basvandorst/cryptography-archive/brown-steg-stools-2/README.TXT

Extracting the S-Tools archive
------------------------------
S-Tools version 2.00 is supplied in the archive file S-TOOLS.ZIP. The file
S-TOOLS.SIG is a PGP signature of this file that you can use to check its
integrity if you so wish. To do this requires my public key which you can
get by either contacting me personally or fingering <asb@cs.nott.ac.uk>

As an added bonus, creating an uncompressed zip and then compressing it as
one file allows PKZIP to take advantage of redundancies in all the archive
files and hence you get a smaller overall distribution zip size.

Everyone wins :-)

Regards,

+---------------------------+----------------------------------------------+
| Andy <asb@cs.nott.ac.uk>  | PGP key fingerprint: EC 80 9C 96 54 63 CC 97 |
|    finger for PGP key     |                    : FF 7D C5 69 0B 55 23 63 |
+---------------------------+----------------------------------------------+
