basvandorst/cryptography-archive/escrow3/readme.txt

The TIS Software Key Esrow paper is distributed as a set of postscript
files.  The text of the paper is distribited as escrow?.ps.  The figures,
fig*.xi, are distributed as separate (xidraw) postscript files.

Contact ske@tis.com if you hae any trouble printing the text or figures.

Thanks.
