basvandorst/cryptography-archive/ipexamp/readme

This file, ipexamp.zip, contains three simple programs
to demonstrate socket programming:

-- telnntp, a simple "telnet"-like program which communicates
with a remote program via TCP.

-- readsock and sendsock, two simple programs which communicate
via UDP packets.

Mark Riordan  29 Dec 1993
