basvandorst/cryptography-archive/big_brother_inside_picts_info/big_brother_inside_picts_info.txt

From: Matt Thomlinson <phantom@u.washington.edu>
Date: Tue, 15 Feb 1994 17:20:14 -0800 (PST)

big_brother_inside_sticker.ps is a generic postscript file, created in
CorelDraw. The postscript image lies landscape on the page, and consists
of the intel-logo's ``swoosh'' and crayon-like lettering on the inside.

This design was originally created for the sticker project: the image was
screened onto transparent stickers 1" square for the purpose of applying
them to future clipper-chip products. (cdodhner@indirect.com was in charge
of that project; as far as I know he's still distributing them for a small
donation to cover printing & mailing costs).
