basvandorst/cryptography-archive/misc/wired-clipper-index.txt

From infobot-owner@wired.com Mon Feb 21 20:31:58 1994
Received: from gw.wired.com by scss3.cl.msu.edu (4.1/4.7)  id AA27175; Mon, 21 Feb 94 20:31:51 EST
Received: by gw.wired.com (5.67/wps.com-hackery)
	id AA23629; Mon, 21 Feb 94 17:31:50 -0800
Date: Mon, 21 Feb 94 17:31:50 -0800
Message-Id: <9402220131.AA23629@wired.com>
To: mrr@scss3.cl.msu.edu
From: infobot@wired.com
Subject: Majordomo file: file 'clipper.index'
Reply-To: infobot@wired.com
Status: OR

--

-=-=-=-=-=-=-=-=-=-=-=-=-=-=-=-=-=-=-=-=-=-=-=-=-=-=-=-=-=-=-=-=-=-=-=-=-=-
=-=-=-=-=-=-Copyright 1993,4 Wired USA Ltd.  All Rights Reserved=-=-=-=-=-=
-=-=For complete copyright information, please see the end of this file=-=-
=-=-=-=-=-=-=-=-=-=-=-=-=-=-=-=-=-=-=-=-=-=-=-=-=-=-=-=-=-=-=-=-=-=-=-=-=-=

WIRED Online
Clipper Archive
***************

Filename          Description                             Contributor
^^^^^^^^          ^^^^^^^^^^^                             ^^^^^^^^^^^
wired.letter       Letter from WIRED Online to the public 
                   regarding the Clipper debate

                  WIRED Exclusive Essays
                  =-=-=-=-=-=-=-=-=-=-=-
privacy.barlow     Jackboots on the Infobahn              John Perry Barlow

privacy.meeks      The End of Privacy                     Brock N. Meeks

                  Dispatches from the CyberFront           
                  =-=-=-=-=-=-=-=-=-=-=-=-=-=-=-
dispatch.1         Jacking in from a Non-Government       Brock N. Meeks
                   Approved Encryption Port

dispatch.2         Jacking in from the Congressional      Brock N. Meeks
                   Port

dispatch.3         Jacking in from the Financial Port     Brock N. Meeks

                  WIRED Featured Responses
                  =-=-=-=-=-=-=-=-=-=-=-=-
eff.letter         Letter of concern from the Executive 
                   Director of the Electronic Frontier 
                   Foundation (EFF), Monday, February 
                   7th, 1994

effector_7.2       EFFector 7.2 - The official EFF 
                   newsletter

clipper.petition   Anti-Clipper petition being            Mark Banisar
                   coordinated by Computer Professionals 
                   for Social Responsibility (CPSR) 

denning            Pro-Clipper response to the CPSR       Dorothy Denning
                   anti-Clipper petition     

                                   * * *

=-=-=-=-=-=-=-=-=-=-=-=WIRED Online Copyright Notice=-=-=-=-=-=-=-=-=-=-=-=

           Copyright 1993,4 Wired USA Ltd.  All rights reserved.

  This article may be redistributed provided that the article and this 
  notice remain intact. This article may not under any circumstances
  be resold or redistributed for compensation of any kind without prior 
  written permission from Wired Ventures, Ltd.

  If you have any questions about these terms, or would like information
  about licensing materials from WIRED Online, please contact us via
  telephone (+1 (415) 904 0660) or email (info@wired.com).

       WIRED and WIRED Online are trademarks of Wired Ventures, Ltd.

=-=-=-=-=-=-=-=-=-=-=-=-=-=-=-=-=-=-=-=-=-=-=-=-=-=-=-=-=-=-=-=-=-=-=-=-=-=
