basvandorst/cryptography-archive/pi26b/RMINFO.TXT

12/18/95
$remailer{"extropia"} = "<remail@extropia.wimsey.com> cpunk pgp special";
$remailer{"portal"} = "<hfinney@shell.portal.com> cpunk pgp hash";
$remailer{"alumni"} = "<hal@alumni.caltech.edu> cpunk pgp hash";
$remailer{"bsu-cs"} = "<nowhere@bsu-cs.bsu.edu> cpunk hash ksub";
$remailer{"c2"} = "<remail@c2.org> eric pgp hash reord";
$remailer{"penet"} = "<anon@anon.penet.fi> penet post";
$remailer{"ideath"} = "<remailer@ideath.goldenbear.com> cpunk hash ksub reord";
$remailer{"hacktic"} = "<remailer@utopia.hacktic.nl> cpunk mix pgp hash latent cut post ek";
$remailer{"flame"} = "<remailer@flame.alias.net> cpunk mix pgp. hash latent cut post ek reord";
$remailer{"rahul"} = "<homer@rahul.net> cpunk pgp hash filter";
$remailer{"mix"} = "<mixmaster@remail.obscura.com> cpunk mix pgp hash latent cut ek ksub reord ?";
$remailer{"syrinx"} = "<syrinx@c2.org> cpunk pgp hash cut reord mix post";
$remailer{"ford"} = "<remailer@bi-node.zerberus.de> cpunk pgp hash ksub";
$remailer{"hroller"} = "<hroller@c2.org> cpunk pgp hash latent ek";
$remailer{"vishnu"} = "<mixmaster@vishnu.alias.net> cpunk mix pgp. hash latent cut ek ksub reord";
$remailer{"robo"} = "<robo@c2.org> cpunk hash mix";
$remailer{"replay"} = "<remailer@replay.com> cpunk mix pgp hash latent cut post ek";
$remailer{"spook"} = "<remailer@valhalla.phoenix.net> cpunk mix pgp hash latent cut ek reord";
$remailer{"rmadillo"} = "<remailer@armadillo.com> mix cpunk pgp hash latent cut";
$remailer{"ecafe"} = "<cpunk@remail.ecafe.org> cpunk mix";
$remailer{"wmono"} = "<wmono@valhalla.phoenix.net> cpunk mix pgp. hash latent cut ek";
$remailer{"shinobi"} = "<remailer@shinobi.alias.net> cpunk mix hash latent cut ek reorder";
$remailer{"amnesia"} = "<amnesia@chardos.connix.com> cpunk mix pgp hash latent cut ek ksub";
$remailer{"gondolin"} = "<mix@remail.gondolin.org> cpunk mix pgp hash latent cut ek reord";
$remailer{'alpha'} = '<alias@alpha.c2.org> alpha pgp';
$remailer{'gondonym'} = '<alias@nym.gondolin.org> alpha pgp';
