basvandorst/cryptography-archive/pidaho21/RMINFO.TXT

5/22/95
$remailer{"vox"} = "<remail@vox.xs4all.nl> cpunk pgp. post";
$remailer{"avox"} = "<anon@vox.hacktic.nl> cpunk pgp post";
$remailer{"extropia"} = "<remail@extropia.wimsey.com> cpunk pgp special";
$remailer{"portal"} = "<hfinney@shell.portal.com> cpunk pgp hash";
$remailer{"alumni"} = "<hal@alumni.caltech.edu> cpunk pgp hash";
$remailer{"bsu-cs"} = "<nowhere@bsu-cs.bsu.edu> cpunk hash ksub";
$remailer{"rebma"} = "<remailer@rebma.mn.org> cpunk pgp. hash";
$remailer{"c2"} = "<remail@c2.org> eric pgp hash reord";
$remailer{"soda"} = "<remailer@csua.berkeley.edu> eric post reord";
$remailer{"penet"} = "<anon@anon.penet.fi> penet post";
$remailer{"ideath"} = "<remailer@ideath.goldenbear.com> cpunk hash ksub reord";
$remailer{"usura"} = "<usura@replay.com> cpunk pgp. hash latent cut post";
$remailer{"xs4all"} = "<remailer@xs4all.nl> cpunk pgp hash latent cut post ek";
$remailer{"rahul"} = "<homer@rahul.net> cpunk pgp hash filter";
$remailer{"mix"} = "<mixmaster@obscura.com> cpunk mix pgp hash latent cut ek ksub reord";
$remailer{"syrinx"} = "<syrinx@c2.org> cpunk pgp reord mix";
$remailer{"tower"} = "<remailer@tower.techwood.org> cpunk pgp post";
$remailer{"hroller"} = "<hroller@c2.org> cpunk hash reord mix";
$remailer{"kether"} = "<remailer@kether.alias.net> cpunk pgp hash latent cut ek";
$remailer{"vishnu"} = "<mixmaster@vishnu.alias.net> cpunk mix pgp hash latent cut ek ksub reord";
$remailer{"crown"} = "<mixmaster@kether.alias.net> cpunk pgp hash latent cut mix ek";
$remailer{"robo"} = "<robo@c2.org> cpunk pgp hash mix";
