basvandorst/cryptography-archive/sfs11tex/sfs1.tex

\documentstyle[a4]{article}

\begin{document}

\begin{titlepage}
\begin{center}

\vspace*{5cm}

\newfont{\HUGE}{cmr17 scaled 2074}

{\HUGE S F S}
\vspace*{2cm}

{\Large                  Secure FileSystem}

\vspace*{1cm} {\large      Version 1.10}
\vspace*{4cm}

                     \copyright{} Peter C. Gutmann  1993, 1994

\vspace*{4cm}
{\small \LaTeX-version by Peter Conrad}

\end{center}
\end{titlepage}

\parindent 0pt
\parskip 2mm

{\large      ``The right to privacy \dots\/ is the most comprehensive of rights and the
       right most valued by civilized man''

      \begin{flushright} -- Justice Louis Brandeis, US Supreme Court, 1928
      \end{flushright}}

\pagebreak

\tableofcontents

\section{Introduction}

Ever since Julius Caesar used the cipher which now bears his name to try to
hide his military dispatches from prying eyes, people have been working on
various means to keep their confidential information private.  Over the years,
the art of cryptography (that is, of scrambling information so only those in
possession of the correct password can unscramble it) has progressed from
simple pencil-and-paper systems to more sophisticated schemes involving complex
electromechanical devices and eventually computers.  The means of breaking
these schemes has progressed on a similar level.  Today, with the
ever-increasing amount of information stored on computers, good cryptography is
needed more than ever before.

There are two main areas in which privacy protection of data is required:

\begin{itemize}
  \item Protection of bulk data stored on disk or tape.
  \item Protection of messages sent to others.
\end{itemize}

SFS is intended to solve the problem of protecting bulk data stored on disk.
The protection of electronic messages is best solved by software packages such
as PGP (available on sites the world over) or various implementations of PEM
(currently available mainly in the US, although non-US versions are beginning
to appear).

SFS has the following features:

\begin{itemize}

\item The current implementation runs as a standard DOS device driver, and
    therefore works with both plain MSDOS or DRDOS as well as other
    software such as Windows, QEMM, Share, disk cacheing software, Stacker,
    JAM, and so on.

\item Up to five encrypted volumes can be accessed at any one time, chosen 
    from a selection of as many volumes as there is storage for.

\item Volumes can be quickly unmounted with a user-defined hotkey, or
    automatically unmounted after a certain amount of time.  They can also be
    converted back to unencrypted volumes or have their contents destroyed if
    required.

\item The software contains various stealth features to minimise the
    possibility of other programs monitoring or altering its operation.

\item The encryption algorithms used have been selected to be free from any
    patent restrictions, and the software itself is not covered by US export
    restrictions as it was developed entirely outside the US (although once a
    copy is sent into the US it can't be re-exported).

\item SFS complies with a number of national and international data
    encryption standards, among them ANSI X3.106, ANSI X9.30 Part 2,
    Federal Information Processing Standard (FIPS) 180, Australian
    Standard 2805.5.2, ISO 10116:1991 and ISO 10126-2:1991, and is on
    nodding terms with a several other relevant standards.

\item The documentation includes fairly in-depth analyses of various security
    aspects of the software, as well as complete design and programming details
    necessary to both create SFS-compatible software and to verify the
    algorithms used in SFS.

\item The encryption system provides reasonable performance.  One tester has
    reported a throughput of 250 K/s for the basic version of SFS, and 260 K/s
    for the 486+ version on his 486 system, when copying a file with the DOS
    copy command from one location on an SFS volume to another.  Throughput on
    a vanilla 386 system was reported at around 160 K/s.

\item Direct access to IDE and SCSI drives is available for better
    performance and for drives which aren't normally accessible to DOS (for
    example systems with more than 2 hard drives).

\end{itemize}

Although the use of DOS is described throughout this document, SFS is not
limited to any particular operating environment, and can be used to contain
virtually any type of filesystem.  In the future an SFS driver for OS/2 HPFS
filesystems may be developed, and there have been discussions on creating a
Linux SFS driver for Unix machines.  A 68000 version of SFS is also reported to
be under development.

\section{Overview}

This document is organised to give step-by-step instructions on setting up the
SFS driver, creating an encrypted volume, and using the encrypted volume to
store information securely.  The first three sections cover each of these
steps, with a special quick-start section preceding them giving a rapid
introduction to getting an encrypted disk volume up and running.  The next
sections provide extra details on topics such as password management,
incompatibility problems, other encryption software, and the politics of
cryptography and privacy.  The final sections provide an in-depth security
analysis, technical information on the SFS driver, and data formats for those
wishing to write SFS-compatible software or wanting to check the security of
the software for themselves.

The document is divided into sections as follows:

\begin{itemize}

\item Why Use SFS?

        Some reasons why use of security measures like SFS may be
        necessary for your data.

\item Terminology

        An explanation of some of the technical terms use in this
        document.  Experienced users can skip this section.

\item Quick Start

        A quick overview of the use of SFS which summarizes the
        next three sections for people in a hurry

\item Loading the SFS Driver

        How to set up the SFS driver needed to handle encrypted
        volumes.

\item Creating an SFS Volume

        How to prepare an SFS encrypted volume for use.

\item Mounting an SFS Volume

        How to mount a previously prepared SFS encrypted volume
        so the operating system can use it.

\item Advanced SFS Driver Options

        Various advanced options such as how to mount SFS volumes
        at system startup so that they are automatically available when
        the system is booted, and customizing the SFS driver operation
        and user interface.

\item Changing the Characteristics of an SFS Volume

        How to change various characteristics of an SFS volume such
        as the password, volume name, disk access method, and 
        auto-unmount timeout, and how to delete SFS volumes or convert 
        them back to normal DOS volumes.

\item Sharing SFS Volumes Between Multiple Users

        How to securely share a single encrypted SFS volume between
        multiple users.

\item Creating Compressed SFS Volumes

        How to create a compressed drive inside a normal SFS volume

\item WinSFS - Using SFS with Windows

        An overview of the Windows version of SFS.

\item Command Summary

        A summary of the commands available with the various SFS
        programs.

\item Incompatibilities

        Comments on unusual hardware and software combinations which
        may create problems for SFS.

\item Authentication of SFS Software

        How to verify that the SFS distribution you have is indeed the
        real thing.

\item Applications

        Various applications and uses for SFS.

\item The Care and Feeding of Passwords

        Details on how to chose and handle a password to protect
        an SFS volume.

\item Other Software

        An overview of other available security software and the
        weakness and problems present in it.

\item Data Security

        Various issues in data security which should be taken into
        consideration when using SFS and similar encryption software.

\item Politics

        A discussion on the politics of cryptography, the right to
        privacy, and some of the reasons why SFS was written.

\item An Introduction to Encryption Systems

        A brief introduction to encryption systems with an emphasis
        on the methods used in SFS.

\item Security Analysis

        An analysis of the level of security offered by SFS and
        some possible attacks on it.

\item Design Details

        Various in-depth design details not covered in the security
        analysis.

\item SFS Disk Volume Layout

        Details on the disk layout used by SFS.

\item Interfacing with SFS

        How to control the SFS driver through software.

\item Interfacing with mountsfs

        How to control the mountsfs program from external software such
        as graphical front-ends.

\item Selected Source Code

        A walkthrough of selected portions of the source code to allow
        verification and help implementors.

\item Future Work

        Various enhancements which may be incorporated into future
        versions of SFS.

\item Recommended Reading

        A short list of recommended reading material for those wishing
        to know more about the design of SFS and encryption in general.

\item Using SFS

        Conditions and terms for use of SFS.

\item Credits
\item Warranty

\end{itemize}

\section{Why Use SFS?}
Virtually all information stored on computer systems is sensitive to some
degree, and therefore worth protecting.  Exactly how sensitive a piece of data
is is unique to each environment.  In some cases the data may be much more
sensitive to errors or omissions, or to unavailability, or to fraudulent
manipulation, than to the problems SFS is designed to guard against.  SFS helps
guard against data being disclosed to the wrong people or organisations, and
against some types of fraudulent manipulation.  By making the data being
protected accessible only to those with authorized access, SFS helps protect
the confidentiality of the information, and the privacy of the individuals the
information pertains to.  Preventing access by unauthorized users also helps to
protect the integrity of the data\footnote{
%Footnote [1]: 
		Although inadvertent modification by authorized users is still
              	possible, the risk from deliberate compromise of the data is
              	greatly reduced.
}.

One way to determine whether the data is sensitive enough to require the use of
SFS is to consider the following:

\begin{itemize}
\item  What are the consequences of the data being made available to the wrong
  people or organisations?

\item  What are the consequences of the data being manipulated for fraudulent
  purposes?
\end{itemize}

An additional impetus for security comes from the legal requirement of many
countries for individuals and organisations to maintain the confidentiality of
the information they handle, or to control their assets (such as computer data)
properly.  For example, one of the ``OECD guidelines governing the protection of
privacy and transborder flows of computer data'' states that data should be
protected against ``loss or unauthorized access, destruction, use, modification,
or disclosure''\footnote{
%Footnote [2]: 
		These guidelines are discussed in more detail in ``Computer
              	Networks'', Volume 5, No.2 (April 1981).               
}.  An example of the requirements for the control of assets is
the US Foreign Corrupt Practices Act of 1977.

In summary, if the cost of damage or disclosure of the data is more than the
cost of using a security measure such as SFS (where cost is measured not only
in monetary terms but also in terms of damage to business and loss of privacy)
then the data should be regarded as being sensitive and should have adequate
security controls to prevent or lessen the potential loss.

%Footnote [1]: Although inadvertent modification by authorized users is still
%              possible, the risk from deliberate compromise of the data is
%              greatly reduced.

%Footnote [2]: These guidelines are discussed in more detail in "Computer
%              Networks", Volume 5, No.2 (April 1981).               

\section{Terminology}

Throughout this document a number of specialised terms are used to describe the
operation of the SFS encryption software.  This section provides a brief
explanation of the terms used.  Experienced users can skip this material and go
directly to the ``Loading the SFS Driver'' section below.

\begin{description}

\item[Disk volume]

    An individual logical disk drive, volume, partition, or filesystem.  A
    single physical hard disk can (and usually does) contain more than one
    volume on it.  Under DOS, each of these volumes is assigned its own drive
    letter and appears as a separate drive, even though they all reside on the
    same physical hard disk.  Thus a system might have a single 128MB hard disk
    which contains four 32MB volumes accessed by the drive letters C:, D:, E:,
    and F:.

    This system is rather confusing and dates back fifteen to twenty years. SFS
    refers to these volumes by name rather than an arbitrary letter, so that
    the volumes might be called ``Encrypted data'', ``Personal correspondence'', or
    ``Accounts receivable, March 1993''.  Unfortunately once SFS has set up the
    volume for DOS to access, it's back to the old F: to identify your data.

\item[Password, key]

    The password or encryption key is used to protect the data on an encrypted
    volume.  Despite its name, a password can (and should) be more than just a
    single word.  The SFS software will accept up to 100 characters of
    password, so that perhaps the term ``passphrase'' would be more appropriate.

    For maximum security, each volume should be protected by its own unique
    password.  The SFS software takes the password for a volume, adds extra
    keying information to it, and converts the result into an encryption key
    which is used to encrypt and decrypt data on a given volume.  Great care
    should be taken in the choice of passwords and in keeping them secret. More
    details on this are given in the section ``The Care and Feeding of
    Passwords'' below.

\item[Device driver]

    A device driver is a special piece of software which is used by the
    operating system to access hardware which it wasn't designed to.  Unless
    the device driver is loaded, the operating system generally won't recognise
    that a piece of hardware even exists.  Even the computer's monitor,
    keyboard, and disk drives are accessed through device drivers, although
    their presence is hidden by the operating system.

    An example of a visible device driver is the one used to handle a mouse.
    Networked disk drives may be accessed through a device driver\footnote{
%Footnote [1]: 
		Actually they use a specialised kind of driver called a network
              	redirector.
    }.  RAM disks
    are implemented as device drivers.  CDROM drives are handled via a device
    driver.  Finally, encrypted SFS volumes are accessed through a device
    driver.

\item[Mount point]

    The locations provided by the SFS driver for mounting encrypted volumes---in
    other words the number of encrypted volumes which can be accessed by the
    driver at any one time.  By default the driver provides one mount point,
    which means one encrypted volume can be accessed through it at any given
    time.  The exact number of mount points can be specified when the SFS
    driver is loaded.

\end{description}

\section{Quick Start}

This section contains a condensed version of the next three sections and allows
a quick start for SFS.  Although it is recommended that the full text be read,
it should be possible to install and use a minimal SFS setup using only the
quick-start information.

Initially, the SFS driver must be loaded by adding an entry for it to the
CONFIG.SYS file.  For example if the SFS.SYS driver was located in the DOS
directory on drive C: the following line should be added to the CONFIG.SYS
file:

{\tt \verb|  |DEVICE=C:$\backslash$DOS$\backslash$SFS.SYS}

Alternatively, the DEVICEHIGH option can be used to load the driver into high
memory under those versions of DOS which support it.  The system should now be
rebooted to make sure the driver is installed.

The use of the SFS driver is covered in more detail in the sections ``Loading
the SFS Driver'' and ``Advanced SFS Driver Options'' below.

The encrypted volume can be created with the {\tt mksfs}
program.  This is run with the letter of the drive to encrypt, and the name of
the encrypted volume preceded by the {\tt vol=} option as arguments.  For 
example to encrypt the
E: drive to create a volume with the name ``Encrypted disk'', the command would
be:

{\tt \verb|  |mksfs "vol=Encrypted volume" e:}

Note that that {\tt "vol=\dots"} option is quoted, as the volume name contains a space.
Volume names without a space don't need to be quoted.

mksfs will confirm that the given drive is indeed the one to be encrypted, and
then ask for an encryption password of between 10 and 100 characters.  After
asking for the password a second time to confirm it, it will encrypt the drive.
This will take a few minutes, and the program will display a progress bar as
the encryption takes place.

There are a great many options and special safety checks built into mksfs to
ensure no data is accidentally destroyed, and it is recommended that the
section ``Creating an SFS Volume'' be at least glanced through to provide an
overview of the functioning of mksfs before it is run.

Once the encrypted volume has been created and the SFS driver loaded, it can be 
mounted with the {\tt mountsfs} utility.  Mounting a volume makes it available 
to DOS as a normal
disk volume, with all encryption being done transparently by the SFS driver.
Like mksfs, mountsfs must be told the encrypted volume's name in order to
access it.  The full name doesn't need to be used, mountsfs will accept any
part of the name in upper or lower case.  Using the name from the previous
example, the command to mount the volume would be:

{\tt \verb|  |mountsfs vol=encrypt}

mountsfs will match the partial name ``encrypt'' with the full volume name
``Encrypted volume'', ask for the encryption password for the volume, and mount
it.  The volume will now be accessible as a normal DOS drive.

More details on the use of mountsfs are contained in the section ``Mounting an
SFS Volume'' below.  Other methods for mounting volumes are given in the section
``Advanced SFS Driver Options'' below.

\section{Loading the SFS Driver}

The SFS device driver {\tt SFS.SYS} or {\tt SFS486.SYS} can be loaded in the usual manner
by specifying it in the CONFIG.SYS file:

{\tt
\verb|  |DEVICE=[$drive$:][$path$]SFS.SYS [SILENT] [UNITS=$n$] [NOXMS]\\
\verb|                              |[PROMPT=$xxx$] [READONLY] [READWRITE]\\
\verb|                              |[FIXED] [REMOVABLE] [ECHO] [FAST=$n$]\\
\verb|                              |[HOTKEY=$xxx$] [TIMEOUT=$nn$] [MOUNT=$nnn$]}

It can also be loaded high under those versions of DOS which support this with:

{\tt
\verb|  |DEVICEHIGH=[$drive$:][$path$]SFS.SYS [SILENT] [UNITS=$n$] [NOXMS]\\
\verb|                                  |[PROMPT=$xxx$] [READONLY]\\
\verb|                                  |[READWRITE] [FIXED] [REMOVABLE]\\
\verb|                                  |[ECHO] [FAST=$n$] [HOTKEY=$xxx$]\\
\verb|                                  |[TIMEOUT=$nn$] [MOUNT=$nnn$]}

The SFS486.SYS driver is loaded the same way.  This driver contains code for
'486 and higher processors, and is slightly smaller and a few percent faster
than the equivalent '386 version.

The arguments to SFS are not case-sensitive, and can be given in upper or lower
case.  They may also be optionally preceded by a `/' for compatibilty with
older types of software.  For example if your copy of the SFS.SYS driver was 
located in the DOS directory on drive C: you would add the following line to 
your CONFIG.SYS file:

{\tt \verb|  |DEVICE=C:$\backslash$DOS$\backslash$SFS.SYS}

The driver will only work on systems with an 80386 or higher processor.  This
is because the en/decryption code (over 10,000 lines of assembly language) has
to have a 32-bit processor to run on.  Virtually all recent PC's fulfil these
requirements, and a 16-bit version would both be much slower and require about
three times as much code space to run in\footnote{
%Footnote [1]:
              There have been calls for 286 versions of SFS from countries in
              which 386+ machines are still difficult to obtain.  There may
              eventually be a 16-bit version, although at the current rate by
              the time it's written everyone will be using Pentiums anyway.
}.

If an attempt is made to load SFS.SYS on a machine which doesn't have a 32-bit
CPU, the message:

{\tt \verb|  |Error: Processor must be 386 or higher}

will be displayed and SFS will de-install itself.

The drive currently recognises thirteen options, {\tt ECHO}, {\tt FAST}, {\tt FIXED}, {\tt HOTKEY},
{\tt MOUNT}, {\tt NOXMS}, {\tt PROMPT}, {\tt READONLY}, {\tt READWRITE}, {\tt REMOVABLE}, {\tt SILENT}, {\tt TIMEOUT}, and 
{\tt UNITS}:

\begin{itemize}

\item The {\tt ECHO} option is used in conjunction with the {\tt MOUNT} option to echo the
  password to the screen when asking for the password for the SFS volume to be
  mounted, and is explained in more detail in the section ``Advanced SFS
  Driver Options'' below.

\item The {\tt FAST} option is used in conjunction with the {\tt MOUNT} option to enable
  various high-speed direct disk access modes in the SFS driver.  These can
  significantly affect the overall performance of the driver, and are discussed
  in more detail in the section ``Advanced SFS Driver Options'' below.

\item The {\tt FIXED} option is used in conjunction with the {\tt MOUNT} option to indicate
   that a volume mounted at system startup is to be kept mounted until the
   system is turned off or reset, as opposed to the normal behaviour of allowing
   it to be unmounted at any point.  This is discussed in more detail in the
   section ``Advanced SFS Driver Options'' below.

\item The {\tt HOTKEY} option is used to specify the quick-unmount hotkey which can be
  used to instantly unmount all currently mounted SFS volumes, and is explained
  in more detail in the sections ``Mounting an SFS Volume'' and ``Advanced SFS
  Driver Options'' below.

\item The {\tt MOUNT} option is used to mount SFS volumes at system startup, and is
  explained in more detail in the section ``Advanced SFS Driver Options'' below.
  The older {\tt AUTOMOUNT} form of this command is still supported by this version
  of SFS, but will be discontinued in future versions.

\item The {\tt NOXMS} option is used to disable SFS buffering data in extended memory.
  By default SFS will allocate a 64K write buffer to speed up disk writes.  If
  no extended memory is available or if the {\tt NOXMS} option is used, SFS will
  print:

  {\tt \verb|  |Warning: No XMS buffers available, slow writes will be used}

  The driver will then switch to using slow disk writes which are about half as
  fast as normal reads and writes.  These are necessary to fix buffering
  problems in MSDOS 6.x and some disk utilities.  If an extended memory buffer
  is used, the slow writes aren't necessary.

\item The {\tt PROMPT} option is used in conjunction with the {\tt MOUNT} option to display a
  user-defined prompt when asking for the password for the SFS volume to be 
  mounted, and is explained in more detail in the section ``Advanced SFS Driver
  Options'' below.

\item The {\tt READONLY} and {\tt READWRITE} options are used in conjunction with the {\tt MOUNT}
  option to disable write access to the volumes being mounted. The {\tt READONLY}
  option disables write access to all following mounted volumes; the {\tt READWRITE}
  option enables write access to all following mounted volumes.  The default
  setting is to allow read and write access to all volumes.
  More details on read-only access to SFS volumes is given in the section ``Mounting an SFS
  Volume'' below.

\item The {\tt REMOVABLE} option is used to undo the effects of the {\tt FIXED} option which is
  explained above.

\item The {\tt SILENT} option can be used to suppress the printing of the start-up
  message.

\item The {\tt TIMEOUT} option is used to specify the time in minutes after which SFS
  volumes are automatically unmounted if they haven't been accessed during that
  time, and is explained in more detail in the sections ``Mounting an SFS
  Volume'' and ``Advanced SFS Driver Options'' below.

\item The {\tt UNITS=$n$} option specifies the number of mount points (or number of disk
  volumes) the driver will provide, where $n$ is the number of units and can
  range from 1 to 5.  Each drive mount point requires 384 bytes of extra memory
  storage.  By default, the driver allocates storage for one mount point.

\end{itemize}

As an example, to suppress the printing of the start-up message and to specify
that the driver should handle up to three encrypted volumes, the previously
given example for loading the driver would be changed to:

{\tt \verb|  |DEVICE=C:$\backslash$DOS$\backslash$SFS.SYS SILENT UNITS=3}

The number of mount points can range from 1 to 5.  If a number outside this
range is specified, the message:

{\tt \verb|  |Error: Invalid number of units specified}

will be displayed and SFS will de-install itself.  Finally, if an invalid
option is given (such as a misspelled or badly-formatted parameter) SFS will
again de-install itself after displaying:

{\tt \verb|  |Error: Unknown parameter specified}

All the remaining driver options are covered in the section ``Advanced SFS
Driver Options'' below.

If the driver installs successfully and unless the {\tt SILENT} option is used it
will, after displaying a general message showing that it has been installed,
indicate which drive will be used as the encrypted one.  For example if
the encrypted drive is made available as E:, the message would be:

{\tt \verb|  |Encrypted volume will be mounted as drive E:}

This indicates that once an encrypted volume is mounted, DOS will access it as
drive E:  If more than one mount point is specified, the range of drives which
will be made available is shown, so that if the option {\tt UNITS=3} were used the
message would be:

{\tt \verb|  |Encrypted volumes will be mounted as drives E: - G:}

When installed SFS consumes around 7.5K of memory, most of which is encryption
code.

%Footnote [1]: There have been calls for 286 versions of SFS from countries in
%              which 386+ machines are still difficult to obtain.  There may
%              eventually be a 16-bit version, although at the current rate by
%              the time it's written everyone will be using Pentiums anyway.

\section{Creating an SFS Volume}

Before SFS can use an encrypted volume, it must be converted from a normal DOS
volume to an encrypted SFS one.  The program which performs this task is mksfs,
(Make Secure Filesystem) and is very loosely patterned after the Unix mkfs
utility.  mksfs takes a standard DOS volume (which may be either freshly
formatted or may already contain files) and turns in into an encrypted SFS
volume.  The encryption process is non-destructive, so in general no data will
be lost.  The only case in which a data loss could occur is if there is a power
cut while the volume is being encrypted (this means that power to the system is
removed as the disk is being written to, which would cause problems under
virtually any software).  If the data being encrypted is extremely valuable or
there is a risk of a power cut occurring, the volume should be backed up
completely before being encrypted.  This should only be necessary in
exceptional circumstances.

If used on a fixed disk, mksfs will encrypt an entire disk partition rather
than individual files.  This is necessary because an SFS partition may contain
a DOS filesystem, or an OS/2 one, or a HPFS one, or an NTFS one, or any one of
a dozen other possible filesystems.  However, many people have only a single
large partition on their hard drive which is used entirely for DOS, which would
require a complete backup of the partition before the FDISK utility can be used
to create two smaller partitions, followed by a restore of the backup to one of
the new partitions.  This problem can be avoided by using one of several
programs which will nondestructively split an existing partition into two 
smaller partitions, one of which can be used as an SFS volume\footnote{
%Footnote [1]: 
		One of these is FIPS, currently at version 1.1 and available as
             	fips11.zip from either sunsite.unc.edu in the directory
              	/pub/Linux/system/Install, tsx-11.mit.edu in the directory
              	/pub/linux/dos\_utils, garbo.uwasa.fi and all mirror sites in the
                directory /pc/diskutil, or oak.oakland.edu and all mirror sites
                in the directory simtel/msdos/diskutil.
}.

If the hardware or software setup you are using is somewhat unusual (for
example you have drives which are compressed with DoubleSpace, Stacker, or JAM,
or you have unusual drive hardware which needs special software like SpeedStor 
to manage it), you should read the section ``Incompatibilities'' below.  In
addition, mksfs may, during normal operation, trigger a number of virus
detectors which monitor access to certain critical disk and memory areas which
software would not normally access.  Finally, mksfs will check whether it is
being run under Quarterdeck's DesqView or Microsoft Windows, as it should in
general not be run while DesqView, Windows, or some other multitasking software
is running.  Since mksfs takes an entire disk volume and encrypts it sector by
sector, any other software which tries to simultaneously access the volume
while mksfs is running will come to grief.  If mksfs detects that it is being
run under either DesqView or Windows, it will display a warning message with an
option to quit and re-run it from DOS only.  Only if there is no chance that
any other program will access the disk volume being encrypted is it safe to run
mksfs under multitasking software.

The mksfs program is run in the following manner:

{\tt \verb|  |mksfs [-c] [-o] [-t] [-e] [serial={\em serial number}] [multiuser]\\
\verb|        |[fastaccess={\em mode}] [timeout={\em timeout}] [wipe]\\
\verb|        |[vol={\em volume name}] $drive$}

Since all arguments are named, they can be given in any order.  The order shown
here is merely an example.

The {\tt -c} and {\tt -t} options are present to allow integrity checks on the SFS
encryption code and the operation of mksfs itself, and are covered in more
detail in the sections ``Incompatibilities'' and ``Security Analysis''
respectively.

The $drive$ specifies the DOS drive letter for which the SFS volume will be
created.  For example to create an SFS volume on the disk currently in the A:
drive the command would be:

{\tt \verb|  |mksfs a:}

It is recommended that each SFS volume be given a unique name for
identification purposes.  Although it is possible to create an unnamed (or
anonymous) volume, this practice is strongly discouraged for fixed disks which
may contain multiple SFS volumes.  If the volumes are anonymous then the user
has no easy way of informing SFS which one it should be accessing apart from
using the mount option with the SFS driver, which is explained in more detail 
in the section ``Advanced SFS Driver Options'' below.  mksfs will check for the 
creation of anonymous volumes on fixed disks and display a warning if this 
occurs.

The volume name can be specified with the {\tt vol=} option.  For example if the
volume name ``Secure disk volume'' was to be created on drive D: then the 
command would be:

{\tt \verb|  |mksfs "vol=Secure disk volume" d:}

Note that the volume name, which in this case contains spaces, has been quoted.
This is necessary since DOS will break apart the name into separate words if it
contains spaces.  If the name is a single word, no quoting is necessary.

The volume serial number can be specified with the {\tt serial=} option.  If no
serial number is provided, mksfs will generate one itself.  In normal usage
there is no need for the user to specify a volume serial number, but the option
has been provided in case it is needed.  If a serial number is specified, it 
should be a unique value since SFS may use it to distinguish between different 
volumes. If mksfs is left to chose the serial number it will automagically use 
a unique value.  The serial number is independant of the volume mount 
identifier, which is explained in the section ``Advanced SFS Driver Options'' 
below.  This serial number is not the same as the serial number which some
operating systems may write to a disk for their own use, and is used only by
SFS to identify volumes.

A special option for removable disks only is the {\tt -o} option.  This is
necessary because some (mostly extinct) variants of DOS treat removable disks
in a peculiar manner.  If mksfs cannot determine the disk format due to the
disk having been created with a strange DOS version, it will exit with the
error message\footnote{
%Footnote [2]:
              Certain boot sector viruses also change the information needed by
              mksfs, so mksfs printing this message may be an indication of a
              viral infection.
}:

{\small
\begin{verbatim}
  Error: Disk information reports unusual disk format, won't process disk.
         Use `-o' option to override this check.
\end{verbatim}}

If mksfs is re-run, this time with the {\tt -o} option, it will perform a check on
secondary format information stored on the disk.  If the information checks
out, it will report (assuming the disk being checked is a 1.2 MB 5 1/4'' disk):

{\small
\begin{verbatim}
  Warning: Disk information reports unusual disk format, performing check on
           secondary information...

           Disk appears to be in 1.2 MB DSHD format
\end{verbatim}}

If mksfs still can't be sure of the disk format, it will exit with an error
message.  Otherwise it will ask:

\begin{verbatim}
  Are you sure you want to process the disk in this format [y/n]
\end{verbatim}

If the given disk format is correct then a response of `Y' will continue, while
a response of `N' will exit the program.

If multiple-user access to the volume is required, the {\tt multiuser} option
should be set to enable this.  This option records extra information which may
later be edited with the adminsfs program to allow other users access to the
volume.  More details on multiuser SFS volumes are given in the section
``Sharing SFS Volumes Between Multiple Users'' below.

If the {\tt multiuser} option is used, mksfs will warn:

{\small
\begin{verbatim}
  Warning: You have specified that access to the volume for multiple users
           be enabled.  Are you sure you want to do this [y/n]
\end{verbatim}}

At this point a response of `Y' will continue and a response of `N' will exit
the program.

The SFS driver can automatically unmount volumes if they have not been accessed
for a certain amount of time.  This option is useful if there is a chance that
an interruption may call you away from a system with mounted SFS volumes
allowing others access to the encrypted data, or can simply be used as a
general safety precaution to automatically unmount the volumes after a sizeable
period of inactivity (this option is unavailable under Windows - see the
section ``Incompatibilities'' below).  However, care should be taken to allow a
large enough safety margin for the timeout, as having a volume take itself
offline five seconds before work is saved to it can be annoying.

The easiest way to set an auto-unmount timeout is to associate a timeout value
with the volume when it is created with mksfs, although this setting can be
added or an existing setting modified at a later point with the chsfs program
(this is explained in more detail in the section ``Changing the Characteristics
of an SFS Volume'' below).  When the volume is mounted, the setting of the
timeout is automatically taken care of by the SFS software.

The timeout value in minutes is specified with the use of the {\tt timeout=}
option.  For example to create the volume used in the previous example with an
auto-unmount timeout of half an hour, the command would be:

\begin{verbatim}
  mksfs "vol=Secure disk volume" timeout=30 d:
\end{verbatim}

The drive on which the volume is being created may be able to handle a
different, faster access mode than the one normally used.  SFS supports a
number of these faster access modes, which can be tested for using the {\tt mksfs
-c} option which is explained in more detail in the section ``Incompatibilities''
below.  If the tests are successful, mksfs will report the fast access mode
which can be used to access the drive.  This mode can be specified with the
{\tt fastaccess=} option when a new volume is created, and all accesses to the
volume will then use the alternative, faster method instead of the default,
somewhat slower one.  Alternatively, use of the faster access mode can be
enabled at a later date with the {\tt chsfs newaccess=} command, which is explained
in more detail in the section ``Changing the Characteristics of an SFS Volume''
below.

For example if the {\tt mksfs -c} test reported that a fast access mode of 1 was
possible, then the previous volume creation example could be changed to:

\begin{verbatim}
  mksfs "vol=Secure disk volume" fastaccess=1
\end{verbatim}

When mounted, all accesses to this volume would then be made with the specified
faster access mode.

If the volume being converted already contains files, the encryption process
will overwrite the original files with their encrypted equivalent.  However
this may not be enough to safely wipe all traces of the original data.  In
order to provide a more thorough means of overwriting it, the {\tt wipe} option may
be used to force mksfs to perform multiple overwrite passes over the original
data.  The encrypted data will not be destroyed by performing these wipes, they
simply ensure that the original unencrypted data is removed with a high degree
of certainty.

In total, 30 separate overwrite passes, which have been selected to provide the
best possible chances of destroying data for various disk encoding schemes,
will be used.  The exact details of the overwrite process, and information on
data deletion in general, is given in the section ``Deletion of SFS Volumes''
below.  This process, while very thorough, is {\bf extremely slow}.  If mksfs is 
run on large volumes with the {\tt wipe} option enabled, the encryption with 
overwrite option may take hours to run to completion.  It is recommended that 
this option only be used if the data to be encrypted is of a highly sensitive 
nature.  Use of this option is unnecessary on an unused, freshly-formatted disk 
which has never contained any data.

The program will now check to see whether the chosen volume name and serial
number conflict with the name and serial number of an existing SFS volume.  If 
both the volume name and serial number conflict, this will make future 
manipulation of the volume difficult as there is no real way to uniquely identify 
it, and mksfs will exit with the error message:

{\small
\begin{verbatim}
  Error: An SFS volume with the given name and serial number already exists.
         Either a new name or serial number should be chosen, or no serial
         number at all specified, in which case mksfs will chose a unique
         serial number for the new volume.
\end{verbatim}}

An alternative possibility, if the conflicting volume is on removable media, is
to temporarily remove the disk from the drive until mksfs has been run.
However this still creates the problem of accessing the volume in the future.
A much easier solution is to either choose unique volume names or to let mksfs
choose the volume serial number - it will always chose a number which doesn't
conflict with an existing volume serial number.

If only the volume name clashes, mksfs will warn:
{\small

\begin{verbatim}
  Warning: An SFS volume with the given name already exists.  Are you sure
           you want to create a new volume with the same name [y/n]
\end{verbatim}

}
At this point a response of `Y' will continue and a response of `N' will exit
the program.

If an anonymous volume is to be created on a fixed disk, mksfs will warn:
{\small

\begin{verbatim}
  Warning: You have not specified a name for the volume to be created.
           This may make future manipulation of the volume difficult.  Are
           you sure you want to create an anonymous volume [y/n]
\end{verbatim}

}
At this point a response of `Y' will continue and a response of `N' will exit
the program.

If it's really necessary, these checks can be overridden by using chsfs to
change the volume's characteristics after it has been created.  Unlike mksfs,
chsfs is not particular about what the volume name is set to, as it makes the 
(possibly incorrect) assumption that the user knows what they are doing.

Once the preliminary processing has been done, mksfs will, in the case of a
fixed disk, scan it for the volume which is to be converted into an SFS one.
Along the way it will perform various checks on the volume to make sure the
volume is accessible, is a standard DOS volume, is not marked as being bootable
(booting off an encrypted volume is somewhat difficult), is not the one
currently in use, and can be converted.  Note that the bootability check may
not be completely foolproof, as some disk managers\footnote{
%Footnote [3]: 
		Among them the OS/2 and Windows NT boot managers.
} perform strange tricks with
bootable volumes to handle multiple operating systems on the same disk.

mksfs performs an additional check if the volume specified for encryption is
the C: drive, which is usually the primary DOS drive and which should under
normal circumstances never be encrypted.  If an attempt to encrypt the C: drive
is made, mksfs will prompt:
{\small

\begin{verbatim}
  Warning: You have chosen to encrypt the C: drive which is usually the
           primary DOS drive and shouldn't be encrypted.  Are you sure you 
           want to do this [y/n]
\end{verbatim}

}
At this point a response of `Y' will continue and a response of `N' will exit
the program.

If the various checks succeed, it will display an informational message giving
details on the volume to be created.  An example of the information displayed
for a fixed drive might be:

\begin{verbatim}
  Volume `Encrypted disk' will be created on fixed drive D:
  This drive has a capacity of 75.2 MB and is labelled `Accounting'
  Are you sure you want to encrypt this volume [y/n]
\end{verbatim}

If the volume is the one to be converted, a response of `Y' will proceed with
the creation of the SFS volume, and a response of `N' will abort the operation.

It is vitally important that the information printed by mksfs is checked before
a `yes' response is given.  Due to the vast array of unusual disk systems,
networked drives, compressed disks, device drivers, and other strangeness, it
could be that mksfs and DOS disagree on which volume is to be encrypted.  In
addition it is very easy to specify the wrong drive accidentally when running
mksfs.  Although this situation will hopefully never occur, it is nevertheless
a good idea to stop for a second and make absolutely certain that the volume
being encrypted is the one which should be encrypted.  Treat mksfs the same way
you would treat the DOS `format' command.

For a floppy drive the information is slightly different:

{\tt \verb|  |Volume `Secure backup' will be created on 1.44MB disk in drive B:}

No yes/no prompt is given for removable disks since they contain far less
information than fixed disk volumes, and will typically be freshly-formatted,
blank diskettes.  This allows the quick bulk encryption of quantities of
diskettes without having to answer the same question for each disk.  If
necessary the encryption operation can be aborted at the password-entry stage.

mksfs will now check the volume to be encrypted for bad sectors.  Most newer
fixed disks will automatically map out bad sectors (if there are any) and use
sectors from spare space on the disk instead (all this is invisible to the
system software and is done internally by the drive itself).  However older
drives may still explicitly report bad sectors.  The presence of bad sectors on
a disk may also indicate a virus infection, or may be used by certain kinds of
(hopefully extinct) copy-protection schemes.  If mksfs finds any of these, it
will print an advisory message:

{\small \tt \verb|  |Warning: This disk contains bad sectors which won't be encrypted by SFS.}

If the disk being encrypted is a floppy disk, mksfs will print a message
recommending that another disk be used instead.  If the data is valuable enough
to need encryption, then it should really be stored on an error-free medium
rather than its loss risked with defective floppy disks:
{\small

\begin{verbatim}
  Warning: This disk contains bad sectors.  Use of damaged disks is not
           recommended as recovery of encrypted data could be difficult if
           further bad sectors develop.  Are you sure you want to encrypt
           this disk [y/n]
\end{verbatim}

}
At this point a response of `Y' will continue and a response of `N' will exit
the program.  SFS will encrypt the disk, but will skip any sectors marked as
being defective.  A similar message will be printed if any bad sectors are
found during the encryption process.  Note that if further bad sectors develop
on the floppy disk, recovery of the data stored in the bad sectors will be
difficult.  It is strongly recommended that only error-free floppy disks be
used with SFS\footnote{
%Footnote [4]:
              Although SFS has been written so that if any data does become
              corrupted, only the corrupted sector and no others will be lost,
              if data which is important to the operating system (such as a
              directory or a file allocation table) is lost, the damage may
              (just as it would for a normal non-encrypted disk) be more
              significant.  In this case any standard disk-recovery program can
              be used to make repairs, just as with a normal DOS disk.
}.

Once the disk checks have been completed, mksfs will ask for a password to use
when encrypting the volume.  This password can range in length from 10 to 100
characters, and should be made up of a complete phrase or sentence rather than
just a single word (mksfs will complain if it thinks the password is of an
insecure form and request that another one be used).  More details on choosing
a password are given in the section ``The Care and Feeding of Passwords'' below.

When asking for the password, mksfs will prompt:

{\tt \verb|  |Please enter password (10...100 characters), [ESC] to quit:}

At this point a password in the given length range can be entered.  For
security reasons the password is not echoed to the screen.  Any typing errors
when entering the password can be corrected with the backspace key.  The Esc
key can be used to quit.  The software will check for a password longer than
the maximum of 100 characters or an attempt to backspace past the start of the
password, and beep a warning when either of these conditions occur.

Once the password has been entered, mksfs will again prompt:

{\tt \verb|  |Please reenter password to confirm, [ESC] to quit:}

This confirmation is necessary to eliminate any problems with hitting an
incorrect key when entering the password the first time.  Note that every
single letter, space, and punctuation mark in the password is critical.  Making
a single mistake (getting a letter mixed up, typing a letter in upper case
instead of lower case, or missing a punctuation mark) will completely change
the encryption key.  For this reason, mksfs performs a double-check on the
password to ensure it really is the correct one.

Once the password has been entered, there is a brief delay while mksfs performs
the complex processing needed to turn it into a key suitable for the encryption
system.  When this has been completed, mksfs will begin converting the disk.
As it processes the volume, it prints a progress bar going from 0\% complete to
100\% complete.  The conversion process will take a few minutes on most disks,
and is somewhat slower than a standard disk formatting procedure which only
writes a very small amount of data to the start of the disk and scans for bad
sectors, whereas mksfs has to read, encrypt, and write the entire disk volume.

As the conversion progresses, the progress bar will gradually fill up until it
shows that the conversion is complete.  Once this has finished, mksfs will exit
with the message:

{\small \tt \verb|  |Encrypted volume created.~You can now mount it with the `mountsfs' command}

If the volume is created on a removable disk, mksfs will ask:

{\tt \verb|  |Do you wish to encrypt another disk [y/n]}

At this point a response of `Y' will continue and a response of `N' will exit
the program.  If the `Y' response is chosen, mksfs will prompt:

{\tt \verb|  |Please insert a new disk in the drive and press a key when ready}

and then repeat the disk encryption cycle.

If the volume is created on a fixed disk, DOS will still think the volume it
was created on is a DOS one rather than an encrypted SFS one.  It is strongly
recommended that you reboot your machine at this point to clear any memories of
the old volume from the system, as any attempt by DOS to access the encrypted
volume as a normal DOS volume will cause it to become very confused.  As a
reminder, mksfs will display the message:
{\small
\begin{verbatim}
  Encrypted volume created. You can now mount it with the `mountsfs' command
  or mount it at system startup with the option `MOUNT=<mount id>' in the
  CONFIG.SYS entry for the SFS driver.

  You may wish to reboot your machine to update the status of the SFS volume
  which is now inaccessible from DOS.
\end{verbatim}
}
The {\tt <mount id>} will be the ID needed to mount the encrypted volume when the 
machine is booted.  More details on automounting volumes are given in the section 
``Advanced SFS Driver Options'' below.

\section{Mounting an SFS Volume}

When the operating system first starts, it finds all disk volumes it can
recognise and automatically makes them available as different logical drive
letters.  However it can't do anything with encrypted SFS volumes, and so they
are effectively invisible to it.  In order to make them visible, they must be
mounted using the mountsfs program.  Operating systems such as Unix mount
filesystems in this manner (in fact the general feel of mountsfs is vaguely
like the Unix filesystem mount utility).

When the operating system mounts a disk volume, it uses the rather primitive
mechanism of assigning a letter of the alphabet to it and referring to the
drive by that letter.  SFS, on the other hand, refers to the volume by the name
given when the volume is created with mksfs rather than some arbitrary letter
(although volumes in removable drives can optionally be referred to by the
driver letter).  Therefore if the encrypted volume was named ``Secure disk
volume'', mountsfs would mount ``Secure disk volume'' rather than, say, ``E:''.  A
fixed disk can contain multiple encrypted volumes, mountsfs will chose the
appropriate one based on the volume name.  When searching for volumes to mount,
all fixed disks are checked before any removable disks are checked, so that a
volume with a given name on a fixed disk would override a volume of the same
name on a floppy disk.

Once the volume is mounted, DOS will still refer to it by a drive letter as
usual (there's only so much the SFS software can do), so that ``Secure disk
volume'' will, after being mounted with SFS, appear as just another DOS drive, 
for example E:.  If necessary the drive letter which SFS uses can be swapped
through the use of the JSWAP utility which comes as part of the JAM disk
compression software.  The use of JSWAP rather than the DOS commands ASSIGN,
SUBST, and JOIN, or other third-party utilities such as the one provided with
Stacker are recommended, as JSWAP provides the safest means of swapping drive
letters.  The JAM disk compression software is discussed in more detail in the
section ``Creating Compressed SFS Volumes'' below.

With removable disks it may sometimes be desirable to refer to the volume by
the drive it is in rather than the volume name.  In this case the drive can be
specified by the usual letters A: or B:, and the actual volume name will be
ignored.  As before, once the disk is mounted with SFS, the volume will appear
as another DOS drive, for example E:.  If the disk is accessed as E:, the SFS
driver will encrypt and decrypt data being written and read.  If the disk is
accessed as A: or B:, DOS will either display garbage or report a general
failure error as it doesn't understand the encrypted disk. The A: or B: drive
letters can still be used to read normal DOS disks, however.  In order to
prevent accidental overwriting of disks, the SFS driver will automatically
unmount a volume if it detects that a disk change has occurred since the last
time it accessed the drive.

The mountsfs program is run in the following manner:

{\tt \verb|  |mountsfs [+r] [+rw] [status] [unmount] [info] [information]\\
\verb|           |[hotkey=$Ctrl$-$Alt$-$LeftShift$-$RightShift$-$letter$ {\em or none}]\\
\verb|           |[timeout=$timeout$] [user={\em user name}] [userfile=[{\em user file}]\\
\verb|           |[vol={\em volume name}] [$drive$]}

Since all arguments are named, they can be given in any order.  The order shown
here is merely an example.

When mountsfs starts, it first performs a number of checks on the internal
status of the SFS driver.  If it can't find the driver, it will exit with the
error message:

{\tt  \verb|  |Error: Cannot find SFS driver}

This is due to the driver not being loaded, either because it is not being
specified in the CONFIG.SYS file, or because there was some error when it was
loaded and it de-installed itself.  More information on this is given in the
section ``Loading the SFS Driver'' above.

If the driver reports a general internal consistency check failure or a
consistency check failure for a particular drive unit (in this case drive F:),
mountsfs will exit with the error message:

{\tt  \verb|  |Error: SFS driver internal consistency check failed}

or:

{\tt  \verb|  |Error: SFS driver consistency check failed for unit F:}

A driver check failure is generally due to some other program or system
software corrupting the driver's internal state.  Possible solutions to this
problem can be found in the section ``Incompatibilities'' below.

In general the volume name would be specified with the {\tt vol=} option.  For
example if the volume name was ``Secure disk volume'' then the mount command
would be:

{\tt \verb|  |mountsfs vol=secure}

The volume name can be in upper or lower case, and the full name need not be
given.  mountsfs will match whatever part of the name is given to any SFS
volume names found until it finds a match.  The SFS volumes are checked in the
same order as they are displayed with the {\tt info} or {\tt information} command.

Alternatively, if the SFS volume to be accessed is on a removable disk, the
drive letter can be specified instead of the volume name.  For example if the
disk drive was A: then the command to mount whatever volume it contained would
be:

{\tt \verb|  |mountsfs a:}

mountsfs will not mount volumes using the mount identifier, as this is reserved 
for use with volumes mounted when the SFS driver is loaded.  More information 
on this is given in the section ``Advanced SFS Driver Options'' below.

In order to find all available SFS volumes, the {\tt info} option can be used.
This will by default search the system for available SFS volumes and print a
list of the volume name, creation date, size, and whether the volume is
currently mounted. For example on a system with two SFS volumes the output from
{\tt mountsfs info} might be:

\begin{verbatim}
    Date     Size   Type Mount status  Volume Name
  -------- -------- ---- ------------- -----------------------------
  01/11/93  Floppy  DOS    Unmounted   Data backup
  06/09/93  10.0 MB DOS  Mounted as E: Personal financial records
  12/04/93  42.5 MB DOS    Unmounted   Encrypted data disk
\end{verbatim}

This shows three SFS volumes, an unmounted volume in a floppy drive containing
backup data, a smaller one on a fixed disk containing personal financial
records which is currently mounted as drive E:, and a larger one containing
general encrypted data which is currently unmounted.  Note that removable media
is treated in a special manner and the exact disk size is indeterminate as the
media may change at any time.  The volume creation date is formatted according
to the country setting on the machine being used, so that the datestamp is
day/month/year in Europe and related countries, month/day/year in the US and
related countries, and year/month/day in Japan.  Both volumes shown here are
DOS volumes, but future versions of SFS will support other volume types such as
OS/2 HPFS, Windows NTFS, and Linux Unix ones.

If more information is desired, the longer {\tt information} form of the command
can be used.  This will display extra information such as the volume serial
number, the mount identifier (see the section ``Advanced SFS Driver Options''
below for more information), the volume filesystem type, whether multiuser
volume access is possible, what type of disk access mode is used for the
volume, the volume name character set, and the default auto-unmount timeout
value (which can be overridden when the volume is mounted if required), as well
as the other information displayed by the usual {\tt mountsfs info} command.  If, 
in the previous example, we had used {\tt mountsfs information} instead of {\tt mountsfs info}
the output might have been:
{\small
\begin{verbatim}
  Volume name  : Data backup
  Volume date  : 01/11/93, 10:13:01  Volume serial number  : 1234
  Volume size  : Removable media     Volume filesystem type: DOS
  Mount status : Unmounted           No mount at system startup possible
  Multiuser access  : Disabled       Fast disk access mode : 0 (Default)
  Vol.name char.set : ISO 646/ASCII  Current access mode   : 0 (Default)
  Unmount timeout   : None set
\end{verbatim}
\begin{verbatim}
  Volume name  : Personal financial records
  Volume date  : 06/09/93, 11:22:19  Volume serial number  : 177545
  Volume size  : 10.0 MB             Volume filesystem type: DOS
  Mount status : Mounted as E:       Mount ID              : 03A12F7B
  Multiuser access  : Disabled       Fast disk access mode : 0 (Default)
  Vol.name char.set : ISO 646/ASCII  Current access mode   : 0 (Default)
  Unmount timeout   : 30 minutes

  Volume name  : Encrypted data disk
  Volume date  : 12/04/93, 22:17:00  Volume serial number  : 69231461
  Volume size  : 42.5 MB             Volume filesystem type: DOS
  Mount status : Unmounted           Mount ID              : 42DD2536
  Multiuser access  : Enabled        Fast disk access mode : 1 (IDE direct)
  Vol.name char.set : ISO 646/ASCII  Current access mode   : 1 (IDE direct)
  Unmount timeout   : 10 minutes
\end{verbatim}

}
By default these two commands will display information on all available 
volumes. If information on an individual volume is required, then the volumes' 
name or drive letter can be given in addition to the {\tt info} or {\tt information} 
option. To change the previous use of the {\tt info} command to apply only to the 
volume named ``Data backup'', the command might be:

{\tt \verb|  |mountsfs info vol=backup}

and the output would be as follows:

\begin{verbatim}
    Date     Size   Type Mount status  Volume Name
  -------- -------- ---- ------------- -----------------------------
  01/11/93  Floppy  DOS    Unmounted   Data backup
\end{verbatim}

The {\tt status} option can be used to check whether any volumes are currently
moun\-ted.  As with the {\tt info} and {\tt informaton} options, by default information
on all mounted SFS volumes is displayed.  If information on an individual
volume is required, then the volumes' name or drive letter can be given in
addition to the {\tt status} option.  Thus the command:

{\tt \verb|  |mountsfs status}

will return a list of the status of the volumes on all mount points, as well as
an indication of the current setting of the quick-unmount hotkey and the
auto-unmount time settings for any mounted volumes (the latter are explained in 
more detail below), whereas the command:

{\tt \verb|  |mountsfs status f:}

will return the above status information only on the volume currently mounted
as F:.  An example of the output of the {\tt status} command when run on the setup
shown in the {\tt info} command examples with a total of two mount points available
might be:

\begin{verbatim}
  SFS volume `Personal financial records' is mounted as drive E:,
          and will time out in 18 minutes.
  Drive F: has no volume mounted

  The quick-unmount hotkey is set to `LeftShift-RightShift'.
\end{verbatim}

The {\tt +r} and {\tt +rw} options specify read and write access to the encrypted
volume.  {\tt +r} allows read-only access and {\tt +rw} allows read and write access.
The default is to allow read/write access.  Note that although mounting an SFS
volume read-only will stop all standard software from writing to it, it may not
stop some malicious programs such as viruses which have been specially written
to attack the SFS driver itself, or which are created specifically to destroy
disk data by bypassing the operating system and accessing the disk hardware
or firmware directly\footnote{
% Footnote [1]:
               Viruses capable of doing this are generally called tunneling
               viruses.  Most of them only tunnel down to the the DOS int 21h
               level (which won't affect SFS), but several tunnel down to the
               BIOS int 13h level.  The DIR II virus tunnels down to the block
               device driver request level (which again won't affect SFS).  In
               addition there is a report of a virus which will access an IDE
               hard drive directly through the drive controller ports (which,
               has the side-effect of crashing Windows when using 32-bit disk
               access).  No viruses capable of accessing SCSI drives through the
               ASPI or CAM drivers are known.  In any case an SFS volume creates
               a rather bad target for DOS viruses since the DOS drive it
               corresponds to is only an illusion created by the SFS driver, and
               the underlying data on disk is invisible to DOS and most viruses.
}.  The read-only option is provided mainly to stop any
accidental overwriting of valuable data on encrypted volumes.

Read-only access can also be specified when an SFS volume is mounted at the.
time the SFS driver is loaded into memory.  More details on this and on 
mounting volumes at system startup are given in the section ``Advanced SFS 
Driver Options'' below.

The read/write status of a volume can be changed once it has been mounted by
running mountsfs with only the {\tt +r} or {\tt +rw} option.  This will change the
read/write status of the currently mounted volume as appropriate.  For example
to allow read/write access to the currently mounted SFS volume the command
would be:

{\tt \verb|  |mountsfs +rw}

If the volume allows multiuser access, only the volume administrator can
directly mount it in the manner described above.  Normal volume users must
specify their user name with the {\tt user=$username$} command in addition to the
usual mount parameters in order to mount the volume\footnote{
%Footnote [2]:
              Some versions of SFS will automatically know the user's name when
              a volume is mounted.  Unfortunately the DOS version isn't one of
              these.
}.  The user name is the
name under which access is granted by the system administrator.  Like the
volume name, any portion of the user name can be given and mountsfs will match
whatever part of the name is given to any user names until it finds a match.
Users can also specify the name of the file to search for user access
information using the {\tt userfile={\em user file}} command.

For example if the volume in the previous example allowed multiuser access and
one of the users granted access to the volume was ``Henry Akely'', he could mount
it with the command:

{\tt \verb|  |mountsfs vol=secure user=henry}

If an attempt to mount a volume with no multiuser access capabilities is made,
mountsfs will exit with the error message:

{\tt \verb|  |Error: This volume has multi-user access disabled}

If access information for the given user cannot be found in the user access
file or files, the program will exit with an error message:

{\tt \verb|  |Error: Cannot find access information for user `henry'}

An individual users access rights to the volume, as set by the volume
administrator, may override certain options specified in mountsfs.  More
details on this, and on the operation of shared SFS volumes as a whole, are
given in the section ``Sharing SFS Volumes Between Multiple Users'' below.

If mountsfs is asked to mount a volume, it will first check to see whether
there is room to mount it.  If all available mount points are already occupied,
the program will print:

{\small \tt \verb|  |Error:~All available drives are allocated-unmount an existing volume first}

and exit.  In this case either an existing volume must be unmounted to free up
a mount point and allow the new volume to be mounted, or the number of mount
points must be increased with the {\tt UNITS=$n$} command when the SFS driver is 
loaded. More details on this are given in the section ``Loading the SFS Driver'' 
above.

If mountsfs is asked to mount a volume, it will search all available disks for
the named volume (if the volume is accessed by name), or check the removable
disk for the volume (if the volume is accessed by disk drive letter).  If the
volume is already mounted, mountsfs will print:

{\tt \verb|  |Error: Encrypted volume is already mounted}

and exit.  Otherwise, it will print a summary of the volume giving the
read/write status, the drive type, and the volume name and date if one exists:

{\tt \verb|  |Volume will be mounted as fixed drive E:.\\
     \verb|  |Encrypted volume is `Personal correspondence', created 12/08/93}

Then it will prompt for the encryption password:

{\tt \verb|  |Please enter password (10...100 characters), [ESC] to quit:}

At this point a password in the given length range can be entered.  For
security reasons the password is not echoed to the screen.  Any typing errors
when entering the password can be corrected with the backspace key.  The Esc
key can be used to quit.  The software will check for a password longer than
the maximum of 100 characters or an attempt to backspace past the start of the
password, and beep a warning when either of these conditions occur.  Once the
password has been entered, mountsfs will process it and reprogram the SFS
device driver to reflect the change in status.

If the disk being mounted is a removable one, mountsfs will check that the
drive being used supports disk change checking.  This is necessary to ensure
that the wrong disk isn't accidentally accessed by the driver.  If the disk is
changed without first being unmounted, the SFS driver will automatically
unmount it the next time an attempt is made to access it\footnote{
%Footnote [3]:
              The driver checks for a disk change when a disk read or write
              attempt is made rather than whenever DOS performs a general disk
              check, as DOS may perform up to half a dozen consecutive disk
              checks before doing anything, which leads to a significant loss
              in performance.
}.  However if the
drive doesn't support the disk change check (generally only rather old drives
have this problem), this automatic unmount won't be possible, and mountsfs will
warn:
{\small

\begin{verbatim}
  Warning: The floppy drive this volume is mounted on does not support disk
           change checking.  This means that great care must be taken to
           ensure the existing volume is unmounted (using either the
           `mountsfs' utility or the quick-unmount hotkey) when a new disk
           is inserted.
\end{verbatim}

}
If the drive does not support the disk change check, it is essential that the
volume be unmounted when the disk is changed.  The easiest way to unmount a
volume is through the quick-unmount hotkey, which is explained in more detail
below.

The {\tt unmount} option is used to unmounts SFS volumes.  This is used to remove
any access to volumes after any work which requires them has been completed, or
to free up a mount point so a new volume can be mounted.  If a particular SFS
volume is contained on a removable disk, it is a good idea to unmount the
volume if the disk in the drive is changed, although mounting a new volume will
automatically unmount the old volume.  The unmount operation can also be
performed using a quick-unmount hotkey which the SFS driver checks for (see
below).  Like the {\tt status} and {\tt information} command, the {\tt unmount} command can
either apply to individual mounted volumes which are specified by their drive
letter, or to all volumes if no drive letter is given.

Unmounting a volume also signals the SFS driver software to write all data
still held in system buffers to disk and to erase any information it still
holds in memory.  It is therefore good practice to always unmount volumes as
soon as they are no longer in use in order to destroy any sensitive information
which may still be held by the SFS driver or in a system buffer.  For example
to unmount all currently mounted volumes the command would be:

{\tt \verb|  |mountsfs unmount}

To unmount the volume currently mounted as F: the command would be:

{\tt \verb|  |mountsfs unmount f:}

A faster way to unmount all volumes is to use the quick-unmount hotkey which
the SFS driver checks for and accepts in place of the standard unmount command.
This can be used both as a convenience to quickly and easily unmount all SFS
volumes, or as a safety feature to allow encrypted volumes to be instantly
unmounted if there is a danger of the data on them being compromised (this
option is generally unavailable under Windows - see the section
``Incompatibilities'' below).

If no hotkey is currently set (either from a previous use of the mountsfs
command or through the use of the {\tt HOTKEY=NONE} option when the SFS driver is
loaded), and the {\tt hotkey=none} option is not specified, mountsfs will install a 
default quick-unmount hotkey which is a combination of the left and right shift 
keys.  On most keyboards these keys are fairly large and easy to reach during 
normal typing.  When both shift keys are pressed and released, all mounted SFS 
volumes will be unmounted as if a normal unmount command had been issued via 
mountsfs, and a single beep will sound to indicate that the unmount was 
successful.

Occasionally this default hotkey combination may clash with other software, or
it may be desirable to use another hotkey combination.  This can be set with
the {\tt hotkey=} option, which may be used to specify any combination of the left
shift key, right shift key, control key, alt key, and a letter key\footnote{
%Footnote [4]:
              The letter key is based on the US keyboard since the SFS driver
              must check for keyboard scan codes rather than actual character
              codes, which can differ slightly for some keyboards.
}.  The
keys are specified in the following manner:

\begin{center}
\begin{tabular}{|l|l|}
\hline
    Key            & Specification\\
\hline
    Alt key        & `alt'\\
    Control key    & `ctrl'\\
    Left shift key & `leftShift'\\
    Right shift key& `rightShift'\\
    Letter key     & `a'...`z'\\
\hline
\end{tabular}
\end{center}

Key combinations should be separated by hyphens, `-'.  The key names are not
case sensitive and can be given in upper or lower case, or a mixture of both.
If an unknown key name is used or the key names are not separated with hyphens,
mountsfs will complain:

{\tt \verb|  |Error: Bad quick-unmount hotkey format}

For example, to specify the use of the left shift and right shift keys as the
quick-unmount hotkey (the usual default setting), the command used in the
previous example would be changed to:

{\tt \verb|  |mountsfs hotkey=LeftShift-RightShift vol=secure}

To use the Control, Alt, and Z keys as the quick-unmount hotkey the command
would be:

{\tt \verb|  |mountsfs hotkey=ctrl-alt-Z vol=secure}

The hotkey value can also be altered without mounting any volumes.  This will
merely update the current hotkey without making any other changes.  For example
to set the right Shift, Control, and I keys as the quick-unmount hotkey (a
rather unwieldy combination), the command would be:

{\tt \verb|  |mountsfs hotkey=rightshift-CTRL-I}

The hotkey unmount can be disabled by specifying {\tt hotkey=none} when mountsfs is
run, either as part of a normal mount operation or by simply running mountsfs
with only the hotkey option, which will clear the unmount hotkey without making
any other changes.

Finally, the hotkey can also be specified when the SFS driver is loaded.  More
details on this are given in the section ``Advanced SFS Driver Options'' below.

If the hotkey unmount is performed while the driver is accessing a volume, the
disk access will complete before the volume is unmounted.

The SFS driver can also automatically unmount volumes if they have not been
accessed for a certain amount of time.  This option is useful if there is a
chance that an interruption may call you away from a system with mounted SFS
volumes, which would allow others access to the encrypted data, or can simply 
be used as a general safety precaution to automatically unmount the volumes 
after a sizeable period of inactivity (this option is unavailable under Windows
--- see the section ``Incompatibilities'' below).  However, care should be taken to 
allow a large enough safety margin for the timeout, as having a volume take 
itself offline five seconds before work is saved to it can be annoying.

The easiest way to set a timeout is to associate a timeout value with the
volume, either when it is created with {\tt mksfs} or at a later point with {\tt chsfs}.
If the volume is mounted, the setting of the timeout is automatically taken
care of by the SFS software.  The current timeout setting for a volume or
volumes may be displayed using the {\tt mountsfs information} command.

However it may be desirable to override this setting using the {\tt timeout=} 
option, which is used to specify the delay in minutes until the unmount takes 
place.  If the volume has no timeout associated with it then by default
mountsfs will not set an auto-unmount timer.  For example, using the previous
mount command but to have the volume automatically unmounted after 15 minutes 
of inactivity the command would be:

{\tt \verb|  |mountsfs timeout=15 vol=secure}

The timeout period must be between 1 and 30,000 minutes (this means that the 
upper timeout limit is around three weeks).  If a timeout value of less than 1 
minute or greater than three weeks is given, mountsfs will exit with the error
message:

{\tt \verb|  |Error: Timeout value must be between 1 and 30,000 minutes}

If no accesses are made to the volume within the given time period, it will be
automatically unmounted.  Like the case when a hotkey unmount is made, a single
beep will sound to indicate that the unmount has taken place.  Each volume has
its own timer, so that different volumes can be given different lengths of time
before they unmount, or no auto-unmount time at all.  This is useful when, for
example, one volume containing highly sensitive information needs to have a
very short timeout, while another volume containing less secret information can
have a much longer timeout.  An example might be a series of three SFS volumes:

\begin{verbatim}
  mountsfs timeout=10 vol=Topsecret
  mountsfs timeout=30 vol=Secret
  mountsfs timeout=60 vol=Confidential
\end{verbatim}

in which the ``Topsecret'' volume is given the shortest timeout of only 10
minutes, the ``Secret'' volume is given a timeout of 30 minutes, and the
``Confidential'' volume is given the longest timeout of a full hour.

The timed unmount can be disabled by specifying {\tt timeout=none} when mountsfs is
run, either as part of a normal mount operation which will affect only the
current volume, or by running mountsfs with only the timeout option, which will
clear the timer for all volumes without making any other changes.

If the timed unmount is performed while the driver is accessing a volume, the
disk access will complete before the volume is unmounted.

Finally, if all is OK, mountsfs will print a short summary message for the
action taken.  For example if the command given was one to unmount all volumes,
with two volumes F: and G: of which only F: was currently mounted, the summary
would be:

{\tt \verb|  |Volume F: has been unmounted\\
     \verb|  |Volume G: is already unmounted}

\section{Advanced SFS Driver Options}

The SFS driver supports several advanced options which can be used to customize
the operation of SFS.  These include the ability to mount SFS volumes
automatically when the driver is loaded, the ability to turn echoing of
passwords on, and the ability to change the read/write status, disk access
mode, and auto-unmount timeout of mounted volumes, the quick-unmount hotkey, 
and the password prompt used when automounting volumes.

\subsection{Mounting SFS Volumes at System Startup}

SFS volumes can be automatically mounted when the system is started up rather
than having to be mounted through the mountsfs program.  This can be specified
using the {\tt MOUNT={\em identification number}} option when the SFS driver is loaded, 
in conjunction with the 8- or 14-digit volume identification number displayed 
by mksfs when the encrypted volume is created or by using the {\tt mountsfs 
information} command.  The volume identifier is used to tell the SFS driver 
which volume to load.   In most cases the shorter 8-digit identifier is used, 
but the longer 12-digit form may be necessary for volumes with more complex 
access procedures such as ones on SCSI drives.  mksfs and mountsfs will always 
print the correct type of identifier for the volume in question.

If the volume allows multiuser access, only the volume administrator can mount 
it.  Normal volume users must follow the standard volume mount procedure using 
mountsfs.  The operation of shared SFS volumes is explained in more detail in 
the section ``Sharing SFS Volumes Between Multiple Users'' below.

For example if mksfs displays the 8-digit volume identifier `530A17FD' for a 
particular volume then the command to mount this volume would be:

{\tt \verb|  |DEVICE=SFS.SYS MOUNT=530A17FD}

If it displays a 14-digit volume identifier `C02100142DE0FC' then the command
to mount the volume would be:

{\tt \verb|  |DEVICE=SFS.SYS MOUNT=C02100142DE0FC}

If an incorrect volume identifier is given, the driver will display

{\tt \verb|  |Error: Invalid mount ID, skipping mount}

and skip the mount procedure.  If the volume identifier is correct, the driver 
will locate the required volume on the disk and try to read in the information 
needed to process it.  If this information cannot be read or is incorrect, the 
driver will display:

{\tt \verb|  |Error: Invalid SFS volume information, skipping mount}

and skip the mount procedure.  If the volume is located on a SCSI drive and the 
SCSI manager software needed to access the drive is not present, the driver
will display:

{\tt \verb|  |Error: SCSI manager not found, cannot mount SCSI drive}

and skip the mount procedure.  If all is correct the driver will ask for the 
password exactly as mountsfs would:

{\tt \verb|  |Please enter password (10...100 characters), [ESC] to quit:}

At this point a password in the given length range can be entered.  For
security reasons the password is not echoed to the screen.  Any typing errors
when entering the password can be corrected with the backspace key.  The Esc
key can be used to quit.  The software will check for a password longer than
the maximum of 100 characters or an attempt to backspace past the start of the
password, and beep a warning when either of these conditions occur.  Up to
three attempts at entering a correct password are allowed before the mount is 
skipped.  If the Esc key is pressed the SFS driver will print:

{\tt \verb|  |Mount operation skipped at user request}

and skip the mount procedure.  Otherwise, once the password has been entered, 
the SFS driver will process it and, if an incorrect password is detected, will 
print:

{\tt \verb|  |Error: Incorrect password, skipping mount}

The driver will then perform a quick disk read test to make sure everything is
working correctly.  If this fails, the driver will display:

{\tt \verb|  |Error: Disk read test failed, skipping mount}

and skip the mount procedure.  Otherwise the encrypted volume will be mounted 
ready for use, with the drive letter being the next available DOS drive.  In 
general the mount procedure is the same as the one which mountsfs uses, except 
that the full functionality of mountsfs is not available during the mount.  In 
all cases if the automount procedure is skipped the driver will still be loaded, so 
that volumes can be mounted at a later time if required.

The mount procedure has a built-in timer which expires if no key is hit for
more than 1 minute.  This is to allow unattended machines to automatically
reboot in case of a power failure without waiting forever for a mount
password.  If no key is pressed for more than 1 minute, the SFS driver will
print:

{\tt \verb|  |Password entry timed out, skipping mount}

and skip the mount procedure.  Again, the driver will still be loaded to allow 
volumes to be mounted at a later time.

Once the volume has been mounted and after the usual SFS installation message
has been displayed, the driver will display the DOS drive on which the
encrypted volume is mounted.  For example if the volume was available as drive
G: the message would be:

{\tt \verb|  |Encrypted volume is now mounted as drive G:}

If necessary the drive letter which SFS uses can be swapped through the use of
the JSWAP utility which comes as part of the JAM disk compression software.
The use of JSWAP rather than the DOS commands ASSIGN, SUBST, and JOIN, or other
third-party utilities such as the one provided with Stacker are recommended, as
JSWAP provides the safest means of swapping drive letters.  In particular,
JSWAP won't swap any non-physical drives, it won't reassign physical drives to
leave a hole in series of block devices (as opposed to the way DoubleSpace does
things), and it can fix things so that various badly-designed programs which
don't normally handle drive swapping too well should still work.
 
If multiple volumes are to be mounted then the mount identifiers should be
given in the order in which the mounts are to take place.  For example if a
second SFS volume with the volume identifier `4850414B' were to be mounted then 
the previous example would change to:

{\tt \verb|  |DEVICE=SFS.SYS MOUNT=530A17FD MOUNT=4850414B}

As more volumes are mounted, the driver will automatically increase the mount
point allocation until the maximum number of 5 mount points has been reached,
making use of the {\tt UNITS=$n$} option unnecessary.  If an attempt is made to 
mount more than 5 volumes, the driver will print:

{\tt \verb|  |Error: No more disk units available for mount}

and skip the mount procedure.

\subsection{Setting the Quick-Unmount Hotkey Value}

When a volume is mounted, the quick-unmount hotkey is by default set to a
combination of the left and right shift keys.  However, like the mountsfs
{\tt hotkey=} option, the SFS driver supports user-defined hotkeys with the
{\tt HOTKEY={\em quick-unmount hotkey}} command, as well as allowing the hotkey unmount
option to be disabled with the {\tt HOTKEY=NONE} command.

The {\tt HOTKEY={\em quick-unmount hotkey}} form of the command may be used to specify
any combination of the left shift key, right shift key, control key, alt key,
and a letter key, in the following manner:

\begin{center}
\begin{tabular}{|l|l|}
\hline
    Key            & Specification\\
\hline
    Alt key        & `alt'\\
    Control key    & `ctrl'\\
    Left shift key & `leftShift'\\
    Right shift key& `rightShift'\\
    Letter key     & `a'...`z'\\
\hline
\end{tabular}
\end{center}
%    Alt key        = `alt'          Control key     = `ctrl'
%    Left shift key = `leftShift'    Right shift key = `rightShift'
%    Letter key     = `a'...`z'

Key combinations should be separated by hyphens, `-'.  The key names are not
case sensitive and can be given in upper or lower case, or a mixture of both.
If an unknown key name is used or the key names are not separated with hyphens,
the SFS driver will complain:

{\tt \verb|  |Error: Bad quick-unmount hotkey format}

For example, to specify the use of the left shift and right shift keys as the
quick-unmount hotkey (the usual default setting), the command used in the
previous example would be changed to:

{\tt \verb|  |DEVICE=SFS.SYS MOUNT=530A17FD HOTKEY=LEFTSHIFT-RIGHTSHIFT}

To use the Control, Alt, and Z keys as the quick-unmount hotkey without
mounting any volumes the command would be:

{\tt \verb|  |DEVICE=SFS.SYS HOTKEY=CTRL-ALT-Z}

To disable hotkey unmounting altogether, and without mounting any volumes, the 
command would be:

{\tt \verb|  |DEVICE=SFS.SYS HOTKEY=NONE}

\subsection{Echoing the Mount Password to the Screen}

Normally when the mount password is entered, nothing will be echoed to the
screen.  However it may be desirable to echo the password to the screen as it
is typed in.  The {\tt ECHO} option can be used to turn on the echoing of
passwords. Note that use of this option makes it much easier to eavesdrop on
the password as it is entered, by simply glancing over the shoulder of the
person entering the password, by making use of monitoring facilities installed
for general security purposes, or by using more sophisticated techniques such
as TEMPEST monitoring (these are covered in more detail in the section ``Data
Security'' below).  For these reasons, use of the {\tt ECHO} option is not
recommended.

\subsection{Changing the Mount Password Prompt}

In some environments it may be undesirable to alert others to the fact that
disk encryption is being used.  Using the {\tt SILENT} option with the driver
removes most indications of the presence of SFS, but if volumes are mounted the 
appearance of the password prompt may still give things away.  To correct this 
problem, the SFS driver supports user-definable prompts with the
{\tt PROMPT={\em user-prompt}} command.  This may be used to specify any single-word
prompt, or, if the prompt is surrounded by quotation marks `{\tt "}', any combination
of characters until another `{\tt "}' is encountered.  For example to make the SFS
mount procedure appear like a network login, the previous mount example might 
be changed to:

{\tt \verb|  |DEVICE=SFS.SYS SILENT PROMPT=Login: MOUNT=530A17FD}

Instead of the usual password prompt, the driver would now display:

{\tt \verb|  |Login:}

when the password was required.

If a prompt containing multiple words is required, the prompt itself would be
surrounded with quotation marks:

{\tt \verb|  |DEVICE=SFS.SYS SILENT PROMPT="Please log on:" MOUNT=530A17FD}

Unfortunately some versions of DOS convert all characters to uppercase before
passing them to SFS.SYS.  In order to allow lowercase characters to be used in
prompts, the {\tt PROMPT=} option recognises the escape sequence {\tt $\backslash$s} to mean
``shift to lowercase'', so that all subsequent characters will be converted to
lowercase before being displayed.  Subsequent uses of {\tt $\backslash$s} will toggle the
current shift state, shifting characters back to uppercase or to lowercase
depending on the current shift state.  For example to have the previous
mount example display the prompt ``Enter Code:'', the command would be:

{\tt \verb|  |DEVICE=SFS.SYS SILENT PROMPT="E$\backslash$sNTER $\backslash$sC$\backslash$sODE:" MOUNT=530A17FD}

The initial ``E'' is displayed in uppercase, then the first {\tt $\backslash$s} shifts the
``NTER'' to lowercase, the second {\tt $\backslash$s} shifts the ``C'' back to uppercase, and the
final {\tt $\backslash$s} shifts the remaining ``ODE:'' to lowercase.

The {\tt PROMPT=} option also recognises a number of other escape codes which may
be used to specify characters which cannot be directly entered into the
CONFIG.SYS file such as quote marks, tabs, and line breaks.  These are based on
the ones used in the C programming language, and are as follows:

%    Newline     = \n        Quote mark  = \"        Bell    = \a
%    Tab         = \t        Backspace   = \b        Escape  = \e
\begin{center}
\begin{tabular}{|l|l|}
\hline
	Character  & Escape code \\
\hline
	Newline    & $\backslash${\tt n}\\
	Quote mark & $\backslash${\tt "}\\
	Bell       & $\backslash${\tt a}\\
	Tab        & $\backslash${\tt t}\\
	Backspace  & $\backslash${\tt b}\\
	Escape     & $\backslash${\tt e}\\
\hline
\end{tabular}
\end{center}

For example to print a line break as part of a prompt, the escape code $\backslash${\tt n} may
be used, allowing prompts to be split over multiple lines, or simply to have
blank lines as part of the prompt.  An extended form of the above prompt, split
over two lines, could be given as:

{\tt \verb|  |DEVICE=SFS.SYS SILENT PROMPT="Network logon$\backslash$nPlease enter password\\
     \verb|  |:" MOUNT=530A17FD}

which would be printed as:

{\tt \verb|  |Network logon\\
     \verb|  |Please enter password:}

The $\backslash${\tt e} escape code can be used in combination with an ANSI driver to allow
special actions such as cursor positioning and colour and text attribute
control.  Most of the useful escape sequences begin with $\backslash${\tt e[}, corresponding
to the ``ESC ['' combination.  These codes only work if an ANSI driver is loaded
by specifying

\verb|  |{\tt DEVICE=ANSI.SYS}

or some other ANSI-compatible driver in CONFIG.SYS.  Some of the possible codes
are:

\begin{center}
\begin{tabular}{|l|p{215.4pt}|l|}
\hline
  ANSI sequence   & Action                                    & Default\\
\hline
  $\backslash${\tt e[$row$;$column$H} & Move the cursor to $(row, column)$        & $(1,1)$\\
  $\backslash${\tt e[$row$;$column$f} & Move the cursor to $(row, column)$        & $(1,1)$\\
  $\backslash${\tt e[$row$d}          & Move the cursor to $row$                  & 1\\
  $\backslash${\tt e[$column$G}       & Move the cursor to $column$               & 1\\
  $\backslash${\tt e[$count$A}        & Moves the cursor up $count$ rows          & 1\\
  $\backslash${\tt e[$count$B}        & Moves the cursor down $count$ rows        & 1\\
  $\backslash${\tt e[$count$C}        & Moves the cursor right $count$ columns    & 1\\
  $\backslash${\tt e[$count$D}        & Moves the cursor left $count$ columns     & 1\\
  $\backslash${\tt e[2J}           & Clears the screen and homes the cursor & \\
  $\backslash${\tt e[K}            & Clears from the cursor position to the
                                     end of the current line & \\
  $\backslash${\tt e[M}            & Clears the entire line & \\
  $\backslash${\tt e[s}            & Saves the current cursor position & \\
  $\backslash${\tt e[u}            & Restores the previously saved cursor
                                     position & \\
  $\backslash${\tt e[$count$b}     & Repeat following character $count$ times  & 1\\
  $\backslash${\tt e[$attr;\dots;attr$m} & Set screen attributes based on $attr$.
                    Possible values for the $attr$ settings
                    are:

	{\small \hyphenation{ fore-ground back-ground }
	\begin{tabular}{|r|p{73.5pt}|r|p{75.5pt}|}
	\hline 
                    30 & Black foreground   & 40 & Black background\\
                    31 & Red foreground     & 41 & Red background\\
                    32 & Green foreground   & 42 & Green background\\
                    33 & Yellow foreground  & 43 & Yellow background\\
                    34 & Blue foreground    & 44 & Blue background\\
                    35 & Magenta foregr.    & 45 & Magenta backgr.\\
                    36 & Cyan foreground    & 46 & Cyan background\\
                    37 & White foreground   & 47 & White background\\
	\hline
	\end{tabular} } & \\
\hline
\end{tabular}
\end{center}

For example to clear the screen and home the cursor before printing the
``Login:'' prompt given previously, the command would be:

\begin{verbatim}
  DEVICE=SFS.SYS SILENT PROMPT=\e[2JLogin: MOUNT=530A17FD
\end{verbatim}

To print the prompt in black on a blue background, the command would be:

\begin{verbatim}
  DEVICE=SFS.SYS SILENT PROMPT=\e[30;44mLogin:\e[37;40
  MOUNT=530A17FD
\end{verbatim}

The order in which these arguments are given is important, since an option only
affects the other options following it.  If the {\tt PROMPT=} option is given after 
the {\tt MOUNT=} option instead of before it, the driver won't use the new prompt 
until after the automount has taken place.  This can be used to allow multiple 
independant prompts when several volumes are mounted, so that in the following 
example:

{\tt \verb|  |DEVICE=SFS.SYS SILENT PROMPT="Local server logon:\ " MOUNT=C0EDBABE\\
     \verb|  |PROMPT="Printer server logon:\ " MOUNT=2A1102D3}

the prompt {\tt "Local server logon:\ "} would be used for the first volume to be
mounted and the prompt {\tt "Printer server logon:\ "} would be used for the second 
volume to be mounted.  The {\tt PROMPT=} setting applies for all further mounts 
until another {\tt PROMPT=} option is given.

\subsection{Changing the Mount Read/Write Access Status}

Write access to a mounted volume can be enabled or disabled in the same manner 
as using the {\tt mountsfs +r} and {\tt mountsfs +rw} options would using the
{\tt READONLY} and {\tt READWRITE} options (more information on read-only access to SFS 
volume is given in the section ``Mounting an SFS Volume'' above).  For example to 
mount the volume used in the previous example read-only the command would be:

{\tt \verb|  |DEVICE=SFS.SYS READONLY MOUNT=530A17FD}

Like the other options which affect the mounting of volumes, the {\tt READONLY} or 
{\tt READWRITE} option must be given before the {\tt MOUNT=} which they are to affect.  
These options apply for all further automounts until another {\tt READONLY} or 
{\tt READWRITE} option is given.  For example to mount the first volume in the 
previous example read-only and the second one with normal write access the 
command would be:

{\tt \verb|  |DEVICE=SFS.SYS READONLY MOUNT=530A17FD READWRITE MOUNT=4850414B}

\subsection{Mounting Volumes as Non-Removable}
 
Since SFS volumes may be unmounted at any point through a hotkey unmount, an
auto-unmount timeout, or through use of the mountsfs program, the driver
reports them to the operating system as being removable volumes.  This means
that the system won't become confused when disk volumes suddenly cease to exist
after an unmount.

Unfortunately some software, while handling removable volumes perfectly well,
prefers to work with non-removable or fixed volumes.  An example of this is
Windows, which won't display volume labels for removable volumes.  Disk
buffering and cacheing for fixed volumes is also somewhat better since the
operating system doesn't have to worry about the volume being unmounted
suddenly, leaving it with nothing to write buffered data to.

The SFS driver allows volumes to be mounted as fixed volumes through the use of
the {\tt FIXED} keyword.  By default, or if the {\tt REMOVABLE} keyword is used, they are
mounted as removable volumes.  Volumes mounted as fixed volumes must be mounted
at system startup and will remain mounted until the system is either restarted
or powered down.  Hotkey, timed, and mountsfs unmounts will {\bf not} affect volumes
mounted in this manner --- they will remain mounted at all times.  For example to
mount the volume used in the previous example as a fixed, non-removable volume
the command would be:

{\tt \verb|  |DEVICE=SFS.SYS FIXED MOUNT=530A17FD}

Like the other options which affect the mounting of volumes, the {\tt FIXED} or
\linebreak 
{\tt REMOVABLE} options must be given before the {\tt MOUNT=} which they are to affect.
These options apply for all further mounts until another {\tt FIXED} or {\tt REMOVABLE}
option is given.  For example to mount the first volume in the previous example
as a fixed volume and the second one as a standard removable one the command
would be:

{\tt \verb|  |DEVICE=SFS.SYS FIXED MOUNT=530A17FD REMOVABLE MOUNT=4850414B}

\subsection{Setting the Auto-unmount Timeout value}

The auto-unmount timeout value functions just like the mountsfs {\tt timeout=}
option, and is used to tell the SFS driver to unmount a volume automatically if
it has not been accessed for a certain amount of time.  The time until the
volume is automatically unmounted can be set with the {\tt TIMEOUT=} option, which 
is used to specify the delay in minutes until the unmount takes place.  This 
option can only be used in conjunction with the {\tt MOUNT=} option, and by default 
no auto-unmount timer is set.

The use of this option is only necessary if the volumes to be mounted have no 
timeout values associated with them, either by mksfs when the volume is created 
or by chsfs at a later point in time.  However, if required, the {\tt TIMEOUT=} 
option can also be used to override any existing timeout settings for the 
volume.  In order to return to the default timeout settings, the
{\tt TIMEOUT=DEFAULT} option may be used.  This sets the timeout of any volumes
mounted after this point to either the value associated with the volume, or
none at all if the volume has no timeout setting.  To force the timeout setting
to be disabled, the {\tt TIMEOUT=NONE} option may be used, which ensures no timeout 
is set for any volumes automounted after this point.  As before, this option holds 
until another {\tt TIMEOUT=} setting is used.

The timeout value currently set for a volume can be displayed with the
{\tt mountsfs information} command.

Like the other options which affect the mounting of volumes, the {\tt TIMEOUT=} 
option must be given before the {\tt MOUNT=} which it is to affect.  The {\tt TIMEOUT=} 
option applies for all further mounts until another {\tt TIMEOUT=} option is given.

Using the previous mount example, but to have a volume automatically unmounted 
after 15 minutes of inactivity, the command would be:

{\tt \verb|  |DEVICE=SFS.SYS TIMEOUT=15 MOUNT=530A17FD}

The timeout period must be between 1 and 30,000 minutes (this means the upper
timeout limit is around three weeks).  If a timeout value of less than 1 minute
or greater than three weeks is given, mountsfs will exit with the error
message:

{\tt \verb|  |Error: Timeout value must be between 1 and 30,000 minutes}

If no accesses are made to a volume within the given time period, it will be 
automatically unmounted.  Like the case when a hotkey unmount is made, a single 
beep will sound to indicate that the unmount has taken place.  Each volume has
its own timer, so that different volumes can be given different lengths of time
before they unmount, or no auto-unmount time at all.  This is useful when, for
example, one volume containing highly sensitive information needs to have a
very short timeout, while another volume containing less secret information can
have a much longer timeout.  For example the two volumes used in the previous
example might be mounted as follows:

{\tt \verb|  |DEVICE=SFS.SYS TIMEOUT=10 MOUNT=530A17FD TIMEOUT=30 MOUNT=4850414B}

in which the first volume is given a short timeout of only 10 minutes while the
second volume, which presumably holds less critical information, is given a
longer timeout of half an hour.  If the volumes already have a timeout setting
and the {\tt TIMEOUT=} option is being used to override it, the default behaviour
of using the setting associated with the volume may be restored with the
{\tt TIMEOUT=DEFAULT} option.  For example if, in the previous example, the default 
timeout setting for the second volume were to be used instead of overriding it 
with a 30-minute timeout, the volumes would be mounted as follows:

{\tt \verb|  |DEVICE=SFS.SYS TIMEOUT=10 MOUNT=530A17FD TIMEOUT=DEFAULT\\
     \verb|  |MOUNT=4850414B}

This would mount the first volume as before, and the second volume with
whatever timeout was set for it by mksfs or chsfs.  If no timeout at all is
required for the second volume, the volumes would be mounted as follows:

{\tt \verb|  |DEVICE=SFS.SYS TIMEOUT=10 MOUNT=530A17FD TIMEOUT=NONE\\
     \verb|  |MOUNT=4850414B}

\subsection{Enabling Fast Direct Disk Access Modes}

SFS supports a number of faster disk access modes, which would normally be
specified when the volume is created with mksfs, or set at a later date with
the {\tt chsfs newaccess=} command.  However it may be desirable to override these
settings when volumes are mounted.  This can be done with the {\tt FAST=} option, 
which takes as an argument the fast access mode given by the {\tt mksfs -c}
command, or 0 to specify the normal, somewhat slower access mode.  The access
mode currently set for a volume can be displayed with the {\tt mountsfs
information} command.

For example if the volume in the previous example was created with no fast
access mode set, but it was later discovered that it could be accessed with
fast access mode\ 1, the mount command would be:

\verb|  |{\tt DEVICE=SFS.SYS FAST=1 MOUNT=530A17FD}

The use of this option is only necessary if the volumes to be mounted have no 
fast access mode associated with them, either by mksfs when the volume is
created or by chsfs at a later point in time.  However, if required, the
{\tt FAST=} option can also be used to override any existing fast access mode
settings for the volume.  In order to return to the default access mode
settings, the {\tt FAST=DEFAULT} option may be used.  This sets the access mode of
any volumes mounted after this point to the mode normally associated with the 
volume.  For example if, in the previous two-volume mount example, the default 
access mode setting for the second volume were to be used instead of overriding 
it with an access mode of 1, the volumes would be automounted as follows:

\begin{verbatim}
  DEVICE=SFS.SYS FAST=1 MOUNT=530A17FD FAST=DEFAULT MOUNT=4850414B
\end{verbatim}

This would mount the first volume as before, and the second volume with
whatever access mode was set for it by mksfs or chsfs.

If a certain access mode is required in order to access a volume (for example
some volumes on SCSI drives can only be accessed via SCSI access methods) then
SFS will always use the appropriate access mode and ignore the current setting
of the {\tt FAST=} option.

Like the other options which affect the mounting of volumes, the {\tt FAST=} option 
must be given before the {\tt MOUNT=} which it is to affect.  The {\tt FAST=} option 
applies for all further mounts until another {\tt FAST=} option is given.

\section{Changing the Characteristics of an SFS Volume}

Once an SFS volume has been created, various characteristics of the volume and
the entire volume itself can be altered using the chsfs program.  This allows
the SFS volume password, volume name, disk access mode, and auto-unmount 
timeout to be changed, allows SFS volumes to be quickly deleted, and allows the 
reversion of SFS volumes to their original unencrypted form.

The chsfs program is run in the following manner:

{\tt \verb|  |chsfs [newpass] [newvol={\em new volume name}] [newtimeout=$timeout$]\\
\verb|        |[newaccess={\em new access mode}] [delete] [convert]\\
\verb|        |[vol={\em volume name}] [$drive$]}

Since all arguments are named, they can be given in any order.  The order shown
here is merely an example.

In general the volume name would be specified with the {\tt vol=} option.  For
example if the volume name was ``Secure disk volume'' then the command would be:

{\tt \verb|  |chsfs $command$ vol=secure}

The volume name can be in upper or lower case, and the full name need not be
given.  chsfs will match whatever part of the name is given to any SFS
volume names found until it finds a match.

Alternatively, if the SFS volume to be accessed is on a removable disk, the
drive letter can be specified instead of the volume name.  For example if the
disk drive was A: then the command would be:

{\tt \verb|  |chsfs $command$ a:}

In order to find all available SFS volumes on all disks, the {\tt mountsfs info}
option can be used as outlined in the section ``Mounting an SFS Volume'' above.

The basic characteristics of the SFS volume can be changed with the {\tt newpass},
{\tt newvol}, {\tt newaccess}, and {\tt newtimeout} commands, which set a new password, 
new volume name, new disk access mode, and new auto-unmount timeout respectively.  
These commands can each be used individually, or two, three, or even all four 
may be used together (although they can't be used in conjunction with the 
{\tt delete} or {\tt convert} options).  Their usage is in general similar to their use 
with mksfs.  

\begin{itemize}

\item {\tt newpass} takes no arguments and will prompt for the original password and 
    then the new password, after which it will change the volume password from the 
    original to the new one. 

\item {\tt newvol} takes as an argument the new volume name. 

\item {\tt newaccess} takes as an argument the fast disk access mode obtained by
    running the mksfs program with the {\tt -c} option, with mode 0 being the
    default, slower access mode. 

\item {\tt newtimeout} takes as an argument the auto-unmount timeout setting in
    minutes, or `none' to clear the auto-unmount timer setting for this volume.

\end{itemize}

Since chsfs makes changes to the header record of an encrypted volume, some
anti-virus programs may print a warning about the boot sector of the volume
being changed (despite the fact that the volume is quite clearly not an MSDOS
filesystem).  This warning can be ignored.

As an example, to change the name of the SFS volume ``Personal data'' to 
``Letters'' and the auto-unmount timer setting to 30 minutes, the command would
be:

{\tt \verb|  |chsfs vol=personal newvol=Letters newtimeout=30}

If the newpass option is used, chsfs will first ask for the old poassword:

{\tt \verb|  |Please enter old password (10...100 characters), [ESC] to quit:}

After verifying that the password is correct, chsfs will ask for the new
password:

{\tt \verb|  |Please enter new password (10...100 characters), [ESC] to quit:}

Like mksfs, chsfs will then ask for this password a second time for safety.
Before updating the volume information, chsfs will perform the same
multiple-overwrite operation used by the {\tt delete} option of chsfs (see below)
to erase the original volume header, which is based on the old password.  This
ensures that no trace of the original disk access information remains before it
is replaced by the new access information.

Once the details for the new volume name, auto-unmount timeout, access mode, or 
password have been obtained and the changes made to the volume, chsfs will 
display a message indicating the changes made.  For the above example the 
message would be:

{\tt \verb|  |Volume characteristics successfully updated.

     \verb|  |The new volume name is `Letters'.\\
     \verb|  |The new auto-unmount timeout is set to 30 minutes.}

Note that chsfs doesn't perform the checking for duplicate or nonexistant
volume names and the checking for correct functioning of different disk access 
modes which mksfs does.  This is to allow the safe choices forced by mksfs to 
be subsequently overridden using chsfs if required\footnote{
%Footnote [1]:
              This makes the (possibly incorrect) assumption that the chsfs
              user knows what they are doing.
}.

Changes to the SFS volume itself are made using the {\tt convert} and {\tt delete}
commands.  {\tt convert} converts a volume back to its original unencrypted form,
and {\tt delete} deletes it entirely, leaving behind what appears to the operating
system as an unformatted disk filled with random noise.

Since converting or deleting a volume while it is mounted is rather dangerous,
chsfs checks whether the volume to be converted or deleted is currently
mounted.  If it is mounted and removable, it will prompt:
{\small
\begin{verbatim}
  Warning: This volume is currently mounted. Do you wish to unmount it
           and continue [y/n]
\end{verbatim}
}
At this point a response of `Y' will continue and a response of `N' will exit
the program.  If a `N' response is entered, the volume can be unmounted using
mountsfs or the quick-unmount hotkey before chsfs is re-run.  If the volume has
been mounted as a fixed, non-removable volume, chsfs will exit with the error
message:
{\small
\begin{verbatim}
  Error: This volume has been mounted as a non-removable volume and cannot
         be unmounted. In order for chsfs to be able to work with it, change
         the CONFIG.SYS entry for the SFS driver and reboot the machine.
\end{verbatim}
}
The delete option will first print the name and creation date of the SFS volume
to be deleted.  At this point the exact name and date of the volume should be
checked to ensure that this is indeed the one to be deleted.  In this example
the volume information will be displayed as:

{\tt \verb|  |Encrypted volume is `Incriminating evidence', created 04/11/93}

chsfs will now prompt for the password in the usual manner.  It uses this to
check that access to the volume is legitimate, and is needed for chsfs to
acquire various pieces of information it needs to perform the deletion.  The
program will then prompt:
{\small

\begin{verbatim}
  Warning: The deletion operation will permanently destroy all data on this
           volume. Are you sure you want to continue with the deletion [y/n]
\end{verbatim}

}
At this point a response of `Y' will continue and a response of `N' will exit
the program.

If chsfs is told to continue, it will perform multiple overwrite passes over
the SFS volume header (which contains all the information needed to access the
volume), printing a progress report as it performs the overwriting:

{\tt \verb|  |Overwriting: Pass 1}

In total chsfs will perform 30 separate overwrite passes which have been
selected to provide the best possible chances of destroying data for various
disk encoding schemes (the exact details are given in the section ``Deletion of
SFS Volumes'' below).  Once the multiple overwrites have completed, chsfs will
print an informational message about the deletion operation:

{\tt \verb|  |Encrypted volume `Incriminating evidence' has been destroyed}

If the volume is on a fixed disk, you may wish to reboot your machine to make
the newly-deleted volume visible to DOS.  Volumes on floppy disks will
automatically be visible.  Since the disk volume is now filled with random
garbage, it will need to be formatted in the same way an unformatted disk would
be before it can be used by DOS.

The convert option will, like the delete option, first print the name and
creation date of the SFS volume to be converted.  At this point the exact name
and date of the volume should be checked to ensure that this is indeed the one
to be converted.  In this example the volume information will be displayed as:

{\tt \verb|  |Encrypted volume is `Disk data', created 07/12/93}

chsfs will prompt for the encryption password exactly as mksfs did when it
originally created the SFS volume, and will then prompt:
{\small

\begin{verbatim}
  Warning: You are about to convert this volume from an encrypted SFS one to
           a normal DOS one.  Are you sure you want to continue with the
           conversion [y/n]
\end{verbatim}

}
At this point a response of `Y' will continue and a response of `N' will exit
the program.

Like mksfs, chsfs will then begin converting the disk.  As it processes the
volume, it prints a progress bar going from 0\% complete to 100\% complete.  The
conversion process will take a few minutes on most disks, and is somewhat
slower than a standard disk formatting procedure which only writes a very small
amount of data to the start of the disk and scans for bad sectors, whereas 
chsfs has to read, decrypt, and write the entire disk volume.

As the conversion progresses, the progress bar will gradually fill up until it
shows that the conversion is complete.  Once this has finished, chsfs will
display the message:

{\small \tt \verb|  |Encrypted volume `Disk data' has been converted to a normal DOS volume.}

The converted volume is now ready to be used as a normal DOS disk again. If the
volume is on a fixed disk, DOS will still think it is an encrypted SFS one
rather than a normal DOS one.  It is recommended that you reboot your machine
at this point to clear any memories of the old volume from the system, as DOS
will not be able to see the converted volume until the reboot takes place.  As
a reminder, chsfs will display:

{\tt \verb|  |You may wish to reboot your machine to update the status of the\\
     \verb|  |volume, which will become available as a standard DOS disk.}

before exiting.  If the volume is on a removable disk, no reboot is necessary
and chsfs will simply print:

{\tt \verb|  |The volume is now available as a standard DOS disk.}

%Footnote [1]: This makes the (possibly incorrect) assumption that the chsfs
%              user knows what they are doing.

\section{Sharing SFS Volumes Between Multiple Users}

At times it may be necessary to share a single encrypted SFS volume between
multiple users.  For instance several individuals may require access to a
volume containing confidential business correspondence as part of their
day-to-day duties.  Usually this would require using a common password which is
known to every member of the group of people who require access.  The need to
share passwords is a serious weakness, as the inability to choose individual,
unique passwords increases the chances that a simple, easy-to-remember (and
easy-to-guess) password is chosen, or that at least one person writes it down
if it is too hard to remember.

SFS solves this problem by allowing each member of the group access to an
encryped volume under their own individual password.  The allocation of access
rights to a volume is controlled by an administrator who can grant or revoke
access as required.  The administration process is handled by the adminsfs
program, which is run in the following manner:

{\tt \verb|  |adminsfs [adduser={\em user name}] [deluser={\em user name}] [chuser={\em user name}]\\
\verb|           |[showuser={\em user name}] [showall] [validfrom={\em DDMMYY}]\\
\verb|           |[validto={\em DDMMYY}] [userfile={\em user file}]}

Since all arguments are named, they can be given in any order.  The order shown
here is merely an example.

[!!!! That's all there is at the moment.  adminsfs is still being checked
      out by beta-testers and parts of it are still under review.  If anyone
      has any suggestions for it, let me know !!!!]

\section{Creating Compressed SFS Volumes}

Creating a compressed drive inside an SFS volume provides, apart from the usual
benefit of increasing the apparent disk space, some additional security against
an attack by breaking up the very regular standard filesystem structure
containing large quantities of known data at known locations into a compressed
filesystem whose structure and contents are much harder to ascertain.
This section contains information on using SFS with Stac Electronic's ``Stacker''
and JAM Software's ``JAM''.

\subsection{SFS and Stacker}

The instructions given here are for Stac Electronics ``Stacker'', although it
should be possible to do the same thing with other reasonably advanced disk
compressors.  Stacker allows the compression of an entire DOS drive, or
compression of any remaining free space on the drive.  Creation of a compressed
Stacker volume involves first mounting the SFS volume on which Stacker is to be
installed, either with the system-startup mount option of the SFS driver or 
with the mountsfs utility.  Stacker should then be installed in the usual 
manner onto the mounted volume.  Under Windows, this involves choosing the 
{\tt Compress} option from the ``Stacker Toolbox'', and under DOS it involves running 
the {\tt stac.exe} program and picking the appropriate option, or using the 
{\tt create.com} program on the drive to be compressed.  Stacker will then 
defragment the drive, ask a few questions, and create the Stacker volume.  When 
the Stacker drive has been created, the appropriate mounting parameters for the 
drive will be added to the STACKER.INI file.

Once the installation has completed, the SFS volume will contain the STACKVOL
file in which Stacker stores the compressed disk data.

The Stacker drive can then be mounted in two ways, either from CONFIG.SYS onto
an SFS volume mounted at system startup, or at a later point (which, however, 
means that it loads an extra copy of the environment variables).  It is also 
possible to load the driver without activating a compressed drive by removing 
the specification for the drive to be mounted from the STACKER.INI file (this 
is normally used for floppies, but works for SFS as well since Stacker treats 
SFS volumes as a removable drive).  The drive can then be mounted at a later 
time with the {\tt stacker {\em drive letter}} command.  This avoids the need to mount 
an SFS volume at startup.  Under DOS 6, Stacker 4.0 loads using a device 
driver, but hooks into DOS like DoubleSpace does (or at least did when it was 
available).  The rest of Stacker is then loaded with the STACHIGH.SYS driver.

As SFS uses whatever drive letters DOS allocates to it, the stacked drive will
take over the drive letter used by the SFS volume rather than swapping drive
letters for the stacked and normal drive as it usually does.  This shouldn't
provide any problems with accessing the drive, as the compressed and encrypted
drive will simply replace the encrypted drive.  However, it will provide
problems at a later point because Stacker uses the ``Mount replaced'' option, in
which Stacker manipulates internal DOS data structures to completely replace
the original SFS drive.  This means that mountsfs can no longer find the
mounted SFS drive for the {\tt status}, {\tt info}, {\tt information}, and {\tt unmount}
commands, although timed unmounts and hotkey unmounts performed by the SFS
driver itself will still work.

\subsection{SFS and JAM}

Using JAM Software's ``JAM'' compressor with SFS is somewhat simpler than using
Stacker, and provides an additional benefit of speeding up effective disk
access times since the high-speed JAM software reduces the amount of data which
must be subsequently encrypted.  Creation of a compressed JAM volume involves
first mounting the SFS volume on which the JAM volume is to be installed,
either with the system-startup mount option of the SFS driver or with the
mountsfs utility.  The compressed volume can then be created as described in
the JAM documentation with the JCREATE utility.

Once the creation of the compressed disk volume has completed, it can be
mounted by loading the JAM.SYS driver via the CONFIG.SYS file, and mounting the
JAM volume using the JMOUNT utility, either onto an SFS volume mounted at
system startup by running JMOUNT from the CONFIG.SYS file, or at a later point
by running JMOUNT from the command line.  This avoids the need to mount an SFS
volume at startup.

Unlike Stacker, JAM does not mess with DOS drive letters, allowing both the SFS
volume and the JAM volume it contains to be accessed as normal.  JAM is
available for FTP from garbo.uwasa.fi and all garbo mirrors as
/pc/arcers/jam119sw.zip.

\section{WinSFS - Using SFS with Windows}

WinSFS is a prototype of the Windows version of SFS, and currently runs as a
front-end for mountsfs, which means that the mountsfs program must be either in
the DOS path or in the Windows directory for WinSFS to work.  WinSFS also needs
the Visual Basic library VBRUN200.DLL in order to run.  This file is publicly
available from a number of sources.

When run, WinSFS will display a window containing a list of SFS volumes
available to be mounted, a list of currently mounted volumes, and an icon bar
which is used to control WinSFS.  These icons perform the following functions:

\begin{center}
\begin{tabular}{|l|l|}
\hline
  Icon              & Function\\
\hline
  Cross icon        & Exit WinSFS\\
  Disk icon         & Mount an SFS volume\\
  Crossed disk icon & Unmount an SFS volume\\
  Information icon  & Display detailed information on an SFS volume\\
  Write icon        & Enable read/write access on an SFS volume\\
  Crossed write icon& Enable read-only access on an SFS volume\\
\hline
\end{tabular}
\end{center}

\subsection{Mounting a Volume with WinSFS}

To mount an SFS volume, click on the volume name in the ``Available volumes''
window, and then click on either the ``Mount volume'' icon or the ``Mount'' button
(eventually this function will also be available by dragging the volume name
and dropping it into the ``Mounted'' list).  WinSFS will ask for the volume
password, and then mount the volume.  Once the volume is mounted, its name will
disappear from the ``Available volumes'' list and appear in the ``Mounted'' list.

\subsection{Unmounting a Volume with WinSFS}

To unmount an SFS volume, click on the volume name in the ``Mounted'' window, and
then click on either the ``Unmount volume'' icon or the ``Unmount'' button
(eventually this function will also be available by dragging the volume name
and dropping it into the ``Available volumes'' list).  WinSFS will unmount the
volume, and its name will disappear from the ``Mounted'' list and appear in the
``Available volumes'' list.

\subsection{Getting Information on a Volume with WinSFS}

To get detailed information on a volume, click on its name, and then either
click the right mouse button, or select the ``Information'' icon.  This will
bring up a window giving extra information on the volume such as the creation
time, serial number, size, and mount identifier.

\subsection{Setting a Volume's Read/Write Access with WinSFS}

To change the read/write status of an SFS volume, click on its name in the
``Moun\-ted'' window, and then click on either the ``Read-only'' or ``Read/write'' icon
in the icon bar to change its access status.

\section{Command Summary}

This section serves as a quick-reference for the options available with the
various SFS programs.  The available options for mksfs, mountsfs, chsfs, and
adminsfs are:

\begin{itemize}

\item MakeSFS - Make Secure Filesystem

  \begin{tabular}{l p{222.4pt} }

  -c                         & Perform a confidence test on the volume to be
                               encrypted without actually encrypting it\\

  -o                         & Override the disk boot record sanity check. This may be
                               necessary for some unusual disk formats\\

  -t                         & Test the integrity of the MDC/SHS encryption code
                               used in SFS\\

  -e                         & Display an extended error code if an error occurs.  This provides
                               extra information on the nature of some errors\\

  multiuser                  & Allow multiuser access on the volume to be created\\

  fastaccess=$mode$   & Specify the fast disk access mode (as given by the
                        output of the {\tt -c} option) to use for this volume\\
  timeout=$timeout$   & Specify the auto-unmount timeout for this volume\\
  wipe                & Wipe the original data before overwriting it with
                        encrypted data (this option is very slow)\\

  vol={\em volume name}      & Specify the name of the volume to be created\\

  serial={\em serial number} & Specify the serial number of the volume to be created\\

  {\em drive letter}         & Specify the letter of the drive to create the
                               encrypted volume on\\
  \end{tabular}

\item MountSFS - Mount Secure Filesystem
\nopagebreak

  \begin{tabular}{p{87pt} p{225pt} }

  +r                    & Mount the encrypted volume with read-only access\\

  +rw                   & Mount the encrypted volume with read/write access (default)\\

  info                  & Show brief information on all available SFS volumes\\

  information           & Show detailed information on all available SFS volumes\\

  status                & Show information on mounted volumes only\\

  unmount               & Unmount the volume\\

  hotkey=$hotkeys$      & Set the quick-unmount hotkey combination\\

  timeout=$timeout$     & Set the auto-unmount timer value in minutes\\

  user=$username$       & Specify the user name for a volume with multiuser access\\

  userfile=$filename$   & Specify the path to the information file associated with
                          a volume which allows multiuser access\\

  vol={\em volume name} & Specify the name of encrypted volume to mount\\

  {\em drive letter}    & Specify the drive letter of the volume to mount\\
                        & (For volumes on floppy disks only)\\
  \end{tabular}

\item ChangeSFS - Change Secure Filesystem

  \begin{tabular}{l p{209.2pt} }

  newpass                   & Set a new volume password\\

  newvol={\em volume name}  & Specify the new volume name\\

  newaccess={\em access mode} & Specify the new fast disk access mode\\

  newtimeout=$timeout$        & Specify the new auto-unmount timeout\\

  delete                    & Delete SFS volume\\

  convert                   & Convert volume back to unencrypted form\\

  vol={\em volume name}     & Specify the name of the encrypted volume to change\\

  {\em drive letter}        & Specify the drive letter of the volume to change\\
                            & (For volumes on floppy disks only)\\
  \end{tabular}

\item AdminSFS - Administrate SFS User Database

  \begin{tabular}{l p{208.6pt} }

  adduser={\em user name} & Add a new user with the given name to the database\\

  deluser={\em user name} & Remove user with the given name from the database\\

  chuser={\em user name}  & Change user database entry for the named user\\

  showuser={\em user name}& Show access information for a given user\\

  showall                 & Show access information for all users\\

  validfrom=$DDMMYY$      & Set date after which access for a user is allowed\\

  validto=$DDMMYY$        & Set date at which a users access expires\\

  userfile=$filename$     & Specify the path to the user information file\\

  \end{tabular}

\end{itemize}

\section{Incompatibilities}

Over the years a variety of strange hardware and software setups have been
created in order to get around some of the shortcomings of the PC hardware and
DOS (and occasionally other operating systems) software.  Since SFS accesses
the disk at a level below that normally used by the operating system, it will
bypass special options like compressed volumes and non-local networked drives,
and won't recognise nonstandard hardware like drives with more than 1024
cylinders which require special software patches in order to work with DOS.  For 
example, SFS will recognise the uncompressed volumes used by Stacker and
DoubleSpace, and JAM, but won't see the compressed volumes as these are an 
illusion created in software and visible only to DOS.  It is therefore not 
possible to encrypt compressed volumes (there would be very little point, as 
encryption would render the data completely uncompressible), although it is 
possible to create a compressed volume inside an encrypted volume (this is 
covered in the section ``Creating Compressed SFS Volumes'' above).

\subsection{Checking for Problems with mksfs}

If your system has an unusual setup, or if you're worried about what SFS may
do, you can use a special option with the mksfs command to perform a check on
the drive which is to be encrypted.  This option also bypasses a number of the
usual checks SFS performs relating to duplicate volume names, anonymous
volumes, and so on, to allow all types of volume arrangements to be checked.

If the {\tt -c} option is specified along with the drive letter, mksfs will (if the
volume in question is a fixed disk) first display technical information on all
available fixed disk volumes, so that the command:

{\tt  \verb|  |mksfs -c e:}

would produce the following output:
{\small

\begin{verbatim}
  Drive partition information follows:

  Ph Bt Dr Cyl. Head Sec. Cyl. Head Sec.  Size  ID Type
  -- -- -- ---- ---- ---- ---- ---- ---- ------ -- ----
   0  N  C    0    1    0  379   15   39 121600 06 DOS (16-bit FAT, >= 32M)
   0  Y  -  380    0    0  383   15   39   1280 0A OS/2 boot manager
   0  N  D  384    1    0  594   15   39  67200 06 DOS (16-bit FAT, >= 32M)
   0  N  E  595    1    0 1022   15   39 136640 06 DOS (16-bit FAT, >= 32M)
                                                  This would be the SFS disk
  06  N  -    0    1    0  442   63   31 452608 07 OS/2 HPFS
  06  N  F  443    0    0  571   63   31 131072 06 DOS (16-bit FAT, >= 32M)
  06  N  G  572    0    0  872   63   31 307200 06 DOS (16-bit FAT, >= 32M)
\end{verbatim}

}
This is only displayed for fixed disks, as floppy disks don't contain this 
information.  The values in the various columns are Ph = physical drive number, 
Bt = bootable flag, Dr = DOS drive letter, Cyl,Head,Sec = partition start, 
Cyl,Head,Sec = partition end, Size = size in kbytes, ID = partition ID byte, 
and Type = partition type.  The proposed SFS partition will be marked as such.  
The drive with an apparent \hbox{2-digit} physical drive number is a SCSI drive which
isn't accessible through the BIOS; the first digit is the SCSI target ID, the
second digit is the logical unit number.  If you don't know what these values 
mean, don't worry---this option is mainly useful in providing technical 
information for those who want it.

Once all drives have been checked, more specific information on the actual
volume in question is displayed:

\begin{verbatim}
  Volume will be checked on fixed drive E:
  This drive has a capacity of 136.6 MB and is labelled `Data disk'
  Are you sure you want to check this volume [y/n]
\end{verbatim}

As with the usual mksfs process, typing `Y' will continue with the volume check
and typing `N' will exit.  If you choose to continue, mksfs will first perform
an initial disk confidence test which consists of some general checks on the
volume layout to make sure its format is valid, and will then perform a read
confidence test in which it reads random disk blocks and compares them with the
data reported by the operating system.  If any errors are encountered, it will
print a diagnostic message before continuing.  If all is OK, the sequence of
messages will be:

{\tt
\verb|  |Performing disk confidence test\dots \\
\verb|  |Performing read confidence test\dots \\
\verb|  |{\em various test-in-progress messages} \\
\verb|  |Confidence test successfully concluded
}

If there are problems, the diagnostic message will give more information on the
nature of the problem.  After the basic tests have completed, mksfs may display
specific information about the particular drive on which the SFS volume is to
be created, and ask whether additional tests should be made to determine
whether use of the fast access modes supported by the SFS driver is possible.
A typical message would be:
{\small
\begin{verbatim}
  This drive is a WDC AC2420 with a multi-sector 256K buffer, and appears
  to support the high-speed direct access mode which SFS is capable of.
  mksfs will now test whether this is indeed true.  Are you sure you want to 
  perform the test [y/n]
\end{verbatim}
}
with the exact text depending on the drive type.  At this point a response of
`Y' will run the extended tests, and a response of `N' will exit the program.
The extended tests are similar to the previous tests, and display the same
messages if problems are found.

If problems are detected, mksfs will display:
{\small
\begin{verbatim}
  This drive does not appear to support the high-speed direct-access mode
  used by SFS.  The default slower access mode will be used.
\end{verbatim}
}
Otherwise, the message:
{\small
\begin{verbatim}
  This drive supports the high-speed direct-access mode used by SFS.
  You can enable use of this mode by specifying the `fastaccess=1' option
  when mksfs is run, or enable it at a later date using the `newaccess=1'
  option in chsfs.
\end{verbatim}
}
will be displayed.  If using Windows 3.1 with 32-bit disk access, this access
mode should not be used, as Windows uses the same mode and will detect SFS disk
accesses and block them.

If the drive is a SCSI device which needs a device driver to work with DOS, SFS
will access it directly as a SCSI device rather than simply a standard disk
drive.  SFS will work with drives accessed through ASPI (Adaptec SCSI
Programming Interface) and CAM (Common Access Method) drivers.  ASPI drivers
come with most SCSI drive controllers or can be purchased seperately.  The CAM
driver ASPICAM.SYS is available from NCR\footnote{
%Footnote [1]:
	       \hspace*{5pt} It is also available from the NCR FTP site ftp.ncr.com as part of
               the archive /pub/ncrchips/scsi/drivers/dos\_win/dos\_drv.zip.
}.

If direct SCSI access is possible, mksfs will display additional information on the drive,
typically:
{\small
\begin{verbatim}
  This drive is a MAXTOR XT-8760S SCSI drive attached to an ADAPTEC AHA-1x4x
  host with host ID 0,target ID 2, logical unit number 0. SFS will access it
  as a SCSI device rather than a normal hard drive.
\end{verbatim}
}
If mksfs is used to create an encrypted volume on this drive, it will
automatically access it with a SCSI access mode (equivalent to {\tt fastaccess=2})
without having to be told about it.

Once all tests have finished, mksfs will display the message:

\verb|  |{\tt Confidence test successfully concluded}

or an error count if errors occurred.  In either case, mksfs will exit after 
the tests have concluded without creating the encrypted volume.  If used with 
the {\tt -c} option, mksfs will never modify any information on disk, whether the 
tests are successful or not.  This is important, as it allows a confidence test 
to be performed before an encrypted volume is created.

\subsection{Problems with Windows}

The timed auto-unmount option and quick-unmount hotkey option are generally
unavailable under Windows as Windows disables the standard keyboard and timer
handling when it runs\footnote{
%Footnote [2]:
              Windows virtualizes the keyboard and timer interrupts and locks
              out SFS.  Although it is possible to bypass this, it must be done
              from within Windows itself, which is not possible for a device
              driver like SFS.
}.  In order to unmount a volume from within Windows,
the mountsfs program must be run explicitly.  The one exception to this rule is
that if a quick-unmount hotkey is set from within a DOS session then it will
remain available (but only within the DOS session) while that particular DOS
session is active.

\subsection{Problems with Other Software}

The Mitsumi CDROM device driver, if installed before another block driver like
SFS, will mistakenly try to use the drive letter allocated to the other driver
as its own one.  There have been reports of other CDROM drivers (in particular
the Sony one) which display similar traits (CDROM drivers are strange beasts
which have rather special requirements).  The DTC SCSI driver has a similar
problem in that it grabs more drive letters than DOS allocates to it, which
means that any block drivers loaded after it will be allocated drive letters by
DOS which are already being used by the SCSI driver.  The solution to this
problem is to make sure that the SFS driver is loaded before any problematic
CDROM or SCSI drivers by placing the {\tt DEVICE=SFS.SYS} line before the one which
loads the CDROM or SCSI driver in the CONFIG.SYS file.

The KEYB driver incorrectly handles the keyboard interrupt, which locks out the
SFS driver's quick-unmount hotkey handling if the {\tt HOTKEY={\em quick-unmount hotkey}} 
option is used at the time the driver is loaded.  If the {\tt HOTKEY=NONE} option
is specified when the SFS driver is installed, and the hotkey is set using
mountsfs after the KEYB driver has been loaded, everything works fine\footnote{
%Footnote [3]: 
		The KEYB driver provides a complete replacement for the BIOS int
              	9h keyboard driver.  KEYB is somewhat peculiar in its keyboard
             	handling, and doesn't coexist well with other keyboard handlers.
             	It also disables interrupts for lengthy periods of time while
              	processing keyboard scan codes.
}.  In
addition, SFS always acts as though the keyboard being used has the default
US-style layout, since the SFS software communicates directly with the keyboard
rather then working through driver software (which hasn't been loaded yet when
SFS is activated).  However since all SFS software performs the same keyboard
handling, this will only be noticed by SFS and should be transparent to the end
user.

Some (now very rare) device drivers and TSR's will destroy the contents of
32-bit registers when they are activated, which means that the data in the SFS
driver will become invalid from one machine instruction to the next.  There
have been reports of older versions of the PC-Kwik cache and Novell's
non-dedicated file server version 2.2 doing this.  A program to detect and
possibly fix this problem is available from garbo.uwasa.fi as
/pc/turbopas/trash.zip.

The Lantastic server software, version 6.0, can cause problems with mksfs.  If
running {\tt mksfs -c} reports errors then the {\tt server.exe} program should be
unloaded before mksfs is used to encrypt a DOS volume, and also before chsfs is
used with the {\tt convert} option.

Some of the Borland software development tools don't handle DOS critical errors
very well (they hang either when the error occurs or soon afterwards).  Since
trying to access a non-mounted volume is treated by DOS as an error, it may
cause programs like the IDE and the debugger to hang\footnote{
%Footnote [4]:
               This is the famous recursive footnote \thefootnote.
}.  Trying to read a 
floppy drive without a disk in the drive, and any other action which causes a 
DOS critical error, can have the same effect.

The Always Technology SCSI manager has a bug which makes use of SCSI devices
with logical unit numbers (LUN's) other than the default value of 0 impossible.
The SFS programs will detect this SCSI manager and avoid using devices with
LUN's other than 0.  In practice this will not be a problem since SCSI devices
normally have the LUN set to 0.

SFS will not work with S\&H Computer Systems' TSX multi-tasking operating
system, which doesn't support some disk utilities, DOS device drivers, and
programs which directly access hardware devices (which pretty well covers all
of what SFS does).

\subsection{Problems with hardware}

Some floppy drive and system BIOS combinations aren't terribly reliable.  It
has been reported that a laptop using the Phoenix 1.01 BIOS gives a multitude
of disk errors when encrypting a disk using mksfs.  The exact error type is
uncertain since the error code returned when the disk access fails is an
undefined value.  The Award 3.03 BIOS when used with some floppy drives also
causes problems, especially with newer versions of DOS (version 6.0 and up),
which may have great trouble reliably writing disks.  Microsoft's suggested
solution to the problem is a BIOS upgrade.

\section{Authentication of SFS Software}

There have been several occasions in the past when fake versions of software
have been distributed.  Sometimes these fake release are even wrapped up in a
nice-looking ``security envelope'' guaranteeing their authenticity.  With
encryption software like SFS it is all too tempting for an opponent to simply
create and distribute a compromised version of SFS rather than try to break the
SFS encryption itself.  In order to avoid any problems in this respect, the
distributed SFS driver and executables are accompanied by a digital signature
which can be used to verify that it is indeed an official version.

In order to check the authenticity of the particular version of SFS, you will
need the PGP encryption package, and my public key, which is included in the
standard PGP distribution.  My key is signed by Philip Zimmermann, the original
author of PGP, and several members of the PGP development team.  First, my key
should be checked for authenticity with the command:

{\tt \verb|  |pgp -kc "Peter Gutmann"}

When it performs the key check, PGP should display the following signatures:
{\small

\begin{verbatim}
 Type bits/keyID     Date    User ID
 pub  1024/997D47 1992/08/02 Peter Gutmann <pgut1@cs.aukuni.ac.nz>
 sig!      E722D9 1992/11/26   Branko Lankester <lankeste@fwi.uva.nl>
 sig!      997D47 1992/10/11   Peter Gutmann <pgut1@cs.aukuni.ac.nz>
 sig!      7C02F9 1992/09/07   Felipe Rodriquez <nonsenso@utopia.hacktic.nl>
 sig!      1336F5 1992/09/05   Harry Bush <Harry@castle.riga.lv>
 sig!      67F70B 1992/09/02   Philip R. Zimmermann <prz@sage.cgd.ucar.edu>
\end{verbatim}

}
There may be other signatures on there, but these are the ones from the PGP
development team and are the most important ones.  Version 2.1 and up of PGP
can, in addition, generate a key fingerprint for a key.  This can be calculated
with the command:

{\tt \verb|  |pgp -kvc "Peter Gutmann"}

PGP should display the following:
{\small

\begin{verbatim}
  pub  1024/997D47 1992/08/02 Peter Gutmann <pgut1@cs.aukuni.ac.nz>
         Key fingerprint = 7C 6D 81 DF F2 62 0F 4A  67 0E 86 50 99 7E A6 B1
\end{verbatim}

}
If the keyID or key fingerprint for my key differs from the one shown above or
the signatures don't check out, then the key is a probably a fake and shouldn't
be trusted.  Assuming the key is in order, the authenticity of the device
driver and the support software can be checked with:

{\tt \verb|  |pgp sfs.sig sfs.sys\\
     \verb|  |pgp $program$.sig $program$.exe}

where sfs.sig and $program$.sig are the digital signatures included with SFS as
distributed.  For example to check the authenticity of the mksfs program type:

{\tt \verb|  |pgp mksfs.sig mksfs.exe}

When it performs the check, PGP should display:

{\tt
\verb|  |Good signature from user Peter Gutmann $<$pgut1@cs.aukuni.ac.nz$>$ .\\
\verb|  |Signature made {\em date of signature}}

If PGP reports a bad signature then the executable shouldn't be trusted.  A
new, hopefully untouched, version can be obtained from any archive site, BBS,
or system which carries the standard SFS distribution, or it can be obtained
directly from the author.

\section{Applications}

Apart from the simple use of SFS for personal and business data privacy, there
are a number of other possible applications for which it can be used.  Some of
these are listed below.

\subsection{Secure Information Exchange}

If a communications channel is available between two systems which use SFS,
confidential data can be transferred from one encrypted SFS volume to the other
by using encryption on the communications channel.  For example a businessman
whose work involves a lot of travel could read data off the SFS volume on his
portable computer and encrypt it as it is sent via modem to his place of work.
At work the data could be decrypted and written to another SFS volume.  The
only time the data is available in unencrypted form is while it is being read
off the SFS volume and re-encrypted for transmission, which represents a
minimal risk as interrupting the transmission will involve stopping the program
which will (presumably) contain error handlers which erase any sensitive
information from memory.

Using a package like PGP (Pretty Good Privacy) or a PEM (Privacy-Enhanced Mail)
implementation in conjunction with SFS allows the secure distribution of 
information through an online service like a computer bulletin board.  The 
online system can retrieve the public key of the person requesting the 
information, read the required data off the SFS volume into the encryption 
program where it is encrypted with the recipients public key, and transmit it.  
At the other end the recipient will decrypt the data with their private key and 
write it straight onto their own SFS volume.  Again, the amount of time in 
which unencrypted data is available is minimal, and properly implemented 
software will destroy any sensitive information if interrupted in any way.

\subsection{Defence in Depth}

With the increasing strength of cryptographic software which is becoming
available to the public, means of compromising encryption security which don't
involve breaking the encryption itself are becoming more and more desirable.
This may involve things like creating fake versions of the encryption software
which have trapdoors in them and planting them in a victim's system, planting
versions which save the entered password somewhere and then restore the
original unaltered copies, or similar tricks.  This means that for maximum
security it is necessary to not only protect the password, but also to protect
the encryption software itself, and any software which interacts with it, and
anything which interacts with that, ad nauseum.  If several encryption and
security packages are used, every one of these must be protected separately.

By using SFS, some degree of protection is offered against malicious
manipulation, since an attacker must first get to the software stored on an SFS
volume in order to compromise it.  Storing other security-related software on
an encryption volume takes it out of the reach of any attack, but makes the SFS
software itself more of a target for an attack.  Eventually this problem can be
reduced somewhat through the use of SFS encryption hardware, which is currently
under (very gradual) development.  Another possibility is to store duplicate
copies of the SFS software on an encrypted volume which is initially mounted
read-only.  The versions on the SFS volume can be compared (using software also
stored on the SFS volume) with the unencrypted versions, and if they are
identical to the reference versions, write access to the volume can be enabled
and the volume used as normal.  Another possibility is to simply store
checksums or digital signatures for the SFS programs on the encrypted volume,
and only write-enable it if the checksums or signatures check out.

\subsection{Using SFS for Virus Protection}

SFS can be used as a form of virus protection for large collections of
computers by using it to create a centralised entry point for all data to the
system.  Consider a company operating 1,000 separate machines.  Normally this
would require 1,000 copies of a virus scanner to be installed and updated every
few months as new viruses appear.  In addition, use of the scanner on every one
of the 1,000 machines would have to be enforced rigorously.

An alternative is to install SFS on each of the machines, and make a policy
that only SFS-encrypted disks will be used within the company.  Then a single
scanner can be installed on a single machine, and all disks brought in from the
outside scanned and encrypted on that machine.

If every computer is initially virus-free, and all disks are SFS-encrypted,
then there are two possible means of attack for a virus.  The first is to
infect a file or disk when it is outside the company.  However as disks
originating from within the company are encrypted, no files (or, indeed,
anything) are visible on them, so there is nothing for a virus to infect (in
fact, DOS won't even recognise the disks as being formatted).  All disks
originating from outside the company have to be processed by the single
controlled computer before they can be used (or SFS will refuse to mount them), 
meaning that any known virus on a non-company disk should be picked up before 
the disk is encrypted.

Alternatively, a boot sector virus could infect an SFS-encrypted disk.
However, if an attempt is made to use the infected disk (which involves
mounting it), the mount will fail as the boot sector will contain the virus
rather than the SFS volume header.  The person who tried to mount the volume
will assume the disk has not been ``converted'' yet, and will bring it to the
machine used for processing the disks.  At this point the virus can be found by
the scanner.

This procedure isn't totally error free.  It won't work if there may already be
viruses present on one or more of the machines before SFS is installed.  In
addition, an SFS disk whose volume header is overwritten by a virus is probably
damaged beyond repair.  However it does provide a reasonable amount of
protection, and has the pleasant side effect of keeping all the company records
secure against unauthorized access attempts.

\input{sfs2.tex}
\input{sfs3.tex}
\end{document}
