basvandorst/cryptography-archive/secude-pem-4/secude/doc/overview.rtf

marginparsep5mmdefparnameparbox[t]3.3cm
