basvandorst/cryptography-archive/winvn-sep-91/WVHLPWIN.RTF

# $ K Posting Window

The posting window allows you to compose and then post an article to the network. See Posting an Article.

Posting Menu Commands
Edit Menu Commands

# $ K Posting Menu Commands

Post completed article
Sends your completed article in this Posting Window to the news server for propagation throughout the network.

Cancel
Closes this window. If you haven't already posted this article, its contents are lost.

# $ K Edit Menu Commands

Undo
Reverses the effects of the most recent change to this window.

Cut
Deletes the selected text and saves it in the clipboard.

Copy
Copies the selected text into the clipboard.

Paste
Retrieves the text most recently copied or cut to the clipboard into the current window. The text is inserted at the current cursor position.

Clear
Deselects all text in the current window.

Select All
Selects all text in the current window. Generally used just prior to a Copy operation to save the contents of the window to the clipboard.

# $ K Mail Window

The mail window allows to you compose and then send an electronic mail message. See Mailing a Message.

Mail Menu Commands
Edit Menu Commands

# $ K Mail Menu Commands

Mail completed message
Sends your completed electronic mail message to its recipient(s).

Cancel
Closes this Mail Window. If you have not already sent the message you were composing, it is lost.
