basvandorst/cryptography-archive/rsa99_cfp1/rsa99_cfp1.pdf

### Join us in San Jose in 1999!

### Silicon Valley. Where it all began:

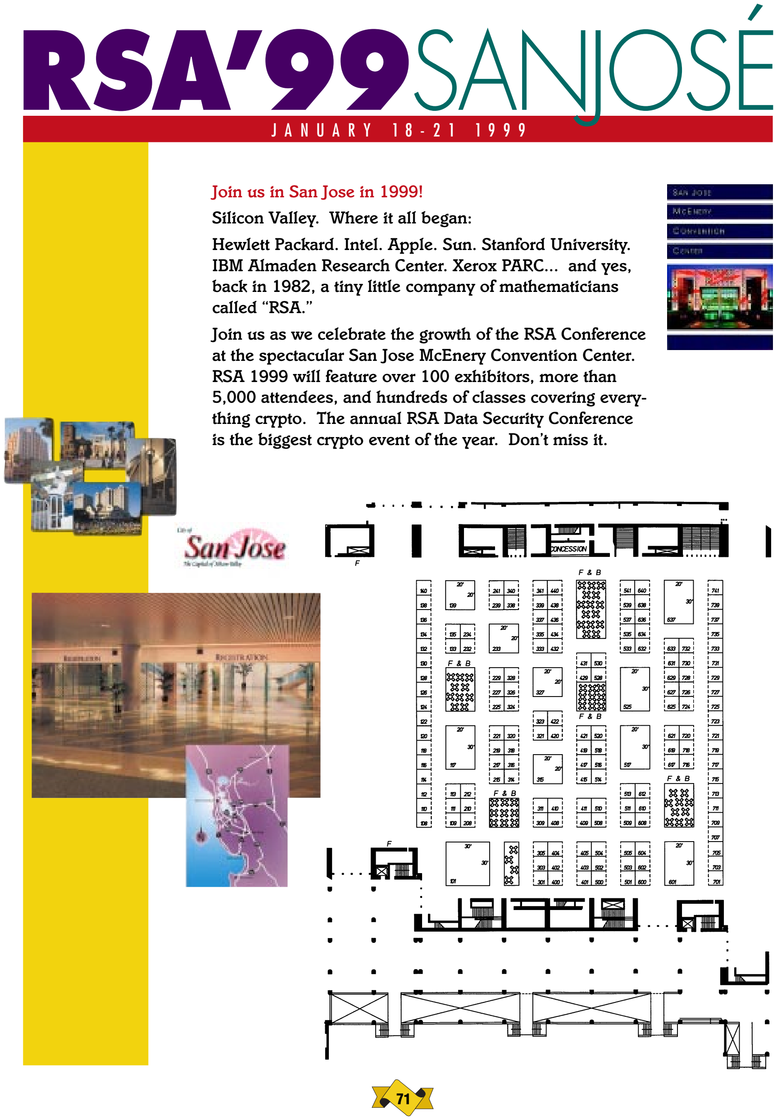
[picture p3: page 1]

71

Hewlett Packard. Intel. Apple. Sun. Stanford University. IBM Almaden Research Center. Xerox PARC... and yes,

### back in 1982, a tiny little company of mathematicians called “RSA.”

### Join us as we celebrate the growth of the RSA Conference

at the spectacular San Jose McEnery Convention Center.

### RSA 1999 will feature over 100 exhibitors, more than 5,000 attendees, and hundreds of classes covering every-thing crypto. The annual RSA Data Security Conference

is the biggest crypto event of the year. Don’t miss it.

# RSA’99SANJOSÉ

## JANUARY 18-21 1999

72

Please attach to this form:

- 100 word abstract of your presentation
- 50 word personal biography
- 50 word brief distillation of your talk (for the brochures)
- 50 word organization/company profile

INCOMPLETE SUBMISSIONS WILL NOT BE CONSIDERED.

Send, fax, or e-mail all documents by June 1, 1998 to:

1999 RSA Data Security Conference
c/o LKE Productions
1620 Montgomery Street, Suite 120
San Francisco, CA 94111
(415)544-9300 phone, (415)544-9306 fax info@lke.com

You will be notified by Friday, July 31, 1998 if your talk is selected. Please be prepared to submit a hard copy or diskette of your slides by Monday, November 23, 1998. Speakers that miss this deadline will forfeit their speaking slot. Each speaking slot is 45 minutes long; please plan for a 40 minute presentation and a 5 minute Q & A. Thank you for your submission!

The 1999 RSA Data Security Conference will be held January 18-21, 1999, at San Jose McEnery Convention Center, San Jose, California. Selected cryptographers, analysts, developers, and partners will be given the opportunity to give presentations on their applications or research. You are encouraged to suggest/submit multiple talks. Please photocopy this form as necessary. Alternatively, you can fill out this form electronically at RSA Data Security’s web site: www.rsa.com/conf99.

Proposed Title of Talk:

Is it an Individual or Panel Presentation? (Please Circle One) | ❏ Individual | ❏ Panel
If you’re submitting a proposal for an individual talk, would you be willing to deliver this as a member of a panel instead? | ❏ Yes | ❏ No

Please Suggest a Track for Your Presentation:

❏ Analysts Track | ❏ Cryptographers Track
❏ Developers Track | ❏ Standards Track | ❏ Products Track

Speaker’s or Moderator’s Name:

Title:

Organization:

Address:

E-mail:
Phone: | (REQUIRED)
Fax: | Web Site:

Panel Member’s Name:

Title:

Organization:

Address:

E-mail:
Phone: | (REQUIRED)
Fax: | Web Site:

Panel Member’s Name:

Title:

Organization:

Address:

E-mail:
Phone: | (REQUIRED)
Fax: | Web Site:

Panel Member’s Name:

Title:

Organization:

Address:

E-mail:
Phone: | (REQUIRED)
Fax: | Web Site:

Technical Level of your presentation? (Please circle one)

NOT TECHNICAL | | | | VERY TECHNICAL
1 | 2 | 3 | 4 | 5

# RSA’99

## CALL FOR PAPERS & DEMONSTRATIONS

# SANJOSÉ
