basvandorst/cryptography-archive/g4p20/Liesmich.txt

Diesem Archiv ist eine Unterschrift (Gui4PGP.sig) von "Gui4PGP.exe" beigelegt.
Prüfen Sie vor der Nutzung die Echtheit der Unterschrift !

Meinen PGP-public Key bekommen Sie auf meiner Homepage.
http://www.lanobis.de/~sascha/gui4pgp.html

Sascha Ott
Email:sascha@lanobis.de
