basvandorst/cryptography-archive/g4p20/Readme.txt

This archive is published with a signature of "Gui4PGP.exe".
Check the signature (Gui4PGP.sig) before you use this program !

You can download my PGP public-key from my homepage at:
http://www.lanobis.de/~sascha/gui4pgp.html

Sascha Ott
Email:sascha@lanobis.de
