basvandorst/cryptography-archive/pgp26dc-brazilian/LEIAME.TXT

Conteudo do pacote PGP26_BR.ZIP
-------------------------------

        - Traducao para o Portugues dos Guias do Usuario do PGP -
        by Roberta Paiva Bortolotti <roberta@nimitz.ibilce.unesp.br>

DOC1SIG  ASC    Assinatura para o arquivo PGPDOC1.BR
DOC2SIG  ASC    Assinatura para o arquivo PGPDOC2.BR
LEIAME   TXT    Este arquivo que voce esta' lendo :-)
PGPDOC1  BR     Traducao do PGP User's Guide Vol.I
PGPDOC2  BR     Traducao do PGP User's Guide Vol.II
TRADSIGS ASC    Chaves publicas dos responsaveis pela traducao

Observacoes:

. Os traducoes dos manuais Vol. I e Vol. II foram assinadas pelos
  responsaveis pela traducao, para que a validade possa ser 
  verificada.

. Para verificar esta validade e' preciso da chave publica de
  Adriano Mauro Cansian que e' fornecida no arquivo TRADSIGS.ASC

. Consulte os proprios arquivos DOC1SIG.ASC e DOC2SIG.ASC. Eles
  contem instrucoes basicas sobre como proceder a verificacao de
  validade.

. Por favor comunique qualquer problema a Adriano M. Cansian
  <adriano@nimitz.ibilce.unesp.br>

-----------<end>------------------------------------------------
