basvandorst/cryptography-archive/piw131/READ-ME

  PiW - Compute Pi to a million or so decimal places in Windows
  Version 1.31, last revised: 1994-07-29, 0600 hours
  Copyright (c) 1981-1994 by author: Harry J. Smith,
  19628 Via Monte Dr., Saratoga, CA 95070.  All rights reserved.

	If you have a copy of this diskette and
	  1) it has been damaged
	  2) you have sent me $5.00 for it
	  3) you have not asked me to send a new copy
	then
	  ask me to send you a new one.
	
	If you have a copy of this diskette and
	  1) you plan to keep it
	  2) you have not sent me $5.00 for it
	then
	  send me $5.00 to be a registered owner.

Anyone may freely copy and distribute this diskette as long as they
include this READ-ME file.
                                  Harry Smith
