basvandorst/cryptography-archive/abstract80/abstract80.tex

%& latex
\documentstyle{article}
\voffset = -1cm \hoffset = -2cm	 \vsize = 22cm \textwidth 160mm \textheight 220mm
\font\BBb=msbm10

%
% generate the index, comment out if not required
%
%\makeindex

%
% Mathematical functions and symbols
%
\def\deg{\mathop{\rm deg}\nolimits}	\def\min{\mathop{\rm min}\nolimits}
\def\max{\mathop{\rm max}\nolimits}	\def\mod{\mathop{\rm mod}\nolimits}
\def\Z{\mbox{\BBb Z}}	\def\N{\mbox{\BBb N}}	\def\R{\mbox{\BBb R}}
\def\F{\mbox{\BBb F}}	\def\st{:}		\def\BB{\mbox{$\bullet$}}

%
% Abstracting abbreviations
%
\def\T#1{{\par\subsection*{#1}}}
\def\A#1{{{\em #1\index{#1}.\ }}}
\def\E#1{{{\em #1\index{#1} (ed.).\ }}}
\def\J#1{{\par\vspace {0.2cm}\noindent{#1}}}
\def\D#1{({#1})}
\def\X#1{{\par\vspace {0.2cm}\noindent #1}}

\title{Abstracts in Cryptology: 1980s}
\author{Sean A. Irvine}
\date{\today}

\begin{document}
\small
\maketitle

\begin{abstract}
The purpose of this document is to make it easier to locate relevant cryptologic literature. The present document has extensive coverage of the cryptographic literature for the 1980s. Documents covering other decades may be forth-coming in the future.
\end{abstract}

\subsection*{Introduction}

This document contains over eight hundred abstracts for papers, technical reports and books on subjects in cryptology, or otherwise relevant to cryptology. As well as papers dealing with secrecy, authentication, cryptanalysis, protocols and so on, some papers from other relevant subjects such as random number generation, factoring, primality testing, data compression, and complexity theory have been included. This is the first release of this document and it is hoped that the cryptologic community will see fit to help me expand this document so that it becomes a useful reference for those working in the field.

Some journals are not covered very well in this release, simply because I do not have access to them here. Notable omissions are {\em Cryptologia\/} and the {\em Journal of Cryptology.} If somebody with access to these journals can send me abstracts for papers in them I will include them in the document for the next release. Some other journals carrying papers on cryptography appear below.

If you know of any paper from the 1980s not listed here please send me the abstract. If you do not have an abstract the title, author, and journal could still be included. Of course, all papers should be publicly available. Also please send any corrections.

NOTE: DO NOT ASK ME WHERE TO GET A COPY OF ANY OF THESE PAPERS. Most likely I do not know. Instead make use of the interloan services of your local library.

I can be contacted through electronic mail as {\tt sirvine@waikato.ac.nz} and through the normal post as:

\begin{verbatim}
Sean Irvine (G3.02)
Dept. of Maths and Stats
University of Waikato
Private Bag 3105
Hamilton
New Zealand.
\end{verbatim}

I am also preparing abstracts for other decades, but so far none of those are anywhere as near complete as this one. If you have abstracts for papers before 1980 please forward them as well. If you are the {\em author\/} of a paper after 1989 please send me an abstract (you can send the entire paper if you like).

This document is designed to be printed using the \LaTeX\ typesetting system.

The following publications are devoted to cryptology:
Advances in Cryptology---CRYPTO 'xx. Advances in Cryptology---EUROCRYPT 'xx. (There are no proceedings for EUROCRYPT'86). Journal of Cryptology. Cryptosystems Journal. Cryptologia. Computer and Communications Security Reviews. Forbidden Knowledge. The Cryptogram. The Cryptogram Computer Supplement. The Public Key.

The following publications often carry material of relevance and cryptographic papers: Proceedings of the --- Annual ACM Symposium on Theory of Computing. IEEE Transactions on Information Theory. The Transactions of the Institute of Electronics, Information and Communication Engineers (IEICE). Infosecurity News. Information Systems Security Products and Services Catalogue.

\T {$2n$-Bit Hash-Functions Using $n$-Bit Symmetric Block Cipher Algorithms}
\A {Jean-Jacques Quisquater}
\A {Marc Girault}
\J {Advances in Cryptology---EUROCRYPT '89, Proceedings, Lecture Notes in Computer Science (434), Springer-Verlag}
\D {1989}
\X {We present a new hash-function, which provides $2n$-bit has-results, using any $n$-bit symmetric block cipher algorithm. This hash-function can be considered as a extension of an already known one, which only provided $n$-bit hash results. The difference is crucial, because a lot of symmetric block cipher algorithms use 64-bit blocks and recent works have shown that a 64-bit hash-result is greatly insufficient.}

\T {An Abstract Theory of Computer Viruses}
\A {Leonard M. Adleman}
\J {Advances in Cryptology---CRYPTO '88, Proceedings, Lecture Notes in Computer Science (403), Springer-Verlag}
\D {1988}

\T {Abuses in Cryptography and How to Fight Them}
\A {Yvo Desmedt}
\J {Advances in Cryptology---CRYPTO '88, Proceedings, Lecture Notes in Computer Science (403), Springer-Verlag}
\D {1988}
\X {The following seems quite familiar: ``Alice and Bob want to flip a coin by telephone. (They have just divorced, live in different {\em countries,} want to decide who will have the children during the next holiday.)...'' So they use a protocol. {\em However,} Alice and Bob's {\em divorce has been set up to cover up their spying activities.} When the use a protocol, they don't care if the ``coin-flip'' is random, but they want to {\em abuse the protocol\/} to send secret information to each other. The counter-espionage service, however, doesn't know that the divorce and the use of the protocol are just cover-ups. In this paper, we demonstrate how several modern crypto-systems can be abused. We generalize the subliminal channel and abuse of identification systems and demonstrate how one {\em can prevent abuses\/} of crypto-systems.}

\T {Access Control at the Netherlands Postal and Telecommunications Services}
\A {Willem Haemers}
\J {Advances in Cryptology---CRYPTO '85, Proceedings, Lecture Notes in Computer Science (218), Springer-Verlag}
\D {1985}
\X {The Netherlands Postal and Telecommunications Services (PTT) have developed a system that controls the entrance to their buildings by use of magnetic stripe cards. In this note some cryptographic aspects of the system are explained.}

\T {Accuracy, Integrity and Security in Computerized Vote-Tallying}
\A {Roy G. Saltman}
\J {CACM {\bf 31,} 10}
\D {1988}
\X {Excerpts from an in-depth research report depict potential difficulties in the use of computerized vote-tallying. Recent legal cases point to claims of inaccuracies and fraud.}

\T {Addition Chain Heuristics}
\A {Jurjen Bos}
\A {Matthijs Coster}
\J {Advances in Cryptology---CRYPTO '89, Proceedings, Lecture Notes in Computer Science (435), Springer-Verlag}
\D {1989}

\T {Algebraical Structures of Cryptographic Transformations}
\A {J\'osef P. Pieprzyk}
\J {Advances in Cryptology---EUROCRYPT '84, Proceedings, Lecture Notes in Computer Science (209), Springer-Verlag}
\D {1984}
\X {In the paper, application of idempotent elements to construction of cryptographic systems has been presented. The public key cryptosystem based on idempotent elements and the cryptographic transformation that preserves elementary arithmetic operations have been described.}

\T {Algebraic Coding Theory}
\A {E. R. Berlekamp}
\J {Aegean Park Press, Leguna Hills, CA}
\D {1984---previous edition 1968}

\T {Algorithmics: Theory and Practice}
\A {Gilles Brassard}
\A {Paul Bratley}
\J {Prentice-Hall International}
\D {1988}
\X {Algorithms, efficiency of algorithms, elementary operations, data structures, asymptotic notation, order notation, solving recurrences, greedy algorithms and heuristics, divide and conquer techniques, dynamic programming, exploring graphs, depth-first search, breadth-first search, preconditioning and precomputation, probabilistic algorithms, Monte Carlo algorithms, Sherwood algorithms, Las Vegas algorithms, complexity, discrete Fourier transform, NP-completeness.}

\T {Algorithms and Complexity}
\A {Herbert S. Wilf}
\J {Prentice-Hall}
\D {1986}
\X {Hard and easy problems, orders of magnitudes, positional number systems, series, recurrence relations, counting, graphs, recursive algorithms, quicksort, fast Fourier transform (FFT), network flow problem, Ford-Fulkerson algorithm, MPM algorithm, greatest common divisor, number theory, primality testing, pseudoprimality tests, factoring and cryptology, factoring large integers, NP-completeness, Cook's theorem, Turing machines, backtracking.}

\T {Algorithms for Public Key Cryptosystems: Theory and Practice}
\A {S. Lakshmivarahan}
\J {Advances in Computers, {\bf 22}}
\D {1983}
\X {Cryptography: nature and scope, cryptanalysis, classical cryptosystems,
public key encryption systems, divisibility, congruences, primitive roots and
discrete logarithms, quadratic residues, prime factorization and primality
testing, finite fields, examples of public key cryptosystem, authentication,
digital signatures, read-only secure communications, conference key
distribution systems, data-base security.}

\T {All-or-Nothing Disclosure of Secrets}
\A {Gilles Brassard}
\A {Claude Cr\'epeau}
\A {Jean-Marc Robert}
\J {Advances in Cryptology---CRYPTO '86, Proceedings, Lecture Notes in Computer Science (263), Springer-Verlag}
\D {1987}

\T {Almost All Primes Can be Quickly Certified}
\A {Shafi Goldwasser}
\A {Joe Kilian}
\J {Proc. of the 18th Annual ACM Symp. of Theory of Computing}
\D {1986}
\X {This paper presents a new probabilistic primality test. Upon termination the test outputs ``composite'' or ``prime'', along with a short proof of correctness, which can be verified in deterministic polynomial time. The test is different from the tests of Miller, Solovay-Strassen, and Rabin in that its assertions of primality are certain, rather than being correct with high probability or dependent on an unproven assumtpion. The test terminates in expected polynomial time on all but at most an exponentially vanishing fraction of the inputs of length $k,$ for every $k.$ This result implies: (1) There exist an infinite set of primes which can be recognized in expected polynomial time. (2) Large certified primes can be generated in expected polynomial time. Under a very plausible condition on the distribution of primes in ``small'' intervals, the proposed algorithm can be shown to run in expected polynomial time on {\bf every input.} This condition is implied by Cramer's conjecture. The methods employed are from the theory of elliptic curves over finite fields.}

\T {Alternating Step Generators Controlled By de Bruijn Sequences}
\A {C. G. G\"unther}
\J {Advances in Cryptology---EUROCRYPT '87, Proceedings, Lecture Notes in Computer Science (304), Springer-Verlag}
\D {1987}
\X {The alternating step generator (ASG) is a new generator of pseudorandom sequences which is closely related to the stop-and-go generator. It shares all the good properties of this latter generator without possessing its weakness. The ASG consists of three subgenerators $K, M,$ and $\overline{M}.$ The main characteristic of its structure is that the output of one of the subgenerators, $K,$ controls the clock of the two others, $M$ and $\overline{M}.$ In the present contribution, we determine the period, the distribution of short patterns and a lower bound for the linear complexity of the sequences generated by an ASG. The proof of the lower bound is greatly simplified by assuming that $K$ generates a de Bruijn sequence. Under this and other not very restrictive assumptions the period and the linear complexity are found to be proportional to the period of the de Bruijn sequence. Furthermore the frequency of all short patterns as well as the autocorrelation turn out to be ideal. This means that the sequences generated by the ASG are provably secure against the standard attacks.}

\T {An Alternative to the Fiat-Shamir Protocol}
\A {Jacques Stern}
\J {Advances in Cryptology---EUROCRYPT '89, Proceedings, Lecture Notes in Computer Science (434), Springer-Verlag}
\D {1989}
\X {In 1986, Fiat and Shamir exhibited zero-knowledge based identification and digital signature schemes. In these schemes, as well as in subsequent variants, both the prover and the verifier have to perform modular multiplications. This paper is an attempt to build identification protocols that ise only very basic operations such as multiplication by a fixed matrix over the two-element field. Such a matrix can be viewed as the parity-check matrix of a linear binary error-correcting code. The idea of using error-correcting codes in this area is due to Harari but the method that is described here is both simpler and more secure than his original design.}

\T {Analog Scrambling by the General Fast Fourier Transform}
\A {Franz Pichler}
\J {Cryptography, Proceedings, Burg Feuerstein 1982, Lecture Notes in Computer Science (149), Springer-Verlag}
\D {1983}

\T {Analogue Speech Security Systems}
\A {H. J. Beker}
\J {Cryptography, Proceedings, Burg Feuerstein 1982, Lecture Notes in Computer Science (149), Springer-Verlag}
\D {1983}

\T {Analysis of a Nonlinear Feedforward Logic For Binary Sequence Generators}
\A {J. Bernasconi}
\A {C. G. G\"unther}
\J {Advances in Cryptology---EUROCRYPT '85, Proceedings, Lecture Notes in Computer Science (219), Springer-Verlag}
\D {1985}
\X {A new type of nonlinear feedforward logic for binary sequence generators is proposed, i.e. a logic that combines the stages of a linear feedback shift register (LFSR) in a nonlinear way. The sequences generated are analyzed with respect to their transient and ultimately periodic behaviour. They are shown to have a balanced zero-one distribution, and a lower bound on their linear complexity is derived which grows exponentially with the length of their LFSR.}

\T {Analysis of a Public Key Approach Based on Polynomial Substitution}
\A {Harriet Fell}
\A {Whitfield Diffie}
\J {Advances in Cryptology---CRYPTO '85, Proceedings, Lecture Notes in Computer Science (218), Springer-Verlag}
\D {1985}

\T {Analysis of Certain Aspects of Output Feedback Mode}
\A {R. R. Jueneman}
\J {Advances in Cryptology---CRYPTO '82, Plenum Press, pp. 99-127}
\D {1983}

\T {Analysis of Multiple Access Channel Using Multiple Level FSK}
\A {L\'aszl\'o Gy\H{o}rfi}
\A {Istv\'an Kerekes}
\J {Cryptography, Proceedings, Burg Feuerstein 1982, Lecture Notes in Computer Science (149), Springer-Verlag}
\D {1983}
\X {For multiple level FSK systems of multiple user communication a model is considered containing independent parallel noisy OR channels. The error probability is calculated if a random block code and a majority type decoding rule is applied.}

\T {Analysis of the Security and New Algorithms for Modern Industrial Cryptography}
\A {Y. Desmedt}
\J {Ph.D. Thesis, Katholieke Universiteit Leuven, Belgium}
\D {1984}

\T {Analytical Characteristics of the DES}
\A {M. Davio}
\A {Y. Desmedt}
\A {M. Fosseprez}
\A {R. Govaerts}
\A {J. Hulsbosch}
\A {P. Neutjens}
\A {P. Piret}
\A {J.-J. Quisquater}
\A {J. Vandewalle}
\J {Advances in Cryptology---CRYPTO `83, Proceedings, Plenum Press, pp. 171-202}
\D {1984}

\T {Analyzing Encryption Protocols Using Formal Verification Techniques}
\A {Richard A. Kemmerer}
\J {Advances in Cryptology---CRYPTO '87, Proceedings, Lecture Notes in Computer Science (293), Springer-Verlag}
\D {1987}

\T {Anonymous and Verifiable Registration in Databases}
\A {J\o rgen Brandt}
\A {Ivan Bjerre Damg{\aa}rd}
\A {Peter Landrock}
\J {Advances in Cryptology---EUROCRYPT '88, Proceedings, Lecture Notes in Computer Science (330), Springer-Verlag}
\D {1988}
\X {Methods are given by which personal data about a large number of individuals can be registered in a large central database without having to trust this register not to give away information linked to a given individual. Personal information arriving from many different sources can be placed correctly in the register. The registration is done in a verifiable way: Each individual can be given access to the register to check that his information is correct, and can even, if he chooses to do so, prove to anyone that he is or is not identical to a given person in the register. This can all be done without compromising the anonymity of any other individual.}

\T {Another Birthday Attack}
\A {Don Coppersmith}
\J {Advances in Cryptology---CRYPTO '85, Proceedings, Lecture Notes in Computer Science (218), Springer-Verlag}
\D {1985}
\X {We show that a meet-in-the-middle attack can successfully defraud the Davies-Price message authentication scheme. Their scheme used message blocks in an iterated encipherment of an initial block, and it went through the message block twice, in order to prevent just such a ``birthday'' attack.}

\T {Aperiodic Linear Complexities of de~Bruijn Sequences}
\A {Richard T. C. Kwok}
\A {Maurice Beale}
\J {Advances in Cryptology---CRYPTO '88, Proceedings, Lecture Notes in Computer Science (403), Springer-Verlag}
\D {1988}

\T {An Application of a Fast Data Encryption Standard Implementation}
\A {Matt Bishop}
\J {Dartmouth College Computer Science Technical Report PCS-TR88-138}
\D {1988}
\X {The Data Encryption Standard is used as the basis for the UNIX password encryption scheme.  Some of the security of that scheme depends on the speed of the implementation.  This paper presents a mathematical formulation 
of a fast implementation of the DES in software, discusses how the mathematics can be translated into code, and then analyzes the UNIX password scheme to show how these results can be used to implement it.  Experimental results are 
provided for several computers to show that the given method speeds up the computation of a password by roughly 20 times (depending on the specific computer).}

\T {The Application of Claw Free Functions in Cryptography: Unconditional Protection in Cryptographic Protocols}
\A {I. B. Damg{\aa}rd}
\J {Ph.D. Thesis, Mathematical Institute, Aarhus University, Aarhus, Denmark}
\D {1988}

\T {The Application of Smart Cards for RSA Digital Signatures in a Network Comprising Both Interactive and Store-And-Forward Facilities}
\A {J. R. Sherwood}
\A {V. A. Gallo}
\J {Advances in Cryptology---CRYPTO '88, Proceedings, Lecture Notes in Computer Science (403), Springer-Verlag}
\D {1988}
\X {Smart card technology is relatively new but offers an economic and convenient solution to the problems of user-authentication. This paper discusses the requirements for user authentication and digital signature in complex networks and examines the problems of integrating a smart-card sub-system. It proposes some design approaches for providing a useful lifetime for a smart card and for handling the computations required for 512-bit RSA digital signatures.}

\T {Approaches to Handling ``Trojan Horse'' Threats}
\A {Yeheskel Lapid}
\A {Niv Ahituv}
\A {Seev Neumann}
\J {Computers \& Security, {\bf 5,} 3}
\D {1986}
\X {This paper examines the exposure of an information system to an attack by a ``Trojan Horse'' and trapdoors. It outlines some new encryption-based mechanisms that can reduce risks and losses caused by such attacks. It proposes moddels exhibit the direction and nature of the solutions for the threats.}

\T {Arbitration in Tamper Proof Systems}
\A {George I. Davida}
\A {Brian J. Matt}
\J {Advances in Cryptology---CRYPTO '87, Proceedings, Lecture Notes in Computer Science (293), Springer-Verlag}
\D {1987}
\X {Given that tamperfree devices exist it is possible to construct true signature schemes that have the advantages of arbitrated signature schemes, protection against disavowing or forging messages, and lacking certain short comings. Other cryptographic protocols can also be improved. The contents of tamperfree devices cannot be examined as well as not modified.}

\T {Architectures for Exponentiation in $GF(2^n)$}
\A {T. Beth}
\A {B. M. Cook}
\A {D. Gollmann}
\J {Advances in Cryptology---CRYPTO '86, Proceedings, Lecture Notes in Computer Science (263), Springer-Verlag}
\D {1987}
\X {We investigate different data structures in $GF(2^n)$ and their correspondence to silicon architectures to examine possible hardware implementations of the Diffie-Hellman key exchange system.}

\T {Are All Injective Knapsacks Partly Solvable After Multiplication Modulo $Q?$}
\A {Ingemar Ingemarsson}
\J {SIGACT News, {\bf 15,} 1}
\D {1983}
\X {Extended abstract of Crypto'81 presentation.}

\T {Are Big S-Boxes Best?}
\A {J. A. Gordon}
\A {H. Retkin}
\J {Cryptography, Proceedings, Burg Feuerstein 1982, Lecture Notes in Computer Science (149), Springer-Verlag}
\D {1983}
\X {Various probabilities of accidental linearaties occurring in a random, reversible substitution lookup table (S-box) with $m$ address and $m$ contents bits are calculated. These probabilities decrease very dramatically with increasing $m.$ It is conjectured that good S-boxes may be built by choosing a random, reversible table of sufficient size.}

\T {The Art of Computer Programming (2nd ed.)}
\A {D. E. Knuth}
\J {Addison-Wesley}
\D {1981}

\T {Aspects and Importance of Secure Implementations of Identification Systems}
\A {S. Bengio}
\A {G. Brassard}
\A {Y. Desmedt}
\A {C. Goutier}
\A {J.-J. Quisquater}
\J {Manuscript M209, Philips Research Lab., Bruxelles, Belgium}
\D {1987}

\T {Atkin's Test: News From the Front}
\A {Fran\c cois Morain}
\J {Advances in Cryptology---EUROCRYPT '89, Proceedings, Lecture Notes in Computer Science (434), Springer-Verlag}
\D {1989}
\X {We make an attempt to compare the speed of some primality testing algorithms certifying 100-digit prime numbers.}

\T {An Attack on a Signature Scheme Proposed by Okamoto and Shiraishi}
\A {Ernest F. Brickell}
\A {John M. DeLaurentis}
\J {Advances in Cryptology---CRYPTO '85, Proceedings, Lecture Notes in Computer Science (218), Springer-Verlag}
\D {1985}
\X {Recently Okamoto and Shiraishi proposed a public key authentication system. The security of the scheme is based on the difficulty of solving quadratic inequalities. This new system is interesting since the amount of computing needed for the proposed scheme is significantly less than that need for an RSA encryption. This report is an investigation into the security of the proposed digital signature scheme. We demonstrate that if the system is used as it is presented, an opponent could sign messages without factoring the modulus. Further, we suggest a modification which may not have the same flaw as the proposed scheme.}

\T {Attack on the Koyama-Ohta Identity Based Key Distribution Scheme}
\A {Yacov Yacobi}
\J {Advances in Cryptology---CRYPTO '87, Proceedings, Lecture Notes in Computer Science (293), Springer-Verlag}
\D {1987}
\X {Koyama and Ohta proposed an identity based key distribution scheme. They considered three configurations: ring, complete graph, and star. The most practical configuration is the star which is used in teleconferencing. We show the Koyama-Ohta star scheme to be insecure. Specifically, we show that an active eavesdropper may cut one of the lines, and perform a bidirectional impersonation, thus establishing two separate keys. One with each side.}

\T {Attacks On Some RSA Signatures}
\A {Wiebren {de Jonge}}
\A {David Chaum}
\J {Advances in Cryptology---CRYPTO '85, Proceedings, Lecture Notes in Computer Science (218), Springer-Verlag}
\D {1985}
\X {Two simple redundancy schemes are shown to be inadequate in securing RSA signatures against attacks based on multiplicative properties. The schemes generalize the requirement that each valid message starts or ends with a fixed number of zero bits. Even though only messages with proper redundancy are signed, forgers are able to construct signatures on messages of their choice.}

\T {Audit and Security Implications of Electronic Funds Transfer}
\A {A. Kinnon}
\A {R. H. Davis}
\X {The problems created by the facilities of Electronic Funds Transfer are considered in relation to the role of auditors seeking to ensure that correct and secure operations occur when a computer takes over major record processing activities within an organization.}

\T {Authentication: A Concise Survey}
\A {G. M. J. Pluimakers}
\A {J. van Leeuwen}
\J {Computers \& Security, {\bf 5,} 3}
\D {1986}
\X {This article considers the problem of authenticating messages in applications in which senders and receivers communicate over unprotected channels. New techniques, e.g. from the area of public-key cryptography, have been devised to determine that messages indeed originate at the claimed source and have not been tampered with on the way. Included is an estimate of current developments in the theory of design and analysis of these techniques.}

\T {Authentication Codes with Multiple Arbiters}
\A {Ernest F. Brickell}
\A {Doug R. Stinson}
\J {Advances in Cryptology---EUROCRYPT '88, Proceedings, Lecture Notes in Computer Science (330), Springer-Verlag}
\D {1988}
\X {An authentication system provides a means for a transmitter to send a message to a receiver so that the receiver is convinced that the message was sent by the transmitter and not by an opponent. Authentication codes provide a design for authentication systems which are unconditionally secure. Specifically, the codes provide a provable level of security which depends on the parameters of the code but which does not depend on any assumptions (for instance assumptions about the computational complexity of some problem). In 1987, Simmons introduced authentication codes that permit arbitration. These codes allow for an arbiter who can settle disputes between the transmitter and receiver. The disputes that an arbiter can resolve are that the receiver might claim to have received a certain message when in fact he didn't, or the transmitter might try to disavow a message that he actually sent. The arbiter cannot resolve a dispute in which the transmitter claims to have sent a message and the receiver claims that he did not receive a message. These systems are also unconditionally secure. One drawback to the system is that the transmitter and receiver must have complete trust in the arbiter, because an arbiter has the potential to cheat in many ways. In this paper, we show that by having multiple arbiters, the probability that a
ny individual arbiter can successfully cheat is greatly reduced.}

\T {Authentication of Signatures Using Public Key Encryption}
\A {Kellogg S. Booth}
\J {C ACM {\bf 24,} 11}
\D {1981}
\X {One of Needham and Schroeder's proposed signature authentication protocols
is shown to fail when there is a possibility of compromised keys: this
invalidates one of the applications of their technique. A more elaborate
mechanism is proposed which does not require a network clock, but does require
a third party to the transaction. The latter approach is shown to be relaible
in a fairly strong sense.}

\T {Authentication Procedures}
\A {M. Davio}
\A {J.-M. Goethals}
\A {J.-J. Quisquater}
\J {Cryptography, Proceedings, Burg Feuerstein 1982, Lecture Notes in Computer Science (149), Springer-Verlag}
\D {1983}
\X {The purpose of this paper is to illustrate the use of one-way functions and public-key algorithms in some authentication procedures. Special emphasis is given to the problem of mutual authentication of a card and a point-of-sale terminal in an off-line situation.}

\T {Authentication Theory/Coding Theory}
\A {Gustavus J. Simmons}
\J {Advances in Cryptology---CRYPTO '84, Proceedings, Lecture Notes in Computer Science (196), Springer-Verlag}
\D {1984}
\X {We consider a communications scenario in which a transmitter attempts to inform a remote receiver of the state of a source by sending messages through an imperfect communications channel. There are two fundamentally different ways in which the receiver can end up being misinformed. The channel may be noisy so that symbols in the transmitted message can be received in error, or the channel may be under the control of an opponent who can either deliberately modify legitimate messages or else introduce fraudulent ones to deceive the receiver, i.e., what Wyner has called an ``active wiretapper''. The device by which the receiver improves his chances of detecting error (deception) is the same in either case: the deliberate introduction of redundant information into the transmitted message. The way in which this redundant information is introduced and used, though, is diametrically opposite in the two cases.
For a statistically described noisy channel, coding theory is concerned with schemes (codes) that introduce redundancy in such a way that the most likely alterations to the encoded messages are in some sense close to the code they derive from. The receiver can then use a maximum likelihood detector to decide which (acceptable) message he should infer as having been transmitted from the (possibly altered) code that was received. In other words,the object in coding theory is to cluster the most likely alterations of an acceptable code as closely as possible (in an appropriate metric) to the code itself, and disjoint from the corresponding clusters about other acceptable codes. The present author showed that the problem of detecting either the deliberate modification of legitimate messages or the introduction of fraudulent messages; i.e.,
 of transmitter and digital message authentication, could be modeled in complete generality by replacing the classical noisy communications channel of coding theory with a game-theoretic noiseless channel in which an intelligent opponent, who knows the system can observe the channel, plays so as to optimize his chances of deceiving the receiver. To provide some degree of immunity to deception (of the receiver), the transmitter also introduces redundancy in this case, but does so in such a way that, for any message the transmitter may send, the altered messages that the opponent would introduce using his optimal strategy are spread randomly, i.e.m as uniformly as possible (again with respect to an appropriate metric) over the set of possible messages, $M.$ 
Authentication theory is concerned with devising and analyzing schemes (codes) to achieve this ``spreading.'' It is in this sense that coding theory and authentication theory are dual theories: one is concerned with clustering the most likely alterations so closely about the original code as possible and the other with spreading the optimal (to the opponent) alterations as uniformly as possible over $M.$ The probability that the receiver will be deceived by the opponent, $P_d$, can be bounded below by any of several expressions involving the entropy of the source $H(S),$ of the channel $H(M),$ of the encoding rules used by the transmitter to assign messages to states of the source $H(E),$ etc. For example: $$(1)\qquad\qquad\qquad\qquad\log P_d\ge H(MES) - H(E) - H(M)$$ The authentication system is said to be perfect if equality holds in (1), since in this case all of the information capacity of a transmitted message is used to either inform the receiver as to the state of the source or else to confound the opponent. In a sense, inequality (1) defines an authentication channel bound similar to the communication channel bounds of coding theory.
Constructions for perfect authentication systems are consequently of great interest since they fully realize the capacity of the authentication channel. In the paper given at Crypto 84 we analyzed several infinite families of perfect systems and also extended the channel bounds to include cases in which the opponent knew the state of the source. Here we have the more modest goal of rigorously deriving the channel bound (1) and then using this result to derive a family or related bounds.}

\T {Authorized Writing For ``Write-Once'' Memories}
\A {Philippe Godlewski}
\A {G\'erard D. Cohen}
\J {Advances in Cryptology---EUROCRYPT '85, Proceedings, Lecture Notes in Computer Science (219), Springer-Verlag}
\D {1985}
\X {We describe a method for storing information on a ``write-once'' memory with the following feature: reading is easy, whereas writing is difficult, except for the designer.}

\T {The Average Cycle Size of the Key Stream in Output Feedback Encipherment}
\A {D. W. Davies}
\A {G. I. P. Parkin}
\J {Cryptography, Proceedings, Burg Feuerstein 1982, Lecture Notes in Computer Science (149), Springer-Verlag}
\D {1983}
\J {Advances in Cryptology: Proc. of CRYPTO~'82, Plenum Press, pp. 97--98}
\D {1983}

\T {A Basic Theory of Public and Private Cryptosystems}
\A {Charles Rackoff}
\J {Advances in Cryptology---CRYPTO '88, Proceedings, Lecture Notes in Computer Science (403), Springer-Verlag}
\D {1988}

\T {Batch RSA}
\A {Amos Fiat}
\J {Advances in Cryptology---CRYPTO '89, Proceedings, Lecture Notes in Computer Science (435), Springer-Verlag}
\D {1989}
\X {Number theoretic cryptographic algorithms are all based upon modular multiplication modulo some composite or prime. Some security parameter $n$ is set (the length of the composite or prime). Cryptographic functions such as digital signature or key exchange require $O(n)$ or $O(\sqrt{n})$ modular multiplications. This paper proposes a variant of the RSA scheme which requires only polylog$(n)$ $(O(\log^2 n))$ modular multiplications per RSA operation. Inherent to the scheme is the idea of batching, i.e, performing several encryption or signature operations simultaneously. In practice, the new variant effectively performs several modular exponentiations at the cost of a single modular exponentiation. This leads to a very fast RSA-like scheme whenever RSA is to be performed at some central site or when pure-RSA encryption ({\em vs.} hybrid encryption) is to be performed. An important feature of the new scheme is a practical scheme that isolates the private key from the system, irrespective of the size of the system, the number of sites, or the number of private operations that need be performed.}

\T {Bit Commitment Using Pseudo-Randomness}
\A {Moni Naor}
\J {Advances in Cryptology---CRYPTO '89, Proceedings, Lecture Notes in Computer Science (435), Springer-Verlag}
\D {1989}
\X {We show how a pseudo-random generator can provide a bit commitment protocol. We also analyze the number of bits communicated when parties commit to many bits simultaneously, and show that the assumption of the existence of pseudo-random generators suffices to assure amortized $O(1)$ bits of communication per bit commitment.}

\T {The Bit Extraction Problem or $t$-Resilient Functions}
\A {B.-Z. Chor}
\A {O. Goldreich}
\A {J. Hastad}
\A {J. Friedmann}
\A {S. Rudich}
\A {R. Smolensky}
\J {Proc. of the 26th IEEE Symp. on Foundations of Computer Sc., pp. 396--407}
\D {1985}

\T {The Bit Security of Modular Squaring Given Partial Factorization of the Modulos}
\A {Benny Chor}
\A {Oded Goldreich}
\A {Shafi Goldwasser}
\J {Advances in Cryptology---CRYPTO '85, Proceedings, Lecture Notes in Computer Science (218), Springer-Verlag}
\D {1985}
\X {It is known that given a composite integer $N=p_1p_2$ (such that $p_1\equiv p_2\equiv3(\mod4)),$ and $q$ is a quadratic residue modulo $N,$ guessing the least significant bit of a square root of $q$ with any non-negligible advantage is as hard as factoring $N.$ In this paper we extend the above result to multi-prime numbers $N=p_1p_2\cdots p_l$ (such that $p_1\equiv p_2\equiv\cdots\equiv p_l\equiv3(\mod 4)).$ We show that given $N$ and $q,$ a quadratic residue mod $N,$ guessing the least significant bit of a square root of $q$ is as hard as completely factoring $N.$ Furthermore, the difficulty of guessing the least significant bit of the square root of $q$ remains unchanged even when all but two of the prime factors of $N,$ $p_3,\ldots,p_l,$ are known. The result is useful in designing multi-party cryptographic protocols.}

\T {Blinding for Unanticipated Signatures}
\A {David Chaum}
\J {Advances in Cryptology---EUROCRYPT '87, Proceedings, Lecture Notes in Computer Science (304), Springer-Verlag}
\D {1987}
\X {Previously known blind signature systems require an amount of computation at least proportional to the number of signature types, and also the number of such types to be fixed in advance. These requirements are not practical in some applications. Here, a new blind signature technique is introduced that allows an unlimited number of signature types with only a (modest) constant amount of computation.}

\T {Bounds and Constructions for Authentication - Secrecy Codes with Splitting}
\A {Marijke {De Soete}}
\J {Advances in Cryptology---CRYPTO '88, Proceedings, Lecture Notes in Computer Science (403), Springer-Verlag}
\D {1988}

\T {Breaking Iterated Knapsacks}
\A {Ernest F. Brickell}
\J {Advances in Cryptology---CRYPTO '84, Proceedings, Lecture Notes in Computer Science (196), Springer-Verlag}
\D {1984}
\X {This paper presents an outline of an attack that we have used successfully to break iterated knapsacks. Although we do not provide a proof that the attack almost always works, we do provide some heuristic arguments. We also give a detailed description of the examples we have broken.}

\T {Breaking the Cade Cipher}
\A {N. S. James}
\A {R. Lidl}
\A {H. Niederreiter}
\J {Advances in Cryptology---CRYPTO '86, Proceedings, Lecture Notes in Computer Science (263), Springer-Verlag}
\D {1987}
\X {A cryptanalysis is given of a cryptosystem introduced by J.~J.~Cade, which is based on solving equations over finite fields.}

\T {Breaking the Enemy's Code}
\A {Glenn Zorpette}
\J {IEEE Spectrum, Sept.}
\D {1987}
\X {British intelligence and the Colossus computer.}

\T {Breaking the Ong-Schnorr-Shamir Signature Scheme for Quadratic Number Fields}
\A {Dennis Estes}
\A {Leonard M. Adleman}
\A {Kireeti Kompella}
\A {Kevin S. McCurley}
\A {Gary L. Miller}
\J {Advances in Cryptology---CRYPTO '85, Proceedings, Lecture Notes in Computer Science (218), Springer-Verlag}
\D {1985}

\T {Bull CP8 Smart Card in Cryptology}
\A {Yves Girardot}
\J {Advances in Cryptology---EUROCRYPT '84, Proceedings, Lecture Notes in Computer Science (209), Springer-Verlag}
\D {1984}
\X {The CP8 smart card has memory and intelligence. These two characteristics joined to its technology, make of it an unfraudable and unduplicable portable strong box. Thus CP8 is a very secure and convenient device to transport, generate or transmit cryptologic keys or data.}

\T {Can Software Do Encryption Job?}
\A {D. Williams}
\A {H. J. Hindin}
\J {Electronics, July~3, pp. 102--103}
\D {1980}

\T {Cartesian Authentication Schemes}
\A {M. {De Soete}}
\A {K. Vedder}
\A {M. Walker}
\J {Advances in Cryptology---EUROCRYPT '89, Proceedings, Lecture Notes in Computer Science (434), Springer-Verlag}
\D {1989}
\X {This paper gives a characterisation of perfect Cartesian authentication schemes. It is shown that their existence is equivalent to the existence of nets. Futhermore the paper presents constructions of new authentication schemes derived from generalised $n$-gons which take on the lowest combinatorical bound for the impersonation attack. They include, as special cases, those based on projective planes and generalised quadrangles. It investigates the properties of the encoding rules and contains a brief discussion of questions in connection with key management.}

\T {A Certified Digital Signature}
\A {Ralph C. Merkle}
\J {Advances in Cryptology---CRYPTO '89, Proceedings, Lecture Notes in Computer Science (435), Springer-Verlag}
\D {1989}
\X {A practical digital signature system based on a conventional encryption function which is as secure as the conventional encryption function is described. Since certified conventional systems are available it can be implemented quickly without the several years delay required for certification of an untested system.}

\T {Cheating At Mental Poker}
\A {Don Coppersmith}
\J {Advances in Cryptology---CRYPTO '85, Proceedings, Lecture Notes in Computer Science (218), Springer-Verlag}
\D {1985}
\X {We review the ``mental poker'' scheme described by Shamir, Rivest and Adleman. We present two possible means of cheating, depending on careless implementation of the SRA scheme. One will work if the prime $p$ is such that $p-1$ has a small prime divisor. In the other scheme, the names of the cards ``TWO OF CLUBS'' have been extended by random-looking bits, chosen by the cheater.}

\T {The Chipcard---An Identification Card With Cryptographic Protection}
\A {Thomas Krivachy}
\J {Advances in Cryptology---EUROCRYPT '85, Proceedings, Lecture Notes in Computer Science (219), Springer-Verlag}
\D {1985}

\T {A Chosen-Plaintext Attack on the Microsoft BASIC Protection}
\A {R. {van den Assem}}
\A {W. J. {van Elk}}
\J {Computers \& Security, {\bf 5,} 1}
\D {1986}
\X {The Microsoft BASIC (MBASIC) interpreter provides a command which protects the program currently in memory by saving it, on disk, in an encrypted format. A user can RUN such a protected program, but cannot access the source program. A chosen-plaintext attack was used to break the encoding; the encryption method could be derived easily from the enciphering of carefully chosen plaintext programs. As a result a pair of MBASIC programs able to decrypt a protected program for any interpreter was developed. Further, it is shown that a secure system can never be realized, whichever encryption method is used.}

\T {Chosen Signature Cryptanalysis of the RSA (MIT) Public Key Cryptosystem}
\A {G. Davida}
\J {Technical Report TR-CS-82-2, Dept. of EECS, University of Wisconsin, Milwaukee, WI}
\D {1982}

\T {A Chosen Text Attack on the Modified Cryptographic Checksum Algorithm of Cohen and Huang}
\A {Bart Preneel}
\A {Antoon Bosselaers}
\A {Ren\'e Govaerts}
\A {Joos Vandewalle}
\J {Advances in Cryptology---CRYPTO '89, Proceedings, Lecture Notes in Computer Science (435), Springer-Verlag}
\D {1989}
\X {A critical analysis of the modified cryptographic checksum algorithm of Cohen and Huang points out some weaknesses in the scheme. We show how to exploit these weaknesses with a chosen text attack to derive the first bits of the key. This information suffices to manipulate blocks with a negligible chance of detection.}

\T {Chosen Text Attack on the RSA Cryptosystem and Some Discrete Logarithm Schemes}
\A {Y. Desmedt}
\A {A. M. Odlyzko}
\J {Advances in Cryptology---CRYPTO '85, Proceedings, Lecture Notes in Computer Science (218), Springer-Verlag}
\D {1985}
\X {A new attack on the RSA cryptosystem is presented. This attack assumes less than previous chosen ciphertext attacks, since the cryptanalyst has to obtain the plaintext versions of some carefully chosen ciphertexts only once, and can then proceed to decrypt further ciphertexts without further recourse to the authorized user's decrypting facility. This attack is considerably more efficient than the best algorithm that are known for factoring the public modulus. The same idea can also be used to develop an attack on the three-pass system of transmitting information using exponentiation in a finite field.}

\T {Cipher Systems, The Protection of Communications}
\A {Henry Beker}
\A {Fred Piper}
\J {John Wiley \& Sons}
\D {1982}
\X {Monoalphabetic ciphers, polyalphabetic ciphers, M-209, theortical
cyptography, practical security, perfect secrecy, random ciphers, Shannon,
randomness, linear shift registers, NP-completeness, block ciphers, speech
security, public key cryptography, authentication, RSA, electronic funds
transfer.}

\T {Coin Flipping By Telephone: A Protocol For Solving Impossible Problems}
\A {Manuel Blum}
\J {SIGACT News, {\bf 15,} 1}
\D {1983}
\X {Alice and Bob want to flip a coin by telephone (They have just divorced, live in different cities, want to decide who gets the car.) Bob would not like to tell Alice HEADS and hear Alice (at the other end of the line) say ``Here goes... I'm flipping the coin.... You lost!'' Coin-flipping in the SPECIAL way done here has a serious purpose. Indeed, it should prove an INDISPENSABLE TOOL of the protocol designer. Whenever a protocol requires one of two adversaries, say Alice, to pick a sequence of bits at random, and whenever it serves Alice's interests best NOT to pick her sequence of bits at random, then coin-flipping (Bob flipping coins to Alice) as defined here achieves the desired goal: 1. If GUARANTEES to Bob that Alice will pick her sequence of bits at random. Her bit is 1 if Bob flips heads to her, 0 otherwise. 2. It GUARANTEES to Alice that Bob will not know WHAT sequence of bits he flipped to her. Coin-flipping has already proved useful in solving a number of problems once thought impossible: mental poker, certified mail, and exchange of secrets. It will certainly prove a useful tool in solving other problems as well.}

\T {Collective Coin Flipping, Robust Voting Schemes and Minima of Banzhaf Values}
\A {M. Ben-Or}
\A {N. Linial}
\J {Proc. of the 26th IEEE Symp. on Foundations of Comp. Sc.}
\D {1988}

\T {Collision Free Hash Functions and Public Key Signature Schemes}
\A {Ivan Bjerre Damg{\aa}rd}
\J {Advances in Cryptology---EUROCRYPT '87, Proceedings, Lecture Notes in Computer Science (304), Springer-Verlag}
\D {1987}
\X {In this paper, we present a construction of hash functions. These functions are collision free in the sense that under some cryptographic assumption, it is provably hard for an enemy to find collisions. Assumptions that would be sufficient are the hardness of factoring, of discrete log, or the (possibly) more general assumption about the existence of claw free sets of permutations. The ability of a hash function to improve security and speed of a signature scheme is discussed: for example, we can combine the RSA-system with a collision free hash function based on factoring to get a scheme which is more efficient and much more secure. Also, the effect of combining the Goldwasser-Micali-Rivest signature scheme with one of our functions is studied. In the facotring based implementations of the scheme using a $k$-bit modulus, the signing process can be speeded up by a factor roughly equal to $kO(\log_2(k)),$ while the signature checking process will be faster by a factor of $O(\log_2(k)).$}

\T {The COLOSSUS}
\A {B. Randell}
\J {A History of Computing in the Twentieth Century, N.~Metropolis, J.~Howlett, and G.-C.~Rota (eds.), Academic Press, NY, pp. 47--92}
\D {1980}

\T {A Combinatorial Approach to Threshold Schemes}
\A {D. R. Stinson}
\A {S. A. Vanstone}
\J {Advances in Cryptology---CRYPTO '87, Proceedings, Lecture Notes in Computer Science (293), Springer-Verlag}
\D {1987}
\X {We investigate the combinatorial properties of threshold schemes. Informally, a $(t,w)$-threshold scheme is a way of distributing partial information (shadows) to $w$ participants, so that any $t$ of them can easily calculate a key, but no subset of fewer than $t$ participants can determine the key. Our interest is in {\em perfect\/} threshold schemes: no subset of fewer than $t$ participants can determine any partial information regarding the key. We give a combinatorial characterization of a certain type of perfect threshold scheme. We also investigate the maximum number of keys which a perfect $(t,w)$-threshold scheme can incorporate, as a function of $t,$ $w,$ and the total number of possible shadows, $v.$ This maximum can be attained when there is a Steiner system $S(t,w,v)$ which can be partitioned into Steiner systems $S(t-1,w,v).$ Using known constructions for such Steiner systems, we presemt two new classes of perfect thresholds schemes, and discuss their implementation.}

\T {Combinatorics, Complexity, and Randomness}
\A {Richard M. Karp}
\J {C ACM {\bf 29,} 2}
\D {1986}
\X {Combing through his 25 years of research in the field of combinatorics and
computational complexity, Karp pinpoints the conceptual milestones of his work
and credits the colleagues who have both inspired and influenced him.}

\T {A Comment on Niederreiter's Public Key Cryptosystem}
\A {Bernard Smeets}
\J {Advances in Cryptology---EUROCRYPT '85, Proceedings, Lecture Notes in Computer Science (219), Springer-Verlag}
\D {1985}
\X {In this comment we show that a recently proposed public key cryptosystem is not safe for most of the practical cases. Furthermore, it is shown that the security of this system is closely connected with the problem of computing logarithms over a finite field.}

\T {Communication Security in Remote Controlled Computer Systems}
\A {M. R. Oberman}
\J {Cryptography, Proceedings, Burg Feuerstein 1982, Lecture Notes in Computer Science (149), Springer-Verlag}
\D {1983}
\X {Nowadays remote controlled computer systems are in widespread use. Several systems use the communication facilities offered by the public switched telephone network. In view of the public aspects of the network it is necessary that dial-up systems should have sufficient access security and communication security. In this paper it is proposed that this security be provided by use of cryptography.}

\T {Communication with Secrecy Constraints}
\A {Alon Orlitsky}
\A {Abbas El Gamal}
\J {Proceedings of the 16th Annual ACM Symposium on Theory of Computing}
\D {1984}
\X {Let $x,y,z$ be finite sets, $X,Y$ random variables uniformly distributed over $x\times y,$ $f$ a function from $x\times y$ to $z$ and $0\le\epsilon\le1.$ A person $P_X$ knows $X$ and a person $P_Y$ knows $Y$ and they want to exchange $X$ and $Y.$ An eavesdropper who knows their protocol listens to their communication in order to obtain information about $f(X,Y).$ $P_X$ and $P_Y$ want to ensure that for every value $(x,y)$ of $(X,Y)$ the eavesdropper's a priori and a posteriori probabilities of $\{f(X,Y)=j\}$ are $\epsilon$-close for all $j.$ Therefore, they encrypt some of the transmitted bits. The problem is to find a protocol that minimizes the numbers of bits encrypted in the worst case. Two kinds of protocols are considered: {\em determinisic\/} and {\em randomized.} For deterministic protocols it is shown that for all $x,y,$ Boolean $f(|z|=2)$ and $\epsilon>0,$ there exists a protocol that requires no more than $2\log(1/\epsilon)+16$ bits. An example where $\log(1/\epsilon)-1$ bits must be encrypted is given. For $K$ valued functions $(|z|=K)$ it is shown that at most $C_K(\epsilon)$ bits must be encrypted (independent of $x,y$ and $f$). The results are extended to $N$ persons communicating over a broadcast channel. The proof rely on results concerning partitions of $K$ valued matrices. For randomized Protocols it is shown that for all $x,y$ Boolean $f,$ and all possible joint distributions of $X,Y$ (not only uniform), {\em total secrecy\/} ($\epsilon=0$) can be achieved using only two secret bits.}

\T {Compact Knapsacks Are Polynomial Solvable}
\A {Hamid R. Amirazizi}
\A {Ehud D. Karnin}
\A {Justion M. Reyneri}
\J {SIGACT News, {\bf 15,} 1}
\D {1983}
\X {Extended abstract of Crypto'81 presentation.}

\T {A Compact Linear Prime Number Sieve (Among Others)}
\A {P. Pritchard}
\J {Technical Report: TR81--473, Cornell University}
\D {1981}

\T {Completeness Theorems for Non-Cryptographic Fault-Tolerant Distributed Computing}
\A {Michael Ben-Or}
\A {Shafi Goldwasser}
\A {Avi Wigderson}
\J {Proceedings of the 20th Annual ACM Symposium on Theory of Computing}
\D {1988}
\X {Every function of $n$ inputs can be efficiently computed by a complete network of $n$ processors in such a way that: 1. If no fault occurs, no set of size $t<n/2$ of players gets any additional information (other than the function value), 2. Even if Byzantine faults are allowed, no set of size $t<n/3$ can either disrupt the computation or get additional information. Furthermore, the above bounds on $t$ are tight!}

\T {Complexity Measure for Public-Key Cryptosystems}
\A {Joachim Grollmann}
\A {Alan L. Selman}
\J {SIAM J. on Computing, {\bf 17-2.}}
\D {1988}
\X {A general theory of public-key cryptography is developed that is based on the mathematical framework of complexity theory. Two related approaches are taken to the development of this theory, and these approaches correspond to different but equivalent formulations of the problem of cracking a public-key cryptosystem (PKCS). The first approach is to model the cracking problem as a partial decision problem called a ``promise problem.'' Every $NP$-hard promise is shown to be uniformly $NP$-hard, and a number of results and a conjecture about promise problems are shown to be equivalent to separability assertions for sets in $NP$ that are the natural analogues of well-known results in classical recursion theory. The conjecture, if it is true, implies nonexistence of PCKS having $NP$-hard cracking problems. The second approach represents the cracking problem of a PKCS as a partial computational problem directly. Using this approach, it is shown that one-way functions exists if and only if $P\ne UP$ and that one-way functions with greater cryptographic significance exist if and only if $NP$ contains disjoint $P$-inseparable sets. The paper concludes with a discussion of almost-everywhere security measures for PKCS.}

\T {Complexity Measures for Public-Key Cryptosystems}
\A {J. Grollmann}
\A {A. L. Selman}
\J {Proc. of the 25th IEEE Symp. on Foundations of Comp. Sc., pp. 495-503}
\D {1984}

\T {The Complexity of Perfect Zero-Knowledge}
\A {Lance Fortnow}
\J {Proceedings of the 19th Annual ACM Symposium on Theory of Computing}
\D {1987}
\X {A {\em Perfect Zero-Knowledge\/} interactive proof system convinces a verifier that a string is in a language without revealing any additional knowledge in an information-theoretic sense. We show that for any language that has a perfect zero-knowledge proof system, its complement has a short interactive protocol. This result implies that there are not any perfect zero-knowledge protocols for NP-complete langyages unless the polynomial time hierarchy collapses. This paper demonstrates that knowledge complexity can be used to show that a language is easy to prove.}

\T {A Complexity Theoretic Approach to Randomness}
\A {Michael Sipser}
\J {Proceedings of the 15th Annual ACM Symposium on Theory of Computing}
\D {1983}
\X {We study a time bounded variant of Kolmogorov complexity. This notion, together with universal hashing, can be used to show that problems solvable probabilistically in polynomial time are all within the second level of the polynomial time hierarchy. We also discuss applications to the theory of probabilistic constructions.}

\T {Components and Cycles of a Random Function}
\A {J. M. DeLaurentis}
\J {Advances in Cryptology---CRYPTO '87, Proceedings, Lecture Notes in Computer Science (293), Springer-Verlag}
\D {1987}
\X {This investigation examines the average distribution of the components and cycles of a random function. Here we refer to the mappings from a finite set of, say, $n$ elements into itself; denoted by $\Gamma_n.$ Suppose the elements of $\Gamma_n$ are assigned equal probability, i.e. $P(\gamma)=n^{-n},$ $\gamma\in\Gamma_n.$ The directed graph that is naturally associated with $\gamma$ consists of several components, each with a unique cycle. Define $X_n(s,t)(\gamma)$ as the number of components in $\gamma$ containing at least the fraction $s$ of the total number of nodes, with the size of each component's cycle not exceeding $tn^{1/2}.$ We show that the required expected value of $X_n(s,t)$ can be approximated by the double integral $$EX_n(s,t) = \int_t^1\int_0^s {1\over\sqrt{2\pi}}{e^{-y^2/(2x)}\over\sqrt{x^3(1-x)}}{\rm d}y{\rm d}x.$$ The average number of components of a given size with cycles of a specified length approximately equals the volume under the graph of the integrand. This expression can be used to estimate the probability that a function has a component which contains a significant percentage of the total number of nodes and yet its cycle is relatively small.}

\T {Compression and Ranking}
\A {Andrew V. Goldberg}
\A {Michael Sipser}
\J {Proceedings of the 17th Annual ACM Symposium on Theory of Computing}
\D {1985}
\X {A complexity-theoretic approach to the classical data compression problem is to define a notion of language compression by a machine in a certain complexity class, and to study language classes compressibly under the above definition. Languages that can be compressed efficiently (e.g. by a probabilistic polynomial time machine) are of special interest. We define the notion of language compressibility, and show that sufficiently sparse ``easy'' languages (e.g. polynomial time) can be compressed efficiently. We also define a notion of ranking (which is an optimal compression) and show that some ``very easy'' languages (e.g. unambiguous context-free languages) can be ranked efficiently. We exhibit languages which cannot be compressed or ranked efficiently. The notion of compressibility is closely related to Kolmogorov complexity and randomness. We discuss this relationship and the complexity-theoretic implications of our results.}

\T {Computation of Approximate L-th Roots Modulo $n$ and Application to Cryptography}
\A {Marc Girault}
\A {Philippe Toffin}
\A {Brigitte Vall\'ee}
\J {Advances in Cryptology---CRYPTO '88, Proceedings, Lecture Notes in Computer Science (403), Springer-Verlag}
\D {1988}
\X {The goal of this paper is to give a unified view of various known results (apparently unrealted) about numbers arising in crypto schemes as RSA, by considering them as variants of the computation of approximate L-th roots modulo $n.$ Here one may be interested in a number whose L-th power is ``close'' to a given number, or in finding a number that is ``close'' to its exact L-th root. The paper collectes numerous algorithms which solve problems of this type.}

\T {Computer Crime}
\A {Donn B. Parker}
\A {Susan H. Nycum}
\J {C ACM {\bf 27,} 4}
\D {1984}
\X {Industry experts provide a perspective on present and future dimensions of
the computer security and privacy issue.}

\T {Computer, Crime and Privacy---A National Dilemma, Congressional Testimony
from the Industry}
\J {C ACM {\bf 27,} 4}
\D {1984}
\X {Consists of: Computer Crime by Donn B. Parker and Susan H. Nycum, and
Information System Security and Privacy by Willis H. Ware}

\T {Computer Recreations, A Progress Report on the Fine Art of Turning Literature into Drivel}
\A {Brian Hayes}
\J {Scientific American, {\bf 249,} 5}
\D {1983}

\T {Computer Recreations, How to Handle Numbers with Thousands of Digits, and Why One Might Want To}
\A {Fred Gruenberger}
\J {Scientific American, {\bf 250,} 5}
\D {1984}

\T {Computer Recreations, On Making and Breaking Codes: Part 1}
\A {A. K. Dewdney}
\J {Scientific American, {\bf 259,} 4, pp. 120--123}
\D {1988}
\X {Is it true that one machine can decode what another machine can encode.}

\T {Computer Recreations, On Making and Breaking Codes: Part 2}
\A {A. K. Dewdney}
\J {Scientific American, {\bf 259,} 5, pp. 104--107}
\D {1988}
\X {Computers encode messages by embedding a private key in a public problem.}

\T {Computer Security: A Handbook for Management}
\A {Leonard H. Fine}
\J {Heinemann, London}
\D {1983}
\X {A new approach to computer security: the total security concept, defining a
computer security policy, organization and division of responsibility, physical
and fire security, personnel practices, insurance, systems security,
application security, systems programming and operating standards, the role of
internal and external auditors, disaster recovery planning and testing,
implementing effective computer security.}

\T {Computing Logarithms in Finite Fields of Characteristic Two}
\A {I. F. Blake}
\A {R. Fuji-Hara}
\A {R. C. Mullins}
\A {S. A. Vanstone}
\J {SIAM J. on Algebraic Discrete Methods, {\bf 5}}
\D {1984}

\T {Computing Logarithms in $GF(2^n)$}
\A {I. F. Blake}
\A {R. C. Mullin}
\A {S. A. Vanstone}
\J {Advances in Cryptology---CRYPTO '84, Proceedings, Lecture Notes in Computer Science (196), Springer-Verlag}
\D {1984}

\T {Conjugate Coding}
\A {Stephen Wiesner}
\J {SIGACT News, {\bf 15,} 1}
\D {1983}
\X {This paper treats a class of codes made possible by restrictions on measurement related to the uncertainty principal. Two concrete examples and some general results are given.}

\T {A Constraint Satisfaction Algorithm for the Automated Decryption of Simple Substitution Ciphers}
\A {Michael Lucks}
\J {Advances in Cryptology---CRYPTO '88, Proceedings, Lecture Notes in Computer Science (403), Springer-Verlag}
\D {1988}
\X {This paper describes a systematic procedure for decrypting simple substitution ciphers with word divisions. The algorithm employs an exhaustive search in a large on-line dictionary for words that satisfy constraints on word length, letter position and letter multiplicity. The method does not rely on statistical or semantical properties of English, nor does it use any language-specific heuristics. The system is, in fact, language independent in the sense that it would work equally well over any language for which a sufficiently large dictionary exists on-line. To reduce the potentially high cost of locating all words that contain specified patterns, the dictionary is complied into a database from which groups of words that satisfy simple constraints may be accessed simultaneously. The algorithm (using a relatively small dictionary of 19,000 entries) has been implemented in Franz~Lisp on a Vaz~11/780 computer running 4.3~BSD~Unix. The system is frequently successful in a completely automated mode -- preliminary testing indicates about a 60\% success rate, usually in less than three minutes of CPU time. If it fails, there exist interactive facilities, permitting the user to guide the search manually, that perform very well with minor human intervention.}

\T {A Construction for Authentication / Secrecy Codes from Certain Combinatorial Designs}
\A {D. R. Stinson}
\J {Advances in Cryptology---CRYPTO '87, Proceedings, Lecture Notes in Computer Science (293), Springer-Verlag}
\D {1987}
\X {If we agree to use one of $v$ possible messages to communicate one of $k$ possible states, then an opponent can successfully impersonate a transmitter with probability at least $k/v,$ and can successfully substitute a message with a fraudulent one with probability at least $(k-1)/(v-1).$ We wish to limit an opponent to these bounds. In addition, we desire that the observation of any two messages in the communication channel will give an opponent no clue as to the two source states. We describe a construction for a code which achieves these goals, and which does so with the minimum possible number of encoding rules (namely, $v(v-1)/2$). The construction uses a structure from combinatorial design theory known as a perpendicular array.}

\T {The Contribution of E. B. Fleissner and A.~Figl for Today's Cryptography}
\A {Otto J. Horak}
\J {Advances in Cryptology---EUROCRYPT '85, Proceedings, Lecture Notes in Computer Science (219), Springer-Verlag}
\D {1985}

\T {Controlled Gradual Disclosure Schemes for Random Bits and Their Applications}
\A {Richard Cleve}
\J {Advances in Cryptology---CRYPTO '89, Proceedings, Lecture Notes in Computer Science (435), Springer-Verlag}
\D {1989}
\X {We construct a protocol that enables a secret bit to be revealed gradually in a very controlled manner. In particular, if Alice possesses a bit $S$ that was generated randomly according to the uniform distribution and ${1\over2}<p_1<\cdots<p_m=1$ then, using our protocol with Bob, Alice can achieve the following. The protocol consists of $m$ stages, and after the $i$th stage, Bob's best prediction of $S,$ based on all his interactions with Alice, is correct with probability exactly $p_i$ (and a reasonable condition is satisfied in the case where $S$ is not initially uniform). Furthermore, under an intractability assumption, our protocol can be made ``oblivious'' to Alice and ``secure'' against an Alice or Bob that might try to cheat in various ways. Previously proposed gradual disclosure schemes for single bits release information in a less controlled manner: the probabilities that represent Bob's confidence of his knowledge of $S$ follow a random walk that eventually drifts towards 1, rather than a predetermined sequence of values. Using controlled gradual disclosure schemes, we show how to construct an improved version of the protocol proposed by Luby, Micali and Rackoff for two-party secret bit exchanging that is secure against additional kinds of attacks that the previous protocol is not secure against. Also, out protocol is more efficient in the number of rounds that it requires to attain a given level of security, and is proven to be asymptotically optimal in this respect. We also show how to use controlled gradual disclosure schemes to improve existing protocols for other cryptographic problems, such as multi-party function evaluation.}

\T {The Cornell Commission: On Morris and the Worm}
\A {Ted Eisenberg}
\A {David Gries}
\A {Juris Hartmanis}
\A {Don Holcomb}
\A {M. Stuart Lynn}
\A {Thomas Santoro}
\J {Communications of the ACM, {\bf 32,} 6, pp. 678++}
\D {1989}
\X {After careful examination of the evidence, the Cornell comission publishes its findings in a detailed report that sheds new light and dispels some myths about Robert~T.~Morris and the Internet worm.}

\T {Correcting Faults in Write-Once Memory}
\A {Danny Dolev}
\A {David Maier}
\A {Harry Mairson}
\A {Jeffrey Ullman}
\J {Proceedings of the 16th Annual ACM Symposium on Theory of Computing}
\D {1984}
\X {We consider codes for write-once memory in the presence of stuck-at-0 and stuck-at-1 faults. Such fault-tolerant codes generally require less redundancy than error-correcting codes, as faults detected during the writing process can affect subsequent behavior of that process. We present {\em pointer\/} codes, which use part of a codeword to point to faults in other parts of the codeword. A pointer code can encode $n$-bit messages in the presence of $f$ faults with only $f(\log_2 n +o(1))$ redundancy. We derive a lower bound on the redundancy of such a fault-tolerant code of slightly less than $f\log n.$ We also examine some models where all stuck-at informations is known in advance, and analyze the expected redundancy of pointer codes.}

\T {Correlation Immunity and the Summation Generator}
\A {Rainer A. Rueppel}
\J {Advances in Cryptology---CRYPTO '85, Proceedings, Lecture Notes in Computer Science (218), Springer-Verlag}
\D {1985}
\X {It is known that for a memoryless mapping from $GF(2)^N$ into $GF(2)$ the nonlinear order of the mapping and its correlation-immunity form a linear tradeoff. In this paper it is shown that the same tradeoff does no longer hold when the function is allowed to have memory. Moreover, it is shown that integer addition, when viewed over $GF(2),$ defines an inherently nonlinear function with memory whose correlation-immunity is maximum. The summation generator which sums $N$ binary sequences over the integers is shown as an application of integer addition in random sequence generation.}

\T {Correlation-Immunity of Nonlinear Combining Functions for Cryptographic Applications}
\A {T. Siegenthaler}
\J {IEEE Transactions on Information Theory, {\bf 30,} pp. 776--780}
\D {1984}

\T {Counting Functions Satisfying a Higher Order Strict Avalanche Criterion}
\A {Sheelagh Lloyd}
\J {Advances in Cryptology---EUROCRYPT '89, Proceedings, Lecture Notes in Computer Science (434), Springer-Verlag}
\D {1989}

\T {A Course in Number Theory and Cryptography}
\A {N. Koblitz}
\J {Springer-Verlag}
\D {1987}

\T {Covert Distributed Processing with Computer Viruses}
\A {Steve R. White}
\J {Advances in Cryptology---CRYPTO '89, Proceedings, Lecture Notes in Computer Science (435), Springer-Verlag}
\D {1989}
\X {Computer viruses can be used by their authors to harness the resources of infected machines for the author's computation. By doing so without the permission or knowledge of the machine owners, viruses can be used to perform covert distributed processing. We outline the class of problems for which covert distributed processing can be used. A brute-force attack on cryptosystems is one such problem, and we give estimates of the time required to complete such an attack covertly.}

\T {Critical Analysis of the Security of Knapsack Public Key Algorithms}
\A {Y. Desmedt}
\A {J. Vandewalle}
\A {R. Govaerts}
\J {Abstracts of Papers from IEEE Int. Symp. on Info. Theory, Les Arcs, France, pp. 115--116}
\D {1982}
\J {IEEE Trans. on Info. Theory {\bf IT-30,} pp. 601--611}
\D {1984}

\T {Cryptanalysis: A Survey of Recent Results}
\A {Ernest F. Brickell}
\A {Andrew M. Odlyzko}
\J {Proc. IEEE, {\bf 76,} 5}
\D {1988}
\X {In spite of the progress in computational complexity, it is still true that cryptosystems are tested by subjecting them to cryptanalytic attacks by experts. Most of the cryptosystems that have been publicly proposed in the last decade have been broken. This paper outlines a selection of the attacks that have been used and explains some of the basic tools available to the cryptanalyst. Attacks on knapsack cryptosystems, congruential generators, and a variety of two key secrecy and signature schemes are discussed. There is also a brief discussion of the status of the security of cryptosystems for which there is no known feasible attack, such as the RSA, discrete exponentiation, and DES cryptosystems.}

\T {Cryptanalysis of ADFGVX Encipherment Systems}
\A {Alan G. Konheim}
\J {Advances in Cryptology---CRYPTO '84, Proceedings, Lecture Notes in Computer Science (196), Springer-Verlag}
\D {1984}

\T {Cryptanalysis of a Kryha Machine}
\A {Alan G. Konheim}
\J {Cryptography, Proceedings, Burg Feuerstein 1982, Lecture Notes in Computer Science (149), Springer-Verlag}
\D {1983}

\T {Cryptanalysis of a Modified Rotor Machine}
\A {Peter Wichmann}
\J {Advances in Cryptology---EUROCRYPT '89, Proceedings, Lecture Notes in Computer Science (434), Springer-Verlag}
\D {1989}

\T {Cryptanalysis of DES with a Reduced Number of Rounds: Sequences of Linear Factors in Block Ciphers}
\A {David Chaum}
\A {Jan-Hendrik Evertse}
\J {Advances in Cryptology---CRYPTO '85, Proceedings, Lecture Notes in Computer Science (218), Springer-Verlag}
\D {1985}

\T {Cryptanalysis of F.E.A.L.}
\A {Bert Den Boer}
\J {Advances in Cryptology---EUROCRYPT '88, Proceedings, Lecture Notes in Computer Science (330), Springer-Verlag}
\D {1988}
\X {At Eurocrypt 87 the blockcipher F.E.A.L. was presented. Earlier algorithms called F.E.A.L-1 and F.E.A.L-2 had been submitted to standardization organizations but this was presumably the final version. It is a Feistel cipher, but in contrast to D.E.S., a software implementation does not require a table look-up. The intentions was a fast software implementation and also an avoidance of discussions about random tables. As Walter~Fumy indicated at Cryto~87 a certain transformation on 32 bits used by the cipher was not complete in constrast to a remark made during the presentation of F.E.A.L. at Eurocrypt~87. I am informed that after my informal expose at Crypto~87 about certain vulnerabilities of F.E.A.L., its designers have created F.E.A.L.-8 with twice as many rounds. Later on again versions were renamed. The (definite?) version in the abstracts without a serial number got version 1.00 and F.E.A.L.-8 got version number 2.00 in the proceedings of Eurocrypt~'87. In this paper we shall show that F.E.A.L. as presented at Eurocrypt~87 is vulnerable for a chosen plaintext attack which requires at most ten thousand plaintexts.}

\T {The Cryptanalysis of Knapsack Cryptosystems}
\A {E.F. Brickell}
\J {Proc. of the 3rd SIAM Discrete Mathematics Conf.}
\D {\BB}

\T {A Cryptanalysis of Step$_{k,m}$-Cascades}
\A {Dieter Gollmann}
\A {William G. Chambers}
\J {Advances in Cryptology---EUROCRYPT '89, Proceedings, Lecture Notes in Computer Science (434), Springer-Verlag}
\D {1989}
\X {We examine cascades of clock-controlled shift registers where registers are clocked by more general schemes than simply ``stop-and-go''. In particular, we consider the relation between the stepping function and the number of keys of such a cascade.}

\T {Cryptanalysis of the Data Encryption Standard by the Method of Formal Coding}
\A {Ingrid Schaum\"uller-Bichl}
\J {Cryptography, Proceedings, Burg Feuerstein 1982, Lecture Notes in Computer Science (149), Springer-Verlag}
\D {1983}
\X {The ``Method of Formal Coding'' consists in representing each bit of a DES ciphertext block as an XOR-sum-of-products of the plaintext bits and the key bits. Subsequent introduction of the ``MFC-complexity measure'' yields interesting results on the security of the DES and the influence of various parameters.}

\T {Cryptanalysis of the Dickson-scheme}
\A {Winfred B. M\"uller}
\A {Rupert N\"obauer}
\J {Advances in Cryptology---EUROCRYPT '85, Proceedings, Lecture Notes in Computer Science (219), Springer-Verlag}
\D {1985}

\T {Cryptanalysis of Video Encryption Based On Space-Filling Curves}
\A {Michael Bertilsson}
\A {Ernest F. Brickell}
\A {Ingemar Ingemarsson}
\J {Advances in Cryptology---EUROCRYPT '89, Proceedings, Lecture Notes in Computer Science (434), Springer-Verlag}
\D {1989}
\X {In this paper we cryptanalyze a method for enciphering images constructed by Adi~Shamir and Yossi~Matias. The enciphering is done using space-filling curves. We present an algorithm doing the cryptanalysis. We also present results achieved using the algorithm on a part of an image.}

\T {Cryptanalysts Representation of Nonlinearly Filtered ML-Sequences}
\A {T. Siegenthaler}
\J {Advances in Cryptology---EUROCRYPT '85, Proceedings, Lecture Notes in Computer Science (219), Springer-Verlag}
\D {1985}
\X {A running key generator consisting of a maximum-length (ML) linear feedback shift register (LFSR) and some nonlinear feedforward state filter function is investigated. It is shown how a cryptanalyst can find an equivalent system in a ciphertext-only attack. The analysis uses a Walsh orthogonal expansion of the state filter function and its relation to the crosscorrelation function (CCF) between the ML-sequences and the produced running key sequence.}

\T {A Cryptanalytic Time-Memory Trade Off}
\A {M. E. Hellman}
\J {IEEE Trans. on Information Theory, {\bf IT-26,} pp. 401--406}
\D {1980}

\T {Cryptel - The Practical Protection of an Existing Electronic Mail System}
\A {Hedwig Cnudde}
\J {Advances in Cryptology---EUROCRYPT '89, Proceedings, Lecture Notes in Computer Science (434), Springer-Verlag}
\D {1989}
\X {This paper describes the practical protection of an existing Electronic Mail System using the RSA-algorithm.}

\T {Cryptocomplexity and NP-Completeness}
\A {S. Even}
\A {Y. Yacobi}
\J {Automata, Languages and Programming, 7th Colloquium, Noordwijkerhout, Lecture Notes in Computer Science (85), Springer-Verlag}
\D {1980}
\X {In view of the known difficulty in solving NP-hard problems, a natural question is whether there exist cryptosyste,s which are NP-hard to crack. In Section~1 we display two such systems which are based on the knapsack problem. However, the first one, which is highly ``linear'' had been shown by Lempel to be almost always easy to crack. This shows that NP-hardness of a cryptosystem is not enough. Also, it provides the only natural problem we know of, which is NP-hard and yet almost always easy to solve. The second system is a form of a ``double knapsack'' and so far has resisted the cryptanalysis efforts. In Section~2 a  Public-Key Crypto-System (PKCS) is defined, and evidence is given that no such system can be NP-hard to break. This relates to the work of Brassard, et al., but the definition of PKCS leads us to a different cracking problem, to which Brassard's technique still applies, after proper modification.}

\T {A Crypto-Engine}
\A {George I. Davida}
\A {Frank B. Dancs}
\J {Advances in Cryptology---CRYPTO '87, Proceedings, Lecture Notes in Computer Science (293), Springer-Verlag}
\D {1987}
\X {In this paper we present a design for a crypto-engine. We shall discuss the design and show the instruction set of this coprocessor and then show how this could be used to implement most of the known encryption algorithms. We will discuss why a coprocessor approach may be a better solution than adoption of specific encryption algorithms which can be broken or decertified.}

\T {Cryptographers Gather to Discuss Research}
\A {G. B. Kolata}
\J {Science Magazine {\bf 214,} pp. 646--647}
\D {1981}

\T {Cryptographic Capsules: A Disjunctive Primitive for Interactive Protocols}
\A {Josh Cohen Benaloh}
\J {Advances in Cryptology---CRYPTO '86, Proceedings, Lecture Notes in Computer Science (263), Springer-Verlag}
\D {1987}

\T {Cryptographic Computation: Secure Fault-Tolerant Protocols and the Public-Key Model}
\A {Zvi Galil}
\A {Stuart Haber}
\A {Moti Yung}
\J {Advances in Cryptology---CRYPTO '87, Proceedings, Lecture Notes in Computer Science (293), Springer-Verlag}
\D {1987}
\X {We give a general procedure for designing correct, secure, and fault-tolerant cryptographic protocols for many parties, thus enlarging the domain of tasks that can be performed efficiently by cryptographic means. We model the most general sort of feasible adversarial behaviour, and secribe fault-recovery procedures that can tolerate it. Our constructions minimize the use of cryptographic resources. By applying the complexity-theoretic approach to knowledge, we are able to measure and control the computational knowledge released to the various users, as well as its temporal availability.}

\T {Cryptographic Limitations on Learning Boolean Formulae and Finite Automata}
\A {Michael Kearns}
\A {Leslie G. Valiant}
\J {Proc. of the 21st Annual ACM Symposium on Theory of Computing}
\D {1989}

\T {Cryptographic Sealing for Information Secrecy and Authentication}
\A {David K. Gifford}
\J {C ACM {\bf25,} 4}
\D {1982}
\X {A new protection mechanism is described that provides general primitives
for protection and authentication. The mechanism is based on the idea of
sealing an object with a key. Sealed objects are self-authenticating, and in
the absence of an appropriate set of keys, only provide information about the
size of their contents. New keys can be freely created at any time, and keys
can also be derived from existing keys with operators that include {\em
Key-And\/} and {\em Key-Or\/.} This flexibility allows the protection mechanism
to implement common protection mechanisms such as capabilities, access control
lists, and information flow control. The mechanism is enforced with a synthesis
of conventional cryptography, public-key cryptography, and a threshold scheme.}

\T {The Cryptographic Security of Truncated Linearly Related Variables}
\A {Johan Hastad}
\A {Adi Shamir}
\J {Proceedings of the 17th Annual ACM Symposium on Theory of Computing}
\D {1985}
\X {In this paper we describe a polynomial time algorithm for computing the values of variables $x_1,\ldots,x_k$ when some of their bits and some linear relationships between them are known. The algorithm is essentially optimal in its use of information in the sense that it can be applied as soon as the values of the $x_i$ become uniquely determined by the constraints. Its cryptanalytic significance is demonstrated by two applications: breaking linear congruential generators whose outputs are truncated, and breaking Blum's protocol for exchanging secrets.}

\T {Cryptography}
\A {D. Coppersmith}
\J {IBM J. of Research and Development {\bf 31,} pp. 244--248}
\D {1987}

\T {Cryptography and Data Security}
\A {Dorothy Elizabeth Robling Denning}
\J {Addison-Wesley Publishing Company}
\D {1982}
\X {1. Introduction, introduces the basic concepts of cryptography, data security, information theory, complexity theory, and number theory. 2. Encryption Algorithms, describes both classical and modern encryption algorithms, including the Data Encryption Standard (DES) and public-key algorithms. 3. Cryptographic Techniques, studies various techniques related to integrating cryptographic controls into computer systems, including key management. 4. Access Controls, describes the basic principles of mechanisms that control access by subjects (e.g., users or programs) to objects *e.g., files and records). These mechanisms regulate direct access to objects, but not what happens to the information contained in these objects. 5. Information Flow Controls, describes controls that regulate the dissemination of information. These controls are needed to prevent programs from leaking confidential data, or from disseminating classified date to users with lower security clearances. 6. Inference Controls, describes controls that protect confidential data released as statistics about subgroups of individuals.}

\T {Cryptography: A New Dimension in Computer Data Security}
\A {C. H. Meyer}
\A {S. M. Matyas}
\J {John Wiley \& Sons, New York, NY}
\D {1982}

\T {Cryptography: A Primer}
\A {A. G. Konheim}
\J {John Wiley \& Sones, New York, NY}
\D {1981}

\T {Cryptography in the Private Sector}
\A {D. B. {Newman Jr.}}
\A {R. L. Pickholtz}
\J {IEEE Communications Magazine {\bf 24,} pp. 7--10}
\D {1986}

\T {Cryptography with Cellular Automata}
\A {Stephen Wolfram}
\J {Advances in Cryptology---CRYPTO '85, Proceedings, Lecture Notes in Computer Science (218), Springer-Verlag}
\D {1985}

\T {Cryptology}
\A {G. Brassard}
\J {Encylcopaedia of Mathematics, {\bf 2,} D.~Reidel Publishing Company}
\D {1988}

\T {Cryptology and Complexity Theories}
\A {G. Ruggiu}
\J {Advances in Cryptology---EUROCRYPT '84, Proceedings, Lecture Notes in Computer Science (209), Springer-Verlag}
\D {1984}
\X {Complexity Theories have recently been proposed as a basis for evaluation of crypto machine performance. They are compared to Shannon's model. They shed a new highlight on randomness notion. But it is stressed that the statistical point of view remains the more secure.}

\T {Cryptology In Academia: A Ten Year Perspective}
\A {G. Brassard}
\J {Proc. of the 29th IEEE Computer Conference (CompCon), pp. 222--226}
\D {1987}

\T {Cryptology In Transistion}
\A {A. Lempel}
\J {ACM Computing Surveys {\bf 11,} pp. 285--303}
\D {1979}

\T {Cryptology --- Methods and Maxims}
\A {Friedrich L. Bauer}
\J {Cryptography, Proceedings, Burg Feuerstein 1982, Lecture Notes in Computer Science (149), Springer-Verlag}
\D {1983}
\X {This paper gives a survey of classical cryptographic methods and of the maxims to their proper use in order to resist illegitimate decryption, as a basis for an understanding of modern commercial, computer-based cryptographic systems and for a critical analysis of those.}

\T {Cryptoprotocols: Subscription to a Public Key, the Secret Blocking and the Multi-Player Mental-Poker Game}
\A {Mordechai Yung}
\J {Advances in Cryptology---CRYPTO '84, Proceedings, Lecture Notes in Computer Science (196), Springer-Verlag}
\D {1984}
\X {Investigating the capabilities of public key and related cryptographic techniques has recently become an important area of cryptographic research. In this paper we present some new algorithms and cryptographic protocols ({\em Cryptoprotocols\/}) which enlarge the range of applications of public key systems and enable us to perform certain transactions in cummunication networks. The basic cryptographic tools used are Rabin's {\em Oblivious Transfer Protocol\/} and an algorithm we developed for {\em Number Embedding\/} which is provably hard to invert. We introduce the protocol {\em Subscription to a Public Key,} which gives a way to transfer keys over insecure communication channels and has useful applications to cryptosystems. We develop the {\em Secret Blocking Protocol,} specified as follows: `A transfers a secret to B, B can block the message. If B does not block it, there is a probability $P$ that he might get it. ($1/2\le P<1,$ where we can control the size of $P$). A does not know if the message was blocked (but he can find out later)'. The classic cryptotransaction is the {\bf Mental Poker Game.} A cryptographically secure solution to the {\bf Multi Player\/} Mental Poker Game is given. The approach used in constructing the solution provides a general methodology of provable and modular {\bf Protocol Composition.}}

\T {Cryptosystem Based On an Analog of Heat Flow}
\A {G. R. Blakley}
\A {William Rundell}
\J {Advances in Cryptology---CRYPTO '87, Proceedings, Lecture Notes in Computer Science (293), Springer-Verlag}
\D {1987}

\T {The Cuckoo's Egg: Tracing a Spy Through the Maze of Computer Espionage}
\A {Cliff Stoll}
\J {Doubleday}
\D {1989}

\T {Cycle Structure of the DES with Weak and Semi-Weak Keys}
\A {Judy H. Moore}
\A {Gustavus J. Simmons}
\J {Advances in Cryptology---CRYPTO '86, Proceedings, Lecture Notes in Computer Science (263), Springer-Verlag}
\D {1987}

\T {A Database Encryption Scheme Which Allows the Computation of Statistics Using Encrypted Data}
\A {G. R. Blakley}
\A {C. Meadows}
\J {Proc. of IEEE Symp. on Comp. Security and Privacy}
\D {1985}

\T {Data Compression Using Dynamic Markov Modelling}
\A {G. V. Cormack}
\A {R. N. S. Horspool}
\J {The Computer Journal, {\bf 30,} 6}
\D {1987}
\X {A method of dynamically constructing Markov chain models that describe the characteristics of binary messages is developed. Such mpdels can be used to predict future message characters and can therefore be used as a basis for data compression. To this end, the Markov modelling technique is combined with Guazzo's arithmetic coding scheme to produce a powerful method of data compression. The method has the advantage of being adaptive: messages may be encoded or decoded with just a single pass through the data. Experimental results reported here indicate that the Markov modelling approach generally achieves much better data compression than that observed with competing methods on typical computer data.}

\T {The Data Encryption Standard: Past and Future}
\A {Miles E. Smid}
\A {Dennis K. Branstad}
\J {Proc. IEEE, {\bf 76,} 5}
\D {1988}
\X {The Data Encryption Standard (DES) is the first, and to the present date, only, publicly available cryptographic algorithm that has been endorsed by the U.S. Government. This paper deals with the past and future of the DES. It discusses the forces leading to the development of the standard during the early 1970s, the controversy regarding the proposed standard during the mid-1970s, the growing acceptance and use of the standard in the 1980s, and some recent developments that could affect the future of the standard.}

\T {Deciphering Bronze Age Scripts of Crete: The Case of Linear A}
\A {Yves Duhoux}
\J {Advances in Cryptology---EUROCRYPT '89, Proceedings, Lecture Notes in Computer Science (434), Springer-Verlag}
\D {1989}

\T {Decrypting a Class of Stream Ciphers Using Ciphertext Only}
\A {T. Siegenthaler}
\J {IEEE Trans. on Computers, {\bf 34,} pp. 81--84}
\D {1985}

\T {Demonstrating Possession of a Discrete Logarithm Without Revealing It}
\A {David Chaum}
\A {Jan-Hendrik Evertse}
\A {Jeroen {van de Graaf}}
\A {Ren\'e Peralta}
\J {Advances in Cryptology---CRYPTO '86, Proceedings, Lecture Notes in Computer Science (263), Springer-Verlag}
\D {1987}
\X {Techniques are presented that allow $A$ to convince $B$ that she knows a solution to the Discrete Log Problem---i.e. that she knows an $x$ such that $\alpha^x\equiv\beta(\mod N)$ holds---without revealing anything about $x$ to $B.$ Protocols are given both for $N$ prime and for $N$ composite. We prove these protocols secure under a formal model which is of interest in its own right. We also show how $A$ can convince $B$ that two elements $\alpha$ and $\beta$ generate the same subgroup in $Z_N^*,$ without revealing how to express either as a power of the other.}

\T {Demonstrating that a Public Predicate can be Satisfied Without Revealing Any Information About How}
\A {David Chaum}
\J {Advances in Cryptology---CRYPTO '86, Proceedings, Lecture Notes in Computer Science (263), Springer-Verlag}
\D {1987}

\T {Department of Defense ({DoD}) Password Management Guidelines}
\A {{Department of Defense}}
\J {Department of Defense, CSC-STD-002-85}
\D {1985}

\T {Design of Combiners to Prevent Divide and Conquer Attacks}
\A {T. Siegenthaler}
\J {Advances in Cryptology---CRYPTO '85, Proceedings, Lecture Notes in Computer Science (218), Springer-Verlag}
\D {1985}
\X {A finite state machine driven by $n$ independent sources each generating a $q$-ary sequence is investigated. The $q$-ary output sequence of that device is considered as the running-key sequence in a stream cipher. Possible definitions for Correlation-Immunity are discussed and a simple condition is given which ensures that divide-and-conquer attacks on such generators are prevented.}

\T {Dependence of Output on Input in DES: Small Avalanche Characteristics}
\A {Yvo Desmedt}
\A {Jean-Jacques Quisquater}
\A {Marc Davio}
\J {Advances in Cryptology---CRYPTO '84, Proceedings, Lecture Notes in Computer Science (196), Springer-Verlag}
\D {1984}
\X {New general properties in the $S$-boxes were found. Techniques and theorems are presented which allow to evaluate the non-substitution effect in $f$ and the key clustering in DES. Examples are given. Its importance related to the security of DES is discussed.}

\T {A Description of a Single-Chip Implementation of the RSA Cipher}
\A {R. L. Rivest}
\J {LAMBDA Magazine {\bf 1,} pp. 14--18}
\D {1980}

\T {DES Has No Per Round Linear Factors}
\A {J. A. Reeds}
\A {J. L. Manferdelli}
\J {Advances in Cryptology---CRYPTO '84, Proceedings, Lecture Notes in Computer Science (196), Springer-Verlag}
\D {1984}
\X {Interest in the cryptanalysis of the National Bureau of Standards' Data Encryption Standard (DES) has been strong since its announcement. Here we describe an attack on a class of ciphers like DES based on linear factors. If DES had any non trivial factors, these factors would provide an easier attack than one based on complete enumeration. Basically, a factor of order $n$ reduces the cost of a solution from $2^{56}$ to $2^n+2^{56-n}.$ At worst ($n=1$ or 55), this reduces the cost of a Diffie-Hellman search machine from 20 million dollars to 10 million dollars: a 10 million dollar savings. At best ($n=28$), even without iteration, the method could reduce the cost from $2^{56}$ to $2^{28}+2^{28}:$ a computation well within the reach of a personal computer. Alas, DES has no such linear factors.}

\T {A Design Principle for Hash Functions}
\A {Ivan Bjerre Damg{\aa}rd}
\J {Advances in Cryptology---CRYPTO '89, Proceedings, Lecture Notes in Computer Science (435), Springer-Verlag}
\D {1989}
\X {We show that if there exists a computationally collision free function $f$ from $m$ bits to $t$ bits where $m>t,$ then there exists a computationally collision free function $h$ mapping messages of {\em arbitrary\/} polynomial lengths to $t$-bit strings. Len $n$ be the length of the message. $h$ can be constructed wither such that it can be evaluated in time linear in $n$ using 1 processor, or such that it takes time $O(\log(n))$ using $O(n)$ processors, counting evaluations of $f$ as one step. Finally, for any constant $k$ and large $n,$ a speedup by a factor of $k$ over the first construction is available using $k$ processors. Apart from suggesting a generally sound design principle for hash functions, our results give a unified view of several apparently unrelated constructions of hash functions proposed earlier. It also suggests changes to other proposed constructions to make a proof of security potentially easier. We give three concrete examples of constructions, based on modular squaring, on Wolfram's pseudorandom bit generator, and on the knapsack problem.}

\T {DES Modes of Operation}
\A {NBS}
\J {Federal Information Processing Standard, U.S. Dept. of Commerce, FIPS PUB 81, Washington DC}
\D {1980}

\T {DES Will Be Totally Insecure Within Ten Years}
\A {Martin E. Hellman}
\J {IEEE Spectrum, July}
\D {1979}

\T {The Detection of Cheaters in Threshold Schemes}
\A {E. F. Brickell}
\A {D. R. Stinson}
\J {Advances in Cryptology---CRYPTO '88, Proceedings, Lecture Notes in Computer Science (403), Springer-Verlag}
\D {1988}
\X {Informally, a $(t,w)$-{\em threshold scheme\/} is a way of distributing partial information ({\em shadows\/}) to $w$ participants, so that any $t$ of them can easily calculate a {\em key\/} (or {\em secret\/}), but no subset of fewer than $t$ participants can determine the key. In this paper, we present an unconditionally secure threshold scheme in which any cheating participant can be detected and identified with high probability by any honest participant, even if the cheater is in coalition with other participants. We also give a construction that will detect with high probability a dealer who distributes inconsistent shadows (shares) to the honest participants. Our scheme is not perfect; a set of $t-1$ participants can rule out at most $\displaystyle 1+{w-t+1\choose t-1}$ possible keys, given the information they have. In our scheme, the key will be an element of $GF(q)$ for some prime power $q.$ Hence, $q$ can be chosen large enough so that the amount of information obtained by any $t-1$ participants is negligible.}

\T {Detection of Disrupters in the DC Protocol}
\A {Jurjen Bos}
\A {Bert den Boer}
\J {Advances in Cryptology---EUROCRYPT '89, Proceedings, Lecture Notes in Computer Science (434), Springer-Verlag}
\D {1989}

\T {Developing an RSA Chip}
\A {Martin Kochanski}
\J {Advances in Cryptology---CRYPTO '85, Proceedings, Lecture Notes in Computer Science (218), Springer-Verlag}
\D {1985}
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
