basvandorst/cryptography-archive/ACEAgentNS_aix/securid/acedocs/ace00007.gif

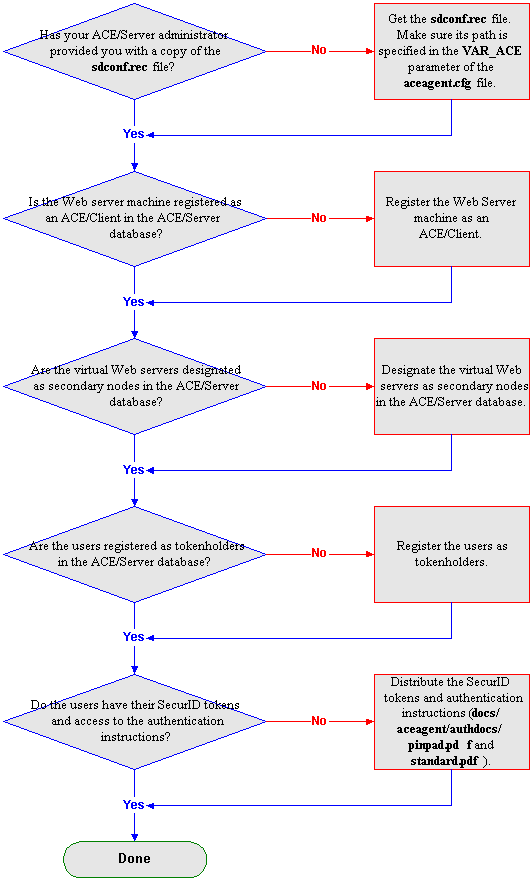
ACEAgentNS_aix/securid/acedocs/ace00007.gif
