basvandorst/cryptography-archive/ACEAgentNS_hpux/securid/acedocs/files.gif

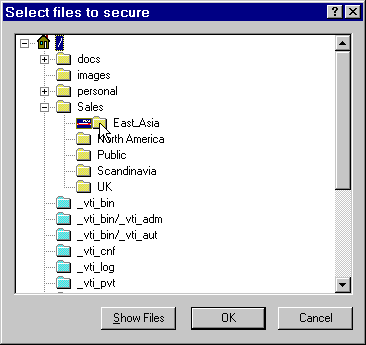
ACEAgentNS_hpux/securid/acedocs/files.gif
