basvandorst/cryptography-archive/ACEAgentNS_hpux/securid/acedocs/sd96large.gif

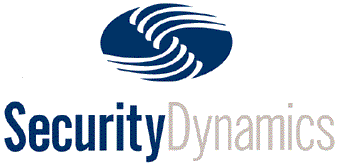
ACEAgentNS_hpux/securid/acedocs/sd96large.gif
