basvandorst/cryptography-archive/ACEAgentNS_hpux/securid/acedocs/snow.gif

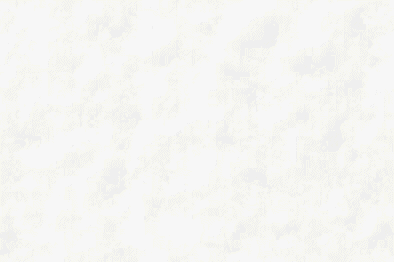
ACEAgentNS_hpux/securid/acedocs/snow.gif
