basvandorst/cryptography-archive/CAVE/tr453/tr242.jpg

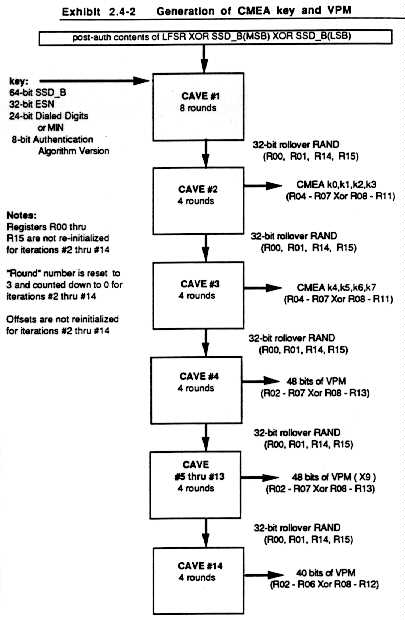
CAVE/tr453/tr242.jpg
