basvandorst/cryptography-archive/fn145os2/fn145os2/images/compare.gif

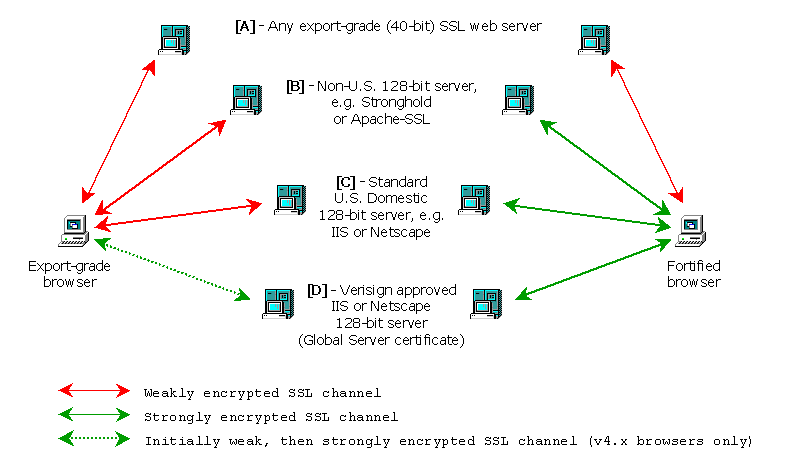
fn145os2/fn145os2/images/compare.gif
