basvandorst/cryptography-archive/fn145os2/fn145os2/images/prefs3e.gif

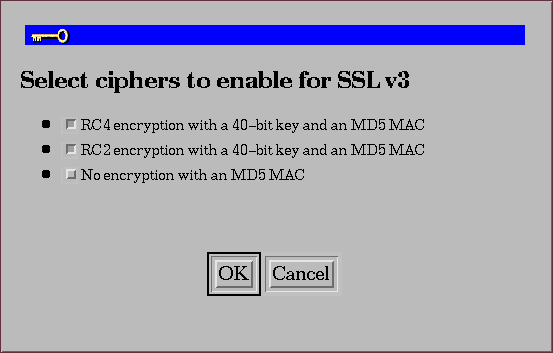
fn145os2/fn145os2/images/prefs3e.gif
