basvandorst/cryptography-archive/fn145os2/fn145os2/images/prefs4e.gif

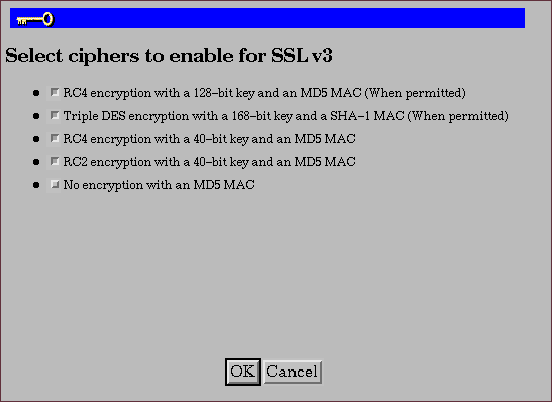
fn145os2/fn145os2/images/prefs4e.gif
