basvandorst/cryptography-archive/fn145os2/fn145os2/images/prefs4f.gif

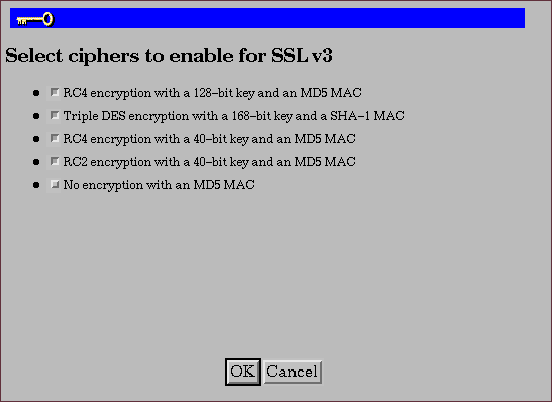
fn145os2/fn145os2/images/prefs4f.gif
