basvandorst/cryptography-archive/fn145os2/fn145os2/images/smime4f.gif

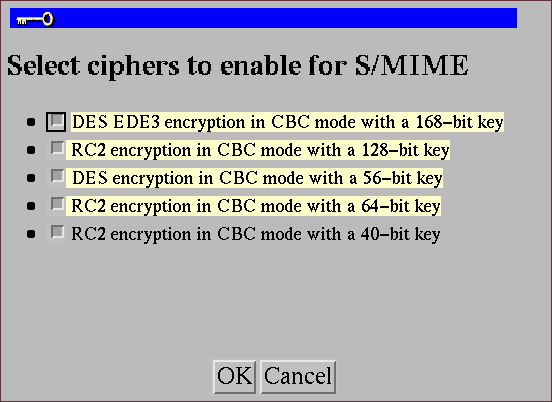
fn145os2/fn145os2/images/smime4f.gif
