basvandorst/cryptography-archive/hdsk41/ARDALABW.GIF

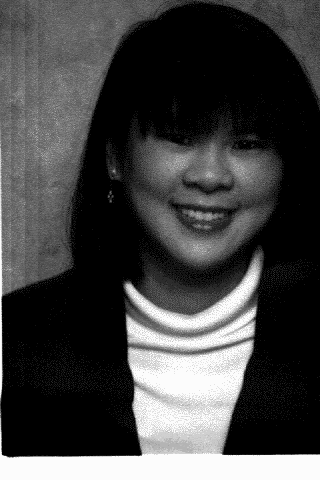
hdsk41/ARDALABW.GIF
