basvandorst/cryptography-archive/pgp50i-win95nt-src/pgp50i-src/win32/PGPkeys/Res/kgwiz1bit.bmp

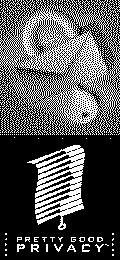
pgp50i-win95nt-src/pgp50i-src/win32/PGPkeys/Res/kgwiz1bit.bmp
