basvandorst/cryptography-archive/pgp55win95nt-src/pgp55/clients/pgp/win32/PGPcmdlg/Res/eval1bit.bmp

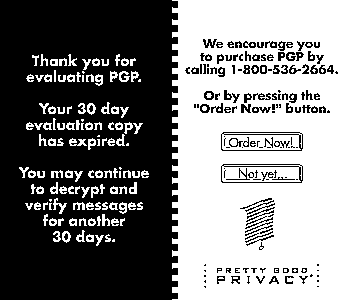
pgp55win95nt-src/pgp55/clients/pgp/win32/PGPcmdlg/Res/eval1bit.bmp
