basvandorst/cryptography-archive/PGP602_BR/key_sign_more.gif

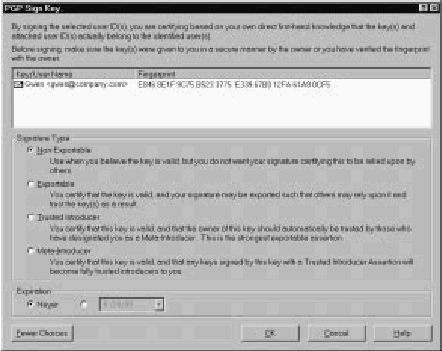
PGP602_BR/key_sign_more.gif
