basvandorst/cryptography-archive/PGP602_BR/passphrase_new.gif

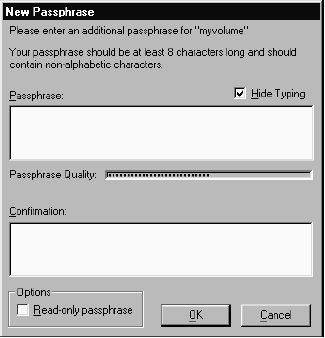
PGP602_BR/passphrase_new.gif
