basvandorst/cryptography-archive/PGP602_BR/pgpkeys_general.gif

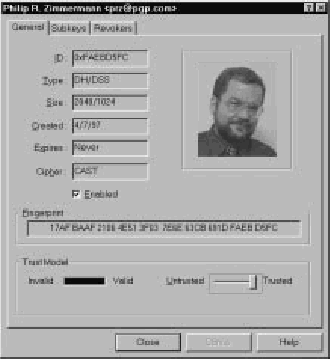
PGP602_BR/pgpkeys_general.gif
