basvandorst/cryptography-archive/PGP602_BR/preferences_servers.gif

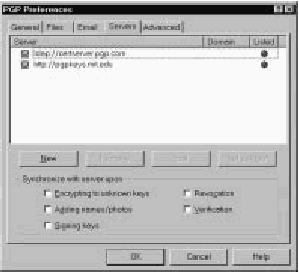
PGP602_BR/preferences_servers.gif
