basvandorst/cryptography-archive/PGP602_BR/remote_authentication.gif

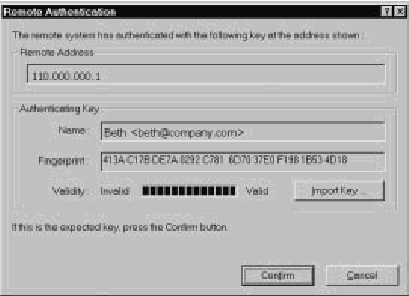
PGP602_BR/remote_authentication.gif
