basvandorst/cryptography-archive/PGP602_BR/share_collection.gif

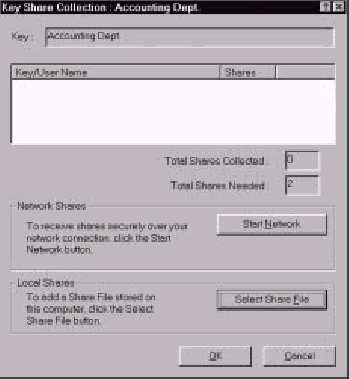
PGP602_BR/share_collection.gif
