basvandorst/cryptography-archive/pgp651i-win-src/pgp651i/clients/disk/win32/PGPdiskApp/Res/Sidebar1.bmp

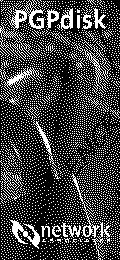
pgp651i-win-src/pgp651i/clients/disk/win32/PGPdiskApp/Res/Sidebar1.bmp
