basvandorst/cryptography-archive/pgp651i-win-src/pgp651i/clients/pgp/win32/PGPcl/Res/qmark.bmp

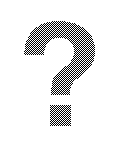
pgp651i-win-src/pgp651i/clients/pgp/win32/PGPcl/Res/qmark.bmp
