basvandorst/cryptography-archive/pgp651i-win-src/pgp651i/clients/pgp/win32/PGPcl/Res/rsacredits1bit.bmp

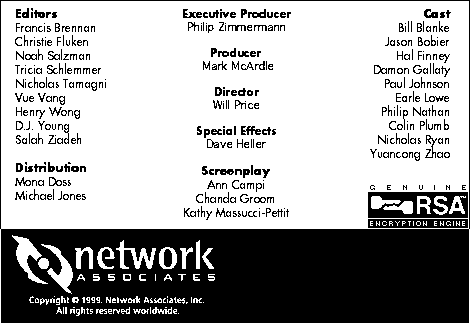
pgp651i-win-src/pgp651i/clients/pgp/win32/PGPcl/Res/rsacredits1bit.bmp
