basvandorst/cryptography-archive/pgp651i-win-src/pgp651i/clients/pgp/win32/PGPsc/res/md13x24.bmp

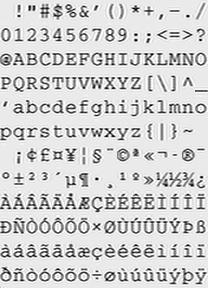
pgp651i-win-src/pgp651i/clients/pgp/win32/PGPsc/res/md13x24.bmp
