basvandorst/cryptography-archive/pgp651i-win-src/pgp651i/clients/pgp/win32/PGPsc/res/wipesidebar8.bmp

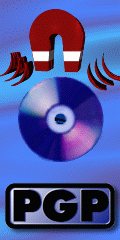
pgp651i-win-src/pgp651i/clients/pgp/win32/PGPsc/res/wipesidebar8.bmp
