basvandorst/cryptography-archive/PGPlib-1/PGPlib-1.1/applications/tromso.jpg

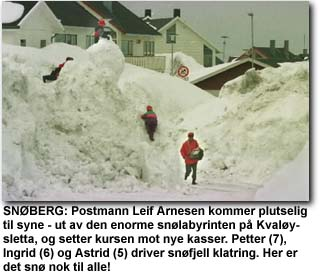
PGPlib-1/PGPlib-1.1/applications/tromso.jpg
