basvandorst/cryptography-archive/skipjack-spec/ske09.jpg

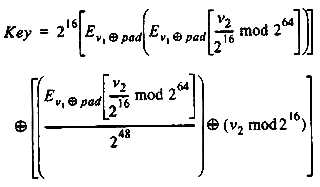
skipjack-spec/ske09.jpg
