basvandorst/cryptography-archive/skipjack-spec/ske10.jpg

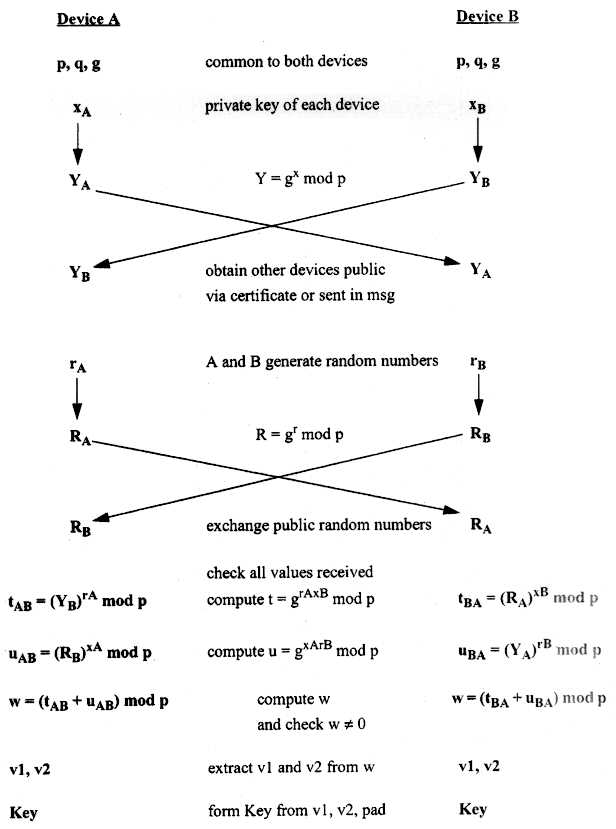
skipjack-spec/ske10.jpg
