basvandorst/cryptography-archive/skipjack-spec/ske22.jpg

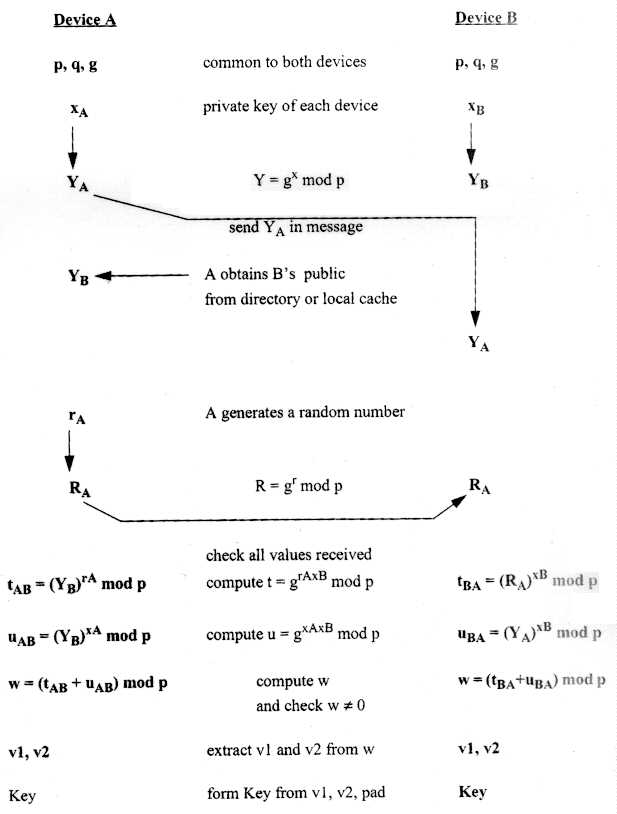
skipjack-spec/ske22.jpg
