basvandorst/cryptography-archive/skipjack-spec/skf01.jpg

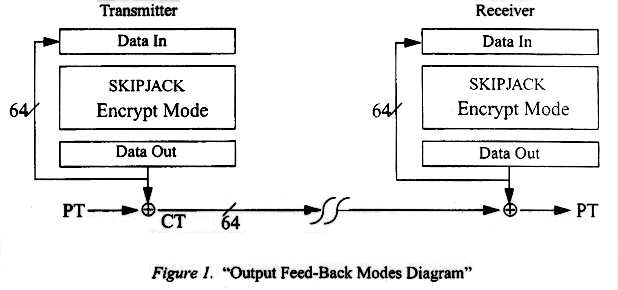
skipjack-spec/skf01.jpg
