basvandorst/cryptography-archive/skipjack-spec/skf05.jpg

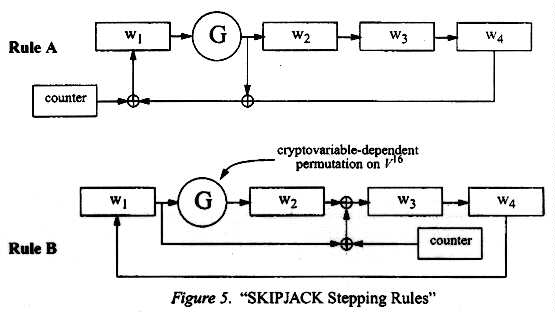
skipjack-spec/skf05.jpg
