basvandorst/cryptography-archive/skipjack-spec/skf06.jpg

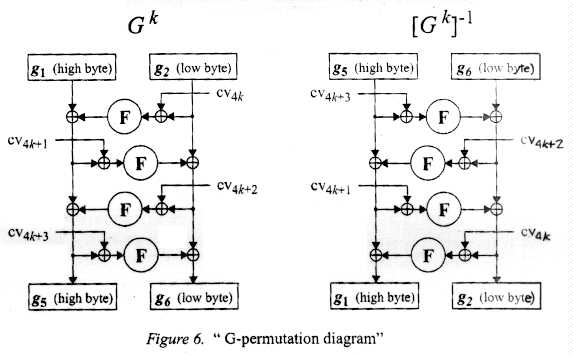
skipjack-spec/skf06.jpg
