basvandorst/cryptography-archive/skipjack-spec/skf07.jpg

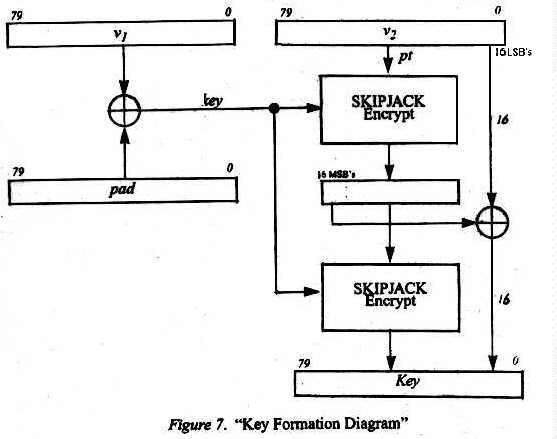
skipjack-spec/skf07.jpg
