basvandorst/cryptography-archive/skipjack-spec/skf08.jpg

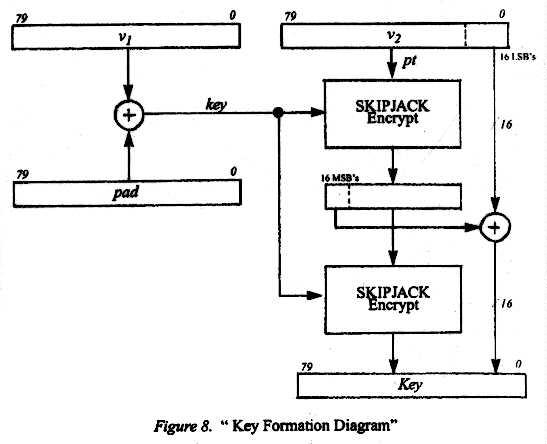
skipjack-spec/skf08.jpg
