basvandorst/cryptography-archive/skipjack-spec/skf0234.jpg

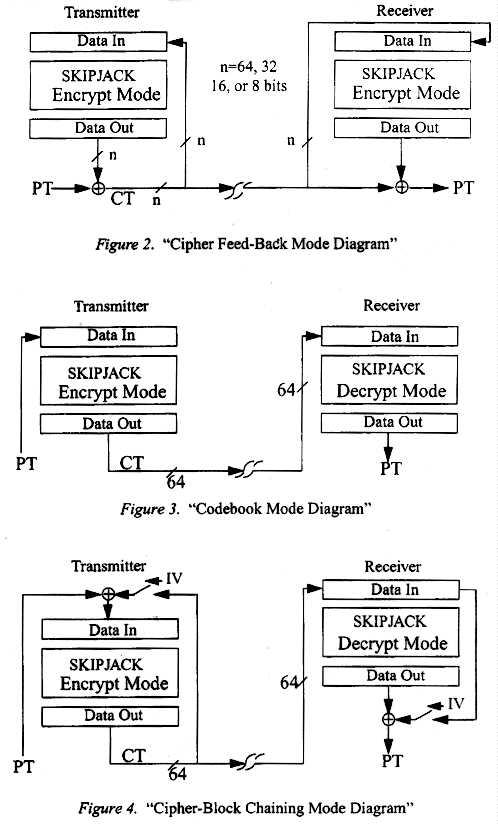
skipjack-spec/skf0234.jpg
