basvandorst/cryptography-archive/cipher2/ORDERFRM.TXT

  INSTANT REGISTRATION FORM
  Just copy this file to your printer, fold, tape, and mail.
  See CIPHER.TXT for program descriptions.

   Quantity  Description                   Price Total
  +--------+------------------------------+-----+-----+
  |        | "Deluxe" CIPHER              | $22 |     |
  +--------+------------------------------+-----+-----+   CIPHER v2.0 was
  |        | CIPHER                       | $15 |     |   acquired from:
  +--------+------------------------------+-----+-----+
  |        | CIPHER puzzle collection #1  | $5  |     |
  +--------+------------------------------+-----+-----+    [ ] friend
  |        | CIPHER puzzle collection #2  | $5  |     |    [ ] free BBS
  +--------+------------------------------+-----+-----+    [ ] pay BBS
  |        | "Deluxe" EGATrek             | $22 |     |    [ ] disk vendor
  +--------+------------------------------+-----+-----+    [ ] user group
  |        | EGATrek                      | $15 |     |    [ ] other
  +--------+------------------------------+-----+-----+
  |        | "Deluxe" Mah Jongg           | $22 |     |   Name of vendor,
  +--------+------------------------------+-----+-----+   BBS, etc.:
  |        | Mah Jongg                    | $15 |     |
  +--------+------------------------------+-----+-----+   __________________
  |        | Mah Jongg tile sets--4 avail.| $5  |     |
  +--------+------------------------------+-----+-----+   
  |        | "Deluxe" Shooting Gallery    | $22 |     |   SEND TO:
  +--------+------------------------------+-----+-----+    Nels Anderson
  |        | Shooting Gallery             | $15 |     |    92 Bishop Drive
  +--------+------------------------------+-----+-----+    Framingham, MA
  |        | "Deluxe" SuperFly            | $22 |     |    01701-6540
  +--------+------------------------------+-----+-----+
  |        | SuperFly                     | $15 |     |
  +--------+------------------------------+-----+-----+   SHIPPING:  $2 if
  |        | BassMap                      | $10 |     |   ordering only non-
  +--------+------------------------------+-----+-----+   deluxe programs.
  |        | Extra charge for 3.5" disks  | $2  |     |   $4 for deluxe ver-
  +--------+------------------------------+-----+-----+   sions and shipping
                        SHIPPING/HANDLING |$2/$4|     |   outside of North
                                          +-----+-----+   America.
  Minimum credit card order: $15          TOTAL |     |
  Make checks payable to: Nels Anderson         +-----+
  
  Disk Size:  ___ 5.25"  ___ 3.5" (add $2 extra for each 3.5" disk ordered)
  
  Payment:  _____ Check (U.S. funds only)   ______ VISA   ______ MasterCard
  
  Card Number:  _______ _______ _______ _______  Expiration Date:  ________
  
  Signature:  _________________________ (credit card orders must be signed)
  
  Name:  __________________________________________________________________
  
  Address:  _______________________________________________________________
  
  City/State/Zip:  ________________________________________________________

  Comments, suggestions:

  CIPHER V2.0
                                                                  +-----+
                                                                  |Place|
                                                                  |Stamp|
                                                                  |Here!|
                                                                  +-----+

                              Nels Anderson
                              92 Bishop Drive
                              Framingham, MA 01701-6540
