basvandorst/cryptography-archive/(list of files, cad)

Other CAD files:
bf-sdk11/BFENG386.OBJ
cryptl200/BNLIB/LBN8086.OBJ
hpwd/demo.obj
md5-karn/md5trans.obj
md5asm32/getcpu.obj
mfloat20/MFLOATA.OBJ
nsea/NSEA.OBJ
PGPlib-1/PGPlib-1.1/SSLeay/crypto/bn/asm/x86w32.obj
PGPlib/PGPlib-1.1/SSLeay/crypto/bn/asm/x86w32.obj
proctype/proctype.obj
ripem-1/ripem/main/proctype.obj
ripem-2/ripem/main/proctype.obj
ripem11a/ripem/main/proctype.obj
season13/SRC/ASYNC.OBJ
SSLeay-0/SSLeay-0.8.1b/crypto/bf/asm/b-win32.obj
SSLeay-0/SSLeay-0.8.1b/crypto/bn/asm/x86w16.obj
SSLeay-0/SSLeay-0.8.1b/crypto/des/asm/d-win32.obj
SSLeay-0/SSLeay-0.9.0b/crypto/bf/asm/b-win32.obj
SSLeay-0/SSLeay-0.9.0b/crypto/bn/asm/x86w32.obj
SSLeay-0/SSLeay-0.9.0b/crypto/cast/asm/c-win32.obj
SSLeay-0/SSLeay-0.9.0b/crypto/des/asm/d-win32.obj
SSLeay-0/SSLeay-0.9.0b/crypto/md5/asm/m5-win32.obj
SSLeay-0/SSLeay-0.9.0b/crypto/rc4/asm/r4-win32.obj
SSLeay-0/SSLeay-0.9.0b/crypto/rc5/asm/r5-win32.obj
SSLeay-0/SSLeay-0.9.0b/crypto/ripemd/asm/rm-win32.obj
SSLeay-0/SSLeay-0.9.0b/crypto/sha/asm/s1-win32.obj
videocrypt-season13/SRC/ASYNC.OBJ
wnstorm/WNSTORM.OBJ
crypl200/BNLIB/LBN8086.OBJ
hpwd/hpwd.obj
md5asm32/md5.obj
mfloat20/MFLOATB.OBJ
PGPlib-1/PGPlib-1.1/SSLeay/crypto/bn/asm/x86w16.obj
PGPlib/PGPlib-1.1/SSLeay/crypto/bn/asm/x86nt32.obj
SSLeay-0/SSLeay-0.8.1b/crypto/bn/asm/x86w32.obj
SSLeay-0/SSLeay-0.8.1b/crypto/des/asm/c-win32.obj
SSLeay-0/SSLeay-0.9.0b/crypto/bn/asm/bn-win32.obj
SSLeay-0/SSLeay-0.9.0b/crypto/des/asm/y-win32.obj
PGPlib-1/PGPlib-1.1/SSLeay/crypto/bn/asm/x86nt32.obj
PGPlib/PGPlib-1.1/SSLeay/crypto/bn/asm/x86w16.obj
SSLeay-0/SSLeay-0.8.1b/crypto/bn/asm/x86nt32.obj
crypl200/BNLIB/LBN80386.OBJ
cryptl200/BNLIB/LBN80386.OBJ
