basvandorst/cryptography-archive/enigma-wiring/enigma-wiring.txt

[Note: An implementation of the Enigma in BASIC can be found
on ripem.msu.edu in pub/crypt/other.]

From msuinfo!caen!spool.mu.edu!howland.reston.ans.net!zaphod.mps.ohio-state.edu!darwin.sura.net!newsserver.jvnc.net!yale.edu!ira.uka.de!scsing.switch.ch!dxcern!frode Tue Feb  9 22:17:25 1993
Newsgroups: sci.crypt
Path: msuinfo!caen!spool.mu.edu!howland.reston.ans.net!zaphod.mps.ohio-state.edu!darwin.sura.net!newsserver.jvnc.net!yale.edu!ira.uka.de!scsing.switch.ch!dxcern!frode
From: frode@dxcern.cern.ch (Frode Weierud)
Subject: Re: Enigma Machine
Message-ID: <1993Feb9.161155.16684@dxcern.cern.ch>
Reply-To: frode@dxcern.cern.ch
Organization: CERN European Lab for Particle Physics
References: <SR.93Feb7171045@zen.mp.co.umist.ac.uk> <1993Feb9.112216.11734@hsr.no>
Distribution: sci
Date: Tue, 9 Feb 1993 16:11:55 GMT
Lines: 73

In <1993Feb9.112216.11734@hsr.no> frank@hsr.no (Frank A Stevenson) writes:

>	For historical reasons the Enigma is a very interesting cipher, and one
>would expect that all details of its working should be widely known. I have tried
>to get information on the excact wiring an operation of the rotors in order to
>make a working software emulation of the famous Enigma. But I haven't found any
>information about this. If anyone could point me to sources describing the
>permutations, it would be most appreciated.

>		Frank 
>-- 

You will find the rotor wirings below.  If you need any other
information you can always contact me at the address below.

		Enigma rotor wirings as used by
		German Forces during World War II.
		**********************************

Rotor		Wiring			Notch	Window 		Remarks
 No.	ABCDEFGHIJKLMNOPQRSTUVWXYZ
***************************************************************************
 I	EKMFLGDQVZNTOWYHXUSPAIBRCJ	  Y	   Q
 II	AJDKSIRUXBLHWTMCQGZNPYFVOE	  M	   E
 III	BDFHJLCPRTXVZNYEIWGAKMUSQO	  D	   V
 IV	ESOVPZJAYQUIRHXLNFTGKDCMWB	  R	   J
 V	VZBRGITYUPSDNHLXAWMJQOFECK	  H	   Z
 VI	JPGVOUMFYQBENHZRDKASXLICTW	  H,U	   Z,M
 VII	NZJHGRCXMYSWBOUFAIVLPEKQDT	  H,U	   Z,M
 VIII	FKQHTLXOCBJSPDZRAMEWNIUYGV	  H,U	   Z,M
 Beta	LEYJVCNIXWPBQMDRTAKZGFUHOS				M-4 only
 Gamma	FSOKANUERHMBTIYCWLQPZXVGJD				M-4 only

Reflector B (Thick, normal):
 (AY),(BR),(CU),(DH),(EQ),(FS),(GL),(IP),(JX),(KN),(MO),(TZ),(VW)

Reflector C (Thick, normal):
 (AF),(BV),(CP),(DJ),(EI),(GO),(HY),(KR),(LZ),(MX),(NW),(QT),(SU)

Reflector B (Thin, M-4 only) :
 (AE),(BN),(CK),(DQ),(FU),(GY),(HW),(IJ),(LO),(MP),(RX),(SZ),(TV)

Reflector C (Thin, M-4 only) :
 (AR),(BD),(CO),(EJ),(FN),(GT),(HK),(IV),(LM),(PW),(QZ),(SX),(UY)

Notes:
	1) Notch column gives the position on the alphabet ring.
	2) Window column gives letter apparing in Enigma window when
	   the notch is in the engaged position.
	3) Alphabet on reflectors are going clockwise viewed from
	   the contact pad side.
	4) Standard alphabet is on the rotor's right-hand side,
	   permutation alphabet on the left-hand side.
	   Normal rotors have pins on R.H.S and pads on L.H.S.
	   Greek rotors (Beta,Gamma) have pins on both sides.

Regards,
	Frode

**************************************************************************
*	Frode Weierud		Phone	:	41 22 7674794		 *
*	CERN, SL		Fax	:	41 22 7823676		 *
*	CH-1211 Geneva 	23	E-mail	:	frode@dxcern.cern.ch	 *
*	Switzerland			   or	weierud@cernvm.cern.ch	 *
**************************************************************************

From msuinfo!uwm.edu!zaphod.mps.ohio-state.edu!howland.reston.ans.net!usenet.ins.cwru.edu!magnus.acs.ohio-state.edu!csn!ub!acsu.buffalo.edu!boyd Mon Mar 29 19:31:34 1993
Path: msuinfo!uwm.edu!zaphod.mps.ohio-state.edu!howland.reston.ans.net!usenet.ins.cwru.edu!magnus.acs.ohio-state.edu!csn!ub!acsu.buffalo.edu!boyd
From: boyd@acsu.buffalo.edu (Daniel F Boyd)
Newsgroups: sci.crypt
Subject: Re: Question about 'Crypt breakers workbench'
Message-ID: <C4K8tu.6C1@acsu.buffalo.edu>
Date: 27 Mar 93 18:32:18 GMT
References: <1993Mar27.013830.2634@bernina.ethz.ch>
Sender: nntp@acsu.buffalo.edu
Organization: UB
Lines: 43
Nntp-Posting-Host: autarch.acsu.buffalo.edu

In article <1993Mar27.013830.2634@bernina.ethz.ch>
gec@nice.usergroup.ethz.ch (Germano Caronni) writes:
> - Does anybody know what approach would be used today to break the
>   real Enigma (not just the 1.5-wheel Unix crypt(1)) that was used 
>   during WWII ? 

How much money do you want to spend?  ;-)

Let's pick the Army Enigma.

3 rotors picked from a set of 5, and stacked on the axle. 
[60 possibilities]

26 possible positions for each rotor
[26^3 = 17576 possibilities]

Five pairs of letters swapped by the plugboard: choose ten letters,
pick an ordering of them, plug cable 1 into the first two, cable 2
into the second two etc.  But I could plug the cables in in any
permutation so I'm 5! times too big.  But the cables are bidirectional
so I'm 2 times too big.
[(26 choose 10) times 10! divided by (2*5!)  = 15120 cable settings.]

265749120 possible keys.

That's only 2^27.

Direct search of the Enigma keyspace is apparently feasible on modern
parallel computers.  Assuming I got (a) the number of cables right and
(b) got the number of possible cable-swaps right

This assumes unknown-plaintext!  With a known-plaintext attack we are
much luckier, and can do a bombe-type attack before searching the
plugboard space; this puts the Enigma in reach of a PC-XT.

Which isn't surprising, since the Enigma was in reach of people in the
1940s who just had electric motors and metal relays.

-- 
Daniel F. Boyd -- boyd@cs.buffalo.edu 

"Here, a piece of the True Cross.  And in this case, we have the skull
of John the Baptist at the age of twelve."

From msuinfo!agate!spool.mu.edu!howland.reston.ans.net!cs.utexas.edu!convex!convex!not-for-mail Sat May 28 15:37:00 1994
Path: msuinfo!agate!spool.mu.edu!howland.reston.ans.net!cs.utexas.edu!convex!convex!not-for-mail
From: Mike Tighe <tighe@convex.COM>
Newsgroups: sci.crypt
Subject: Re: Examples of Enigma plaintext and ciphertext
Date: 25 May 1994 18:07:20 -0500
Organization: Engineering, Convex Computer Corporation, Richardson, Tx USA
Lines: 37
Sender: tighe@cxsoft.convex.com
Message-ID: <2s0ln8$n43@cxsoft.convex.com>
References: <2s0g3c$ai7@lyra.csx.cam.ac.uk>
Reply-To: tighe@convex.com
NNTP-Posting-Host: cxsoft.convex.com

mrr@cl.cam.ac.uk (Michael Roe) writes:

>I'm looking for some examples of paired plaintext/ciphertext/key for the
>Enigma machine. If any readers of this group have such examples, please
>could they let me know?

I made the following recording from a 3-rotor German Enigma.

			 plaintext: michael tighe
 		        ciphertext: djrxyxs qvail

Rotor setting was 01/01/01

left-to-right rotor ordering was 3/2/1.

The middle rotor had a notch on 5, and the right rotor had a notch on 17.

The plugboard was wired as: ABCDEFGHIJKLMNOPQRSTUVWXYZ
                            EYCFADHGOKJMLNIWQSRUTZPXBV

The Enigma is actually a complicated machine. I didn't really know exactly
how it worked until I had one in hand and could take it apart and see how
it worked mechanically. All of what I had read about it was either
incorrect or incomplete. Even some of the information the Smithsonian
Institute and the NSA states in their museums is incorrect. I can't imagine
how hard it was to break 50+ years ago. What an accomplishment that was.

It was a fun experience writing code that could 'talk' to it. I have been
meaning to getting around to writing a 'bombe' but haven't had the time.
Hopefully this summer.

Good luck,

-Mike
-- 
Mike Tighe, (214) 497-4206
tighe@convex.com

From msuinfo!agate!howland.reston.ans.net!gatech!news-feed-1.peachnet.edu!paperboy.wellfleet.com!noc.near.net!news.delphi.com!usenet Sat May 28 15:40:09 1994
Path: msuinfo!agate!howland.reston.ans.net!gatech!news-feed-1.peachnet.edu!paperboy.wellfleet.com!noc.near.net!news.delphi.com!usenet
From: lharnisch@delphi.com
Newsgroups: sci.crypt
Subject: Sample Enigma message
Date: Sat, 28 May 94 02:21:54 -0500
Organization: Delphi (info@delphi.com email, 800-695-4005 voice)
Lines: 59
Message-ID: <RI1u+Ay.lharnisch@delphi.com>
NNTP-Posting-Host: bos1g.delphi.com

The following is a sample Enigma message..... further info follows:
 
YJXSI DJWLS BWJOW VBDLY YNLHL SRZOD MHIXM GGGWE BLQPT RRMRJ
EQHZQ NADAD OQCLS MGOHS VMZKC LHMAK XYWXJ HRYCH FITRS LZJIN
LAHFN HGVMF QWHKO SBXLT XHSMM JLBXC GFQHZ GYMTB QPWVW VJICX
XMDTE HRWFJ BKCXI RJDHN WGIGH EVRWA OBDPG HSBGZ MLKHB KTGNC
FQANZ
 
=This sample is taken from Cryptologia, Oct. 1983...
Settings for Enigma follow below (in case you don't want to look first:)=
=
=
 = 29   Rotor Sequence: IV I II   Ring Settings: 12 15 21
Primary Settings: 03 18 05     Patch cord connections: TB GK LR HU DH YS CZ

Cheers and good solving....
 
Larry Harnisch
In preceding Enigma sample message the final group is wrong
It should be: FQANZ rpt FQANZ (sted RQANZ-----)
LH

From msuinfo!uwm.edu!cs.utexas.edu!utnut!torn!uunet.ca!uunet.ca!geac!herboid!cattnts!ncrcan!coutts!wwg Tue May 31 23:31:05 1994
Path: msuinfo!uwm.edu!cs.utexas.edu!utnut!torn!uunet.ca!uunet.ca!geac!herboid!cattnts!ncrcan!coutts!wwg
From: wwg@coutts.UUCP (Warren Gay)
Newsgroups: sci.crypt
Subject: Re: Security of Enigma
Message-ID: <120@coutts.UUCP>
Date: 30 May 94 14:17:37 GMT
References: <2rlqkh$4rg@bronze.coil.com> <EACHUS.94May24175616@spectre.mitre.org> <CqG7Jp.K9A@x.co.uk>
Organization: Coutts Library Services
Lines: 67

In article <CqG7Jp.K9A@x.co.uk> clive@sco.com (Clive D.W. Feather) writes:
>...Studying the Enigma, it seems to me that the reflector, and thus the
>property that the encipherment was reversable (and A never enciphers to
>A), was a weakness. Would the cipher have been stronger if the right
>hand rotor fed the lamps directly ? On the one hand, you've lost various
>properties you probably should want to lose; on the other, the signal
>only goes through each rotor once.
>Clive D.W. Feather     | Santa Cruz Operation    | If you lie to the compiler,

On the other hand, allow it to encrypt an A to an A might allow
portions of the message to "seep through". I suppose the chances
of a full word "seeping through" are probably low, but it would still
worry me.

It seems to me, that the only advantage to routing the current back through
the rotors, is to foil those who have no knowlege of the rotor wirings.
After the wiring is known, I cannot see any benefit.  Actually, I take
that back... it does one more thing- it puts the current through the
steckerboard twice.

I believe that the real reason it was fed in, and then back thru
the rotors was because of its economic design. The keys and the lamps were
all connected to the stecker/and same end of the rotors. This gave it its
capability to both encode and decode.  A one way route through the rotors
would (I think) create an encrypt/decrypt only mechanism.

The machine is amazingly simple... take the following circuit, and
then add a plug board and a few rotors to scramble the connections.

         *lit*             === KEY
 +-------LAMP-----<---O     |           
 |                   ---------------O--<---//-----STECKER+SCRAMBLER---+
 |                                                                    |
 |     BATTERY + -----O                                               |
GND                                                                   |
                                                                      |
                                                                      |
 +-------LAMP---------O    === PRESSED KEY                            |
 |                          |   /---O------//------->-----------------+
 |                   ---------/                  Current              
 |     BATTERY + -----O                                               
GND                                                                   
                                                                       
In the above diagram, you can see how a pressed key, can light any other
lamp (any but its own).  All that was needed was a scrambling apparatus
in between. This leads to a couple of other possible "abusive" situation
properties:

	1. If two keys are pressed at the same time, and they scramble
	   to different letters, then two lamps light.

	1. If two keys are pressed, and the scramble to each other, then
	   no lamps light (+ to +, thus no current flow).

I have got my PC full screen mockup of the ENIGMA going, but I am still in
search of the authentic rotor wirings. I am in the process of obtaining
books that might help.  If someone out there has the BASIC program that
was mentioned for the ENIGMA, please pass it along.  I'd like to see
what rotor wirings they used in it.

I am also led to assume, that the rotor advanced its position AFTER the
key was pressed (and subsequently released). Is this in fact the case?

--------------------
Warren W. Gay VE3WWG		John Coutts Library Services Limited		
wwg@coutts.UUCP			Niagara Falls, Ontario, Canada
(or wwg%coutts@uunet.ca, wwg%coutts@uunet.uu.net)

From msuinfo!agate!library.ucla.edu!psgrain!charnel.ecst.csuchico.edu!yeshua.marcam.com!MathWorks.Com!news.duke.edu!convex!convex!not-for-mail Thu Jun  2 22:46:33 1994
Path: msuinfo!agate!library.ucla.edu!psgrain!charnel.ecst.csuchico.edu!yeshua.marcam.com!MathWorks.Com!news.duke.edu!convex!convex!not-for-mail
From: Mike Tighe <tighe@convex.COM>
Newsgroups: sci.crypt
Subject: Re: ENIGMA - few last details for authenticity?
Date: 1 Jun 1994 09:39:29 -0500
Organization: Engineering, Convex Computer Corporation, Richardson, Tx USA
Lines: 34
Sender: tighe@cxsoft.convex.com
Message-ID: <2si6j1$eh7@cxsoft.convex.com>
References: <123@coutts.UUCP>
Reply-To: tighe@convex.com
NNTP-Posting-Host: cxsoft.convex.com

wwg@coutts.UUCP (Warren Gay) writes:
>I thought this was going to be enough info, until I started looking at
>it in more detail. Now I have a few more questions:

When I started, I found out that the more I learned, the more questions I
had. It really made me think how difficult the Poles work was.

>	1...	Viewing the "Standard alphabet" from the RHS of rotor, do
>		they appear in counter clockwise order (given the reflector
>		is clockwise viewed from LHS)???

Clockwise.

>	4...	The notch has to do with the mechanics of rollover?

Yes.

>	5...	Which way do the rotors actually rotate? When
>		viewed from the RHS of rotor I, my guess would
>		be clockwise (such that the "standard
>		alphabet on RHS goes A,B,C...Z). Is this
>		correct? (letters in window should appear to
>		go up).

Counter-clockwise. b follows a, c follows b, etc.

>	6...	Does the rotor advance during the INITIAL key
>		press, or AFTER key release?

Initial.
-- 
Mike Tighe, (214) 497-4206
tighe@convex.com

From msuinfo!agate!darkstar.UCSC.EDU!news.hal.COM!olivea!uunet!news.delphi.com!usenet Thu Jun  2 22:47:08 1994
Path: msuinfo!agate!darkstar.UCSC.EDU!news.hal.COM!olivea!uunet!news.delphi.com!usenet
From: lharnisch@delphi.com
Newsgroups: sci.crypt
Subject: Re: ENIGMA - few last details for authenticity?
Date: Thu, 2 Jun 94 02:24:48 -0500
Organization: Delphi (info@delphi.com email, 800-695-4005 voice)
Lines: 21
Message-ID: <pQxs+7g.lharnisch@delphi.com>
References: <123@coutts.UUCP> <2si6j1$eh7@cxsoft.convex.com>
NNTP-Posting-Host: bos1d.delphi.com
X-To: Mike Tighe <tighe@convex.COM>

According to Kahn's "Seizing the Enigma" the Germans set the rotors so
that they would kick the neighboring rotor at different points, not
necessarily when they had made a full rotation.
	The British devised a slogan for this: "Royal Flags Wave Kings
Above" as a mnenomic for when the rotors kicked their neighbors.
	"Rotor I, for example, kicked its neighbor when it (rotor
I) stepped to ring position R (from ring position Q) during the
course of encipherment. Rotor II gave its kick when moving to F, III
to W, IV to K and V to A. The Germans thought that this would create a
more irregular movement and in a way they were right. But the British
cryptanalysts soon saw that the discovery that a rotor had moved
could, if they knew the ring position of its neighr to the right,
identify that neighbor."
	Page 114.....
 
Cheers,
 
	Larry Harnisch
	BTW... what is the engima20.zip program that often turns
up through gopher? Is that the enigma emulation or something
totally different? It is a relatively large file.

From msuinfo!agate!howland.reston.ans.net!EU.net!CERN.ch!dxcern!frode Thu Jun  2 22:48:24 1994
Newsgroups: sci.crypt
Path: msuinfo!agate!howland.reston.ans.net!EU.net!CERN.ch!dxcern!frode
From: frode@dxcern.cern.ch (Frode Weierud)
Subject: Re: ENIGMA - few last details for authenticity?
Message-ID: <1994Jun2.092841.25661@dxcern.cern.ch>
Reply-To: frode@dxcern.cern.ch
Organization: CERN European Lab for Particle Physics
References: <123@coutts.UUCP>
Date: Thu, 2 Jun 1994 09:28:41 GMT
Lines: 111

In <123@coutts.UUCP> wwg@coutts.UUCP (Warren Gay) writes:

>I thought this was going to be enough info, until I started looking at
>it in more detail. Now I have a few more questions:

>>	4) Standard alphabet is on the rotor's right-hand side,
>>	   permutation alphabet on the left-hand side.

>	1...	Viewing the "Standard alphabet" from the RHS of rotor, do
>		they appear in counter clockwise order (given the reflector
>		is clockwise viewed from LHS)???

1. I selected the standard alphabet to be on the RHS of the rotors
as this is the side where the first (right most) rotor has its input
connections from the stator connected to the plugboard. Viewing
both the rotors and the reflector from the RHS, the alphabets are 
progressing clockwise. You are normally looking at the reflector
from the RHS as this is where it has its connection pins. The LHS
has no connections.

I should perhaps clarify one point in my note no. 3. It is only the
"thin reflectors", those used in the Naval Enigma M4, that has contact
pads, the normal (thick) reflectors have contact pins. The reason for
the pads on the thin reflectors is the need for having a very thin
construction to fit in the available space. However, this means that
the Greek rotors Beta and Gamma have contact pins on both sides.

>	3...	Looking at LHS of rotor I, the chart:

>>Rotor		Wiring			Notch	Window 		Remarks
>> No.	ABCDEFGHIJKLMNOPQRSTUVWXYZ
>>***************************************************************************
>> I	EKMFLGDQVZNTOWYHXUSPAIBRCJ	  Y	   Q

>		I assume that this chart means that "E" wires to
>		"E", because "E" is on a different place on
>		each side of the rotor (ie. pad "E" is directly
>		opposite (and left) of pin "A" on rotor I).

3. The wiring of the rotors was measured with a buzzer "ringing"
through the different connections. First the alphabet ring was
put in its neutral position, letter A opposite the neutral mark on
the rotor body. Next one pole of the buzzer was connected to the
RHS contact pin in the letter A position and the other pole touching
the contact pads on the LHS until one pad was found that made contact.
For rotor I this would be the contact pad in the letter E position.
I hope this clarifies the rotor wirings.

>	4...	The notch has to do with the mechanics of rollover?
>		The window character "Q" for notch "Y" (rotor I):
>		I assume this is the letter shown just prior to
>		the next rotor's rollover (notch Y is engaged for
>		rollover). This I determined by noting that notch
>		and window character are always 8 positions away.
>		(Interesting that rotors VI - VIII have two
>		rollover positions).

4. For rotor I, when Q appears in the window the notch Y (notch in
the letter Y position) is in the engaged position and the left hand
neighbouring rotor will step forward on the next key press.

>	5...	Which way do the rotors actually rotate? When
>		viewed from the RHS of rotor I, my guess would
>		be clockwise (such that the "standard
>		alphabet on RHS goes A,B,C...Z). Is this
>		correct? (letters in window should appear to
>		go up).

5. The rotors move towards the operator, which means counter clockwise
seen from the RHS of the machine. This counter clockwise movement will
show each letter on the rotor's alphabet ring in a normal progression
A,B,C, etc.

>	6...	Does the rotor advance during the INITIAL key
>		press, or AFTER key release?

6. The rotor will move towards the end of the excursion of a key.
During the first 1/3 of the displacement of a key no rotor movement
takes place. The rotor will move during the next 2/3 displacement
and the rotor has reached its new position at the end of the key
movement.

Concerning my earlier posting about the rotor turnover, somebody
remarked that I had forgot to deal with the Naval rotors VI, VII and
VIII, which have two notches in position H and U, diametrically
opposite. The Naval rotor do not in any way modify the double stepping
anomaly, only that double stepping can take place more frequently.
It also means that the rotor to the left of one of the 2-notch
rotors will move twice (every 13 steps) for each full revolution of
the 2-notch rotor.

The use of 2-notch rotors will unfortunately reduce the period of the
machine. If a 2-notch rotor is installed in the right most position 
the period will be reduced from 16900 characters to 8450. If it is
installed in the middle position it will give a period of 8112, while
if two of the 2-notch rotors are used we will end up with a period
of only 4056. A 2-notch rotor in the 3rd (left most) position will 
behave as a normal rotor as the Greek rotor does not have a stepping
lever that can engage the notches.

Frode

**************************************************************************
*	Frode Weierud		Phone	:	41 22 7674794		 *
*	CERN, SL		Fax	:	41 22 7679185		 *
*	CH-1211 Geneva 	23	E-mail	:	frode@dxcern.cern.ch	 *
*	Switzerland			   or	weierud@cernvm.cern.ch	 *
**************************************************************************

From msuinfo!agate!howland.reston.ans.net!EU.net!CERN.ch!dxcern!frode Sat Jun 11 23:38:06 1994
Newsgroups: sci.crypt
Path: msuinfo!agate!howland.reston.ans.net!EU.net!CERN.ch!dxcern!frode
From: frode@dxcern.cern.ch (Frode Weierud)
Subject: Re: ENIGMA - Middle rotor double advancement anomaly clarification?
Message-ID: <1994Jun10.073056.23712@dxcern.cern.ch>
Reply-To: frode@dxcern.cern.ch
Organization: CERN European Lab for Particle Physics
References: <135@coutts.UUCP>
Date: Fri, 10 Jun 1994 07:30:56 GMT
Lines: 87

In <135@coutts.UUCP> wwg@coutts.UUCP (Warren Gay) writes:

>Frode, thanks for the other information. It has solved many loose
>ends and its all making sense now. (I tried to send you email, but
>there are local UUCP problems preventing this right now).   :-(

>Now another point:

>I need further clarification on the "Double
>advancement anomoly" of the middle wheel (3 rotors). Reading
>[Frode's] description of this, I am led to believe that the middle rotor
>advances twice (under the right conditions of the middle+rightmost rotor)
>with a SINGLE keystroke.  Is this correct?  Frode?

>Or, does it instead, advance middle and rightmost rotor on the FIRST
>keystroke, then advance the middle rotor ONCE MORE on the FOLLOWING
>keystroke? (the rightmost rotor having notched itself for this for the
>middle rotor)  I hope I'm not to vague on this point.

>I can see this double advancement occuring in two stages
>being easier to implement with the mechanical arrangement that
>I am able to ferret out of the side view diagram in David Kahn's
>"Seizing the Enigma" (this book seems to have better pictures of the
>various parts of the unit).  However, I've been wrong on a lot of
>my guesses so far  :->

>------------------------------
>Warren W. Gay VE3WWG/XL3WWG	John Coutts Library Services Limited		
>wwg@coutts.UUCP			Niagara Falls, Ontario, Canada
>(or wwg%coutts@uunet.ca, wwg%coutts@uunet.uu.net)

I will send this reply as a follow-up article as I understand you
have some problems with UUCP, and a clarification of the Enigma
rotor turnover might have a general interest. 

I used the expression "double advancement anomoly" which perhaps is
not a very good description of what is actually happening. Using the
word "double" I ment to say that the middle rotor moves ONE step
forward together with the third rotor, the middle rotor will not step
twice, for a single key press. The key to the understanding of this
mechanism is that the middle rotor can step forward together with the
third rotor regardless of the position of the rightmost, fast rotor
which usually governs the stepping of the middle rotor.

To illustrate this let us look at a few examples. Let us use Rotor I
in the rightmost position (fast rotor) and Rotor II in the middle
position. We can place any other rotor in the third position. Rotor I
will allow stepping of its lefthand neighbour when Q appears in the
window and likewise for Rotor II when E appears in the window.

It is clear that if we have the following rotor positions:
			A E Q
all of the rotors will step forward on positon on the next key
press as both the notch on the rightmost rotor and the middle
rotor is in the engaged position. The result will be:
			B F R

If on the other hand we started with the situation:
			A D Q
a normal turnover of the middle rotor will take place as the
rightmost rotor has its notch in the engaged position. The
result will be:
			A E R
On the next key press the righthand rotor will step forward one
position as usual and the third rotor (leftmost rotor) will also
step forward one position as the middle rotor has its notch in 
the engaged position, but due to the anomoly the middle rotor
will step as well, even if it stepped forward on position on the
last key press. The end result will be:
			B F S

This is what I meant by the double stepping of the middle rotor.
It is clear that this will shorten the period of the machine as
the middle rotor will step forward twice without a complete 
revolution of the fast, rightmost rotor.

I hope the Enigma stepping mechanism now has become somewhat clearer.

Frode

**************************************************************************
*	Frode Weierud		Phone	:	41 22 7674794		 *
*	CERN, SL		Fax	:	41 22 7679185		 *
*	CH-1211 Geneva 	23	E-mail	:	frode@dxcern.cern.ch	 *
*	Switzerland			   or	weierud@cernvm.cern.ch	 *
**************************************************************************

From msuinfo!agate!darkstar.UCSC.EDU!news.hal.COM!decwrl!netcomsv!netcom.com!jktaber Tue Jun 28 13:11:19 1994
Newsgroups: sci.crypt
Path: msuinfo!agate!darkstar.UCSC.EDU!news.hal.COM!decwrl!netcomsv!netcom.com!jktaber
From: jktaber@netcom.com (John K. Taber)
Subject: Re: Rejewski's Enigma equations
Message-ID: <jktaberCruv92.3tH@netcom.com>
Organization: None
X-Newsreader: TIN [version 1.2 PL1]
References: <2u6tl0$8jh@catfish.valdosta.peachnet.edu>
Date: Thu, 23 Jun 1994 15:05:26 GMT
Lines: 9

Jon H. Hamlin (jhamlin@grits) wrote:
: I'm currently re-reading David Kahn's _Seizing the Enigma_ and was wonderng
: if anyone knows where I can get copies of Marian Rejewski's 6 equations which
: he derived to solve the Enigma.

Try Annals of the History of Computing, Vol 3, No 3, July 1981.
-- 
John K. Taber            finger for pgp key                jktaber@netcom.c
===========================================================================
How do we progress this disaster? -- Malaphors

From msuinfo!agate!library.ucla.edu!europa.eng.gtefsd.com!MathWorks.Com!zombie.ncsc.mil!admii!cmcl2!newsserv.cs.sunysb.edu!ysics.physics.sunysb.edu!pjhong Tue Jun 28 13:11:36 1994
Path: msuinfo!agate!library.ucla.edu!europa.eng.gtefsd.com!MathWorks.Com!zombie.ncsc.mil!admii!cmcl2!newsserv.cs.sunysb.edu!ysics.physics.sunysb.edu!pjhong
From: pjhong@cs.sunysb.edu (P. Joseph Hong)
Newsgroups: sci.crypt
Subject: Re: Rejewski's Enigma equations
Date: 24 Jun 1994 15:39:26 GMT
Organization: Institute For Theoretical Physics
Lines: 28
Message-ID: <2ueune$i0b@ysics.physics.sunysb.edu>
References: <2u6tl0$8jh@catfish.valdosta.peachnet.edu>
NNTP-Posting-Host: clio.rad.sunysb.edu
X-Newsreader: Tin 1.1 PL3

jhamlin@grits (Jon H. Hamlin) writes:
: I'm currently re-reading David Kahn's _Seizing the Enigma_ and was wonderng
: if anyone knows where I can get copies of Marian Rejewski's 6 equations which
: he derived to solve the Enigma.
: 
: ------------------------------------------------------------------------------
: Jon Hamlin                                jhamlin@grits.valdosta.peachnet.edu
: Math/CS Systems Operator
: Valdosta State University                 Voice: (912) 245-2496 

These three books have what you are looking for:

	CRYPTOLOGY: Machines, History, and Methods.
	Artech House, MA:1989

	CRYPTOLOGY: Yesterday, Today, and Tomorrow.
	Artech House, MA:1987

	The two above by Deavours, Kahn, Kruh, Mellen, & Winkel

	Machine Cryptography and Modern Cryptanalysis.
	Artech House, MA:1985
	This one by Deavours and Kruh

Or were you asking that someone write down the equations for you?

Venona Joe

From msuinfo!agate!howland.reston.ans.net!usc!elroy.jpl.nasa.gov!lll-winken.llnl.gov!noc.near.net!news.delphi.com!news.delphi.com!not-for-mail Tue Jun 28 13:11:58 1994
Path: msuinfo!agate!howland.reston.ans.net!usc!elroy.jpl.nasa.gov!lll-winken.llnl.gov!noc.near.net!news.delphi.com!news.delphi.com!not-for-mail
From: padrote@news.delphi.com (PADROTE@DELPHI.COM)
Newsgroups: sci.crypt
Subject: Re: Rejewski's Enigma equations
Date: 28 Jun 1994 01:26:41 -0000
Organization: Delphi Internet Services Corporation
Lines: 15
Message-ID: <2unu8h$mjf@news.delphi.com>
References: <2u6tl0$8jh@catfish.valdosta.peachnet.edu> <2ueune$i0b@ysics.physics.sunysb.edu>
NNTP-Posting-Host: news.delphi.com

I think a much better source is the following book:

   "The Enigma War", Jozef Garlinski, Scribner's Sons, NY, 1979.

I picked this book up years ago in a discount rack somewhere, and never 
see it mentioned in the literature on the Enigma. But the book lays out 
the operation of the machine quite clearly, and enabled me to write my 
own simulation several years ago. It is written in BASIC (sorry, those 
were the days when there were few choices in PC languages). I will be 
happy to post the program here if anyone is interested. All versions of 
MS-DOS still come with a BASICA  compiler.

John
