basvandorst/cryptography-archive/jvppgp116ge/install.txt

Installation von jvppgp / Installation of jvppgp
-----------------------

jvppgp kann nur installiert werden, wenn PGP 2.6.3i bereits installiert ist!
Achtung: jvppgp arbeitet mit nur mit PGP 2.6.3i zusammen, welches nicht für den
Gebrauch in den USA bestimmt ist!

1) Lesen der Dateien
   readme.1st, readme.usa und readmedll.1st
   unter Beachtung der dort enthaltenen Hinweise etc.

2) Entpacken der Dateien:
   - pgp263i.dll in ein Verzeichnis im Pfad
     (am besten ins PGP-Verzeichnis)
   
   bei Verwendung von Pegasus Mail:
   - jvppgp.exe und
   - jvppgp.dll ins Pegasus Verzeichnis
   - jvppgp.hlp und jvppgp.cnt  ins Pegasus Verzeichnis
   - jvppgp.bmp ins Pegasus Verzeichnis
   - jvppgppm.fff ins Pegasus Verzeichnis
     ( diese Datei muß in jvppgppm.fde umbenannt werden, wenn das deutsche
       Sprachmodul benützt wird! )

   Frontend:
   - jvppgp.exe und
   - jvppgp.dll und
   - jvppgp.hlp und jvppgp.cnt  
   in ein gemeinsames Verzeichnis, z.B. ins PGP-Verzeichnis

3) Bei Verwendung von Pegasus Mail:
   Über das fff-File (welches bei Verwendung des deutschen Sprachmoduls
   von Pegasus in "jvppgppm.fde" umbenannt werden muß) werden eigentlich
   bereits alle notwendigen Einstellungen getroffen.
   Zusätzlich können folgende Einstellungen in den Optionen von Pegasus
   Mail ergänzt werden (unter Tools/Options):
   - Advanced settings
     - # of lines to probe for enclosures: 200
     - Allow 8-bit MIME message encoding (sonst gibt's beim 
       Transport Armot von PGP Probleme!)
   - Message editor settings: 
     - default encryption method: jvppgp for Pegasus

4) Bitte lese die Online-Hilfe von jvppgp, besonders den Artikel
   "Über jvppgp" (einfach auf das Logo drücken!)

Installation of jvppgp
-----------------------

jvppgp requires a complete installation of pgp 2.6.3i!
Note: jvppgp uses pgp 2.6.3i which is not for use in the USA!

1) Read readme.1st, readme.usa, readmedll.1st

2) Unzip files:
   - pgp263i.dll in a directory found in the path
     (best: pgp-directory)
   
   if you'`re using pegasus mail:
   - jvppgp.exe and
   - jvppgp.dll to pegasus mail directory
   - jvppgp.hlp and jvppgp.cnt  to pegasus mail directory
   - jvppgp.bmp to pegasus mail directory
   - jvppgppm.fff to pegasus mail directory

   else:
   - jvppgp.exe and
   - jvppgp.dll and
   - jvppgp.hlp and jvppgp.cnt  
   in one directory, f.e. the pgp-directory

3) If you're using pegasus mail:
   Most inforamtions are already configured in the fff-file (which have to
   be renamed in "jvppgppm.fde" if you're using the german laguage modul od pmail).
   Here are some additional tips to chane in Pegasus Mail under Tools/Options:
   - Advanced settings
     - # of lines to probe for enclosures: 200
     - Allow 8-bit MIME message encoding 
   - Message editor settings: 
     - default encryption method: jvppgp for Pegasus

4) Please read the online-help of jvppgp, just cklick on the jvppgp-logo!
