basvandorst/cryptography-archive/jvppgp20beta/install.txt

Installation von jvppgp / Installation of jvppgp
-----------------------

1) Installation von PGP 2.6.3i oder PGP 5.0(i)
   (siehe dortige Hilfe-Dateien)

2) Entpacken der Dateien:
   - pgp263i.dll in ein Verzeichnis im Pfad, falls
     PGP 3.6.3i verwendet wird
     (am besten ins PGP-Verzeichnis oder in Windows/System)
   
   bei Verwendung von Pegasus Mail:
   - jvppgp.dll ins Pegasus Verzeichnis
   - jvppgp.hlp und jvppgp.cnt  ins Pegasus Verzeichnis
   - jvppgp.bmp ins Pegasus Verzeichnis
   - jvppgppm.fff ins Pegasus Verzeichnis

   sonst:
   - jvppgp.dll und
   - jvppgp.hlp und jvppgp.cnt  
   in ein gemeinsames Verzeichnis, z.B. ins PGP-Verzeichnis

3) Bei Verwendung von Pegasus Mail:
   Über das fff-File (welches bei Verwendung des deutschen Sprachmoduls
   von Pegasus in "jvppgppm.fde" umbenannt werden muß) werden eigentlich
   bereits alle notwendigen Einstellungen getroffen.
   Zusätzlich können folgende Einstellungen in den Optionen von Pegasus
   Mail ergänzt werden (unter Tools/Options):
   - Advanced settings
     - # of lines to probe for enclosures: 200
     - Allow 8-bit MIME message encoding (sonst gibt's beim 
       Transport Armot von PGP Probleme!)
   - Message editor settings: 
     - default encryption method: jvppgp for Pegasus

4) Bitte lese die Online-Hilfe von jvppgp, besonders den Artikel
   "Über jvppgp" (einfach auf das Logo drücken!)

Installation of jvppgp
-----------------------

1) Installation of PGP 2.6.3i or PGP 5.0(i)
   (please read the help-files of the pgp-package)

2) Unzip files:
   - pgp263i.dll in a directory found in the path if 
     using pgp 2.6.3i
     (best: pgp-directory or windows/system)
   
   if you'`re using pegasus mail:
   - jvppgp.dll to pegasus mail directory
   - jvppgp.hlp and jvppgp.cnt  to pegasus mail directory
   - jvppgp.bmp to pegasus mail directory
   - jvppgppm.fff to pegasus mail directory

   else:
   - jvppgp.dll and
   - jvppgp.hlp and jvppgp.cnt  
   in one directory, f.e. the pgp-directory

3) If you're using pegasus mail:
   Most inforamtions are already configured in the fff-file (which have to
   be renamed in "jvppgppm.fde" if you're using the german laguage modul od pmail).
   Here are some additional tips to chane in Pegasus Mail under Tools/Options:
   - Advanced settings
     - # of lines to probe for enclosures: 200
     - Allow 8-bit MIME message encoding 
   - Message editor settings: 
     - default encryption method: jvppgp for Pegasus

4) Please read the online-help of jvppgp, just cklick on the jvppgp-logo!
