basvandorst/cryptography-archive/pari-1/pari/doc/tutorial.tex

\chapter{A GP tutorial}

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

Try $27*37$. Wow! even multiplication works.

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

In fact it is known that {\tt exp(pi$*$sqrt(n))} not only is not an integer
or a rational number, but is even a transcendental number when $n$ is a positive
rational number.

So GP is just a fancy calculator, able to give me more decimals than I will ever
need? Not so, GP is incredibly more powerful than an ordinary calculator, even
independently of its arbitrary precision possibilities.
\medskip
{\bf Additional comments}
\medskip
You are supposed to skip this at first, and come back later.
\smallskip
1) It seems that the text implicitly says that as soon as an imprecise number
is entered, the result will be imprecise. Is this always true? There is a unique
exception: when you multiply an imprecise number by the exact number 0, you will
get the exact 0. Try: $0*1.4$, and compare with $0.*1.4$.
\smallskip
2) Not only can the number of decimal places of real numbers be large, but the
number of digits of integers also. Try $100!$. It is never necessary to tell
in advance to GP the size of the integers that it will encounter, since this is
adjusted automatically. On the other hand, for many computations with
real numbers, it is necessary to specify a default precision (initially 28 digits).
\smallskip
3) Come back to 28 digits of precision ({\tt \bs precision=28}), and type
{\tt exp(24$*$pi)}. As you can see the result is printed in exponential
format. This is because GP never wants you to believe that a result is correct when it is not.

We are working with 28 digits of precision, but the integer part of {\tt exp(24$*$pi)}
has 33 decimal digits. Hence if GP had dutifully printed out 33 digits, 
the last few digits would have been wrong. Hence GP wants to print only 28
significant digits, but to do so it has to print in exponential format.
\smallskip
4) To avoid this format there are two ways. One is of course to increase the precision
to more than 33 decimals. Let's try it. To give it a wide margin, we set the
precision to 40 decimals. Then we recall our last result ({\tt \%} or {\tt \%n}
where {\tt n} is the number of the result). What? We still have an
exponential format! Do you understand why?

Again let's try to see what's happening. The number you recalled had been computed only
to 28 decimals, and even if you set the precision to 1000 decimals, GP knows that
your number has only 28 digits of accuracy but an integral part with 33 digits. So
you haven't improved things by increasing the precision. Or have you? What if we
retype {\tt exp(24$*$pi)} now that we have 40 digits? Try it. Now we do not have
an exponential format, and we see that at 28 decimals the last 6 digits
would have been wrong if they had been printed in fixed-point format.
\smallskip
5) {\sl Warning\/}. Try the following: starting in precision 28, type 
successively {\tt \bs format=e0.50}, then {\tt exp(24$*$pi)}. Do you
understand why the result is so bad, and why there are lots of zeros at the end?
Convince yourself by typing {\tt log(exp(1))}. The moral is that the {\tt format}
command changes only the output format, but {\sl not\/} the default precision.
On the other hand, the {\tt precision} command changes both the precision and
the output format.
\medskip
\section{Warming up}
\medskip
Another thing you better get used to pretty fast is error messages. Try typing
$1/0$. Couldn't be clearer. Taking again our universal example in precision 28,
type {\tt floor(exp(24$*$pi))} ({\tt floor} is the mathematicians' integer part, not
to be confused with {\tt trunc}, which is the computer scientists': 
{\tt floor$(-3.4)$} is equal to $-4$ whereas {\tt trunc$(-3.4)$} is equal to $-3$).
You get a more cryptic error message, which you would immediately understand if you
had read the additional comments of the preceding section. Since I told you not
to read them, the explanation is simply that GP is unable to compute the integer
part of {\tt exp(24$*$pi)} given only 28 decimals of accuracy, since it has 33 digits.

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

You will thus automatically get the Taylor expansion of any function that can be expanded
around {\tt x=0}, and incidentally this explains
why we weren't able to do anything with {\tt log(x)} which is not defined at 0. But if we try
{\tt log(1$+$x)}, then it works. But what if we wanted the expansion around a point different
from 0? Well, you're able to change {\tt x} into {\tt x$-$a}, aren't you? So for instance
you can type {\tt log(x$+$2)} to have the expansion of {\tt log} around {\tt x=2}. 

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

Let's try something else: type {\tt (1$+$x)\^{}3}. No bigoh here, since the result is a polynomial.
Haha, but I have learnt that if you do not take exponents which are integers greater or equal
to 0, you obtain a power series with an infinite number of non-zero terms. Let's try.
Type {\tt (1$+$x)\^{}($-3$)} (the parentheses around $-3$ are not necessary but make things 
easier to read). Surprise! Contrary to what we expected, we don't get a power series but a
rational function. Again this is for the same reason that $1/7$ just gave you $1/7$: the result
being exact, PARI doesn't see any reason to make it non-exact.

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

Now try {\tt (1$+$x)\^{}(1/2)}. Now we obtain a power series, since the result is an object
which PARI does not know how to represent exactly (we could teach PARI about algebraic functions,
but then take {\tt (1$+$x)\^{}pi} as another example). This gives us still another solution to
our preceding exercise: we can type {\tt (1$+$x)\^{}($-3.$)}. Since $-3.$ is not an exact
quantity, PARI has no means to know that we are dealing with a rational function, and
will instead give you the power series, this time with real instead of
integer coefficients.

Finally, if you want to be really fancy, you can type {\tt taylor((1$+$x)\^{}($-3$),x)}
(look at the entry for {\tt taylor} for the description of the syntax), but this is in fact
almost never used.
\smallskip
To summarize, in this section we have seen that in addition to integers,
real numbers and rational numbers, PARI can handle complex numbers,
polynomials, power series, rational functions. A large number of functions 
exist which handle these types, but in this tutorial we will only look at
a few. \medskip
{\bf Additional comments}
\medskip
As before, you are supposed to skip this at first, and come back later.
\smallskip
1) Note: to be able to duplicate the following example, first type 
$\backslash$y to suppress automatic simplification.

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

If you want the final expression to be in the simplest form possible (for
example before applying an arithmetic function, or simply because things
will go faster afterwards), apply the function {\tt simplify} to the 
result. In fact, by default GP does this automatically, and this default
can be switched off and on by the command $\backslash$y. This is why I asked
you to type this before starting.

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

\centerline{{\tt matrix(5,5,j,k,1$/$(j$+$k$-$1))}}

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

\centerline{{\tt matrix(8,8,j,k,if((j$-$k)$\%$2,x,0))} }

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

\centerline{{\tt for(j=1,5,v[j]=1/j)}}

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

On the other hand, if you type {\tt wr=sqrt(w\^{}2)}, do not expect to get back
{\tt w}. Instead, you get the numerical value, the function {\tt sqrt} being
considered as a ``transcendental'' function, even though it is algebraic.
Type {\tt algdep(wr,2)}. This is one way to get {\tt w} back. Similarly,
type {\tt algdep(sqrt(3$*$w$+$5),4)}. See the user's manual for the function
{\tt algdep}.
\smallskip
The fourth number-theoretic type is the type ``polymod'', i.e. polynomial
modulo another polynomial. This type is used to work in algebraic extensions,
for example elements of number fields (if the base field is $\Bbb Q$), or
elements of finite fields (if the base field is $\Z/p\Z$ for a prime $p$,
defined by an integermod). In a sense it is a generalization of the type
quadratic number. The syntax used is the same as for integermods.
For example, instead of typing {\tt w=quadgen($-$163)}, you can type
{\tt w=mod(x,x\^{}2$-$x$+$41)}. Then exactly as in the quadratic case you can
type {\tt w\^{}10, norm(3$+$4$*$w), 1$/$(4$+$w), a=mod(1,23)$*$w, b=a\^{}264},
obtaining of course the same results (type {\tt lift(...)} if you don't want
to see the polynomial {\tt x\^{}2$-$x$+$41} repeated all the time). Of course,
the basic interest is that you can work in any degree, not only quadratic.

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

\centerline{\tt round(exp(divsum(n,d,log(d))))}

(there is a very simple formula for this product: find and prove it).

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

\centerline{\tt forprime(p=3,1000,if(primroot(p)$==$2,print(p),))}

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

Functions related to quadratic fields, binary quadratic forms and general
number fields will be seen in the next sections.
\medskip
\section{Working in Quadratic Number Fields}
\medskip
The simplest of all number fields outside $\Q$ are quadratic fields. Such 
fields are characterized by their discriminant, and even better, any non-square
integer $D$ congruent to 0 or 1 modulo 4 is the discriminant of a specific
order in a quadratic field. We can check whether this order is maximal by
using the command {\tt isfund(D)}.
Elements of a quadratic field are of the form $a+b\omega$, where $\omega$ is
chosen as $\sqrt{D}/2$ if $D$ is even and $(1+\sqrt{D})/2$ if $D$ is odd,
and are represented in PARI by quadratic numbers. To initialize working in
a quadratic order, one should start by the command 

\centerline{\tt w$=$quadgen(D)}

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

\centerline{\tt a=quadgen($-$23);b=quadgen($-$15);}

Then ask for the value of {\tt a} and {\tt b}, both will be equal to {\tt w},
but of course they are not equal. Hence beware when dealing with several 
quadratic orders at once. 
\smallskip
In addition to elements of a quadratic order, we also want to be able to handle
ideals of such orders. In the quadratic case, it is equivalent to handling
binary quadratic forms, and this has been chosen in PARI. For negative
discriminants, quadratic forms are triples $(a,b,c)$ representing the form
$ax^2+bxy+cy^2$. Such a form will be printed as (and can be created by)

\centerline{\tt qfi(a,b,c)}

({\tt i} stands for imaginary).

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

Let us see examples of all this at work.

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

\centerline{\tt prodeuler(p=2,500,1./(1$-$kro($-$10007,p)/p))$*$sqrt(10007)/pi}

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

Another way to check it is to use the {\tt buchimag} function by typing
for example

\centerline{\tt buchimag($-$3299,1,6)}

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

To create such a form we write

\centerline{\tt qfr(a,b,c,d)}

({\tt r} stands for real).

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

\centerline{\tt a=sqrt(8$*$exp(2$*$c))}

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

\centerline{\tt p=x\^{}2$-$round(a$-$sa)$*$x$-$8}

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

\centerline{\tt buchreal(10000001,0,1,6)}

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

\centerline{\tt u=redrealnod(qfr(1,1,(1$-$D)/4,0.),isqrt(D))}

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

In a similar way, we could obtain the so-called {\it compact representation}
of the fundamental unit itself, or $p$-adic regulators. I leave this as
exercises for the interested reader.
\medskip
\section{Working in General Number Fields}
\medskip
Note for the present release: although it still is correct, the present section
is rather obsolete since much more powerful functions are now avaliable for
working in general number fields, so this needs to be rewritten entirely.

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

\centerline{\tt T=x\^{}4$+$24$*$x\^{}2$+$585$*$x$+$1791;polred(T)}

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

\centerline{\tt mod(x,x\^{}4$+$24$*$x\^{}2$+$585$*$x$+$1791)}

while $\alpha$ is equal to the polymod

\centerline{\tt mod(x,x\^{}4$-$x\^{}3$-$21$*$x\^{}2$+$17$*$x$+$133)}

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

\centerline{\tt mod(x\^{}2$+$x$-$11,x\^{}4$-$x\^{}3$-$21$*$x\^{}2$+$17$*$x$+$133)}

meaning that $\theta=\alpha^2+\alpha-11$, and hence the conversion from a 
polynomial in $\theta$ to one in $\alpha$ is easy. If we want to do the
reverse, i.e. go back from a representation in $\alpha$ to a representation
in $\theta$, we use the function {\tt modreverse} on the polymod obtained
by {\tt initalg2}. Try it. The result has a big denominator (147), essentially
because our initial polynomial $T$ was too large.
\smallskip
From now on, we completely forget about our initial polynomial $T$, and use
only the polynomial $x^4-x^3-21x^2+17x+133$ defining $\alpha$, and
the components of the vector {\tt nf} which gives information on our number
field $K$. Note that even if the polynomial has small coefficients,
it is necessary to use the {\tt initalg} function before being able to do
{\bf ideal} operations in the number field or apply functions such as
{\tt galoisconj} below. Of course {\tt initalg} is not
really necessary if only {\bf element} operations are performed.
\smallskip
Let us first perform some operations on elements. Type {\tt A=nf[1]} to get
the new polynomial, and type 

\centerline{\tt u=mod(x\^{}3$-$5$*$x\^{}2$-$8$*$x$+$56,A)$/$7} 

We may for instance compute {\tt u\^{}3}. Try it. Or, we can type {\tt 1/u}.
Better yet, if we want to know the norm from $K$ to $\Q$ of {\tt u},
we type {\tt norm(u)} (what else?). Still better, if we want all the
symmetric functions of {\tt u} and not only the norm, we type
{\tt char(u,x)} (do not forget the {\tt x} variable which tells GP which
variable to use for the characteristic polynomial. Note that this gives
the characteristic polynomial of {\tt u}, and not in general the minimal
polynomial. Exercises: how does one (easily) find the minimal polynomial
from this? Find a simpler expression for {\tt u}.)
\smallskip
OK, now let's work on the field itself. The {\tt initalg} command already gave
us some information. The field is totally complex (signature $[0,2]$), its 
discriminant is $D=18981$ and 
$(1,\alpha,\alpha^2,(\alpha^3+2\alpha^2+6\alpha)/7)$ is an integral basis.
The Galois group of its Galois closure can be obtained by typing
{\tt galois(A)}. The answer ($[8,-1,1]$) shows that it is equal to $D_4$, the 
dihedral group with 8 elements, i.e. the group of symmetries of a square. 
\smallskip
This implies that the field is ``partially Galois'', i.e. that there exists at
least one non-trivial field isomorphism which fixes $K$. To find out which it
is, we use the function {\tt galoisconj}. This uses the LLL algorithm to find 
linear relations. So type {\tt galoisconj(nf)}. The result tells us that,
apart from the trivial automorphism, the map
$\alpha\mapsto(-\alpha^3+5\alpha^2+\alpha-49)/7$
is a field automorphism. Indeed, if we type

\centerline{\tt char(mod(($-$x\^{}3$+$5$*$x\^{}2$+$x$-$49)$/$7,A),x)}

we obtain the polynomial {\tt A} once again.
\smallskip
Before working with ideals, let us note one more thing. The main part of the
work of the {\tt polred} or {\tt initalg} function is to compute an integral 
basis, i.e. a $\Z$-basis of the maximal order $\Z_K$ of $K$. For a large
polynomial, this implies factoring the discriminant of the polynomial, which
is very often out of the question. There are two ways in which the situation 
may be improved. First, it is often the case that the polynomial that one 
considers is of quite a special type, giving some information on the
discriminant. For example, one may know in advance that the discriminant is a
square. Hence we can ``help'' PARI by giving it that information. More
precisely, using the extra information that we have we may be able to factor
the discriminant of the polynomial. We can then use the function 
{\tt factoredbase} or {\tt factoredpolred} (see Chapter 3)
to inform PARI of this factorization. The function {\tt factoredinitalg} 
has not been written, but it would of course be a trivial task. Note that
one can use the function {\tt addprimes} to simulate such a function.

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

\centerline{\tt factoredbase(T,[7,6;1537461,1])}

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

\centerline{\tt pd=primedec(nf,7)}

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

\centerline{\tt hp=idealmul(nf,idmat(4),pr1)}

or in fact simply 

\centerline{\tt hp=idealmul(nf,1,pr1)}

or even simpler yet

\centerline{\tt hp=idealhermite(nf,pr1)}

and we have the desired HNF. 

We can now perform ideal operations. For example type

\centerline{\tt hp3=idealmul(nf,hp,idealmul(nf,hp,hp))}

or more simply

\centerline{\tt hp3=idealpow(nf,hp,3)}

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

\centerline{\tt for(j=1,4,print(idealval(nf,hp3,pd[j])))}

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

\centerline{\tt hr=hr1;for(j=1,3,hr=ideallllred(nf,hr,[1,5]);print(hr))}

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

\centerline{\tt arch=hr[2]$-$hr1[2];l1=arch[1];l2=arch[2];}

From this, we obtain the logarithmic embedding of the unit by typing

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

{\tt v=exp(v1);au=gauss(m,v);}

{\tt vu=round(real(au))}

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

There is of course no reason for {\tt u} to be a fundamental unit.
Let us see if it is a square. Type {\tt f1=factor(subst(char(u,x),x,x\^{}2))}.
We see that the characteristic polynomial of {\tt u} where {\tt x}
is replaced by {\tt x\^{}2} is a product of 2 polynomials of degree 4, hence
{\tt u} is a square.

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

Have you solved the problem? Good for you! Yes, the problem occurs because
as mentioned before (but you may not have noticed since it is not stressed
in standard textbooks) although the number field $K$ is not Galois over
$\Q$, there does exist a non-trivial automorphism, and we have found it
above by using the function {\tt galoisconj}. Indeed, if we apply this
automorphism to {\tt up2} (by typing {\tt mod(subst(lift(up2),x,aut),A)}
where {\tt aut} is the non-trivial component of {\tt galoisconj(nf)}
computed above), we find the opposite of {\tt u2}, which is OK.
\smallskip
Still another method which avoids all sign ambiguities and automorphism
problems is as follows. Type {\tt r=f1[1,1]\%(x\^{}2$-$u)} to find the remainder
of the characteristic polynomial of {\tt u2} divided by {\tt x\^{}2$-$u}.
This will be a polynomial of degree 1 in {\tt x} (with polymod coefficients)
and we know that {\tt u2}, being a root of both polynomials will be the
root of {\tt r}, hence can be obtained by typing 
{\tt u2=$-$coeff(r,0)$/$coeff(r,1)}. Indeed, we immediately find the
correct result with no trial and error.
\smallskip
Still another method to find the square root of {\tt u} is to use
{\tt factornf(T,y\^{}2$+$u)}. I leave you to work out the details.
\smallskip
Now ideals can be used in a wide variety of formats. We have already seen
HNF-representations, ideles and prime ideals. We can also use algebraic
numbers. For example type {\tt al=mod(x\^{}2$-$9,A)}, then 
{\tt principalidele(nf,al)}. We obtain the idele corresponding to {\tt al}
(see the manual for the exact description). However it is usually not necessary
to compute this explicitly since this is done automatically inside PARI.
For example, you can type

\centerline{\tt for(j=1,4,print(j,": ",idealval(nf,al,pd[j])))}

We see that the valuation is non-zero (equal to 1) at the prime ideals 
{\tt pd[2]} and {\tt pd[3]}. In addition, typing {\tt norm(al)} shows that
{\tt al} is of norm $49=7^2$. Let's check this differently. Type 
{\tt pd23=idealmul(nf,pd[2],pd[3])} and then {\tt idealmul(nf,al,idmat(4))}.
We see that the results are the same, hence the product of the two prime
ideals {\tt pd[2]} and {\tt pd[3]} is equal to the principal ideal generated
by {\tt al}. There is still something to be done with this examples as we
shall see below with the function {\tt isprincipalgen}.
Essentially all functions that you would want on ideals are available.
We mention here the complete list, referring to Chapter 3 for detailed
explanations:

{\tt idealadd}, {\tt idealaddone}, {\tt idealaddmultone}, {\tt idealappr},
{\tt idealapprfact}, {\tt idealdiv}, {\tt idealdivexact}, 
{\tt idealfactor}, {\tt idealhermite}, {\tt idealhermite2},
{\tt idealintersect}, {\tt idealinv}, {\tt ideallllred}, {\tt idealmul},
{\tt idealmulred}, {\tt idealnorm}, {\tt idealpow}, {\tt idealpowred},
{\tt idealtwoelt}, {\tt idealtwoelt2}, {\tt idealval}, {\tt isideal},
{\tt minideal}, {\tt principalideal}, {\tt principalidele}.

We will also see {\tt isprincipal} and {\tt isprincipalgen} below (don't try
it now because you need a much larger {\tt initalg}).

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

Type for example {\tt m=buchgenfu(A)}, where {\tt A} is the same 
polynomial as before. After some work, we get a matrix with one column, which
we extract by typing {\tt v=m[,1];} Then $v$ is a vector with 10 components.
We immediately recognize the first component as being the polynomial {\tt A}
once again. The really new things start as the fifth component. We see that the
class number $v[5][1]$ is equal to 4, that the class group $v[5][2]$ is cyclic,
(and $v[5][3]$ gives us a generator in HNF), that the regulator $v[6]$ is 
equal to $3.794\dots$. Then $v[7]$ which is close to 1 tells us that the 
results should be correct under a lot of assumptions (i.e. the class group or
the regulator are not smaller). $v[8][1]=6$ tells us that the roots of unity in
the number field are exactly the sixth roots of 1 and $v[8][2]$ gives us a 
primitive sixth root of 1 as a polynomial in $\alpha$, and finally the 
component $v[9][1]$ gives us a fundamental unit as a polynomial in $\alpha$.
This unit must be linked to the unit {\tt u2} found above since the unit
rank is equal to 1. 

To find the relation (without trial and error, because in this case it is
quite easy to see it directly!), let us use the logarithmic embeddings. Type
{\tt uf=mod(v[9][1],A)}, {\tt uu=mod(v[8][2],A)} to get the generators of the 
unit group, then 

{\tt cu2=log(conjvec(u2));cuf=log(conjvec(uf));cuu=log(conjvec(uu));}

to get the (complex) logarithmic embeddings. Then type

{\tt lindep(real([cu2[1],cuf[1],cuu[1]]))} 

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

{\tt lindep([cu2[1],cuf[1],cuu[1],2$*$i$*$pi])} 

The result $[1,-1,-3,0]$ shows that {\tt u2} is probably equal to 
{\tt uf$*$uu$^3$}, which is clear since {\tt uu} is a sixth root of unity,
and which can be checked directly by typing {\tt uf$*$uu$^3$}.

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

You may ignore the last component of {\tt v}.

You will notice that the manual explains that the units are given as 
polynomials in $\alpha$. You may prefer them as vectors of coordinates on
the integral basis. You can go back and forth between those two representations
using the components {\tt nf[7]} and {\tt nf[8]} which were given by
{\tt initalg} above. For example, to obtain the representation on the integral
basis of the primitive sixth root of unity $v[8][2]$, type
{\tt ru=nf[8]$*$vvector(4,j,coeff(v[8][2],j$-$1))}. Conversely, to come back to
the initial representation type {\tt mod(nf[7]$*$ru,A)}.
\smallskip
The {\tt buchgenfu} program is in fact even more powerful. Instead of using
{\tt buchgenfu}, we are going to use a variant, which is going to give us
even more information. Type 

{\tt setrand(1);bnf=buchinitfu(A);}.

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

To initialize the number field, no need to use {\tt initalg}: simply type
{\tt nf=bnf[7]}. Of course in our case this had already been done.
We are now ready to perform more sophisticated operations in the class group.
For example, let us take again our prime ideal {\tt hp} above 7. Since we
know that the class group is of order 4, we deduce that {\tt hp} raised to
the fourth power must be principal. Type {\tt hp4=idealpow(nf,hp,4)} then
{\tt vis=isprincipalgen(bnf,hp4)}. The function {\tt isprincipalgen} now uses
all the information contained in {\tt buchinit} and tells us that indeed 
{\tt hp4} is principal. More precisely, the first component, $[0]$, gives us 
the position of the ideal in the class group. Here, $[0]$ means that it is up
to equivalence equal to the 0-th power of the generator given by 
{\tt buchinit} or {\tt buchgen}, in other words that it is a principal ideal.

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

Let us check that the result is correct: first, type {\tt norm(alpha)}.
It is indeed equal to $7^4=2401$, which is the norm of hp4 (it could also
have been equal to $-2401$). This is only a first check. The complete check
is obtained by computing the HNF of the principal ideal generated by 
{\tt alpha}. To do this, type {\tt idealmul(nf,idmat(4),mat(vis[2]))}
(or more simply {\tt idealhermite(nf,alpha)}).

Here, {\tt idmat(4)} represents the ideal $\Z_K$ itself, and we must convert
{\tt vis[2]} into a one-column matrix using the function {\tt mat}, otherwise
{\tt idealmul} may complain. The result that we obtain is identical to
{\tt hp4}, thus showing that {\tt alpha} is correct (not that there was any
doubt!). You may ignore the third component of {\tt vis} which just tells us
that the accuracy to which {\tt alpha} was computed was largely sufficient.

But {\tt isprincipalgen} also gives us information for non-principal ideals.
For example, type 

{\tt vit=isprincipalgen(bnf,hp)}.

The component {\tt vit[1]}
is now equal to $[3]$, and tells us that {\tt hp} is ideal-equivalent to
the cube of the generator {\tt g} given by {\tt buchinit} or 
{\tt buchgen}.
The second component {\tt vit[2]} gives us $\alpha$ on the integral basis
such that {\tt hp$=\alpha g^3$}. Note that if you {\it don't\/} want this
$\alpha$, which may be large and whose computation may take some time, you
can just use the function {\tt isprincipal} which only returns the first
component (i.e.~the position in the class group) of {\tt isprincipalgen}.
\smallskip
Let us now take the example of the principal ideal {\tt pd23} that we have 
seen above. We know that {\tt pd23} is principal, but of course we have
forgotten the generator that we had found, so we want one. For this,
we type {\tt pp=isprincipalgen(bnf,pd23)}. The first component of the result is
{\tt [0]}, telling us that the ideal is indeed principal, as we knew already. 
But the second component gives us the components of a generator of {\tt pd23}
on the integral basis. To get it on the power basis, type
{\tt al2=mod(nf[7]$*$pp[2],A)}. Now we remember suddenly that we already
had a generator {\tt al} for the same ideal. Hence type {\tt u3=al2/al}.
This must be a unit. To check this, computing its norm would not be
sufficient, we need the complete characteristic polynomial, so we type
{\tt char(u3,x)}, and indeed it has integral coefficients with constant term 1
so {\tt u3} is a unit. You can again find out what unit it is as we did above.
However, as we mentioned, this is not really the best method.

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

{\tt me=concat(bnf[3],[2,2]~)}.

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

{\tt cu3=principalidele(nf,u3)[2]} 

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

Then type {\tt xc=gauss(real(me),real(cu3))}

Whatever field we are in, if {\tt u3} is a unit this {\it must} end with
a 0 (approximate of course)
because of the ``spurious'' vector $[2,2]$, and the other components (here
only one) give the exponents on the fundamental units. Here the only other
component is the first, with a coefficient of $1$, so we know that {\tt u}
is equal to {\tt uf} multiplied by a root of unity.

To find this root of unity, we type {\tt xd=cu3$-$me$*$xc} then
{\tt xu=principalidele(nf,uu)[2]} and finally {\tt xd[1]/xu[1]}. We find
$3$ as a result, so finally our unit {\tt u3} must be equal to 
{\tt uu\^{}3$*$uf} itself, which is the case.

Although the above operations are easily performed, they are a little tedious,
hence PARI has incorporated the above in a function called {\tt isunit}.
So instead of doing the above, you simply type {\tt isunit(bnf,u3)}
and the result $[1,mod(3,6)]$ tells us that {\tt u3} is equal to
{\tt uu\^{}3$*$uf} as before.
\medskip
To be completed
\medskip
\section{Using Transcendental Functions}
\medskip
All the elementary transcendental functions and several higher transcendental
functions (gam\-ma function, incomplete gamma function, error function, 
exponential integral, K-bessel functions, confluent hypergeometric functions, 
Riemann zeta function, polylogarithms, Weber functions, theta functions) are 
provided. More could be written if the need arose.

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

Unfortunately, this philosophy cannot go too far. For example, when you
type {\tt cos(0)}, GP should give you exactly 1. Since it is reasonable for
a program to assume that a transcendental function never gives you an exact
result, GP gives you $1.000\dots$ to one more mantissa word than the current
precision.
\medskip
OK, now let's see some more transcendental functions at work. Type
{\tt gamma(10)}. No problem (type {\tt 9!} to check). Type {\tt gamma(100)}.
The number is now written in exponential format because the default
accuracy is too small to give the correct result (type {\tt 99!} to get the 
complete answer).
To get the complete value, there are two solutions. The first and most natural
one is to increase the precision. Since {\tt gamma(100)} has 156 decimal
digits, type {\tt\bs precision=170} (to be on the safe side), then
{\tt gamma(100)} once again. After some work, the printed result is this time
perfectly correct.

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

\centerline{\tt if(norm(z2)<norm(z1),t3=t1;t1=t2;t2=t3;z1=z2,);}

\centerline{\tt while(norm(z2)>10\^{}$-$50,t2=(t1$+$t2)/2.;z2=zeta(t2);\bs}

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

{\tt pi/2/intnum(t=0,pi/2,1/sqrt(1$+$sin(t)\^{}2))},

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

You of course know the formula $\pi=4(1-\dfrac13+\dfrac15-\dfrac17+\cdots)$
which is deduced from the power series expansion of {\tt atan(x)}. You also
know that $\pi$ cannot be computed from this formula, since the convergence
is so slow. Right? Wrong! Type {\tt\bs precision=100} (just to make it
more astonishing), then {\tt 4$*$sumalt(k=0,($-$1)\^{}k/(2$*$k$+$1))}. In a
few seconds (admittedly more than simply typing {\tt pi}), we get $\pi$ to
100 significant digits (type {\tt pi} to check). In version 1.38, the method
used was a combination of a method due to Euler for accelerating alternating 
sums, and a programming trick due to the Dutch mathematician van Wijngaarden
(see Numerical Recipes for an explanation). The method which we presently
use is considerably better, and is due to a combination of ideas of 
F.~Villegas, D.~Zagier and H.~Cohen.

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

Even better, {\tt sumalt} can be used to sum divergent series! Type

\centerline{\tt f(s)=sumalt(k=1,($-$1)\^{}(k$-$1)/k\^{}s)/(1$-$2\^{}(1$-$s))}

(this example has already been given in Chapter 3).

Then for positive values of {\tt s} different from 1, {\tt f(s)} is equal
to {\tt zeta(s)} and the series cvonverges, albeit slowly (sumalt doesn't
care however). For negative {\tt s}, the series diverges, but {\tt f(s)}
still gives the correct result! Try {\tt f($-$1)}, {\tt f($-$2)}, {\tt f($-$1.5)},
and compare with the corresponding values of {\tt zeta}.
You should not push the game too far: {\tt f($-$14.5)} gives a completely
wrong answer for example.

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

\centerline{\tt f(z,u)=u=exp(z);(u$-$1)/(u$-$z)}

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

\centerline{\tt s(x,u)=u=exp(x);u$*$cos(sqrt(u$*$u$-$x$*$x))$-$x}

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

\centerline{\tt x0=solve(x=0,1,s(x))}

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

{\tt solve(t=14,15,real(zeta(1/2$+$i$*$t)))},

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

{\tt solve(t=14,15,imag(zeta(1/2$+$i$*$t)))},

and this now works. We could also narrow the search interval and type for
instance 

{\tt solve(t=14,14.2,real(zeta(1/2$+$i$*$t)))} 

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

{\tt for(k=1,20,print(powell(e,q,k)))},

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

{\tt iv=indsort(hv)}, then {\tt hv=extract(hv,iv)} and {\tt v=extract(v,iv)}.

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

{\tt m=mathell(e,extract(v,[1,2,3,4]));det(m)}

Since the curve has no torsion, the determinant being close to zero
implies that the first four points are dependent. To find the dependency,
it is enough to find the kernel of the matrix {\tt m}. Since its determinant
is not exactly equal to zero, it will be empty. We need an approximate kernel
function, and this is the PARI function {\tt kerr}. So type {\tt kerr(m)}, 
and we indeed get a non-trivial kernel, and the coefficients are (close to)
integers as they should. Typing {\tt addell(e,v[1],v[3])} does indeed show
that it is equal to {\tt v[4]}.

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

Type {\tt f=x$*$series(anell(e,30),x)}. This gives a power series which,
is the Fourier expansion of a modular form of weight 2 on $\Gamma_0(5077)$
(this has been proved directly, but also follows from Wiles's result since
{\tt e} is semi-stable). In fact, to find the modular parametrization of
the curve, type {\tt modul=taniyama(e)}, then {\tt u=modul[1];v=modul[2];}.
Type {\tt (v\^{}2$+$v)$-$(u\^{}3$-$7$*$u$+$6)} to see that this parametrizes
the curve.

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

Now type {\tt ls=lseriesell(e,1,11,1)}, and just as a check
{\tt lseriesell(e,1,11,1.1)}. The values agree (approximately) as they should,
and give the value of the L-function of {\tt e} at 1. Now according to
the Birch and Swinnerton-Dyer conjecture (which is proved for this curve),
{\tt ls} is given by the following formula (in this case):
$$L(E,1)=\dfrac{\Omega\cdot c\cdot\text{Sha}}{|E_{\text{tors}}|^2}\enspace,$$
where $\Omega$ is the real period of $E$, $c$ is the global Tamagawa number,
product of the local $c_p$ for primes $p$ dividing the conductor, Sha is the
order of the Tate-Shafarevitch group, and $E_{\text{tors}}$ is the torsion
group of $E$.

Now we know many of these quantities: $\Omega$ is equal to {\tt e[15]}
(if there had been 3 real roots instead of 1 in {\tt e[14]}, $\Omega$ would
be equal to {\tt 2$*$e[15]}). The Tamagawa number $c$ is given as the last
component of {\tt globalred(e)}, and here is equal to 1. We already know
that the torsion subgroup of $E$ contains a point of order 5, and 
typing {\tt torsell(e)} shows that it is of order exactly 5. Hence type 
{\tt ls$*$25/e[15]}. We find $1.00000\dots$ as a result, which shows that 
Sha must be equal to 1.
\medskip
\section{Functions Related to Polynomials and Power Series}
\medskip
First a word of warning to the unwary: it is essential to understand the
crucial difference between exact and inexact objects (see Chapter 1). This
is especially important in the case of polynomials. Let's immediately take
a plunge into these problems. Type {\tt gcd$(\x^2-1,\x^2-3*\x+2)$}. No problem,
the result is {\tt x$-$1} as expected. But now type 
{\tt gcd$(\x^2-1.,\x^2-3.*\x+2.)$}. You are lucky, the result is almost
correct except from a bizzare factor of 3 which come from the way PARI does
the computation. In any case, it is still essentially a reasonable result.
But now type {\tt gcd(x$-$pi,x\^{}2$-$6$*$zeta(2))}. Although this should be
equal to {\tt x$-$pi}, PARI finds a constant as a result. This is because the
notion of GCD of non-exact polynomials doesn't make much sense. However, type
{\tt resultant(x$-$pi,x\^{}2$-$6$*$zeta(2))}. The result is extremely close
to zero, showing that indeed the GCD is non-trivial, without telling us
what it is. This being said, we will usually use polynomials (and power series)
with exact coefficients in our examples.
\smallskip
Type {\tt pol=cyclo(15)}. This gives the $15$-th cyclotomic polynomial.
Type {\tt r=roots(pol)}. You have the 8 complex roots of pol given to 28
significant digits. To see them better, type {\tt\bs b}. As you see, they are
given as pairs of complex conjugate roots, in a random order. The only ordering
done by the function {\tt roots} concerns the real roots, which are given
first, and in increasing order.

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

We see that the components of the result are very close to 1. It is however
tedious to look at all these real and imaginary parts. It would be impossible
if we had many more. Let's do it automatically. Type {\tt rr=round(real(rc))},
then {\tt sqrt(norml2(rc-rr))}. We see that {\tt rr} is indeed all 1's, and
that the L2-norm of {\tt rc-rr} is around $10^{-27}$, reasonable enough when we
work with 28 significant digits. Note that the function {\tt norml2}, contrary
to what it may seem, does not give the L2 norm but its square, hence we must
take the square root (well, not really in this case!).
\smallskip
However, it is necessary to stress the fact that the {\tt roots} function of
PARI is {\it not} very robust, and may sometime give wrong answers. This
may be corrected in some future version, but the user should be aware of this.
It has been designed essentially for speed. A slower and sometimes better
version is {\tt rootslong}, but even that sometimes fails. For example. type
{\tt pol=(x$-$10000)$*$(x$-$10001)}, then {\tt roots(pol)}. The result is
clearly wrong. If however we type {\tt rootslong(pol)} the results are now
correct. But now type {\tt pol2=subst(pol,x,x$*$10000)$/$10\^{}8}, then
{\tt rootslong(pol2)}. The result is wrong, even with {\tt rootslong}. So be
careful. Essentially, as is well known, the problem occurs when the polynomial
has two roots which are very close. Still, {\tt roots} is very useful.
\smallskip
Now type {\tt pol=x\^{}5$+$x\^{}4$+$2$*$x\^{}3$-$2$*$x\^{}2$-$4$*$x$-$3},
then {\tt factor(pol)}. The polynomial {\tt pol} factors over $\Q$ (or $\Z$)
as a product of two factors. Now type {\tt f(p)=factorpadic(pol,p,10)}.
This creates a function {\tt f(p)} which factors {\tt pol} over $\Q_p$ to 
$p$-adic precision 10. Type {\tt factor(disc(pol))}. We see that the primes
dividing the discriminant are $11$, $23$ and $37$. Type {\tt f(5)}, 
{\tt f(11)}, {\tt f(23)}, and {\tt f(37)} to see different splittings.

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

In fact, even better: type {\tt pol2=x\^{}3$+$x\^{}2$+$x$-$1}, then

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

Now let's type {\tt polsym(pol3,20)}, where {\tt pol3} is the same polynomial
as above. This gives the sum of the $k$-th powers of the roots of {\tt pol3}
up to $k=20$, of course computed using Newton's formula and not using
{\tt roots}. You notice that every odd sum is zero (this is trivial since the
polynomial is even), but also that the signs follow a regular pattern and
that the  (non-zero) absolute values are powers of 2. This is true: prove it,
and more precisely find an explicit formula for the $k$-th symmetric power
not involving (non-rational) algeberaic numbers.
\smallskip
You can also play a little with the function {\tt karamul} (for Karatsuba
multiplication). Put the timer on ({\tt \#}), and then set 
{\tt pol4=(x$+$1)\^{}200;} (do not forget the semicolon, you don't want to
see the result, just the timing. Similarly for the next few commands.
Then type {\tt pol5=pol4$*$pol4;}, and look at the timing. Now type instead
{\tt pol6=karamul(pol4,pol4,5);}. This should be about twice as fast (it is
implementation dependent so the gain may vary). Try with other values than 5.
Also type {\tt pol5$-$pol6} just to be sure that the result is correct.
So if you have polynomials which are that large, it may be worthwhile to use
the function {\tt karamul}.
\medskip
Now let's play a little with power series. We have already done so a little
at the beginning.  Type
\centerline{\tt 8$*$x$+$prod(1$+$O(x\^{}40),n=1,39,if(n\%4,1$-$x\^{}n,1))\^{}8}
You obtain a power series which has apparently only even powers of {\tt x}
appearing. This is surprising, but can be proved using the theory of modular
forms. Note that we have initialized the product to {\tt 1$+$O(x\^{}40)} and
not simply to 1 otherwise the whole computation would have been done with
polynomials, and this would first have been extremely long (try if you want,
but don't forget to type {\tt Ctrl-C} when you get tired of waiting) and also
totally useless since the coefficients of {\tt x\^{}40} and above are 
irrelevant anyhow if we stop the product at {\tt n=39}.

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

----- TO BE COMPLETED -----

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

\vfill\eject
