basvandorst/cryptography-archive/Cryptix_src_3-1-0/guide/cryptography/prng.gif

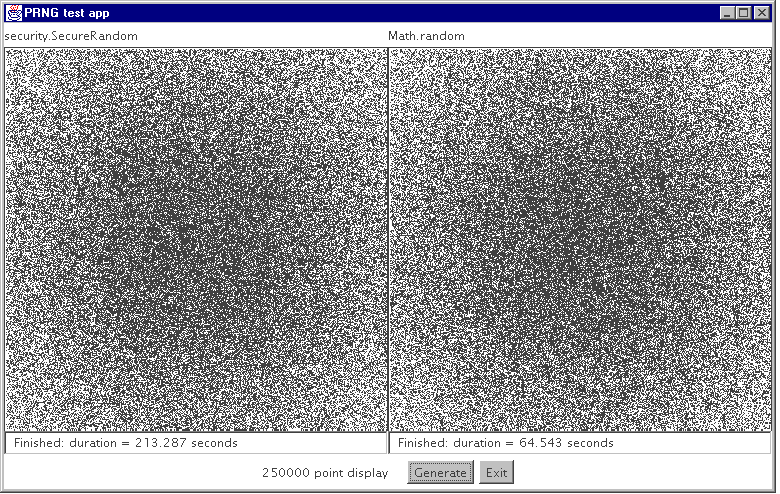
Cryptix_src_3-1-0/guide/cryptography/prng.gif
