basvandorst/cryptography-archive/pgp55win95nt-src/pgp55/clients/pgp/win32/Installer/tempstuff/sidebar.bmp

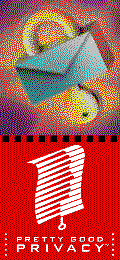
pgp55win95nt-src/pgp55/clients/pgp/win32/Installer/tempstuff/sidebar.bmp
