basvandorst/cryptography-archive/pgp55win95nt-src/pgp55/clients/pgp/win32/Installer/tempstuff/sidebarx.bmp

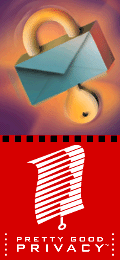
pgp55win95nt-src/pgp55/clients/pgp/win32/Installer/tempstuff/sidebarx.bmp
