basvandorst/cryptography-archive/pgp651i-mac-src/pgp651i/clients/pgp/cmdline/packaging/Install/Setup Files/Uncompressed Files/Language Independent/OS Independent/setup.bmp

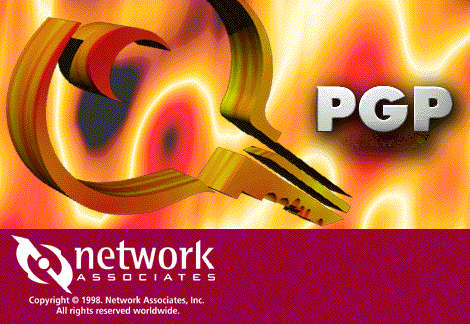
pgp651i-mac-src/pgp651i/clients/pgp/cmdline/packaging/Install/Setup Files/Uncompressed Files/Language Independent/OS Independent/setup.bmp
