basvandorst/cryptography-archive/pgp651i-win-src/pgp651i/clients/pgp/win32/PGPinstall/supportfiles/freeware/sidebar.bmp

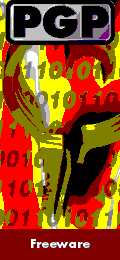
pgp651i-win-src/pgp651i/clients/pgp/win32/PGPinstall/supportfiles/freeware/sidebar.bmp
