basvandorst/cryptography-archive/pgp651i-win-src/pgp651i/clients/pgp/win32/PGPinstall/supportfiles/freeware/sidebarx.bmp

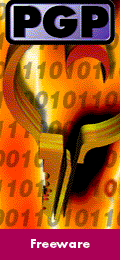
pgp651i-win-src/pgp651i/clients/pgp/win32/PGPinstall/supportfiles/freeware/sidebarx.bmp
