basvandorst/cryptography-archive/allen-des486/VALIDATE.TXT

# Test vectors for DES Electronic Code Book (ECB)
# implementation, derived from:
#   "Validating the Correctness of Hardware
#   Implementations of the NBS Data Encryption Standard"
#   NBS Special Publication 500-20, 1980.
#
#    Initial Permutation and Expansion test
#
;encrypt
#
;   KEY              PLAIN            CIPHER
 0101010101010101 95F8A5E5DD31D900 8000000000000000
 0101010101010101 DD7F121CA5015619 4000000000000000
 0101010101010101 2E8653104F3834EA 2000000000000000
 0101010101010101 4BD388FF6CD81D4F 1000000000000000
 0101010101010101 20B9E767B2FB1456 0800000000000000
 0101010101010101 55579380D77138EF 0400000000000000
 0101010101010101 6CC5DEFAAF04512F 0200000000000000
 0101010101010101 0D9F279BA5D87260 0100000000000000
 0101010101010101 D9031B0271BD5A0A 0080000000000000
 0101010101010101 424250B37C3DD951 0040000000000000
 0101010101010101 B8061B7ECD9A21E5 0020000000000000
 0101010101010101 F15D0F286B65BD28 0010000000000000
 0101010101010101 ADD0CC8D6E5DEBA1 0008000000000000
 0101010101010101 E6D5F82752AD63D1 0004000000000000
 0101010101010101 ECBFE3BD3F591A5E 0002000000000000
 0101010101010101 F356834379D165CD 0001000000000000
 0101010101010101 2B9F982F20037FA9 0000800000000000
 0101010101010101 889DE068A16F0BE6 0000400000000000
 0101010101010101 E19E275D846A1298 0000200000000000
 0101010101010101 329A8ED523D71AEC 0000100000000000
 0101010101010101 E7FCE22557D23C97 0000080000000000
 0101010101010101 12A9F5817FF2D65D 0000040000000000
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
E0FEE0FEF1FEF1FE 0123456789ABCDEF EDBFD1C66C29CCC7
0000000000000000 FFFFFFFFFFFFFFFF 355550B2150E2451
FFFFFFFFFFFFFFFF 0000000000000000 CAAAAF4DEAF1DBAE
0123456789ABCDEF 0000000000000000 D5D44FF720683D0D
FEDCBA9876543210 FFFFFFFFFFFFFFFF 2A2BB008DF97C2F2
