basvandorst/cryptography-archive/des-validation/des-validation.txt

From msuinfo!uchinews!ux1.cso.uiuc.edu!uwm.edu!wupost!uunet!mcsun!uknet!strath-cs!ALMAC!keith.willis Sat Jul 18 20:50:40 1992
Path: msuinfo!uchinews!ux1.cso.uiuc.edu!uwm.edu!wupost!uunet!mcsun!uknet!strath-cs!ALMAC!keith.willis
From: keith.willis@almac.co.uk
Newsgroups: sci.crypt
Subject: des validation 1/2
Message-ID: <1992Jul17.864.235@ALMAC>
Date: 17 Jul 92 18:30:55 GMT
Distribution: sci
Organization: ALMAC PC Board
Lines: 107

        If anyone is interested, here is a reasonable sized DES
        validation set.  Col 1 is the key, col 2 is the plaintext,
        and col 3 is the expected ciphertext.

---------------------------------------------------------------------
0000000000000000 0000000000000000 8CA64DE9C1B123A7
FFFFFFFFFFFFFFFF FFFFFFFFFFFFFFFF 7359B2163E4EDC58
3000000000000000 1000000000000001 958E6E627A05557B
1111111111111111 1111111111111111 F40379AB9E0EC533
0123456789ABCDEF 1111111111111111 17668DFC7292532D
1111111111111111 0123456789ABCDEF 8A5AE1F81AB8F2DD
0000000000000000 0000000000000000 8CA64DE9C1B123A7
FEDCBA9876543210 0123456789ABCDEF ED39D950FA74BCC4
7CA110454A1A6E57 01A1D6D039776742 690F5B0D9A26939B
0131D9619DC1376E 5CD54CA83DEF57DA 7A389D10354BD271
07A1133E4A0B2686 0248D43806F67172 868EBB51CAB4599A
3849674C2602319E 51454B582DDF440A 7178876E01F19B2A
04B915BA43FEB5B6 42FD443059577FA2 AF37FB421F8C4095
0113B970FD34F2CE 059B5E0851CF143A 86A560F10EC6D85B
0170F175468FB5E6 0756D8E0774761D2 0CD3DA020021DC09
43297FAD38E373FE 762514B829BF486A EA676B2CB7DB2B7A
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
018310DC409B26D6 1D9D5C5018F728C2 5F4C038ED12B2E41
1C587F1C13924FEF 305532286D6F295A 63FAC0D034D9F793

---
 ~ PQ 2.15 194 ~ Dead? No. Electroencephelographically challenged
--
ALMAC PC Board BBS 0324-665371 Call for details!
ALMAC PC Board BBS 0324-665371
