basvandorst/cryptography-archive/apache_ssl_0/ApacheSSL/ssl/test/test.txt

#!/bin/sh

test=./test.txt

cat $0 >$test;

for i in rc4 des-cfb des-ofb des-ecb des-cbc des-ede des-ede3 \
	des-cbc-ede des-cbc-ede3 idea-ecb idea-cfb idea-ofb idea-cbc 
do
	echo $i
	../apps/enc -e -k test -$i < $test > $test.$i.cipher
	../apps/enc -d -k test -$i < $test.$i.cipher >$test.$i.clear
	cmp $test $test.$i.clear
	if [ $? != 0 ]
	then
		exit 1
	else
		/bin/rm $test.$i.cipher $test.$i.clear
	fi

	echo $i base64
	../apps/enc -a -e -k test -$i < $test > $test.$i.cipher
	../apps/enc -a -d -k test -$i < $test.$i.cipher >$test.$i.clear
	cmp $test $test.$i.clear
	if [ $? != 0 ]
	then
		exit 1
	else
		/bin/rm $test.$i.cipher $test.$i.clear
	fi
done
