basvandorst/cryptography-archive/pgpman13/history.txt

Versions history

1.0 :	
	-Initial relase.

1.1:
	-Public keys would not be reread once a key was
	 added.

1.2:
	-Added -z PGP option handling to give PGP your pass
	 phrase.

1.3:
	-Pgp was no called properly under Win31.
	-Added PGPMNGR1.PIF.
	-Added SEND command to send message in the mail.
