basvandorst/cryptography-archive/rsa-faq/rsa-faq.txt

From msuinfo!netnews.upenn.edu!dsinc!newsfeed.pitt.edu!gatech!udel!MathWorks.Com!news.kei.com!bloom-beacon.mit.edu!senator-bedfellow.mit.edu!faqserv Sat Apr 30 21:01:13 1994
Path: msuinfo!netnews.upenn.edu!dsinc!newsfeed.pitt.edu!gatech!udel!MathWorks.Com!news.kei.com!bloom-beacon.mit.edu!senator-bedfellow.mit.edu!faqserv
From: faq-editor@rsa.com
Newsgroups: sci.crypt,talk.politics.crypto,alt.security.ripem,sci.answers,talk.answers,alt.answers,news.answers
Subject: RSA Cryptography Today FAQ (1/3)
Supersedes: <cryptography-faq/rsa/part1_765391177@rtfm.mit.edu>
Followup-To: poster
Date: 29 Apr 1994 21:57:24 GMT
Organization: none
Lines: 1030
Approved: news-answers-request@mit.edu
Expires: 3 Jun 1994 21:51:38 GMT
Message-ID: <cryptography-faq/rsa/part1_767656298@rtfm.mit.edu>
Reply-To: faq-editor@rsa.com
NNTP-Posting-Host: bloom-picayune.mit.edu
X-Last-Updated: 1994/02/10
Originator: faqserv@bloom-picayune.MIT.EDU
Xref: msuinfo sci.crypt:26605 talk.politics.crypto:4951 alt.security.ripem:715 sci.answers:1111 talk.answers:219 alt.answers:2601 news.answers:21655

Archive-name: cryptography-faq/rsa/part1
Last-modified: 93/09/20
Version: 2.0

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

===

                          Answers To
                 FREQUENTLY ASKED QUESTIONS
                 About Today's Cryptography

                          Paul Fahn
                      RSA Laboratories
                     100 Marine Parkway
                   Redwood City, CA  94065

   Copyright (c) 1993 RSA Laboratories, a division of RSA Data Security,
      Inc. All rights reserved.

   Version 2.0, draft 2f
   Last update: September 20, 1993

------------------------------------------------------------------------
                         Table of Contents

[ part 1 ]

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

[ part 2 ]

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

[part 3]

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

--------------------------------------------------------------------

1 General

1.1 What is encryption?

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

1.2 What is authentication? What is a digital signature?

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

1.3 What is public-key cryptography? 

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

1.4 What are the advantages and disadvantages of public-key cryptography 
    over secret-key cryptography?}

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

1.5 Is cryptography patentable in the U.S.?

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

1.6 Is cryptography exportable from the U.S.?

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

2 RSA

2.1 What is RSA?

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

2.2 Why use RSA rather than DES?

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

2.3 How fast is RSA?

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

2.4 How much extra message length is caused by using RSA?

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

2.5 What would it take to break RSA?

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

2.6 Are strong primes necessary in RSA?

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

2.7 How large a modulus (key) should be used in RSA?

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

2.8 How large should the primes be?

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

2.9 How does one find random numbers for keys?

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

2.10 What if users of RSA run out of distinct primes?

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

2.11 How do you know if a number is prime?

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

2.12 How is RSA used for encryption in practice?

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

2.13 How is RSA used for authentication in practice?

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

2.14 Does RSA help detect altered documents and transmission errors?

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

2.15 What are alternatives to RSA?

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

2.16 Is RSA currently in use today?

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

2.17 Is RSA an official standard today?

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

2.18 Is RSA a de facto standard? Why is a de facto standard important?

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

2.19 Is RSA patented? 

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

2.20 Can RSA be exported from the U.S.?

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

Regardless of U.S. export policy, RSA is available abroad in non-U.S.
products.

       --------------------------------------------

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

Please send comments and corrections to faq-editor@rsa.com.

===
DISTRIBUTION: How to obtain this document

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

  Usenet
  ------
    This FAQ is posted every 21 days to the groups

      sci.crypt
      talk.politics.crypto
      alt.security.ripem
      sci.answers
      talk.answers
      alt.answers
      news.answers

===
CRAM: the Cyberspatial Reality Advancement Movement

In an effort to bring valuable information to the masses, and
as a service to motivated information compilers, I 
(L. Detweiler) will help others unfamiliar with Usenet 
`publish' their documents for widespread dissemination via the 
FAQ structure, and act as a `sponsor' knowledgable in the 
submissions process. This document is being distributed under
this arrangement.

I have found these compilations tend to appear on various 
mailing lists and are valuable enough to deserve wider 
distribution. If you know of an existing compilation of 
Internet information that is not currently a FAQ, please 
contact me and I may `sponsor' it. The benefits to the author 
include:

- use of the existing FAQ infrastructure for distribution:
  - automated mail server service
  - FTP archival
  - automated posting

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

- with me as your sponsor, I will also take care of the 
  technicalities in the proper format of the posted version 
  and updating procedures, leaving you free of the `overhead' 
  to focus on the basic updates alone

Send comments relating to the *distribution* of this document
(particularly relevant newsgroups not currently covered in
its current distribution) or inquiries on other documents to
<ld231782@longs.lance.colostate.edu>. 

The choice of who I `sponsor' is entirely arbitrary. You always
have the option of handling the submission process yourself. 
See the FAQ submission guidelines FAQ in news.answers.

From msuinfo!netnews.upenn.edu!dsinc!newsfeed.pitt.edu!gatech!howland.reston.ans.net!europa.eng.gtefsd.com!MathWorks.Com!news.kei.com!bloom-beacon.mit.edu!senator-bedfellow.mit.edu!faqserv Sat Apr 30 21:01:13 1994
Path: msuinfo!netnews.upenn.edu!dsinc!newsfeed.pitt.edu!gatech!howland.reston.ans.net!europa.eng.gtefsd.com!MathWorks.Com!news.kei.com!bloom-beacon.mit.edu!senator-bedfellow.mit.edu!faqserv
From: faq-editor@rsa.com
Newsgroups: sci.crypt,talk.politics.crypto,alt.security.ripem,sci.answers,talk.answers,alt.answers,news.answers
Subject: RSA Cryptography Today FAQ (2/3)
Supersedes: <cryptography-faq/rsa/part2_765391177@rtfm.mit.edu>
Followup-To: poster
Date: 29 Apr 1994 21:57:40 GMT
Organization: none
Lines: 1120
Approved: news-answers-request@mit.edu
Expires: 3 Jun 1994 21:51:38 GMT
Message-ID: <cryptography-faq/rsa/part2_767656298@rtfm.mit.edu>
References: <cryptography-faq/rsa/part1_767656298@rtfm.mit.edu>
Reply-To: faq-editor@rsa.com
NNTP-Posting-Host: bloom-picayune.mit.edu
X-Last-Updated: 1994/02/10
Originator: faqserv@bloom-picayune.MIT.EDU
Xref: msuinfo sci.crypt:26606 talk.politics.crypto:4952 alt.security.ripem:716 sci.answers:1112 talk.answers:220 alt.answers:2602 news.answers:21656

Archive-name: cryptography-faq/rsa/part2
Last-modified: 93/09/20
Version: 2.0

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

===

                          Answers To
                 FREQUENTLY ASKED QUESTIONS
                 About Today's Cryptography

                          Paul Fahn
                      RSA Laboratories
                     100 Marine Parkway
                   Redwood City, CA  94065

   Copyright (c) 1993 RSA Laboratories, a division of RSA Data Security,
      Inc. All rights reserved.

   Version 2.0, draft 2f
   Last update: September 20, 1993

------------------------------------------------------------------------
                         Table of Contents

[ part 2 ]

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

--------------------------------------------------------------------

3 Key Management

3.1 What key management issues are involved in public-key cryptography?

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

3.2 Who needs a key?

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

3.3 How does one get a key pair? 

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

3.4 Should a public key or private key be shared among users?

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

3.5 What are certificates?

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

3.6 How are certificates used?

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

3.7 Who issues certificates and how?

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

3.8 What is a CSU, or, How do certifying authorities store their private keys?

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

3.9 Are certifying authorities susceptible to attack?

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

3.10 What if the certifying authority's key is lost or compromised? 

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

3.11 What are Certificate Revocation Lists (CRLs)?

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

3.12 What happens when a key expires?

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

3.13 What happens if I lose my private key?

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

3.14 What happens if my private key is compromised?

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

3.15 How should I store my private key?

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

3.16 How do I find someone else's public key?

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

3.18 What is a digital time-stamping service?

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

4 Factoring and Discrete Log

4.1 What is a one-way function?

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

4.2 What is the significance of one-way functions for cryptography?

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

4.3 What is the factoring problem?

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

4.4 What is the significance of factoring in cryptography?

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

4.5 Has factoring been getting easier?

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

4.6 What are the best factoring methods in use today?

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

4.7 What are the prospects for theoretical factoring breakthroughs?

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

4.8 What is the RSA Factoring Challenge?

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

4.9 What is the discrete log problem?

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

4.10 Which is easier, factoring or discrete log?

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

5 DES

5.1 What is DES?

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

5.2 Has DES been broken?

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

5.3 How does one use DES securely?

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

5.4 Can DES be exported from the U.S.?

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

5.5 What are the alternatives to DES?

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

5.6 Is DES a group?

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

       --------------------------------------------

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

Please send comments and corrections to faq-editor@rsa.com.

===
DISTRIBUTION: How to obtain this document

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

  Usenet
  ------
    This FAQ is posted every 21 days to the groups

      sci.crypt
      talk.politics.crypto
      alt.security.ripem
      sci.answers
      talk.answers
      alt.answers
      news.answers

===
CRAM: the Cyberspatial Reality Advancement Movement

In an effort to bring valuable information to the masses, and
as a service to motivated information compilers, I 
(L. Detweiler) will help others unfamiliar with Usenet 
`publish' their documents for widespread dissemination via the 
FAQ structure, and act as a `sponsor' knowledgable in the 
submissions process. This document is being distributed under
this arrangement.

I have found these compilations tend to appear on various 
mailing lists and are valuable enough to deserve wider 
distribution. If you know of an existing compilation of 
Internet information that is not currently a FAQ, please 
contact me and I may `sponsor' it. The benefits to the author 
include:

- use of the existing FAQ infrastructure for distribution:
  - automated mail server service
  - FTP archival
  - automated posting

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

- with me as your sponsor, I will also take care of the 
  technicalities in the proper format of the posted version 
  and updating procedures, leaving you free of the `overhead' 
  to focus on the basic updates alone

Send comments relating to the *distribution* of this document
(particularly relevant newsgroups not currently covered in
its current distribution) or inquiries on other documents to
<ld231782@longs.lance.colostate.edu>. 

The choice of who I `sponsor' is entirely arbitrary. You always
have the option of handling the submission process yourself. 
See the FAQ submission guidelines FAQ in news.answers.

From msuinfo!netnews.upenn.edu!dsinc!newsfeed.pitt.edu!godot.cc.duq.edu!news.duke.edu!MathWorks.Com!news.kei.com!bloom-beacon.mit.edu!senator-bedfellow.mit.edu!faqserv Sat Apr 30 21:01:14 1994
Path: msuinfo!netnews.upenn.edu!dsinc!newsfeed.pitt.edu!godot.cc.duq.edu!news.duke.edu!MathWorks.Com!news.kei.com!bloom-beacon.mit.edu!senator-bedfellow.mit.edu!faqserv
From: faq-editor@rsa.com
Newsgroups: sci.crypt,talk.politics.crypto,alt.security.ripem,sci.answers,talk.answers,alt.answers,news.answers
Subject: RSA Cryptography Today FAQ (3/3)
Supersedes: <cryptography-faq/rsa/part3_765391177@rtfm.mit.edu>
Followup-To: poster
Date: 29 Apr 1994 21:58:27 GMT
Organization: none
Lines: 1119
Approved: news-answers-request@mit.edu
Expires: 3 Jun 1994 21:51:38 GMT
Message-ID: <cryptography-faq/rsa/part3_767656298@rtfm.mit.edu>
References: <cryptography-faq/rsa/part1_767656298@rtfm.mit.edu>
Reply-To: faq-editor@rsa.com
NNTP-Posting-Host: bloom-picayune.mit.edu
X-Last-Updated: 1994/02/10
Originator: faqserv@bloom-picayune.MIT.EDU
Xref: msuinfo sci.crypt:26607 talk.politics.crypto:4953 alt.security.ripem:717 sci.answers:1113 talk.answers:221 alt.answers:2603 news.answers:21657

Archive-name: cryptography-faq/rsa/part3
Last-modified: 93/09/20
Version: 2.0

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

===

                          Answers To
                 FREQUENTLY ASKED QUESTIONS
                 About Today's Cryptography

                          Paul Fahn
                      RSA Laboratories
                     100 Marine Parkway
                   Redwood City, CA  94065

   Copyright (c) 1993 RSA Laboratories, a division of RSA Data Security,
      Inc. All rights reserved.

   Version 2.0, draft 2f
   Last update: September 20, 1993

------------------------------------------------------------------------
                         Table of Contents

[part 3]

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

--------------------------------------------------------------------

6 Capstone, Clipper, and DSS

6.1 What is Capstone?

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

6.2 What is Clipper?

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

6.3 How does the Clipper chip work?

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

6.4 Who are the escrow agencies?

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

6.5 What is Skipjack?

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

6.6 Why is Clipper controversial?

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

6.7 What is the current status of Clipper?

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

6.8 What is DSS?

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

6.9 Is DSS secure?

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

6.10 Is use of DSS covered by any patents?

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

6.11 What is the current status of DSS?

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

7 NIST and NSA

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

7.2 What role does NIST play in cryptography?

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

7.3 What is the NSA?

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

7.4 What role does the NSA play in commercial cryptography?

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

8 Miscellaneous

8.1 What is the legal status of documents signed with digital signatures?

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

8.2 What is a hash function? What is a message digest?

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

8.3 What are MD2, MD4 and MD5?

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

8.4 What is SHS?

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

8.5 What is Kerberos?

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

8.6 What are RC2 and RC4?

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

8.7 What is PEM?

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

8.8 What is RIPEM?

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

8.9 What is PKCS?

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

8.10 What is RSAREF?

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

9 Acknowledgements

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

BIBLIOGRAPHY

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

2. J. Bamford. The Puzzle Palace. Houghton Mifflin, Boston, 1982.

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

33. D.M. Gordon. Discrete logarithms using the number field sieve. March 28,
    1991. To appear. 

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

37. D. Kahn. The Codebreakers. Macmillan Co., New York, 1967.

38. B.S. Kaliski. A survey of encryption standards. RSA Data Security, Inc.,
    September 2, 1993.

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

42. N. Koblitz. A Course in Number Theory and Cryptography. Springer-Verlag, 
    New York, 1987.

43. N. Koblitz. Elliptic curve cryptosystems. Mathematics of Computation, 
    48:203--209, 1987.

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

65. Office of the Press Secretary. Statement. The White House, April 16, 1993.

66. J. Pollard. Monte Carlo method for factorization. BIT, 15:331--334, 1975.

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

73. R.L. Rivest. RFC 1321: The MD5 Message-Digest Algorithm. Internet
    Activities Board, April 1992.

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

77. R.D. Silverman. The multiple polynomial quadratic sieve. Math. Comp., 
    48:329--339, 1987.

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

       --------------------------------------------

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

Please send comments and corrections to faq-editor@rsa.com.

===
DISTRIBUTION: How to obtain this document

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

  Usenet
  ------
    This FAQ is posted every 21 days to the groups

      sci.crypt
      talk.politics.crypto
      alt.security.ripem
      sci.answers
      talk.answers
      alt.answers
      news.answers

===
CRAM: the Cyberspatial Reality Advancement Movement

In an effort to bring valuable information to the masses, and
as a service to motivated information compilers, I 
(L. Detweiler) will help others unfamiliar with Usenet 
`publish' their documents for widespread dissemination via the 
FAQ structure, and act as a `sponsor' knowledgable in the 
submissions process. This document is being distributed under
this arrangement.

I have found these compilations tend to appear on various 
mailing lists and are valuable enough to deserve wider 
distribution. If you know of an existing compilation of 
Internet information that is not currently a FAQ, please 
contact me and I may `sponsor' it. The benefits to the author 
include:

- use of the existing FAQ infrastructure for distribution:
  - automated mail server service
  - FTP archival
  - automated posting

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

- with me as your sponsor, I will also take care of the 
  technicalities in the proper format of the posted version 
  and updating procedures, leaving you free of the `overhead' 
  to focus on the basic updates alone

Send comments relating to the *distribution* of this document
(particularly relevant newsgroups not currently covered in
its current distribution) or inquiries on other documents to
<ld231782@longs.lance.colostate.edu>. 

The choice of who I `sponsor' is entirely arbitrary. You always
have the option of handling the submission process yourself. 
See the FAQ submission guidelines FAQ in news.answers.
