basvandorst/cryptography-archive/rsafaq/faq.tex

%                          Answers To
%                 FREQUENTLY ASKED QUESTIONS
%                 About Today's Cryptography
%
%   Paul Fahn
%   RSA Laboratories
%   100 Marine Parkway
%   Redwood City, CA  94065
%
%   Copyright (c) 1993 RSA Laboratories, a division of RSA Data Security,
%      Inc. All rights reserved.
%
%   Version 2.0, draft 2f
%   Last update: September 20, 1993
%

\documentstyle {article}
\newcommand{\question}[2] { \subsection{{\it #2}} \label{#1} }
\begin {document}

% ------------------- Title Page -------------------
{\pagestyle{empty}
\Huge
\vspace*{16mm}
\begin{center}
{\LARGE Answers To} \\
Frequently Asked Questions \\
About Today's Cryptography 
%{\LARGE With Answers Provided}
\end{center}
\vskip 1in
\Large
\begin{center}
Paul Fahn \\
RSA Laboratories \\
100 Marine Parkway \\
Redwood City, CA  94065
\end{center}
\normalsize
\vskip 2.2in
\noindent Version 2.0, draft 2f. \par
\noindent Last update: September 20, 1993. \par
\noindent Copyright \copyright\ 1993 RSA Laboratories, a division of RSA
          Data Security, Inc. \par
\noindent All rights reserved. \par
%\noindent Part \#999-100002-100-000-000 \par
\noindent Part \#002-903002-200-02f-000 \par
\newpage
} \pagenumbering{roman}
%--------------------------------------

\tableofcontents
\newpage
\pagenumbering{arabic}

\section {General}
\question {q:aa}
{What is encryption?}
Encryption is the transformation of data into a form unreadable by anyone
without a secret decryption key. Its purpose is to ensure privacy by
keeping the information hidden from anyone for whom it is not intended, 
even those who can see the encrypted data. For example, one may wish to 
encrypt files on a hard disk to prevent an intruder from reading them. 

In a multi-user setting, encryption allows secure communication over an
insecure channel. The general scenario is as follows: Alice wishes to 
send a message to Bob so that no one else besides Bob can read it. Alice 
encrypts the message, which is called the plaintext, with an encryption 
key; the encrypted message, called the ciphertext, is sent to Bob. Bob 
decrypts the ciphertext with the decryption key and reads the message. An 
attacker, Charlie, may either try to obtain the secret key or to recover 
the plaintext without using the secret key. In a secure cryptosystem, the 
plaintext cannot be recovered from the ciphertext except by using the 
decryption key. In a symmetric cryptosystem, a single key serves as both 
the encryption and decryption keys.

Cryptography has been around for millennia; see Kahn \cite{kahn} for a 
good history of cryptography; see Rivest \cite{rivest-survey} and Brassard
\cite{brassard} for an introduction to modern cryptography.

\question {q:ab}
{What is authentication? What is a digital signature?}
Authentication in a digital setting is a process whereby the receiver of a 
digital message can be confident of the identity of the sender and/or the
integrity of the message. Authentication protocols can be based on either 
conventional secret-key cryptosystems like DES or on public-key systems 
like RSA; authentication in public-key systems uses digital signatures.

In this document, authentication will generally refer to the use of digital
signatures, which play a function for digital documents similar to that 
played by handwritten signatures for printed documents: the signature is an 
unforgeable piece of data asserting that a named person wrote or otherwise 
agreed to the document to which the signature is attached. The recipient, as 
well as a third party, can verify both that the document did indeed originate 
from the person whose signature is attached and that the document has not 
been altered since it was signed. A secure digital signature system thus 
consists of two parts: a method of signing a document such that forgery is 
infeasible, and a method of verifying that a signature was actually generated 
by whomever it represents. Furthermore, secure digital signatures cannot be 
repudiated; i.e., the signer of a document cannot later disown it by claiming 
it was forged.

Unlike encryption, digital signatures are a recent development, the
need for which has arisen with the proliferation of digital communications.

\question {q:ac}
{What is public-key cryptography? }
Traditional cryptography is based on the sender and receiver of a message 
knowing and using the same secret key: the sender uses the secret key to 
encrypt the message, and the receiver uses the same secret key to decrypt 
the message. This method is known as secret-key cryptography. The main 
problem is getting the sender and receiver to agree on the secret key 
without anyone else finding out. If they are in separate physical locations, 
they must trust a courier, or a phone system, or some other transmission 
system to not disclose the secret key being communicated. Anyone who 
overhears or intercepts the key in transit can later read all messages 
encrypted using that key. The generation, transmission and storage of keys 
is called key management; all cryptosystems must deal with key management 
issues. Secret-key cryptography often has difficulty providing secure key 
management.

Public-key cryptography was invented in 1976 by Whitfield Diffie and
Martin Hellman \cite {diffie-hellman} in order to solve the key management
problem. In the new system, each person gets a pair of keys, called the 
public key and the private key. Each person's public key is published while 
the private key is kept secret. The need for sender and receiver to share 
secret information is eliminated: all communications involve only public 
keys, and no private key is ever transmitted or shared. No longer is it 
necessary to trust some communications channel to be secure against 
eavesdropping or betrayal. Anyone can send a confidential message just using 
public information, but it can only be decrypted with a private key that 
is in the sole possession of the intended recipient. Furthermore, public-key 
cryptography can be used for authentication (digital signatures) as well as 
for privacy (encryption). 

Here's how it works for encryption: when Alice wishes to send a message to 
Bob, she looks up Bob's public key in a directory, uses it to encrypt the 
message and sends it off. Bob then uses his private key to decrypt the 
message and read it. No one listening in can decrypt the message. Anyone 
can send an encrypted message to Bob but only Bob can read it. Clearly, one 
requirement is that no one can figure out the private key from the 
corresponding public key.

Here's how it works for authentication: Alice, to sign a message, does
a computation involving both her private key and the message itself; the
output is called the digital signature and is attached to the message,
which is then sent. Bob, to verify the signature, does some computation 
involving the message, the purported signature, and Alice's public key. If 
the results properly hold in a simple mathematical relation, the signature 
is verified as genuine; otherwise, the signature may be fraudulent or the 
message altered, and they are discarded.

A good history of public-key cryptography, by one of its inventors, is 
given by Diffie \cite{diffie-10yrs}.

\question {q:ad}
{What are the advantages and disadvantages of public-key cryptography over
    secret-key cryptography?}
The primary advantage of public-key cryptography is increased security: 
the private keys do not ever need to be transmitted or revealed to anyone. 
In a secret-key system, by contrast, there is always a chance that an 
enemy could discover the secret key while it is being transmitted.

Another major advantage of public-key systems is that they can provide 
a method for digital signatures. Authentication via secret-key systems
requires the sharing of some secret and sometimes requires trust of a 
third party as well. A sender can then repudiate a previously signed message 
by claiming that the shared secret was somehow compromised by one of the
parties sharing the secret. For example, the Kerberos secret-key 
authentication system \cite{steiner-kerberos} involves a central database 
that keeps copies of the secret keys of all users; a Kerberos-authenticated 
message would most likely not be held legally binding, since an attack on 
the database would allow widespread forgery. Public-key authentication, on 
the other hand, prevents this type of repudiation; each user has sole 
responsibility for protecting his or her private key. This property of 
public-key authentication is often called non-repudiation. 

Furthermore, digitally signed messages can be proved authentic to a third 
party, such as a judge, thus allowing such messages to be legally binding. 
Secret-key authentication systems such as Kerberos were designed to 
authenticate access to network resources, rather than to authenticate 
documents, a task which is better achieved via digital signatures.

A disadvantage of using public-key cryptography for encryption is speed: 
there are popular secret-key encryption methods which are significantly 
faster than any currently available public-key encryption method. But 
public-key cryptography can share the burden with secret-key cryptography 
to get the best of both worlds. 

For encryption, the best solution is to combine public- and secret-key 
systems in order to get both the security advantages of public-key systems 
and the speed advantages of secret-key systems. The public-key system can 
be used to encrypt a secret key which is then used to encrypt the bulk 
of a file or message. This is explained in more detail in Question \ref 
{q:as} in the case of RSA. {\em Public-key cryptography is not meant to 
replace secret-key cryptography, but rather to supplement it, to make it 
more secure.} The first use of public-key techniques was for secure key 
exchange in an otherwise secret-key system \cite {diffie-hellman}; this 
is still one of its primary functions.

Secret-key cryptography remains extremely important and is the subject of
much ongoing study and research. Some secret-key encryption systems are 
discussed in Questions \ref{q:cd} and \ref{q:ch}.

\question {q:ae}
{Is cryptography patentable in the U.S.?}
Cryptographic systems are patentable. Many secret-key cryptosystems have
been patented, including DES (see Question \ref{q:cd}). The basic ideas 
of public-key cryptography are contained in U.S. Patent 4,200,770, by M.
Hellman, W. Diffie, and R. Merkle, issued 4/29/80 and in U.S. Patent 
4,218,582, by M. Hellman and R. Merkle, issued 8/19/80; similar patents have 
been issued throughout the world. The exclusive licensing rights to both 
patents are held by Public Key Partners (PKP), of Sunnyvale, California, 
which also holds the rights to the RSA patent (see Question \ref{q:be}). 
Usually all of these public-key patents are licensed together. 

All legal challenges to public-key patents have been settled before
judgment. In a recent case, for example, PKP brought suit against the TRW 
Corporation which was using public-key cryptography (the ElGamal system) 
without a license; TRW claimed it did not need to license. In June 1992 a 
settlement was reached in which TRW agreed to license to the patents.

Some patent applications for cryptosystems have been blocked by intervention 
by the NSA (see Question \ref{q:cx}) or other intelligence or defense 
agencies, under the authority of the Invention Secrecy Act of 1940 and the 
National Security Act of 1947; see Landau \cite{landau} for some recent 
cases related to cryptography.

\question {q:af}
{Is cryptography exportable from the U.S.?}
All cryptographic products need export licenses from the State Department, 
acting under authority of the International Traffic in Arms Regulation 
(ITAR), which defines cryptographic devices, including software, as 
munitions. The U.S. government has historically been reluctant to grant 
export licenses for encryption products stronger than some basic level 
(not publicly stated). 

Under current regulations, a vendor seeking to export a product using 
cryptography first submits an request to the State Department's Defense
Trade Control office. Export jurisdiction may then be passed to the
Department of Commerce, whose export procedures are generally simple and
efficient. If jurisdiction remains with the State Department, further
review, perhaps lengthy, is required before export is either approved or
denied; the National Security Agency (NSA, see Question \ref{q:cx}) may 
become directly involved at this point. The details of the export approval 
process change frequently.

The NSA has de facto control over export of cryptographic products. The State 
Department will not grant a license without NSA approval and routinely grants 
licenses whenever NSA does approve. Therefore, the policy decisions over 
exporting cryptography ultimately rest with the NSA.

It is the stated policy of the NSA not to restrict export of cryptography
for authentication; it is only concerned with the use of cryptography for 
privacy. A vendor seeking to export a product for authentication only will 
be granted an export license as long as it can demonstrate that the product 
cannot be easily modified for encryption; this is true even for very strong 
systems, such as RSA with large key sizes. Furthermore, the bureaucratic 
procedures are simpler for authentication products than for privacy products. 
An authentication product needs NSA and State Dept. approval only once, 
whereas an encryption product may need approval for every sale or every 
product revision.

Export policy is currently a matter of great controversy, as many software
and hardware vendors consider current export regulations overly restrictive 
and burdensome. The Software Publishers Association (SPA), a software 
industry group, has recently been negotiating with the government in order 
to get export license restrictions eased; one agreement was reached that 
allows simplified procedures for export of two bulk encryption ciphers, RC2 
and RC4 (see Question \ref{q:cm}), when the key size is limited. Also, export 
policy is less restrictive for foreign subsidiaries and overseas offices of 
U.S. companies.

In March 1992, the Computer Security and Privacy Advisory Board voted 
unanimously to recommend a national review of cryptography policy, 
including export policy. The Board is an official advisory board to NIST 
(see Question \ref{q:cu}) whose members are drawn from both the government 
and the private sector. The Board stated that a public debate is the only 
way to reach a consensus policy to best satisfy competing interests: 
national security and law enforcement agencies like restrictions on 
cryptography, especially for export, whereas other government agencies and 
private industry want greater freedom for using and exporting cryptography. 
Export policy has traditionally been decided solely by agencies concerned 
with national security, without much input from those who wish to encourage 
commerce in cryptography. U.S. export policy may undergo significant change 
in the next few years.

\section {RSA}
\question {q:ag}
{What is RSA?}
RSA is a public-key cryptosystem for both encryption and authentication;
it was invented in 1977 by Ron Rivest, Adi Shamir, and Leonard Adleman
\cite{rsa}. It works as follows: take two large primes, $p$ and $q$, and 
find their product $n = pq$; $n$ is called the modulus. Choose a number, 
$e$, less than $n$ and relatively prime to $(p-1)(q-1)$, and find its 
inverse, $d$, mod $(p-1)(q-1)$, which means that $ed \equiv 1 \bmod 
(p-1)(q-1)$; $e$ and $d$ are called the public and private exponents, 
respectively. The public key is the pair $(n,e)$; the private key is $d$. 
The factors $p$ and $q$ must be kept secret, or destroyed. 

It is difficult (presumably) to obtain the private key $d$ from the public 
key $(n,e)$. If one could factor $n$ into $p$ and $q$, however, then one 
could obtain the private key $d$. Thus the entire security of RSA is 
predicated on the assumption that factoring is difficult; an easy factoring 
method would ``break'' RSA (see Questions \ref{q:al} and \ref{q:bt}).

Here is how RSA can be used for privacy and authentication (in practice, 
actual use is slightly different; see Questions \ref{q:as} and \ref{q:at}):

RSA privacy (encryption): suppose Alice wants to send a private message, 
$m$, to Bob. Alice creates the ciphertext $c$ by exponentiating: $c = m^e$ 
mod $n$, where $e$ and $n$ are Bob's public key. To decrypt, Bob also 
exponentiates: $m = c^d$ mod $n$, and recovers the original message $m$;
the relationship between $e$ and $d$ ensures that Bob correctly recovers $m$.
Since only Bob knows $d$, only Bob can decrypt. 

RSA authentication: suppose Alice wants to send a signed document $m$ to Bob. 
Alice creates a digital signature $s$ by exponentiating: $s = m^d$ mod $n$, 
where $d$ and $n$ belong to Alice's key pair. She sends $s$ and $m$ to Bob. 
To verify the signature, Bob exponentiates and checks that the message $m$ 
is recovered: $m = s^e$ mod $n$, where $e$ and $n$ belong to Alice's public 
key.

Thus encryption and authentication take place without any sharing of 
private keys: each person uses only other people's public keys and his or 
her own private key. Anyone can send an encrypted message or verify a signed 
message, using only public keys, but only someone in possession of the correct 
private key can decrypt or sign a message. 

\question {q:ah}
{Why use RSA rather than DES?}
RSA is not an alternative or replacement for DES; rather it supplements
DES (or any other fast bulk encryption cipher) and is used together with DES 
in a secure communications environment. (Note: for an explanation of DES,
see Question \ref {q:cd}.)

RSA allows two important functions not provided by DES: secure key exchange 
without prior exchange of secrets, and digital signatures. For encrypting
messages, RSA and DES are usually combined as follows: first the message is 
encrypted with a random DES key, and then, before being sent over an insecure 
communications channel, the DES key is encrypted with RSA. Together, the 
DES-encrypted message and the RSA-encrypted DES key are sent. This protocol 
is known as an RSA digital envelope.

One may wonder, why not just use RSA to encrypt the whole message and not use 
DES at all? Although this may be fine for small messages, DES (or another 
cipher) is preferable for larger messages because it is much faster than RSA
(see Question \ref{q:ai}).

In some situations, RSA is not necessary and DES alone is sufficient. This 
includes multi-user environments where secure DES-key agreement can take 
place, for example by the two parties meeting in private. Also, RSA is 
usually not necessary in a single-user environment; for example, if you want 
to keep your personal files encrypted, just do so with DES using, say, your 
personal password as the DES key. RSA, and public-key cryptography in general,
is best suited for a multi-user environment. Also, any system in which digital
signatures are desired needs RSA or some other public-key system.

\question {q:ai}
{How fast is RSA?}
An ``RSA operation,'' whether for encrypting or decrypting, signing
or verifying, is essentially a modular exponentiation, which can be 
performed by a series of modular multiplications.

In practical applications, it is common to choose a small public 
exponent for the public key; in fact, entire groups of users can use 
the same public exponent. This makes encryption faster than decryption 
and verification faster than signing. Algorithmically, public-key 
operations take $O(k^2)$ steps, private key operations take $O(k^3)$ 
steps, and key generation takes $O(k^4)$ steps, where $k$ is the number of 
bits in the modulus; $O$-notation refers to the an upper bound on the 
asymptotic running time of an algorithm \cite{cormen-l-rivest}.

There are many commercially available hardware implementations of RSA, 
and there are frequent announcements of newer and faster chips. The 
fastest current RSA chip \cite{shand-fast-rsa} has a throughput greater 
than 600 Kbits per second with a 512-bit modulus, implying that it performs 
over 1000 RSA private-key operations per second. It is expected that RSA 
speeds will reach 1 Mbit/second within a year or so.

By comparison, DES is much faster than RSA. In software, DES is generally at 
least 100 times as fast as RSA. In hardware, DES is between 1,000 and 10,000
times as fast, depending on the implementations. RSA will probably 
narrow the gap a bit in coming years, as it finds growing commercial
markets, but will never match the performance of DES.

\question {q:aj}
{How much extra message length is caused by using RSA?}
Only a very small amount of data expansion is involved when using RSA. For 
encryption, a message may be padded to a length that is a multiple of the 
block length, usually 64 bits, since RSA is usually combined with 
a secret-key block cipher such as DES (see Question \ref{q:as}). Encrypting 
the DES key takes as many additional bits as the size of the RSA modulus.

For authentication, an RSA digital signature is appended to a document.
An RSA signature, including information such as the name of the signer, is 
typically a few hundred bytes long. One or more certificates (see Question 
\ref{q:bi}) may be included as well; certificates can be used in conjunction
with any digital signature method. A typical RSA certificate is a few 
hundred bytes long.

\question {q:al}
{What would it take to break RSA?}
There are a few possible interpretations of ``breaking RSA''. The most 
damaging would be for an attacker to discover the private key corresponding 
to a given public key; this would enable the attacker both to read all 
messages encrypted with the public key and to forge signatures. The obvious 
way to do this attack is to factor the public modulus, $n$, into its two prime
factors, $p$ and $q$. From $p$, $q$, and $e$, the public exponent, the 
attacker can easily get $d$, the private key. The hard part is factoring $n$; 
the security of RSA depends of factoring being difficult. In fact, the task 
of recovering the private key is equivalent to the task of factoring the 
modulus: you can use $d$ to factor $n$, as well as use the factorization of 
$n$ to find $d$. See Questions \ref{q:bu} and \ref{q:bv} regarding the state 
of the art in factoring. It should be noted that hardware improvements alone 
will not weaken RSA, as long as appropriate key lengths are used; in fact, 
hardware improvements should increase the security of RSA (see Question 
\ref{q:bu}).

Another way to break RSA is to find a technique to compute $e$-th roots mod 
$n$. Since $c = m^e$, the $e$-th root of $c$ is the message $m$. This attack 
would allow someone to recover encrypted messages and forge signatures even
without knowing the private key. This attack is not known to be equivalent to 
factoring. No methods are currently known that attempt to break RSA in this 
way. 

The attacks just mentioned are the only ways to break RSA in such a 
way as to be able to recover all messages encrypted under a given key. 
There are other methods, however, which aim to recover single messages;
success would not enable the attacker to recover other messages 
encrypted with the same key. 

The simplest single-message attack is the guessed plaintext attack. An 
attacker sees a ciphertext, guesses that the message might be ``Attack at 
dawn'', and encrypts this guess with the public key of the recipient; by 
comparison with the actual ciphertext, the attacker knows whether or not 
the guess was correct. This attack can be thwarted by appending some random 
bits to the message. Another single-message attack can occur if someone 
sends the same message $m$ to three others, who each have public exponent 
$e=3$. An attacker who knows this and sees the three messages will be able 
to recover the message $m$; this attack and ways to prevent it are discussed 
by Hastad \cite{hastad}. There are also some ``chosen ciphertext'' attacks, in 
which the attacker creates some ciphertext and gets to see the corresponding 
plaintext, perhaps by tricking a legitimate user into decrypting a fake 
message; Davida \cite{davida} gives some examples.

Of course, there are also attacks that aim not at RSA itself but at
a given insecure implementation of RSA; these do not count as ``breaking
RSA'' because it is not any weakness in the RSA algorithm that is exploited,
but rather a weakness in a specific implementation. For example, if someone 
stores his private key insecurely, an attacker may discover it. One cannot 
emphasize strongly enough that to be truly secure RSA requires a secure 
implementation; mathematical security measures, such as choosing a long key 
size, are not enough. In practice, most successful attacks will likely be 
aimed at insecure implementations and at the key management stages of an RSA 
system. See Section \ref{s:a} for discussion of secure key management in an 
RSA system.

\question {q:an}
{Are strong primes necessary in RSA?}
In the literature pertaining to RSA, it has often been suggested that in 
choosing a key pair, one should use ``strong'' primes $p$ and $q$ to
generate the modulus $n$. Strong primes are those with certain properties 
that make the product $n$ hard to factor by specific factoring methods; 
such properties have included, for example, the existence of a large 
prime factor of $p-1$ and a large prime factor of $p+1$. The reason for 
these concerns is that some factoring methods are especially suited to 
primes $p$ such that $p-1$ or $p+1$ has only small factors; strong primes
are resistant to these attacks. 

However, recent advances in factoring (see Question \ref {q:bv}) appear to 
have obviated the advantage of strong primes; the elliptic curve factoring 
algorithm is one such advance. The new factoring methods have as good a 
chance of success on strong primes as on ``weak'' primes; therefore, choosing 
strong primes does not significantly increase resistance to attacks. So for 
now the answer is negative: strong primes are not necessary when using RSA, 
although there is no danger in using them, except that it takes longer to 
generate a key pair. However, new factoring algorithms may be developed in 
the future which once again target primes with certain properties; if so, 
choosing strong primes may again help to increase security. 

\question {q:ao}
{How large a modulus (key) should be used in RSA?}
The best size for an RSA modulus depends on one's security needs. The larger 
the modulus, the greater the security but also the slower the RSA operations. 
One should choose a modulus length upon consideration, first, of one's 
security needs, such as the value of the protected data and how long it needs 
to be protected, and, second, of how powerful one's potential enemy is. 
It is also possible that a larger key size will allow a digitally signed
document to be valid for a longer time; see Question \ref{q:zf}.

A good analysis of the security obtained by a given modulus length is given 
by Rivest \cite{rivest-dss-response}, in the context of discrete logarithms 
modulo a prime, but it applies to RSA as well. Rivest's estimates imply that 
a 512-bit modulus can be factored with an \$8.2 million effort, less in 
the future. It may therefore be advisable to use a longer modulus, perhaps 
768 bits in length. Those with extremely valuable data (or large potential 
damage from digital forgery) may want to use a still longer modulus. A 
certifying authority (see Question \ref{q:bi}) might use a modulus of length 
1000 bits or more, because the validity of so many other key pairs depends 
on the security of the one central key. 

The key of an individual user will expire after a certain time, say, two 
years (see Question \ref{q:bk}). Upon expiration, the user will generate a 
new key which should be at least a few digits longer than the old key to 
reflect the speed increases of computers over the two years. Recommended key 
length schedules will probably be published by some authority or public body. 

Users should keep in mind that the estimated times to break RSA are averages 
only. A large factoring effort, attacking many thousands of RSA moduli, may 
succeed in factoring at least one in a reasonable time. Although the security 
of any individual key is still strong, with some factoring methods there is 
always a small chance that the attacker may get lucky and factor it quickly.

As for the slowdown caused by increasing the key size (see Question 
\ref{q:ai}), doubling the modulus length would, on average, increase the 
time required for public-key operations (encryption and signature 
verification) by a factor of 4, and increase the time taken by private 
key operations (decryption and signing) by a factor of 8. The reason that
public-key operations are affected less than private-key operations is that
the public exponent can remain fixed when the modulus is increased, whereas
the private exponent increases proportionally. Key generation time would 
increase by a factor of 16 upon doubling the modulus, but this is a 
relatively infrequent operation for most users.

\question {q:ap}
{How large should the primes be?}
The two primes, $p$ and $q$, which compose the modulus, should be of
roughly equal length; this will make the modulus harder to factor than
if one of the primes was very small. Thus if one chooses to use a 512-bit 
modulus, the primes should each have length approximately 256 bits.

\question {q:aq}
{How does one find random numbers for keys?}
One needs a source of random numbers in order to find two random primes
to compose the modulus. If one used a predictable method of generating
the primes, an adversary could mount an attack by trying to recreate the
key generation process. 

Random numbers obtained from a physical process are in principle the best.
One could use a hardware device, such as a diode; some are sold commercially 
on computer add-in boards for this purpose. Another idea is to use physical 
movements of the computer user, such as keystroke timings measured in
microseconds. By whichever method, the random numbers may still contain
some correlations preventing sufficient statistical randomness. Therefore,
it is best to run them through a good hash function (see Question \ref{q:cj}) 
before actually using them. 

Another approach is to use a pseudorandom number generator fed by a random
seed. Since these are deterministic algorithms, it is important to find
one that is very unpredictable and also to use a truly random seed. There is
a wide literature on the subject of pseudorandom number generators. See
Knuth \cite {knuth} for an introduction.

Note that one does not need random numbers to determine the public and
private exponents in RSA, after choosing the modulus. One can simply
choose an arbitrary value for the public exponent, which then determines
the private exponent, or vice versa.

\question {q:ar}
{What if users of RSA run out of distinct primes?}
There are enough prime numbers that RSA users will never run out of them.
For example, the number of primes of length 512 bits or less exceeds
$10^{150}$, according to the prime number theorem; this is more than the 
number of atoms in the known universe.

\question {q:za}
{How do you know if a number is prime?}
It is generally recommended to use probabilistic primality testing, which
is much quicker than actually proving a number prime. One can use a 
probabilistic test that decides if a number is prime with probability of 
error less than $2^{-100}$. For further discussion of some primality testing 
algorithms, see the papers in the bibliography of \cite{beauchemin}. 
For some empirical results on the reliability of simple primality tests see 
Rivest \cite {rivest-prob-prime}; one can perform very fast primality tests 
and be extremely confident in the results. A simple algorithm for choosing 
probable primes was recently analyzed by Brandt and Damg{\aa}rd \cite{brandt}.

\question {q:as}
{How is RSA used for encryption in practice?}
RSA is combined with a secret-key cryptosystem, such as DES, to encrypt
a message by means of an RSA digital envelope. 

Suppose Alice wishes to send an encrypted message to Bob. She first 
encrypts the message with DES, using a randomly chosen DES key. Then 
she looks up Bob's public key and uses it to encrypt the DES key. The 
DES-encrypted message and the RSA-encrypted DES key together form the RSA 
digital envelope and are sent to Bob. Upon receiving the digital envelope, 
Bob decrypts the DES key with his private key, then uses the DES key 
to decrypt to message itself.

\question {q:at}
{How is RSA used for authentication in practice?}
Suppose Alice wishes to send a signed message to Bob. She uses a hash
function on the message (see Question \ref {q:cj}) to create a message
digest, which serves as a ``digital fingerprint'' of the message. She then 
encrypts the message digest with her RSA private key; this is the digital 
signature, which she sends to Bob along with the message itself. Bob, 
upon receiving the message and signature, decrypts the signature with
Alice's public key to recover the message digest. He then hashes the 
message with the same hash function Alice used and compares the result
to the message digest decrypted from the signature. If they are exactly
equal, the signature has been successfully verified and he can be confident
that the message did indeed come from Alice. If, however, they are not 
equal, then the message either originated elsewhere or was altered after
it was signed, and he rejects the message. Note that for authentication, 
the roles of the public and private keys are converse to their roles in 
encryption, where the public key is used to encrypt and the private key 
to decrypt.

In practice, the public exponent is usually much smaller than the 
private exponent; this means that the verification of a signature is faster 
than the signing. This is desirable because a message or document will 
only be signed by an individual once, but the signature may be verified 
many times.

It must be infeasible for anyone to either find a message that hashes to 
a given value or to find two messages that hash to the same value. If either 
were feasible, an intruder could attach a false message onto Alice's 
signature. Hash functions such as MD4 and MD5 (see Question \ref{q:ck}) 
have been designed specifically to have the property that finding a match 
is infeasible, and are therefore considered suitable for use in cryptography.

One or more certificates (see Question \ref{q:bi}) may accompany a digital 
signature. A certificate is a signed document attesting to the identity and 
public key of the person signing the message. Its purpose is to prevent
someone from impersonating someone else, using a phony key pair. If a 
certificate is present, the recipient (or a third party) can check the 
authenticity of the public key, assuming the certifier's public key is
itself trusted. 

\question {q:au}
{Does RSA help detect altered documents and transmission errors?}
An RSA digital signature is superior to a handwritten signature in that
it attests to the contents of a message as well as to the identity of
the signer. As long as a secure hash function (see Question \ref{q:cj}) 
is used, there is no way to take someone's signature from one document and 
attach it to another, or to alter the signed message in any way. The slightest 
change in a signed document will cause the digital signature verification
process to fail. Thus, RSA authentication allows people to check the
integrity of signed documents. Of course, if a signature verification
fails, it may be unclear whether there was an attempted forgery or 
simply a transmission error.

\question {q:ax}
{What are alternatives to RSA?}
Many other public-key cryptosystems have been proposed, as a look through
the proceedings of the annual Crypto and Eurocrypt conferences quickly 
reveals. A mathematical problem called the knapsack problem was the basis 
for several systems \cite{merkle-hellman}, but these have lost favor because 
several versions were broken. Another system, designed by ElGamal 
\cite{elgamal}, is based on the discrete logarithm problem. The ElGamal
system was, in part, the basis for several later signature methods, including 
one by Schnorr \cite{schnorr}, which in turn was the basis for DSS, the 
digital signature standard proposed by NIST (see Question \ref{q:cq}). 
Because of the NIST proposal, the relative merits of these signature systems 
versus RSA signatures has received a lot of attention; see 
\cite{nist-dss-discuss} for a discussion. The ElGamal system has been used 
successfully in applications; it is slower for encryption and verification 
than RSA and its signatures are larger than RSA signatures.

In 1976, before RSA, Diffie and Hellman \cite {diffie-hellman} proposed a 
system for key exchange only; it permits secure exchange of keys in an 
otherwise conventional secret-key system. This system is in use today.

Cryptosystems based on mathematical operations on elliptic curves have also 
been proposed \cite{koblitz-ecc,miller-elliptic}, as have cryptosystems based 
on discrete exponentiation in the finite field GF($2^n$). The latter are very 
fast in hardware; however, doubts have been raised about their security 
because the underlying problem may be easier to solve than factoring \cite
{odlyzko-dlogs,gordon-mccurley}. There are also some probabilistic encryption 
methods \cite{blum-g,goldwasser}, which have the attraction of being resistant
to a guessed ciphertext attack (see Question \ref{q:al}), but at a cost of 
data expansion. In probabilistic encryption, the same plaintext encrypted 
twice under the same key will give, with high probability, two different 
ciphertexts.

For digital signatures, Rabin \cite{rabin} proposed a system which is 
provably equivalent to factoring; this is an advantage over RSA, where one 
may still have a lingering worry about an attack unrelated to factoring.
Rabin's method is susceptible to a chosen message attack, however, in which 
the attacker tricks the user into signing messages of a special form. Another 
signature scheme, by Fiat and Shamir \cite {fiat}, is based on interactive 
zero-knowledge protocols, but can be adapted for signatures. It is faster 
than RSA and is provably equivalent to factoring, but the signatures are 
much larger than RSA signatures. Other variations, however, lessen the 
necessary signature length; see \cite {burmester} for references. A
system is ``equivalent to factoring'' if recovering the private key is
provably as hard as factoring; forgery may be easier than factoring in some 
of the systems.

Advantages of RSA over other public-key cryptosystems include the fact that 
it can be used for both encryption and authentication, and that it has been 
around for many years and has successfully withstood much scrutiny. RSA has 
received far more attention, study, and actual use than any other public-key 
cryptosystem, and thus RSA has more empirical evidence of its security than 
more recent and less scrutinized systems. In fact, a large number of 
public-key cryptosystems which at first appeared secure were later broken; 
see \cite {brickell-cryptanalysis} for some case histories. 

\question {q:ba}
{Is RSA currently in use today?}
The use of RSA is undergoing a period of rapid expansion and may become 
ubiquitous within a few years. It is currently used in a wide variety of 
products, platforms and industries around the world. It is found in many 
commercial software products and planned for many more. RSA is built into 
current or planned operating systems by Microsoft, Apple, Sun, and Novell. 
In hardware, RSA can be found in secure telephones, on Ethernet network 
cards, and on smart cards. RSA is also used internally in many institutions, 
including branches of the U.S. government, major corporations, national 
laboratories, and universities.

Adoption of RSA seems to be proceeding more quickly for authentication 
(digital signatures) than for privacy (encryption), perhaps in part because 
products for authentication are easier to export than those for privacy (see 
Question \ref{q:af}). 

\question {q:bc}
{Is RSA an official standard today?}
RSA is part of many official standards worldwide. The ISO (International
Standards Organization) 9796 standard lists RSA as a compatible 
cryptographic algorithm, as does the Consultative Committee in International 
Telegraphy and Telephony (CCITT) X.509 security standard. RSA is part of 
the Society for Worldwide Interbank Financial Telecommunications (SWIFT) 
standard, the French financial industry's ETEBAC 5 standard, and the ANSI 
X9.31 draft standard for the U.S. banking industry. The Australian key 
management standard, AS2805.6.5.3, also specifies RSA.

RSA is found in Internet's proposed PEM (Privacy Enhanced Mail) standard
(see Question \ref{q:co}) and the PKCS standard for the software industry 
(see Question \ref{q:cp}). The OSI Implementors' Workshop (OIW) has issued 
implementers' agreements referring to PKCS and PEM, which each include RSA. 

A number of other standards are currently being developed and will 
be announced over the next couple of years; many are expected to include 
RSA as either an endorsed or a recommended system for privacy and/or 
authentication. See \cite{kaliski-standards} for a more comprehensive 
survey of cryptography standards.

\question {q:bd}
{Is RSA a de facto standard? Why is a de facto standard important?}
RSA is the most widely used public-key cryptosystem today and has often
been called a de facto standard. Regardless of the official standards, the 
existence of a de facto standard is extremely important for the development 
of a digital economy. If one public-key system is used everywhere for 
authentication, then signed digital documents can be exchanged between users 
in different nations using different software on different platforms; this
interoperability is necessary for a true digital economy to develop.

The lack of secure authentication has been a major obstacle in achieving
the promise that computers would replace paper; paper is still necessary
almost everywhere for contracts, checks, official letters, legal documents,
and identification. With this core of necessary paper transaction, it has not 
been feasible to evolve completely into a society based on electronic 
transactions. Digital signatures are the exact tool necessary to convert 
the most essential paper-based documents to digital electronic media. 
Digital signatures makes it possible, for example, to have leases, wills, 
passports, college transcripts, checks, and voter registration forms that 
exist only in electronic form; any paper version would just be a ``copy'' 
of the electronic original. All of this is enabled by an accepted standard 
for digital signatures.

\question {q:be}
{Is RSA patented? }
RSA is patented under U.S. Patent 4,405,829, issued 9/20/83 and held by
Public Key Partners (PKP), of Sunnyvale, California; the patent expires 17 
years after issue, in 2000. RSA is usually licensed together with other 
public-key cryptography patents (see Question \ref{q:ae}). PKP has a 
standard, royalty-based licensing policy which can be modified for special 
circumstances. If a software vendor, having licensed the public-key patents, 
incorporates RSA into a commercial product, then anyone who purchases the 
end product has the legal right to use RSA within the context of that 
software. The U.S. government can use RSA without a license because it was 
invented at MIT with partial government funding. RSA is not patented outside 
North America.

In North America, a license is needed to ``make, use or sell'' RSA. However,
PKP usually allows free non-commercial use of RSA, with written permission, 
for personal, academic or intellectual reasons. Furthermore, RSA 
Laboratories has made available (in the U.S. and Canada) at no charge a 
collection of cryptographic routines in source code, including the RSA 
algorithm; it can be used, improved and redistributed non-commercially 
(see Question \ref{q:zm}).

\question {q:bf}
{Can RSA be exported from the U.S.?}
Export of RSA falls under the same U.S. laws as all other cryptographic
products. See Question \ref{q:af} for details.

RSA used for authentication is more easily exported than when used for
privacy. In the former case, export is allowed regardless of key (modulus)
size, although the exporter must demonstrate that the product cannot be
easily converted to use for encryption. In the case of RSA used for 
privacy (encryption), the U.S. government generally does not allow
export if the key size exceeds 512 bits. Export policy is currently a
subject of debate, and the export status of RSA may well change in the
next year or two.

Regardless of U.S. export policy, RSA is available abroad in non-U.S.
products.

\section {Key Management} \label{s:a}
\question {q:bg}
{What key management issues are involved in public-key cryptography?}
Secure methods of key management are extremely important. In practice,
most attacks on public-key systems will probably be aimed at the key 
management levels, rather than at the cryptographic algorithm itself. 
The key management issues mentioned here are discussed in detail in 
later questions.

Users must be able to obtain securely a key pair suited to their efficiency 
and security needs. There must be a way to look up other people's public 
keys and to publicize one's own key. Users must have confidence in the 
legitimacy of others' public keys; otherwise an intruder can either change 
public keys listed in a directory, or impersonate another user. Certificates 
are used for this purpose. Certificates must be unforgeable, obtainable in a 
secure manner, and processed in such a way that an intruder cannot misuse 
them. The issuance of certificates must proceed in a secure way, impervious to 
attack. If someone's private key is lost or compromised, others must be made 
aware of this, so that they will no longer encrypt messages under the 
invalid public key nor accept messages signed with the invalid private key. 
Users must be able to store their private keys securely, so that no intruder 
can find it, yet the keys must be readily accessible for legitimate use. Keys 
need to be valid only until a specified expiration date. The expiration date 
must be chosen properly and publicized securely. Some documents need to have 
verifiable signatures beyond the time when the key used to sign them has 
expired.

Although most of these key management issues arise in any public-key 
cryptosystem, for convenience they are discussed here in the context of RSA.

\question {q:zn}
{Who needs a key?}
Anyone who wishes to sign messages or to receive encrypted messages must
have a key pair. People may have more than one key. For example, someone
might have a key affiliated with his or her work and a separate key for
personal use. Other entities will also have keys, including electronic 
entities such as modems, workstations, and printers, as well as 
organizational entities such as a corporate department, a hotel 
registration desk, or a university registrar's office. 

\question {q:bh}
{How does one get a key pair? }
Each user should generate his or her own key pair. It may be tempting within 
an organization to have a single site that generates keys for all members who 
request one, but this is a security risk because it involves the transmission 
of private keys over a network as well as catastrophic consequences if an 
attacker infiltrates the key-generation site. Each node on a network should be
capable of local key generation, so that private keys are never transmitted 
and no external key source need be trusted. Of course, the local key generation
software must itself be trustworthy. Secret-key authentication systems, such 
as Kerberos, often do not allow local key generation but instead use a 
central server to generate keys.

Once generated, a user must register his or her public key with some
central administration, called a certifying authority. The certifying 
authority returns to the user a certificate attesting to the veracity of 
the user's public key along with other information (see Questions \ref{q:bi} 
and following). Most users should not obtain more than one certificate for
the same key, in order to simplify various bookkeeping tasks associated
with the key.

\question {q:bq}
{Should a public key or private key be shared among users?}
In RSA, each person should have a unique modulus and private exponent, i.e., 
a unique private key. The public exponent, on the other hand, can be common 
to a group of users without security being compromised. Some public exponents 
in common use today are 3 and $2^{16}+1$; because these numbers are small, 
the public-key operations (encryption and signature verification) are fast 
relative to the private key operations (decryption and signing). If one 
public exponent becomes a standard, software and hardware can be optimized 
for that value.

In public-key systems based on discrete logarithms, such as ElGamal,
Diffie-Hellman, or DSS, it has often been suggested that a group of 
people should share a modulus. This would make breaking a key more
attractive to an attacker, however, because one could break every
key with only slightly more effort than it would take to break a
single key. To an attacker, therefore, the average cost to break a 
key is much lower with a common modulus than if every key has a distinct 
modulus. Thus one should be very cautious about using a common modulus; 
if a common modulus is chosen, it should be very large. 

\question {q:bi}
{What are certificates?}
Certificates are digital documents attesting to the binding of a public key 
to an individual or other entity. They allow verification of the claim that 
a given public key does in fact belong to a given individual. Certificates 
help prevent someone from using a phony key to impersonate someone else.

In their simplest form, certificates contain a public key and a name. As
commonly used, they also contain the expiration date of the key, the name 
of the certifying authority that issued the certificate, the serial number 
of the certificate, and perhaps other information. Most importantly, it 
contains the digital signature of the certificate issuer. The most widely 
accepted format for certificates is defined by the CCITT X.509 international 
standard \cite{ccitt-X.509}; thus certificates can be read or written by any 
application complying with X.509. Further refinements are found in the PKCS 
set of standards (see Question \ref{q:cp}), and the PEM standard (see 
Question \ref{q:co}). A detailed discussion of certificate format can also 
be found in Kent \cite{kent-rfc1422}.

A certificate is issued by a certifying authority (see Question \ref{q:zd}) 
and signed with the certifying authority's private key.

\question {q:zc}
{How are certificates used?}
A certificate is displayed in order to generate confidence in the 
legitimacy of a public key. Someone verifying a signature can also 
verify the signer's certificate, to insure that no forgery or false 
representation has occurred. These steps can be performed with greater or 
lesser rigor depending on the context. 

The most secure use of authentication involves enclosing one or more 
certificates with every signed message. The receiver of the message
would verify the certificate using the certifying authority's public
key and, now confident of the public key of the sender, verify the message's 
signature. There may be two or more certificates enclosed with the message, 
forming a hierarchical chain, wherein one certificate testifies to the 
authenticity of the previous certificate. At the end of a certificate 
hierarchy is a top-level certifying authority, which is trusted without a 
certificate from any other certifying authority. The public key of the 
top-level certifying authority must be independently known, for example by 
being widely published.

The more familiar the sender is to the receiver of the message, the less 
need there is to enclose, and to verify, certificates. If Alice sends 
messages to Bob every day, Alice can enclose a certificate chain on the 
first day, which Bob verifies. Bob thereafter stores Alice's public key 
and no more certificates or certificate verifications are necessary. A sender 
whose company is known to the receiver may need to enclose only one 
certificate (issued by the company), whereas a sender whose company is 
unknown to the receiver may need to enclose two certificates. A good rule of 
thumb is to enclose just enough of a certificate chain so that the issuer of 
the highest level certificate in the chain is well-known to the receiver.

According to the PKCS standards for public-key cryptography (see Question
\ref{q:cp}), every signature points to a certificate that validates
the public key of the signer. Specifically, each signature contains the name 
of the issuer of the certificate and the serial number of the certificate. 
Thus even if no certificates are enclosed with a message, a verifier can 
still use the certificate chain to check the status of the public key.
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
