basvandorst/cryptography-archive/rsa99_hotels/rsa99_hotels.pdf

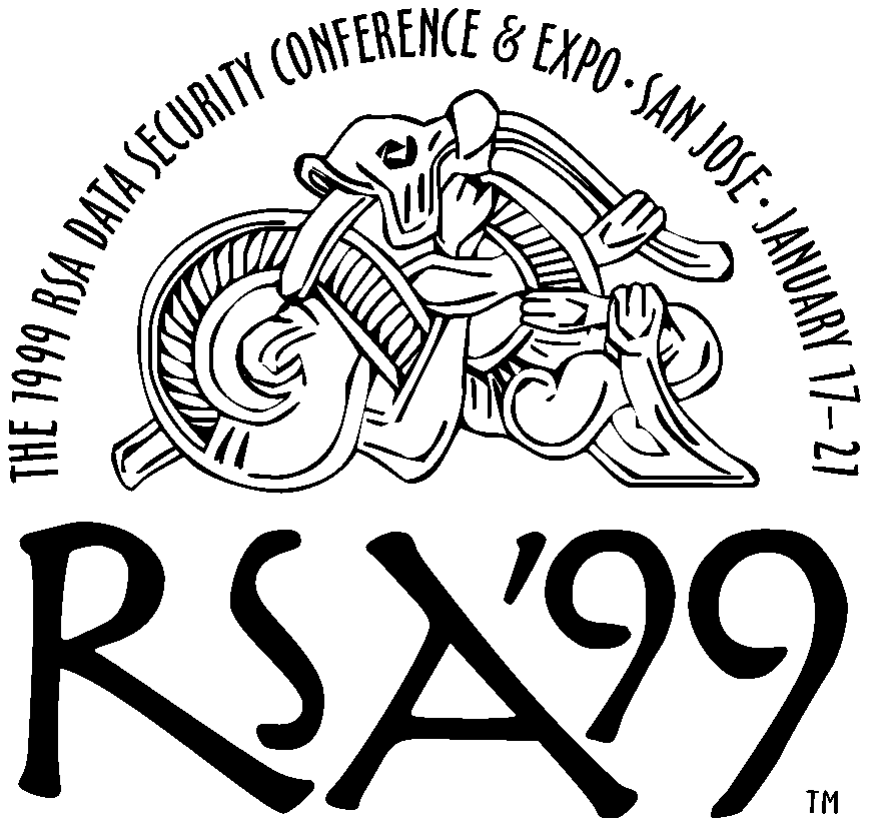
[picture p54: figure]

Return this form to: RSA Data Security Conference/Housing Bureau, P.O. Box 6299, San Jose, CA 95150-9828 or FAX 408/293-3705 Housing Info Line Only: 408/295-2265 Ext.425 or email <rsadata@sanjose.org>.

ACCOMMODATIONS: Guest room reservations at the RSA Data Security Conference official hotels are handled on a first come, first served basis. Request for rooms should be faxed or mailed to the San Jose Housing Bureau. Failure to receive your first choice does not constitute an error. The bureau will accept only written reservations. Please provide your FAX number for a faxed acknowledgment. No telephone reservations will be accepted through the Housing Bureau. If accommodations are not available at the hotel of your choice, comparable reservations will be made at other participating hotels.

GUARANTEED RESERVATIONS ONLY: All reservations must be guaranteed at the time of your request to the housing bureau. *Reservations will not be processed without a form of guarantee. You may do so by using a major credit card or sending in an advance deposit with your housing form. Your credit card is only a form of guarantee.

DEADLINES: The housing bureau requests a response no later than 12/16/98.

CHANGES & CANCELLATIONS: To cancel or make changes to reservations, contact the housing bureau in writing only, up until the cut-off date of 12/16/98. All cancellations must be received by the assigned hotel at least 72 hours prior to arrival to avoid a cancellation fee. After the cut-off date changes can be made directly with the hotel.

# HOTEL RESERVATION FORM - RSA DATA SECURITY CONFERENCE

JANUARY 17-21, 1999 - SAN JOSE, CALIFORNIA

PLEASE TYPE OR PRINT CLEARLY

For your convenience, hotel reservations for the 1999 RSA Data Security Conference can be made through the San Jose Housing Bureau by filling out this form. Use one (1) form for each room request. Photocopy additional forms if necessary.

Occupant Name

Sharing with

SEND CONFIRMATION TO:

Name

Station/Organization

Address

City | State/Province
Zip + 4 | Country
Telephone | Fax
Arrival Date | Departure Date

RESERVATIONS WILL NOT BE PROCESSED W/O CREDIT CARD NUMBER.

Type of Card

Account# | Expires

Signature

❏ Check (check must accompany form in the amount of $125.00 per room payable to SJCVB). No purchase orders will be accepted.

HOTEL PREFERENCE

Number of People

First Choice

Second Choice

Third Choice

Type of accommodation: (check one)
❏ | Single (1 bed, 1 person)
❏ | Double (1 bed, 2 people)
❏ | Twin/Twin (2 beds, 2 people – Fairmont only)
❏ | Double/Double (2 beds, 2-4 people)
❏ | Smoking | ❏ | Non Smoking
❏ | Require special facilities in accordance with the
Americans With Disabilities Act.

Note: These rates are subject to a 10% occupancy tax.
* Within walking distance of the San Jose Convention Center. ** Five minute ride by Light Rail to the San Jose
Convention Center.

CONVENTION HOTELS

HOTEL | 1 PERS. | 2 PPL. | 3 PPL. | 4 PPL.
San Jose Hilton* | $ 175 | $ 190 | $ 206 | $ 220
San Jose Fairmont* | $ 167 | $ 167 | N/A | N/A
Crowne Plaza* | $ 149 | $ 149 | $ 159 | $ 159
Hyatt St. Claire* | $ 165 | $ 185 | $ 205 | $ 225
Hotel De Anza* | $ 160 | $ 160 | $ 160 | $ 160
Best Western* | $ 77 | $ 77 | $ 88 | $ 88
Hyatt San Jose Airport** | $ 179 | $ 179 | $ 199 | $ 219
Wyndham** | $ 169 | $ 169 | $ 189 | $ 209

## SAN JOSE HOTELS

### San Jose Hilton*

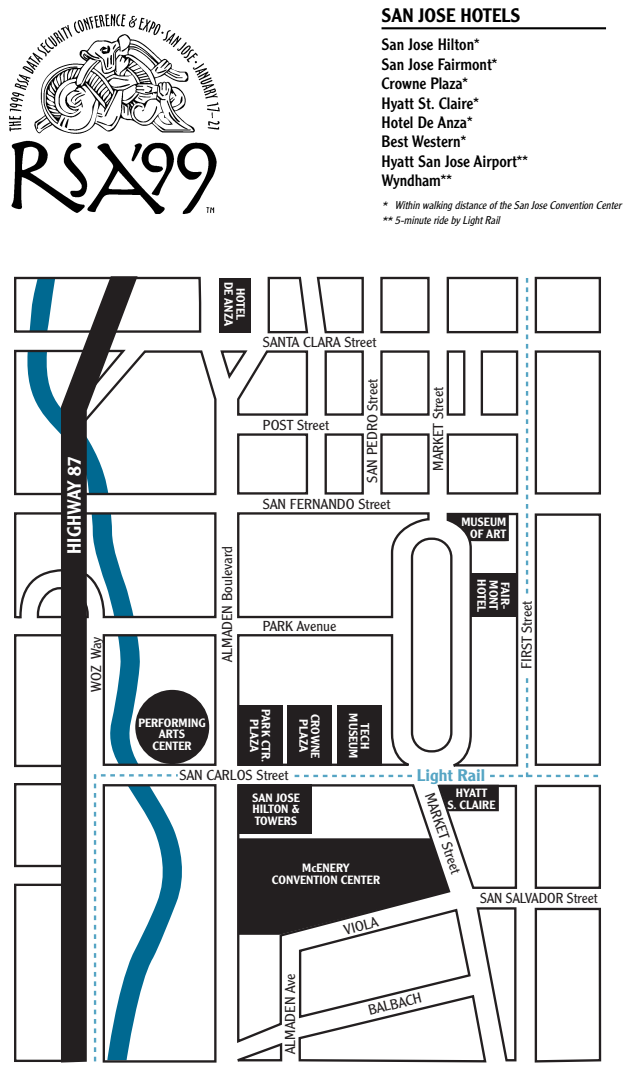
[picture p55: page 2]
HIGHWAY 87; WOZ Way; ALMADEN Boulevard; POST Street; PARK Avenue; VIOLA; FIRST Street; Light Rail; HYATT; McENERY CONVENTION CENTER; PERFORMING ARTS CENTER; PARK CTR.; PLAZA; CROWNE; TECH; MUSEUM; HOTEL; DE ANZA; BALBACH; ALMADEN Ave

San Jose Fairmont*
Crowne Plaza*
Hyatt St. Claire*
Hotel De Anza*
Best Western*
Hyatt San Jose Airport**
Wyndham**

* Within walking distance of the San Jose Convention Center
** ⁵⁻minute ride by Light Rail

SANTA CLARA Street

SAN PEDRO Street

MARKET Street

SAN FERNANDO Street

MUSEUM
OF ART HOTEL MONT FAIR-

SAN CARLOS Street

S. CLAIRE SAN JOSE
HILTON &
TOWERS

SAN SALVADOR Street
