basvandorst/cryptography-archive/hotel_faxform_A4/hotel_faxform_A4.pdf

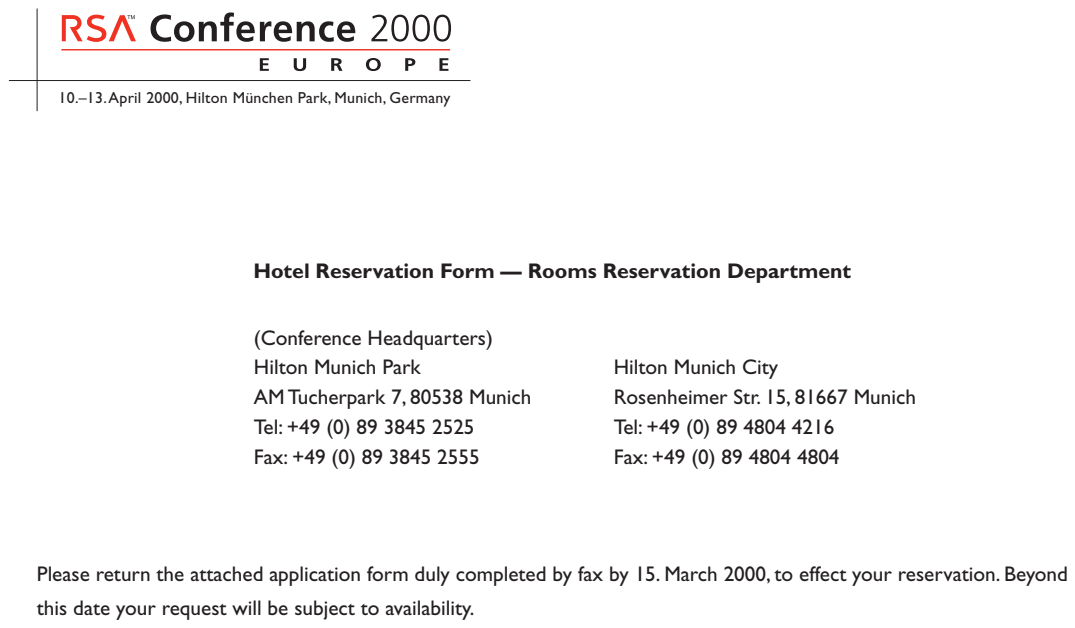
[picture p56: page 1]

10.–13.April 2000, Hilton München Park, Munich, Germany

Hotel Reservation Form — Rooms Reservation Department

(Conference Headquarters)
Hilton Munich Park
AM Tucherpark 7, 80538 Munich
Tel: +49 (0) 89 3845 2525
Fax: +49 (0) 89 3845 2555

Hilton Munich City
Rosenheimer Str. 15, 81667 Munich
Tel: +49 (0) 89 4804 4216
Fax: +49 (0) 89 4804 4804

Please return the attached application form duly completed by fax by 15. March 2000, to effect your reservation. Beyond
this date your request will be subject to availability.

Company:

Last Name:

First Name:

Arrival:

Departure:

Number of Guests:

Number of Rooms:

Credit Card:

Expiry:

Telephone:

Fax:

Hilton München Park,Am Tucherpark 7, D – 80538 München,Tel: +49 (89) 3845 0, Fax: +49 (89) 3845 2588, www.hilton.com

10.–13.April 2000, Hilton München Park, Munich, Germany

Signature | Date

The rates are per room, per night, including 16% VAT and breakfast. Check In time is after 3 pm, checkout before 12 am. The above rates are applicable from Friday 7th April 2000 until Saturday 15th April 2000.

In the event of no show or cancellation a one night charge will be applied unless a cancellation is received by 4 pm on

the day of arrival. Please note that no show charges and cancellations fees will be directly billed to your credit card.

Hotel Reservation Form for RSA Conference 2000, Europe at Hilton Hotels Munich

DM 394,00

Choose one of the listed hotels and categories:

Standard Category

Business Class:

Executive Floor:

Park | City
Park | City
Park | City
Hilton Munich Park | Hilton Munich City

Double Room

Single Room

Double Room

Single Room

Double Room

Single Room

DM 496,00

DM 444,00

DM 546,00

DM 494,00

DM 636,00

201,45

253,60

238,77

298,08

264,34

323,65

227,01

279,17

252,58

325,18

DM 467,00

DM 583,00

DM 517,00

DM 633,00

n/a

n/a

n/a

n/a
