basvandorst/cryptography-archive/apache_ssl_0/ApacheSSL/telnet/telnet/main.c

/*
 * Copyright (c) 1988, 1990 Regents of the University of California.
 * All rights reserved.
 *
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
 * THIS SOFTWARE IS PROVIDED BY THE REGENTS AND CONTRIBUTORS ``AS IS'' AND
 * ANY EXPRESS OR IMPLIED WARRANTIES, INCLUDING, BUT NOT LIMITED TO, THE
 * IMPLIED WARRANTIES OF MERCHANTABILITY AND FITNESS FOR A PARTICULAR PURPOSE
 * ARE DISCLAIMED.  IN NO EVENT SHALL THE REGENTS OR CONTRIBUTORS BE LIABLE
 * FOR ANY DIRECT, INDIRECT, INCIDENTAL, SPECIAL, EXEMPLARY, OR CONSEQUENTIAL
 * DAMAGES (INCLUDING, BUT NOT LIMITED TO, PROCUREMENT OF SUBSTITUTE GOODS
 * OR SERVICES; LOSS OF USE, DATA, OR PROFITS; OR BUSINESS INTERRUPTION)
 * HOWEVER CAUSED AND ON ANY THEORY OF LIABILITY, WHETHER IN CONTRACT, STRICT
 * LIABILITY, OR TORT (INCLUDING NEGLIGENCE OR OTHERWISE) ARISING IN ANY WAY
 * OUT OF THE USE OF THIS SOFTWARE, EVEN IF ADVISED OF THE POSSIBILITY OF
 * SUCH DAMAGE.
 */

#ifndef lint
char copyright[] =
"@(#) Copyright (c) 1988, 1990 Regents of the University of California.\n\
 All rights reserved.\n";
#endif /* not lint */

#ifndef lint
static char sccsid[] = "@(#)main.c	5.4 (Berkeley) 3/22/91";
#endif /* not lint */


#include <sys/types.h>

#include "ring.h"
#include "externs.h"
#include "defines.h"

#ifdef USE_SOCKS
int socks_flag=0;
#endif /* USE_SOCKS */

/*
 * Initialize variables.
 */
    void
tninit()
{
    init_terminal();

    init_network();
    
    init_telnet();

    init_sys();

#if defined(TN3270)
    init_3270();
#endif
}

	void
usage()
{
	fprintf(stderr, "Usage: %s %s%s%s%s%s\n",
	    prompt,
#ifdef	AUTHENTICATE
	    " [-8] [-E] [-K] [-L] [-X atype] [-a] [-d] [-e char] [-k realm]",
	    "\n\t[-l user] [-n tracefile] ",
#else
	    " [-8] [-E] [-L] [-a] [-d] [-e char] [-l user] [-n tracefile]",
	    "\n\t",
#endif
#if defined(TN3270) && defined(unix)
# ifdef AUTHENTICATE
	    "[-noasynch] [-noasynctty] [-noasyncnet]\n\t[-r] [-t transcom] ",
# else
	    "[-noasynch] [-noasynctty] [-noasyncnet] [-r] [-t transcom]\n\t",
# endif
#else
	    "[-r] ",
#endif
#ifdef USE_SSL
        /* might as well output something useful here ... */
	"\n\t[-z ssl] [-z secure] [-z debug] [-z verify=int]\n\t[-z cert=file] [-z key=file]\n\t",
#else /* !USE_SSL */
        "",
#endif /* USE_SSL */
#ifdef	ENCRYPT
	    "[-x] [host-name [port]]"
#else
	    "[host-name [port]]"
#endif
	);
	exit(1);
}

/*
 * main.  Parse arguments, invoke the protocol or command parser.
 */

main(argc, argv)
	int argc;
	char *argv[];
{
	extern char *optarg;
	extern int optind;
	int ch;
	char *user, *strrchr();

	tninit();		/* Clear out things */
#if	defined(CRAY) && !defined(__STDC__)
	_setlist_init();	/* Work around compiler bug */
#endif

	TerminalSaveState();

	if (prompt = strrchr(argv[0], '/'))
		++prompt;
	else
		prompt = argv[0];

	user = NULL;

	rlogin = (strncmp(prompt, "rlog", 4) == 0) ? '~' : _POSIX_VDISABLE;
	autologin = -1;

	while ((ch = getopt(argc, argv, "8EKLS:X:ade:k:l:n:rt:xz:")) != EOF) {
		switch(ch) {

                /* SSL and SOCKS "share" the same flag and we
		 * can compile with either of them so we have
		 * a little bit of fun here in terms of defines 
		 * --tjh
		 */
#ifdef USE_SSL
                case 'z':
		        if (strcmp(optarg, "debug") == 0 ) {
			    ssl_debug_flag=1;
			}
		        if (strcmp(optarg, "ssl") == 0 ) {
			    ssl_only_flag=1;
			}
		        if (strcmp(optarg, "secure") == 0 ) {
			    ssl_secure_flag=1;
			}
		        if (strncmp(optarg, "verify=", strlen("verify=")) == 0 ) {
			    ssl_verify_flag=atoi(optarg+strlen("verify="));
			}
		        if (strncmp(optarg, "cert=", sizeof("cert")) == 0 ) {
			    cert_file= optarg + sizeof("cert");
			}
		        if (strncmp(optarg, "key=", sizeof("key")) == 0 ) {
			    key_file= optarg + sizeof("key");
			}
		        if (strncmp(optarg,"cipher=",sizeof("cipher"))==0) {
			    cipher_list=optarg+sizeof("cipher");
			}
#ifdef USE_SOCKS
		        if (strcmp(optarg, "socks") == 0 ) {
			    socks_flag=1;
			}
#endif /* USE_SOCKS */
			break;
#endif /* USE_SSL */

#ifdef USE_SOCKS
#ifndef USE_SSL
                case 'z':
		        if (strcmp(optarg, "socks") == 0 ) {
			    socks_flag=1;
			}
			break;
#endif /* !USE_SSL */
#endif /* USE_SOCKS */


		case '8':
			eight = 3;	/* binary output and input */
			break;
		case 'E':
			rlogin = escape = _POSIX_VDISABLE;
			break;
		case 'K':
#ifdef	AUTHENTICATE
			autologin = 0;
#endif
			break;
		case 'L':
			eight |= 2;	/* binary output only */
			break;
		case 'S':
		    {
#ifdef	HAS_GETTOS
			extern int tos;

			if ((tos = parsetos(optarg, "tcp")) < 0)
				fprintf(stderr, "%s%s%s%s\n",
					prompt, ": Bad TOS argument '",
					optarg,
					"; will try to use default TOS");
#else
			fprintf(stderr,
			   "%s: Warning: -S ignored, no parsetos() support.\n",
								prompt);
#endif
		    }
			break;
		case 'X':
#ifdef	AUTHENTICATE
			auth_disable_name(optarg);
#endif
			break;
		case 'a':
			autologin = 1;
			break;
		case 'c':
			skiprc = 1;
			break;
		case 'd':
			debug = 1;
			break;
		case 'e':
			set_escape_char(optarg);
			break;
		case 'k':
#if defined(AUTHENTICATE) && defined(KRB4)
		    {
			extern char *dest_realm, dst_realm_buf[], dst_realm_sz;
			dest_realm = dst_realm_buf;
			(void)strncpy(dest_realm, optarg, dst_realm_sz);
		    }
#else
			fprintf(stderr,
			   "%s: Warning: -k ignored, no Kerberos V4 support.\n",
								prompt);
#endif
			break;
		case 'l':
			autologin = 1;
			user = optarg;
			break;
		case 'n':
#if defined(TN3270) && defined(unix)
			/* distinguish between "-n oasynch" and "-noasynch" */
			if (argv[optind - 1][0] == '-' && argv[optind - 1][1]
			    == 'n' && argv[optind - 1][2] == 'o') {
				if (!strcmp(optarg, "oasynch")) {
					noasynchtty = 1;
					noasynchnet = 1;
				} else if (!strcmp(optarg, "oasynchtty"))
					noasynchtty = 1;
				else if (!strcmp(optarg, "oasynchnet"))
					noasynchnet = 1;
			} else
#endif	/* defined(TN3270) && defined(unix) */
				SetNetTrace(optarg);
			break;
		case 'r':
			rlogin = '~';
			break;
		case 't':
#if defined(TN3270) && defined(unix)
			transcom = tline;
			(void)strcpy(transcom, optarg);
#else
			fprintf(stderr,
			   "%s: Warning: -t ignored, no TN3270 support.\n",
								prompt);
#endif
			break;
		case 'x':
#ifdef	ENCRYPT
			encrypt_auto(0);
			decrypt_auto(0);
#else
			fprintf(stderr,
			    "%s: Warning: -x ignored, no ENCRYPT support.\n",
								prompt);
#endif
			break;
		case '?':
		default:
			usage();
			/* NOTREACHED */
		}
	}
	if (autologin == -1)
		autologin = (rlogin == _POSIX_VDISABLE) ? 0 : 1;


#ifdef USE_SOCKS
        if (socks_flag)
	    SOCKSinit(argv[0]);
#endif /* USE_SOCKS */

	argc -= optind;
	argv += optind;

	if (argc) {
		char *args[7], **argp = args;

		if (argc > 2)
			usage();
		autologin = 1;
		*argp++ = prompt;
		if (user) {
			*argp++ = "-l";
			*argp++ = user;
		}
		*argp++ = argv[0];		/* host */
		if (argc > 1)
			*argp++ = argv[1];	/* port */
		*argp = 0;

		if (setjmp(toplevel) != 0)
			Exit(0);
		if (tn(argp - args, args) == 1)
			return (0);
		else
			return (1);
	}
	(void)setjmp(toplevel);

	for (;;) {
#ifdef TN3270
		if (shell_active)
			shell_continue();
		else
#endif
			command(1, 0, 0);
	}
}
